cbiele/CyBot/reference/video/frames/20220108-CycloidaldriveAssembly/052.jpg

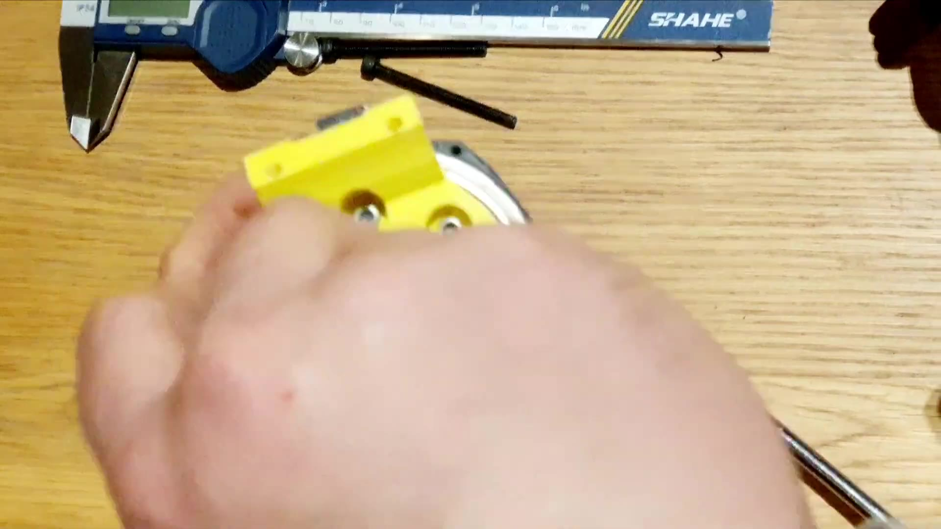
reference/video/frames/20220108-CycloidaldriveAssembly/052.jpg
