cbiele/CyBot/reference/video/frames/20220108-CycloidaldriveAssembly/010.jpg

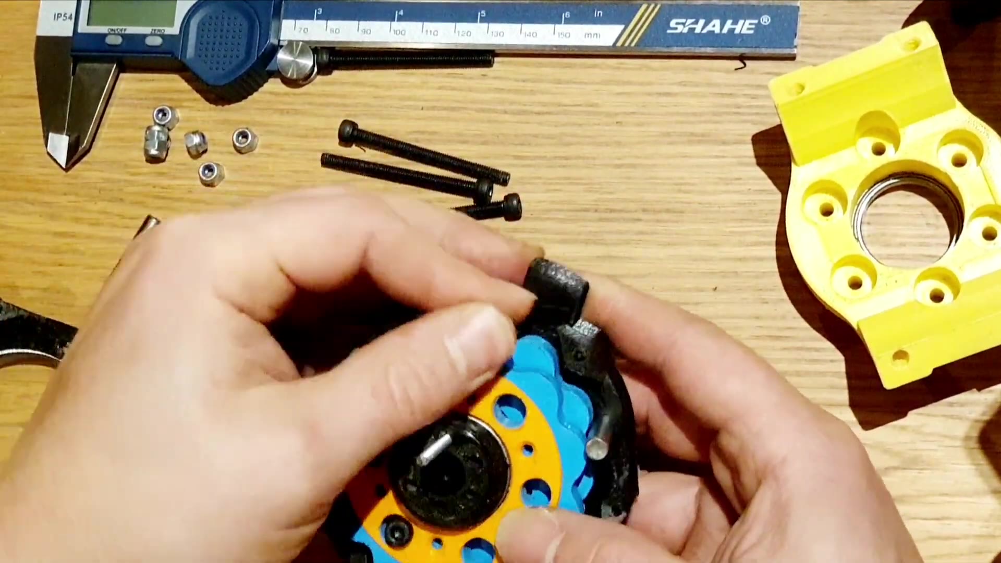
reference/video/frames/20220108-CycloidaldriveAssembly/010.jpg
