cbiele/CyBot/reference/hackaday/README.md

# reference/hackaday — files from hackaday.io/project/182821 (pulled 2026-09-09)

Author's project page (created 2021-11-29, last updated 2023). No build logs
and no component list; one comment from the author (2023-04-01) confirms
**he never homed the arm** and was considering an MPU-6050 instead of
switches. The files are the only section drawings of the arm anywhere:

| File | What it is |
|---|---|
| AssemblySectionAnalysis.JPG | full-arm Fusion section: base turntable with the two 6816 stacked, both body joints with their three-disk stacks and 6813 rings, the elbow 1:11 gearbox and forearm tube, the wrist |
| Axis5-6-SectionAnalysis.JPG | wrist section: the axis-5 1:11 gearbox on the −y arm, the two 6810 on the +y arm, axis-6 roll rotor/pulley/spacer inside the forearm tube with its bearings, the quarter-turn belt idler |
| CycloidalReducer1-12-SectionAnalysis.JPG | 1:11 gearbox render: disks with the bushing bearings, ring pins, NEMA17 on top, the M3 rod nuts |
| CycloidalReducer1-20.JPG | 1:20 gearbox render: 21 ring pins through the housing, disks, OPH/pulley end with the 6 output rods |
| CycloidalDisk1-12-dimension.JPG | Fusion sketch of the 1:11 disk: Ø78 pin circle, Ø66 lobe root, Ø32 bore, Ø16 pin-bearing circle, 12 pins at 15°, pin Ø4/Ø5 |
| 20220109_203344.jpg, 20231105_194952.jpg | photos: the assembled 1:11 unit; the finished arm with gripper and joystick (2023) |
