cbiele/CyBot/reference/hackaday/20231105_194952.jpg

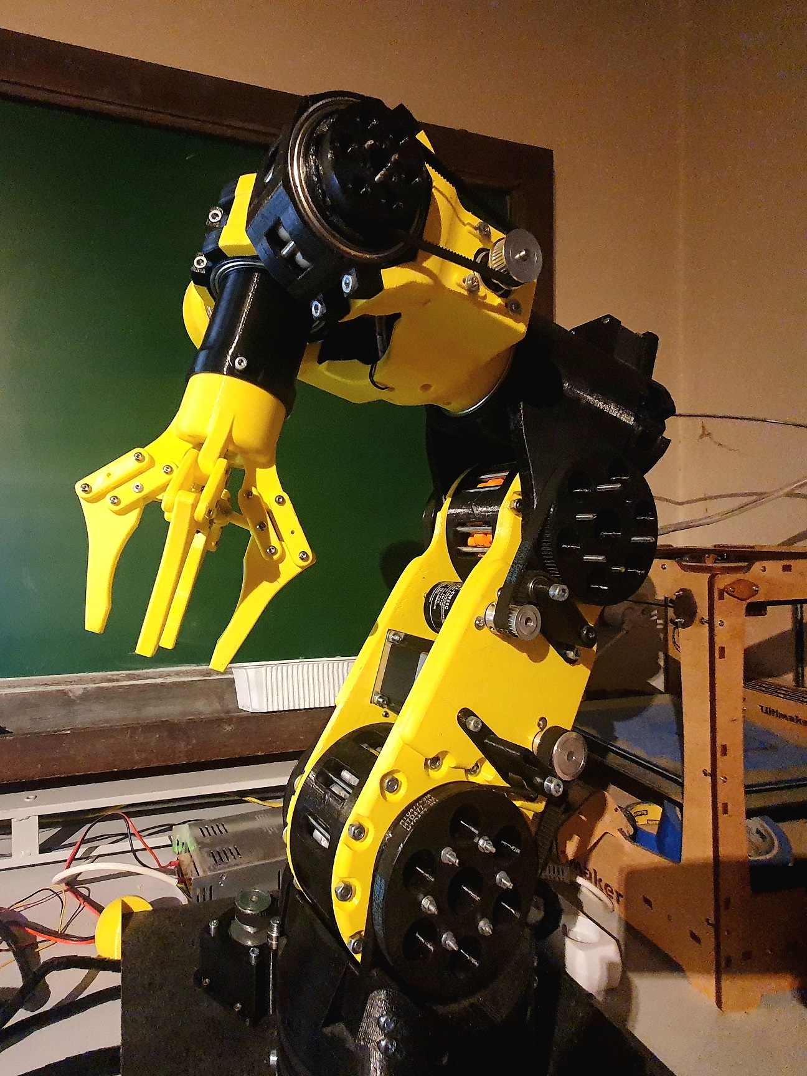
reference/hackaday/20231105_194952.jpg
