cbiele/CyBot/reference/hackaday/CycloidalReducer1-12-SectionAnalysis.JPG

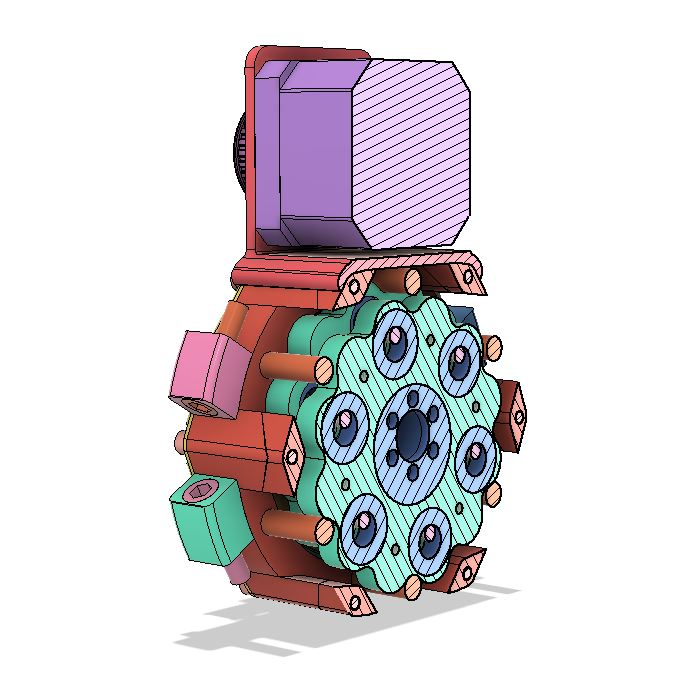
reference/hackaday/CycloidalReducer1-12-SectionAnalysis.JPG
