cbiele/CyBot/reference/pdf-figures/p5-shaft-train.png

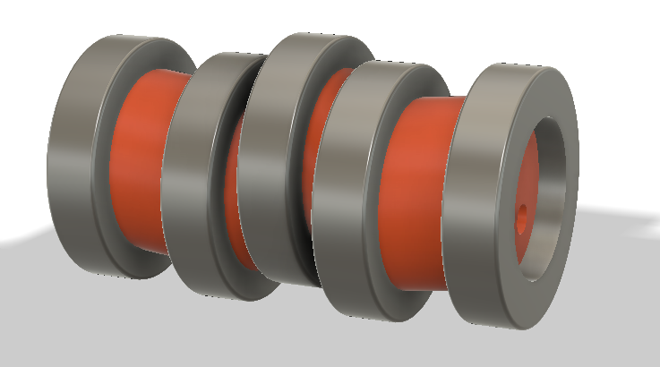
reference/pdf-figures/p5-shaft-train.png
