cbiele/CyBot/reference/pdf-figures/p12-pulley-bearing-hub.png

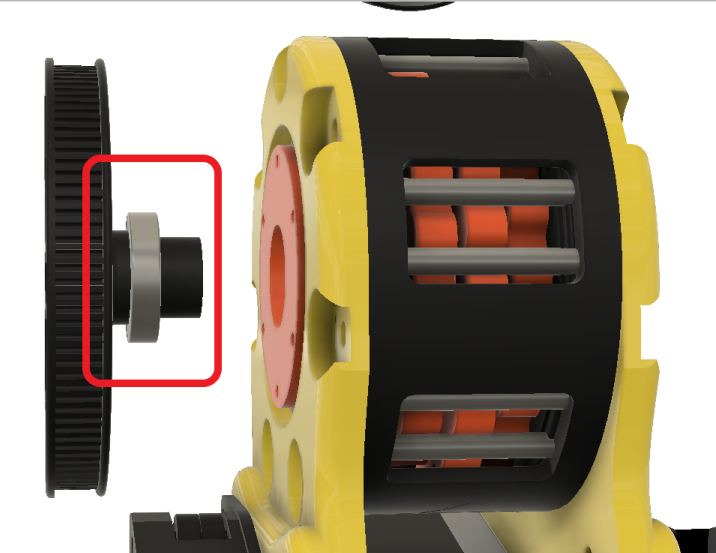
reference/pdf-figures/p12-pulley-bearing-hub.png
