cbiele/CyBot/reference/video/frames/20211029-Workingona3diskscycloida/002.jpg

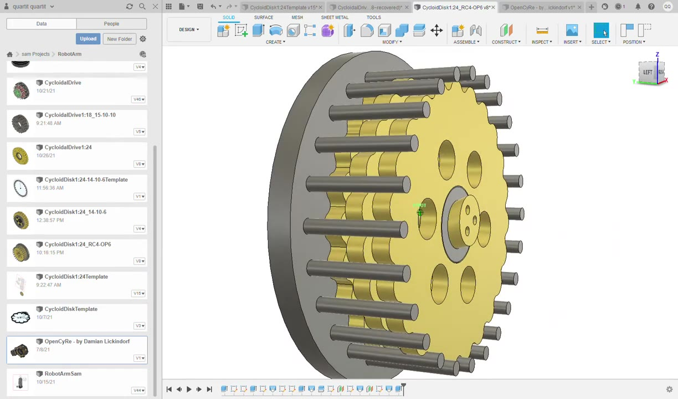
reference/video/frames/20211029-Workingona3diskscycloida/002.jpg
