cbiele/CyBot/reference/video/frames/20211029-Workingona3diskscycloida/007.jpg

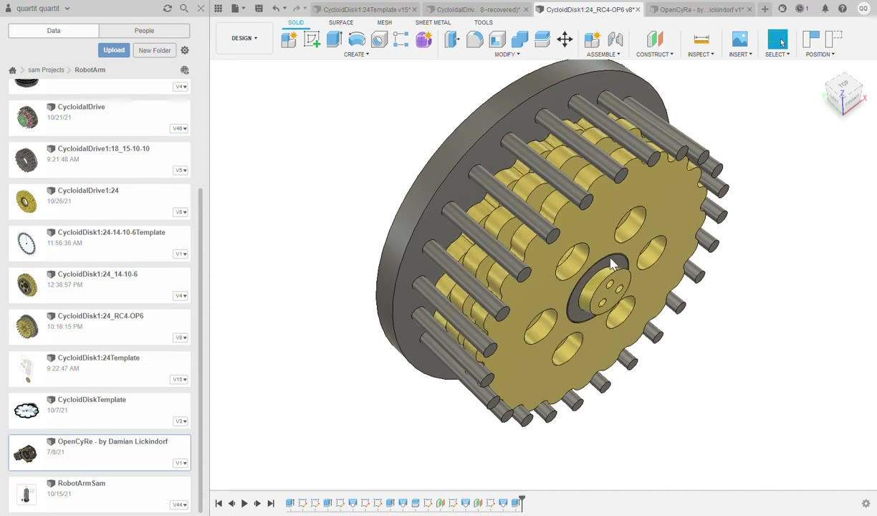
reference/video/frames/20211029-Workingona3diskscycloida/007.jpg
