cbiele/CyBot/reference/video/frames/20211108-CyBoT124fusion360Cycloid/012.jpg

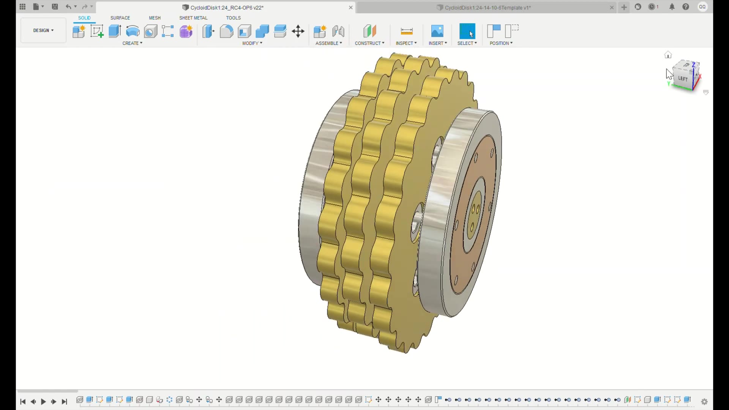
reference/video/frames/20211108-CyBoT124fusion360Cycloid/012.jpg
