cbiele/CyBot/reference/video/frames/20211114-CyBoT3dprinted124Cycloid-sheet.jpg

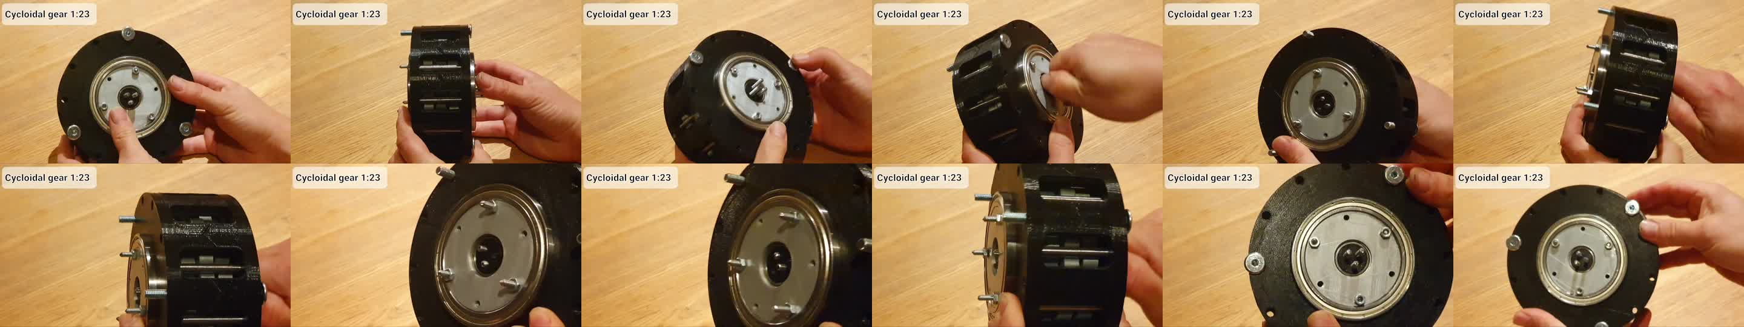
reference/video/frames/20211114-CyBoT3dprinted124Cycloid-sheet.jpg
