cbiele/CyBot/reference/video/frames/20211114-CyBoT3dprinted124Cycloid/003.jpg

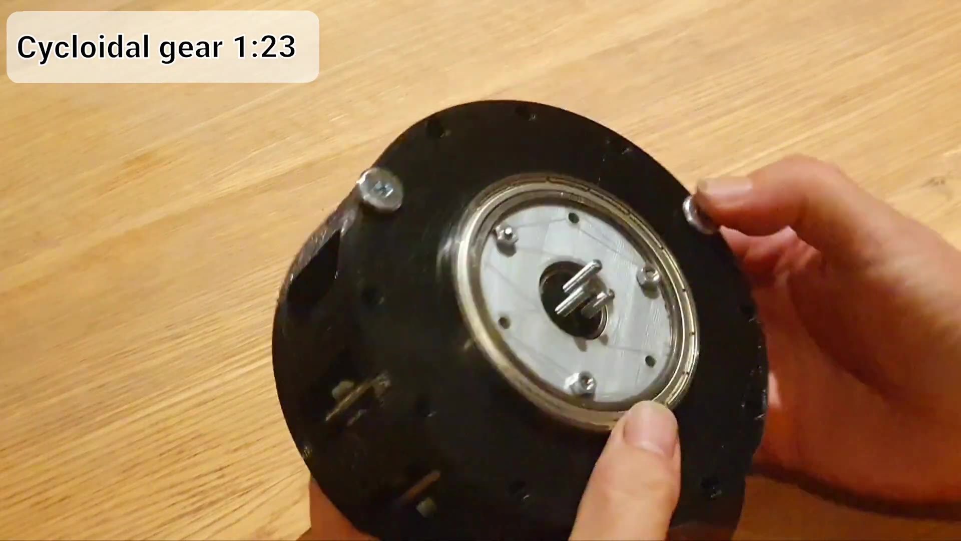
reference/video/frames/20211114-CyBoT3dprinted124Cycloid/003.jpg
