cbiele/CyBot/reference/video/frames/20211114-CyBoT3dprinted124Cycloid/007.jpg

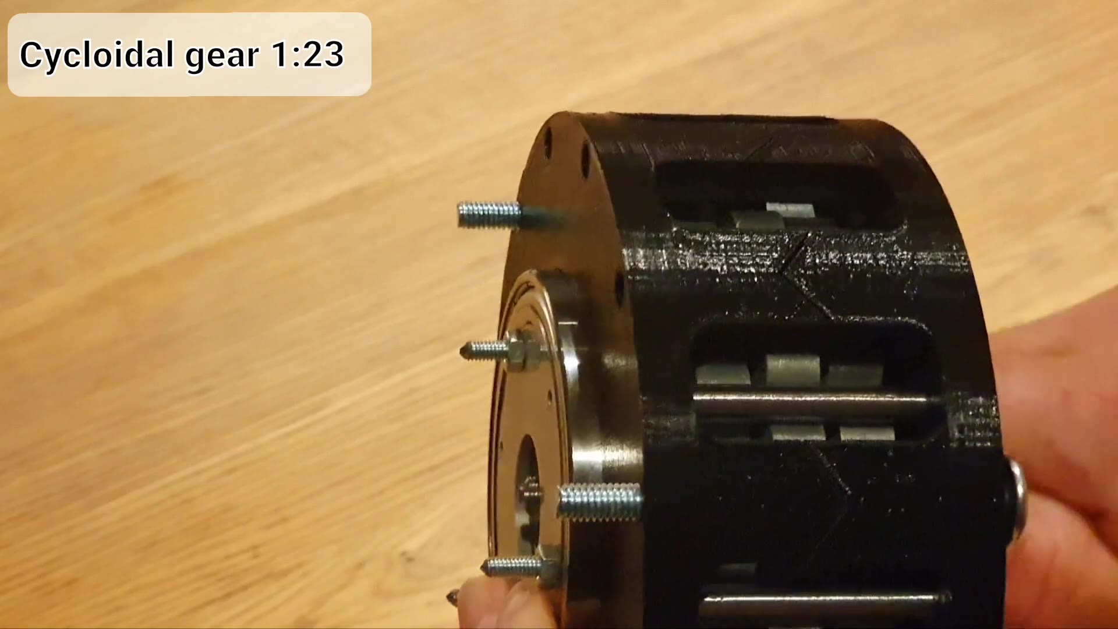
reference/video/frames/20211114-CyBoT3dprinted124Cycloid/007.jpg
