cbiele/CyBot/reference/video/frames/20211114-CyBoT3dprinted124Cycloid/010.jpg

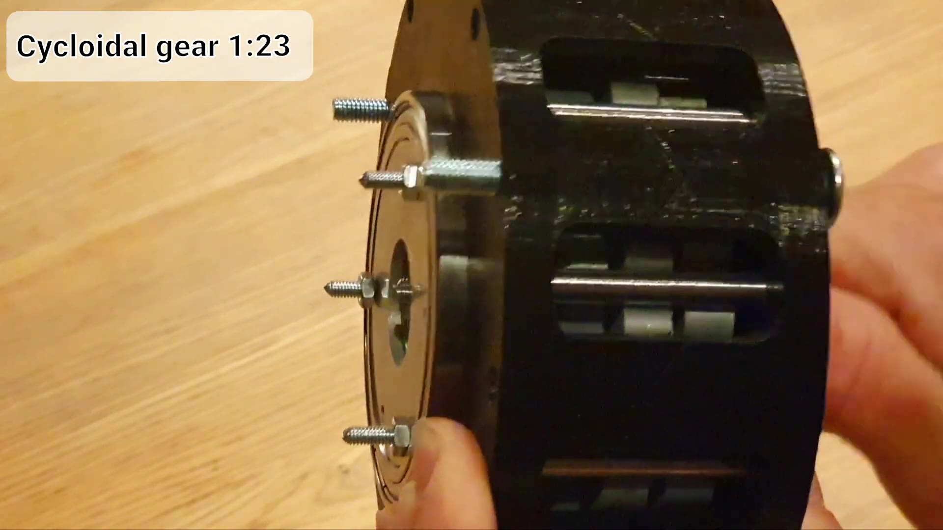
reference/video/frames/20211114-CyBoT3dprinted124Cycloid/010.jpg
