cbiele/CyBot/reference/video/frames/20211121-CyBoT6DOFRobotArmCycloid-sheet.jpg

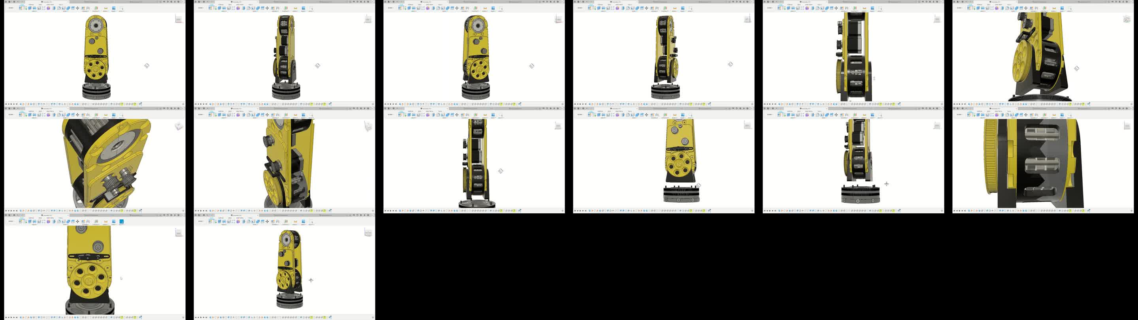
reference/video/frames/20211121-CyBoT6DOFRobotArmCycloid-sheet.jpg
