cbiele/CyBot/reference/video/frames/20211121-CyBoT6DOFRobotArmCycloid/007.jpg

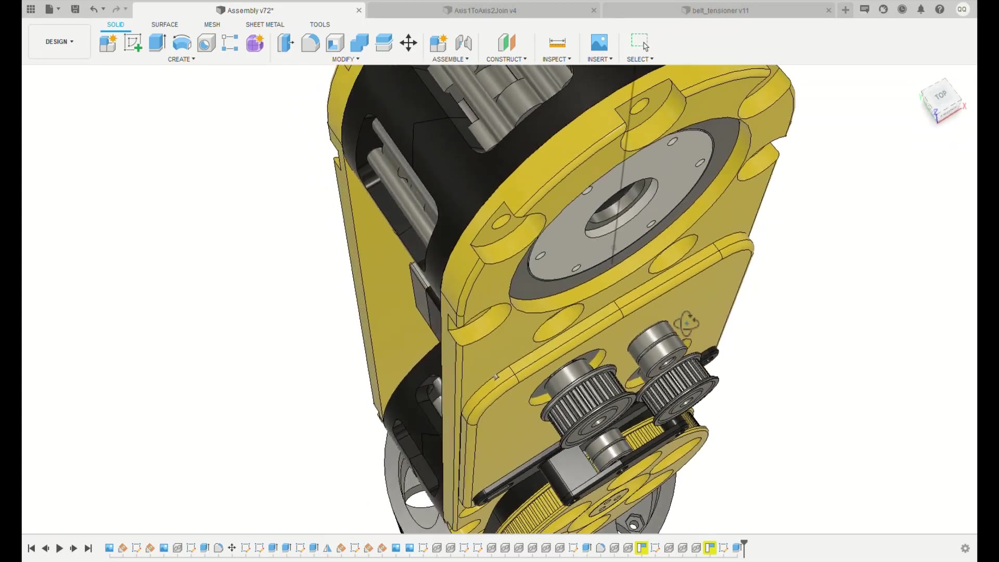
reference/video/frames/20211121-CyBoT6DOFRobotArmCycloid/007.jpg
