cbiele/CyBot/reference/video/frames/20211121-CyBoT6DOFRobotArmCycloid/012.jpg

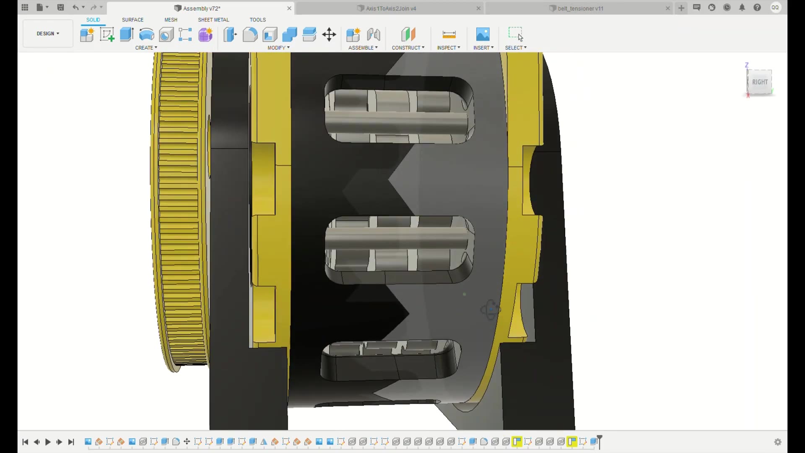
reference/video/frames/20211121-CyBoT6DOFRobotArmCycloid/012.jpg
