cbiele/CyBot/reference/video/frames/20211126-CyBoT6DOFRobotArmCycloid-sheet.jpg

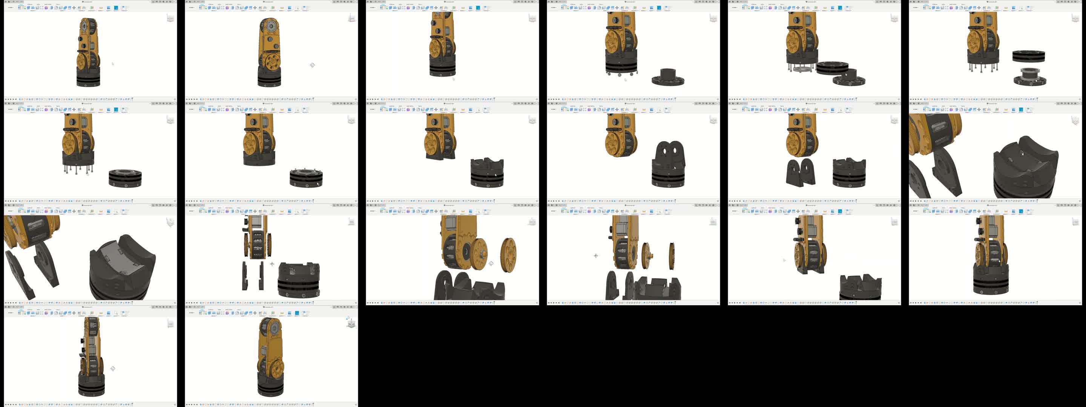
reference/video/frames/20211126-CyBoT6DOFRobotArmCycloid-sheet.jpg
