cbiele/CyBot/reference/video/frames/20211126-CyBoT6DOFRobotArmCycloid/003.jpg

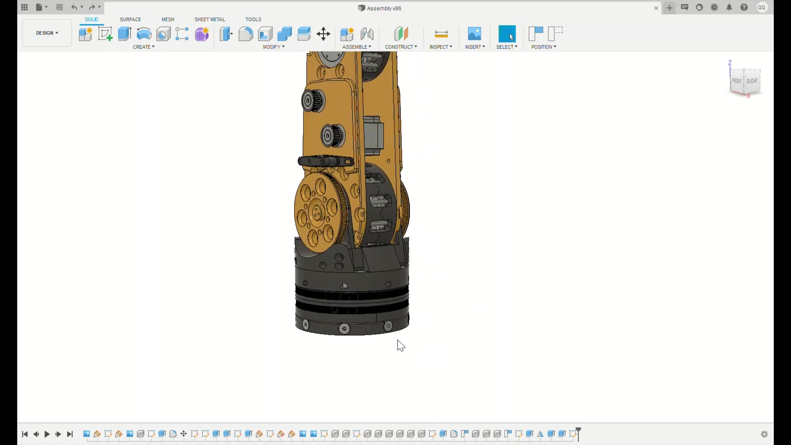
reference/video/frames/20211126-CyBoT6DOFRobotArmCycloid/003.jpg
