cbiele/CyBot/reference/video/frames/20211126-CyBoT6DOFRobotArmCycloid/013.jpg

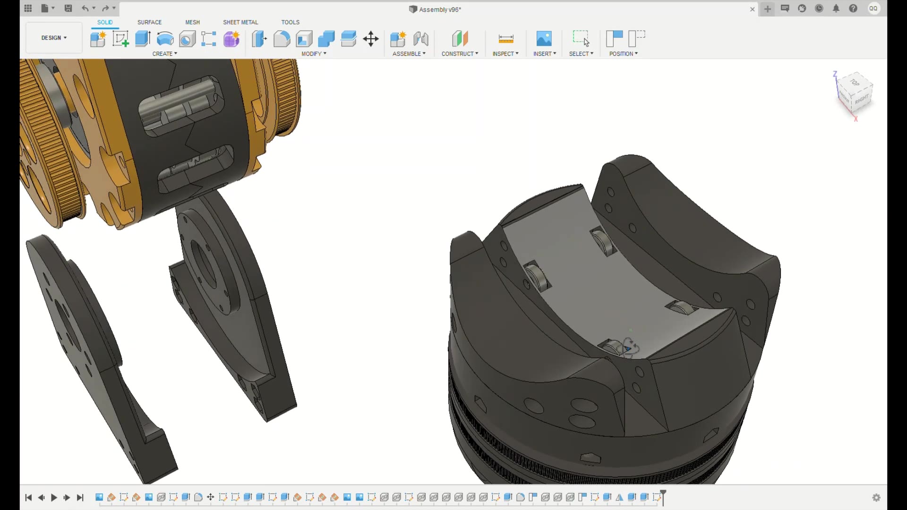
reference/video/frames/20211126-CyBoT6DOFRobotArmCycloid/013.jpg
