cbiele/CyBot/reference/video/frames/20211126-CyBoT6DOFRobotArmCycloid/014.jpg

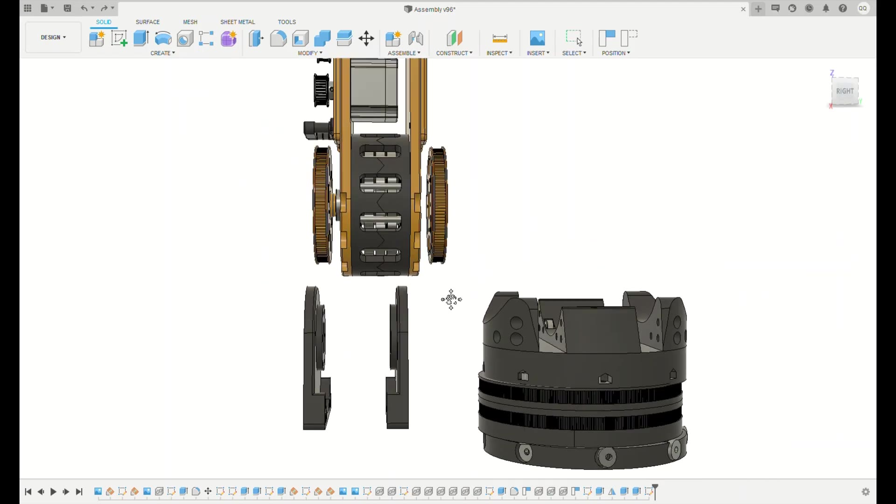
reference/video/frames/20211126-CyBoT6DOFRobotArmCycloid/014.jpg
