cbiele/CyBot/reference/video/frames/20211126-CyBoT6DOFRobotArmCycloid/016.jpg

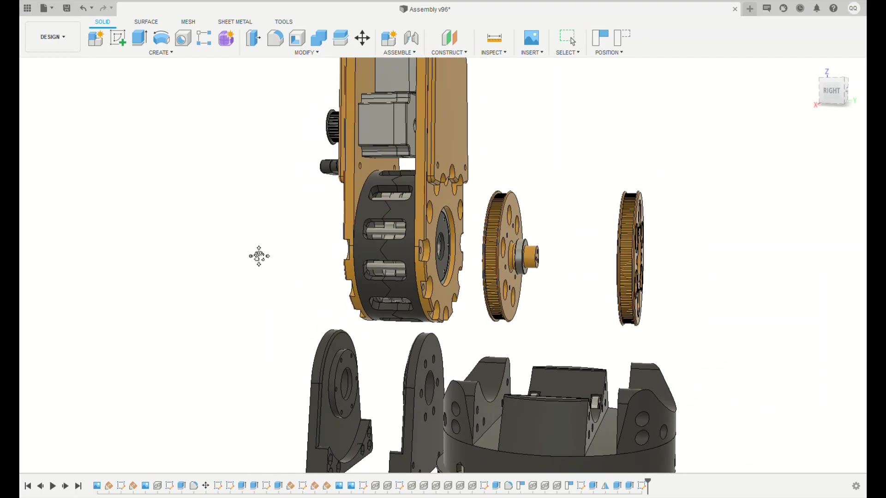
reference/video/frames/20211126-CyBoT6DOFRobotArmCycloid/016.jpg
