cbiele/CyBot/reference/video/frames/20211126-CyBoT6DOFRobotArmCycloid/017.jpg

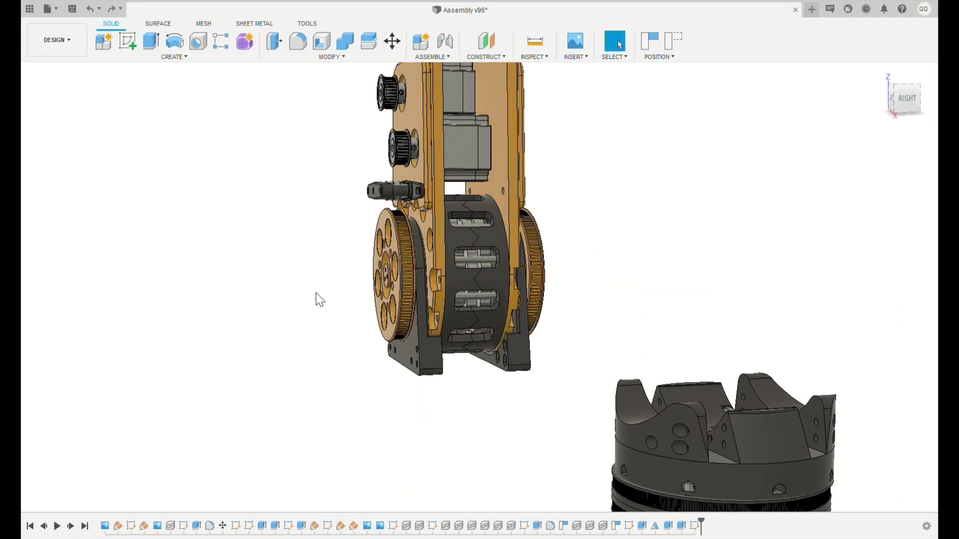
reference/video/frames/20211126-CyBoT6DOFRobotArmCycloid/017.jpg
