cbiele/CyBot/reference/video/frames/20211126-CyBoT6DOFRobotArmCycloid/018.jpg

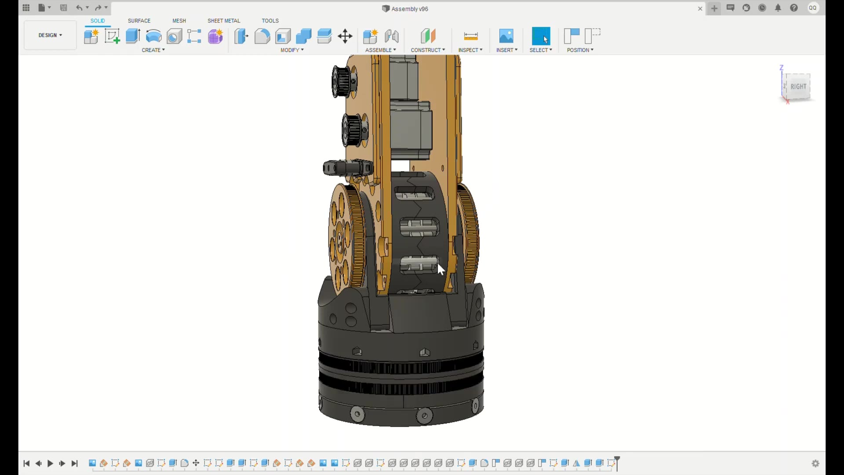
reference/video/frames/20211126-CyBoT6DOFRobotArmCycloid/018.jpg
