cbiele/CyBot/reference/video/frames/20211129-CyBoT6axisrobotarmcycloi-sheet.jpg

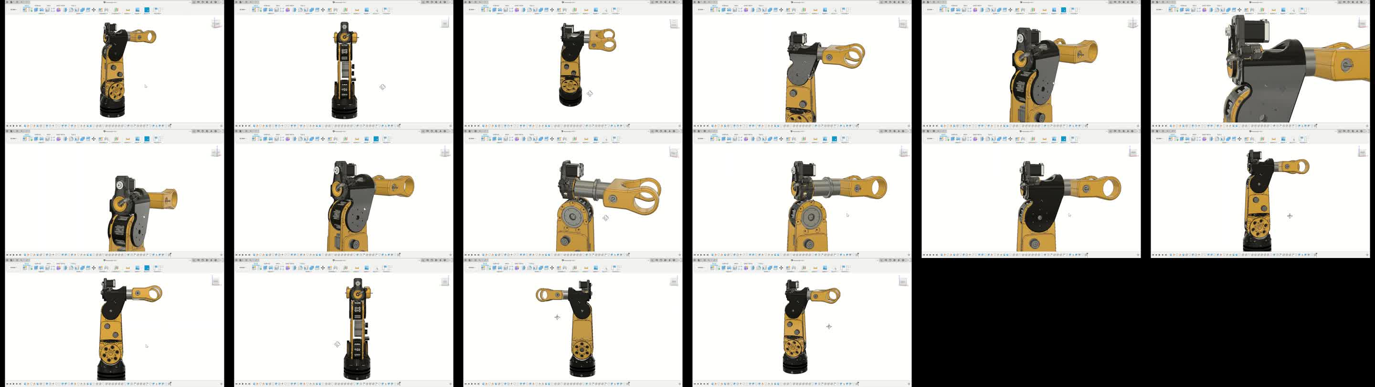
reference/video/frames/20211129-CyBoT6axisrobotarmcycloi-sheet.jpg
