cbiele/CyBot/reference/video/frames/20211129-CyBoT6axisrobotarmcycloi/014.jpg

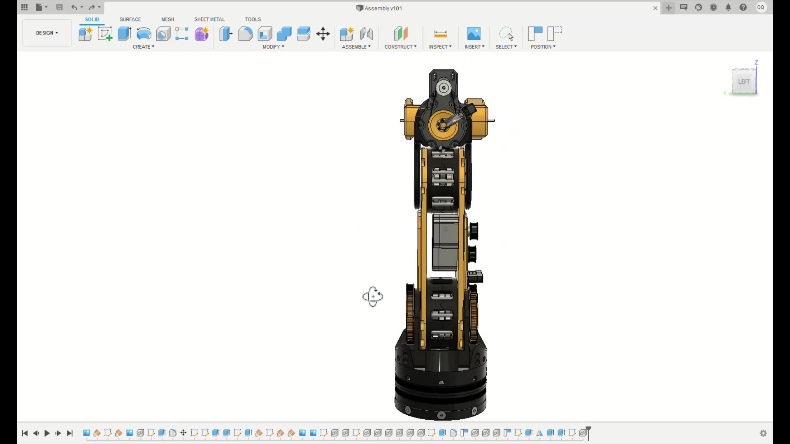
reference/video/frames/20211129-CyBoT6axisrobotarmcycloi/014.jpg
