cbiele/CyBot/reference/video/frames/20211129-CyBoT6axisrobotarmcycloi/016.jpg

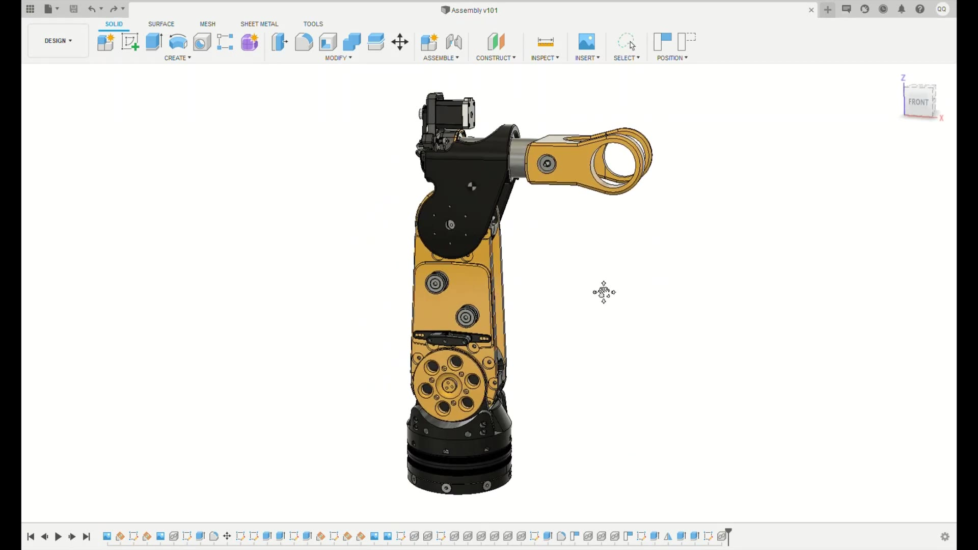
reference/video/frames/20211129-CyBoT6axisrobotarmcycloi/016.jpg
