cbiele/CyBot/reference/video/frames/20211129-Cycloidaldisk111reduceri-sheet.jpg

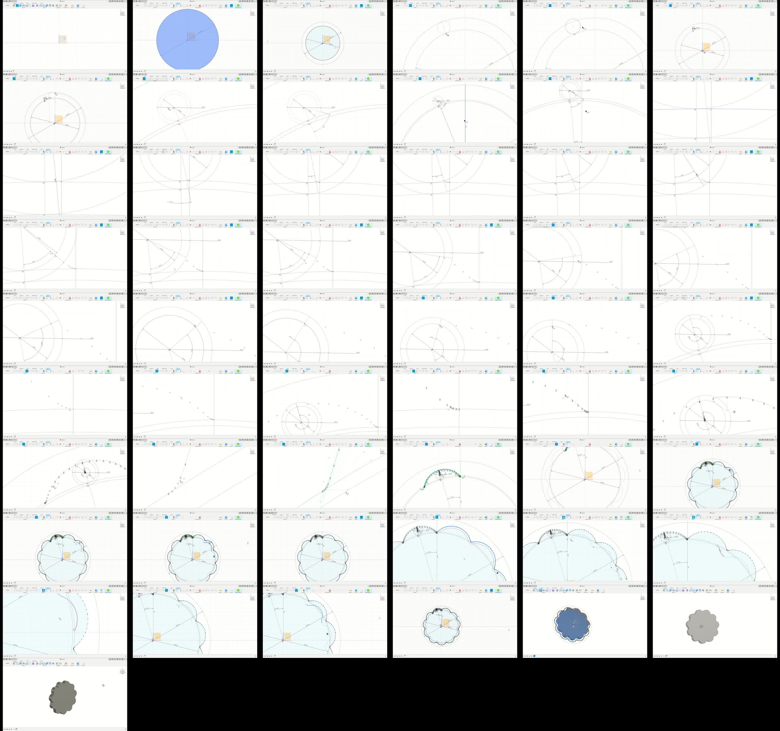
reference/video/frames/20211129-Cycloidaldisk111reduceri-sheet.jpg
