cbiele/CyBot/reference/video/frames/20211129-Cycloidaldisk111reduceri/003.jpg

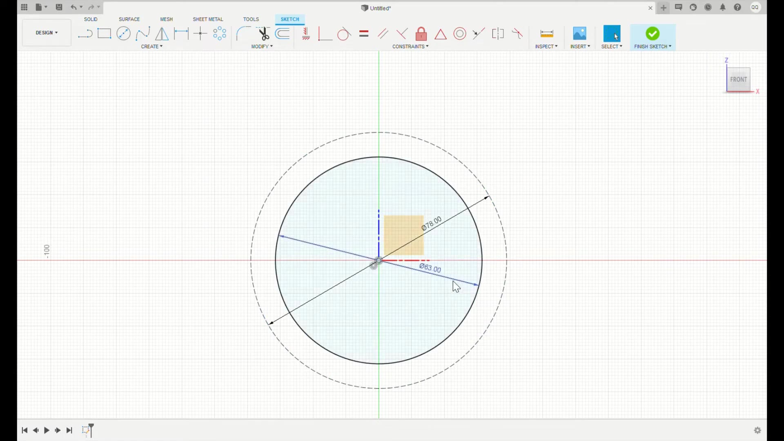
reference/video/frames/20211129-Cycloidaldisk111reduceri/003.jpg
