cbiele/CyBot/reference/video/frames/20211129-Cycloidaldisk111reduceri/013.jpg

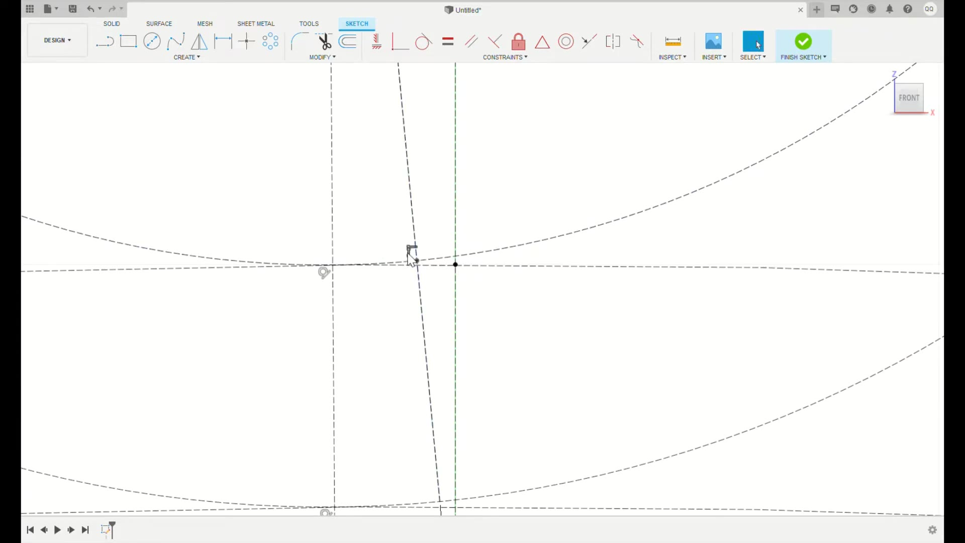
reference/video/frames/20211129-Cycloidaldisk111reduceri/013.jpg
