cbiele/CyBot/reference/video/frames/20211129-Cycloidaldisk111reduceri/017.jpg

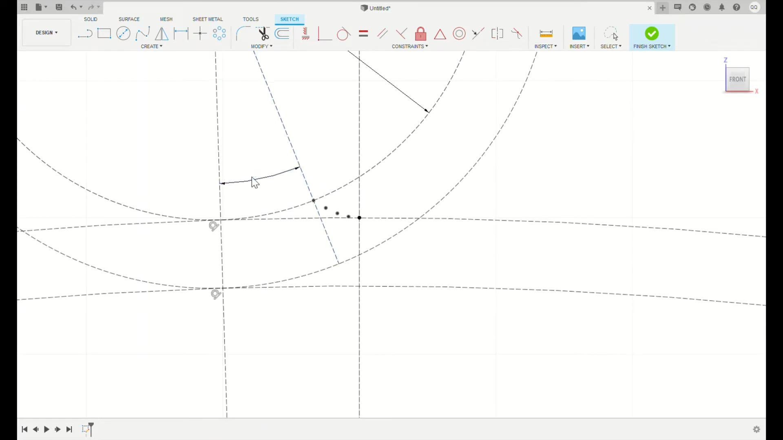
reference/video/frames/20211129-Cycloidaldisk111reduceri/017.jpg
