cbiele/CyBot/reference/video/frames/20211129-Cycloidaldisk111reduceri/037.jpg

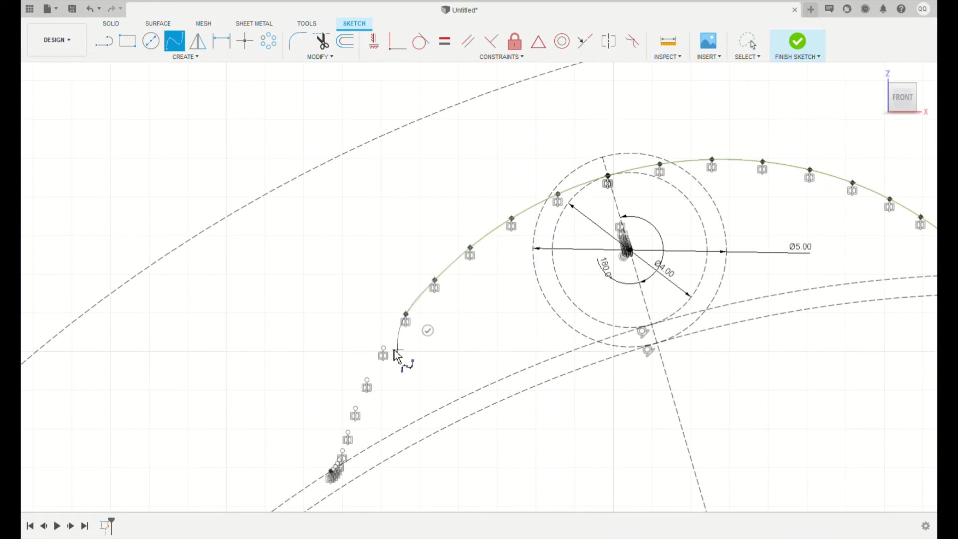
reference/video/frames/20211129-Cycloidaldisk111reduceri/037.jpg
