cbiele/CyBot/reference/video/frames/20211129-Cycloidaldisk111reduceri/044.jpg

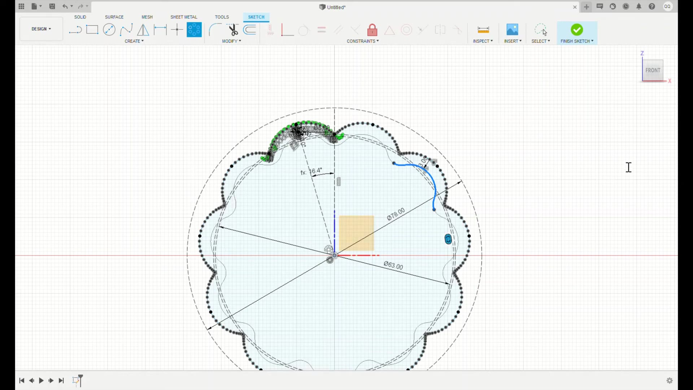
reference/video/frames/20211129-Cycloidaldisk111reduceri/044.jpg
