cbiele/CyBot/reference/video/frames/20211129-Cycloidaldisk111reduceri/050.jpg

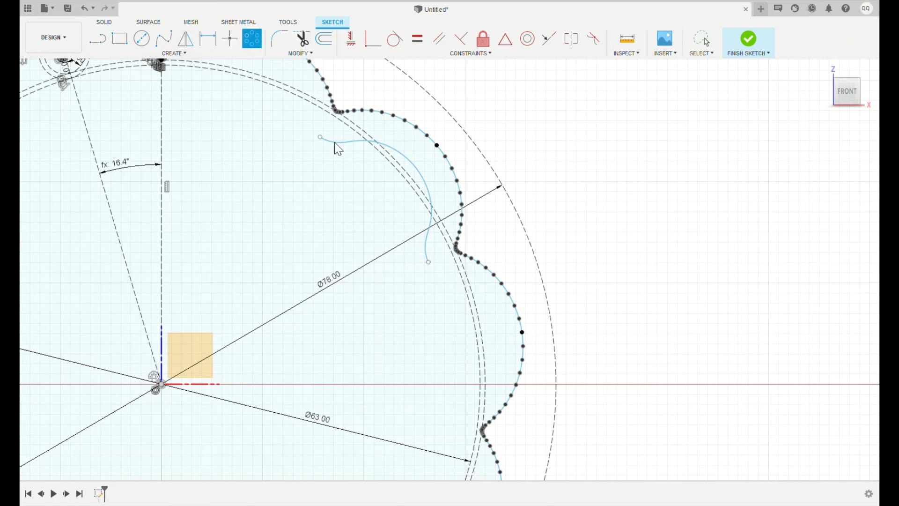
reference/video/frames/20211129-Cycloidaldisk111reduceri/050.jpg
