cbiele/CyBot/reference/video/frames/20211214-CyBoTProgressonAxis5and6-sheet.jpg

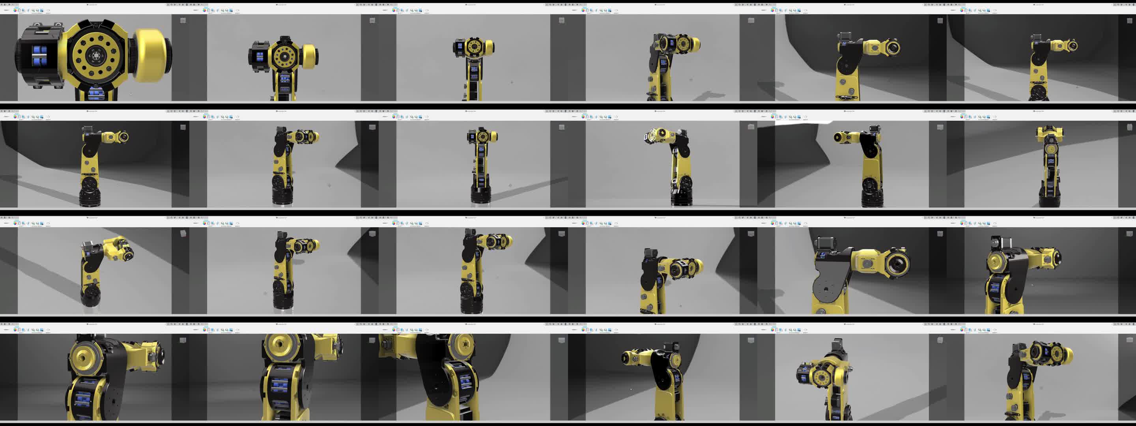
reference/video/frames/20211214-CyBoTProgressonAxis5and6-sheet.jpg
