cbiele/CyBot/reference/video/frames/20211214-CyBoTProgressonAxis5and6/003.jpg

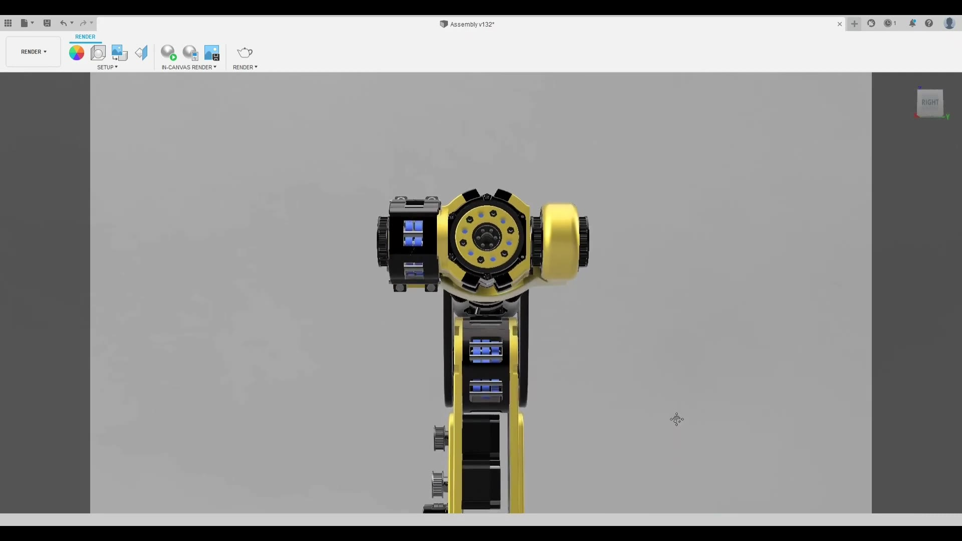
reference/video/frames/20211214-CyBoTProgressonAxis5and6/003.jpg
