cbiele/CyBot/reference/video/frames/20211214-CyBoTProgressonAxis5and6/010.jpg

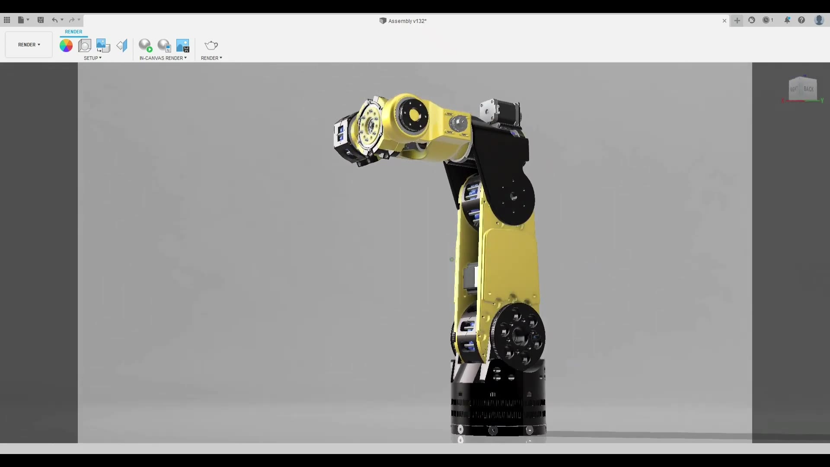
reference/video/frames/20211214-CyBoTProgressonAxis5and6/010.jpg
