cbiele/CyBot/reference/video/frames/20211214-CyBoTProgressonAxis5and6/014.jpg

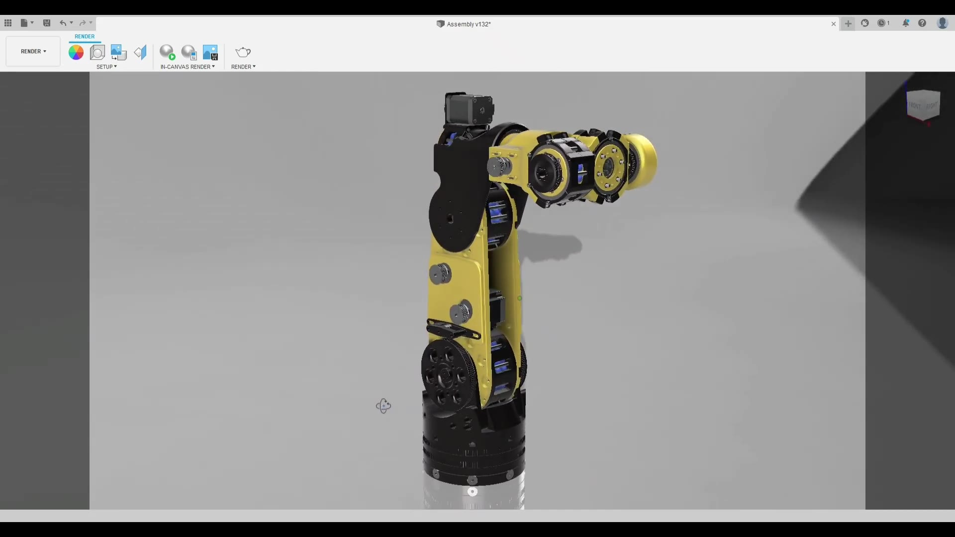
reference/video/frames/20211214-CyBoTProgressonAxis5and6/014.jpg
