cbiele/CyBot/reference/video/frames/20211224-3DprintHighPrecisionandH/002.jpg

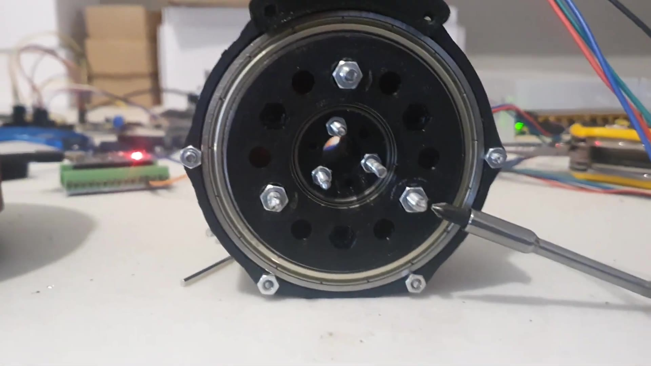
reference/video/frames/20211224-3DprintHighPrecisionandH/002.jpg
