cbiele/CyBot/reference/video/frames/20211224-3DprintHighPrecisionandH/012.jpg

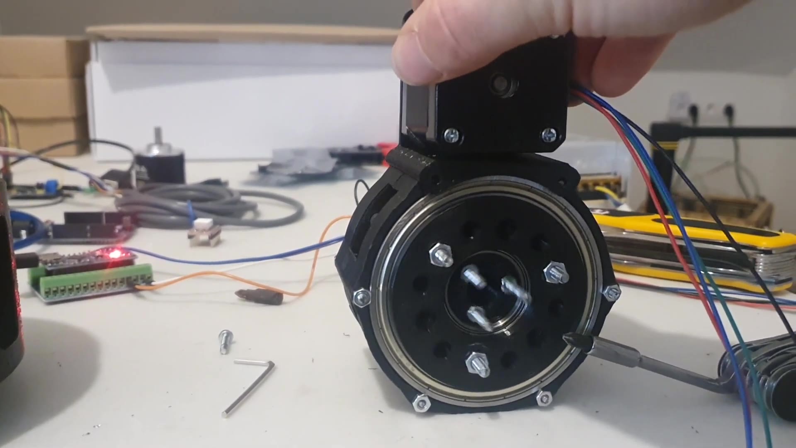
reference/video/frames/20211224-3DprintHighPrecisionandH/012.jpg
