cbiele/CyBot/reference/video/frames/20220103-CyBoTQuarterturnbeltfora-sheet.jpg

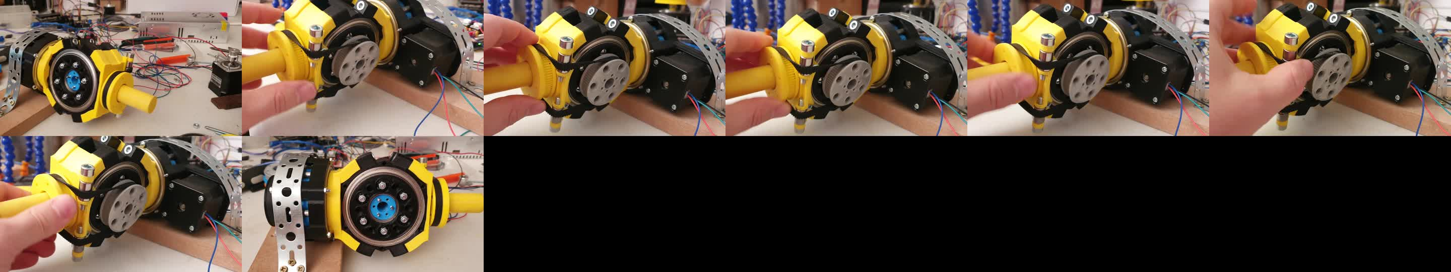
reference/video/frames/20220103-CyBoTQuarterturnbeltfora-sheet.jpg
