cbiele/CyBot/reference/video/frames/20220103-CyBoTQuarterturnbeltfora/001.jpg

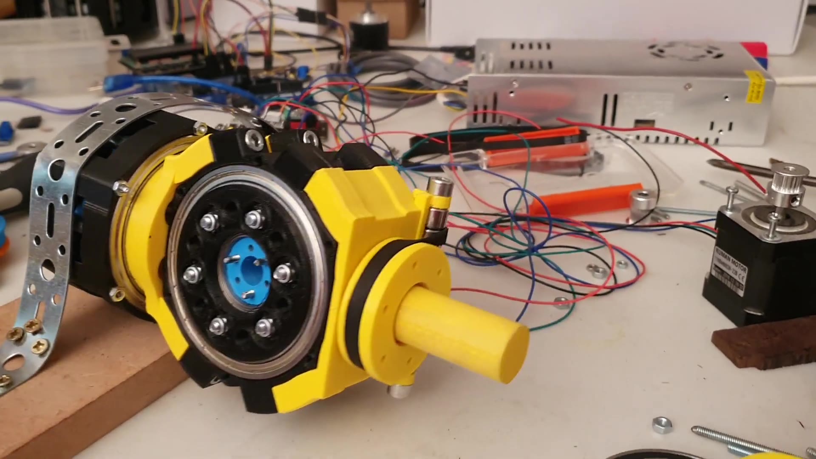
reference/video/frames/20220103-CyBoTQuarterturnbeltfora/001.jpg
