cbiele/CyBot/reference/video/frames/20220103-CyBoTQuarterturnbeltfora/002.jpg

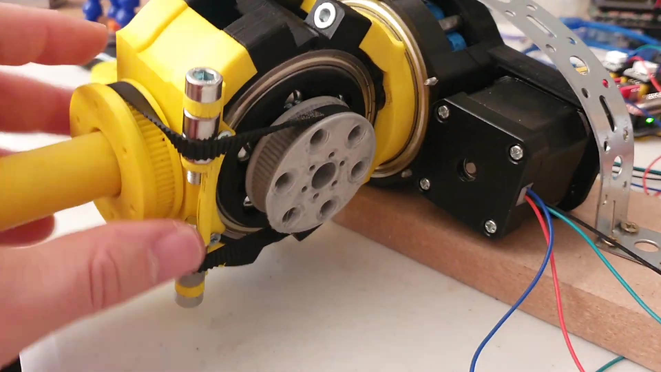
reference/video/frames/20220103-CyBoTQuarterturnbeltfora/002.jpg
