cbiele/CyBot/reference/video/frames/20220103-CyBoTQuarterturnbeltfora/003.jpg

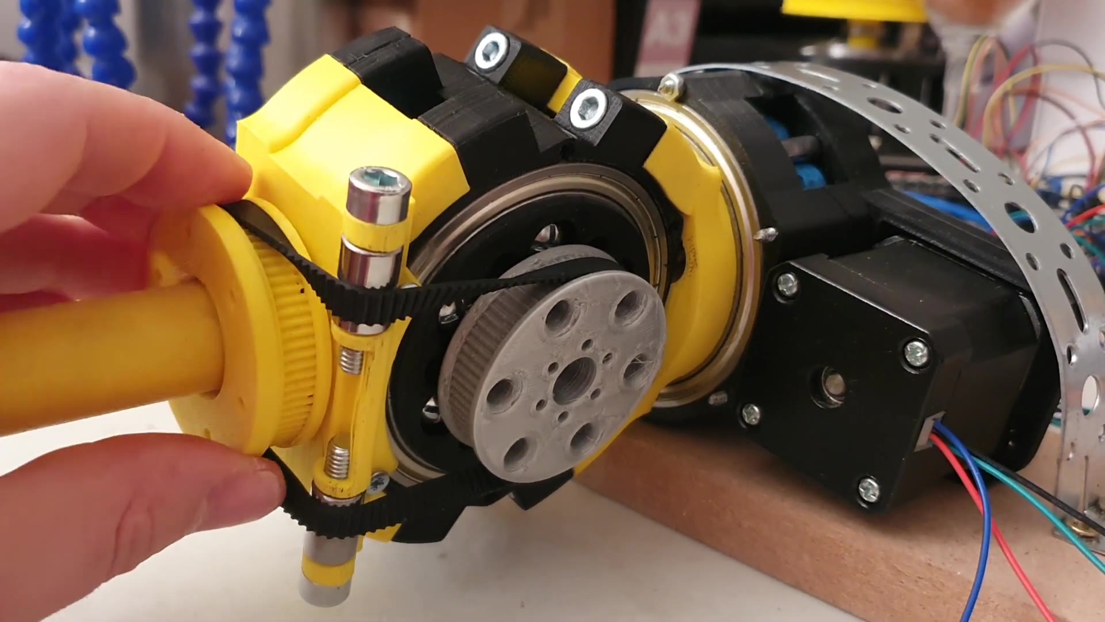
reference/video/frames/20220103-CyBoTQuarterturnbeltfora/003.jpg
