cbiele/CyBot/reference/video/frames/20220103-CyBoTQuarterturnbeltfora/004.jpg

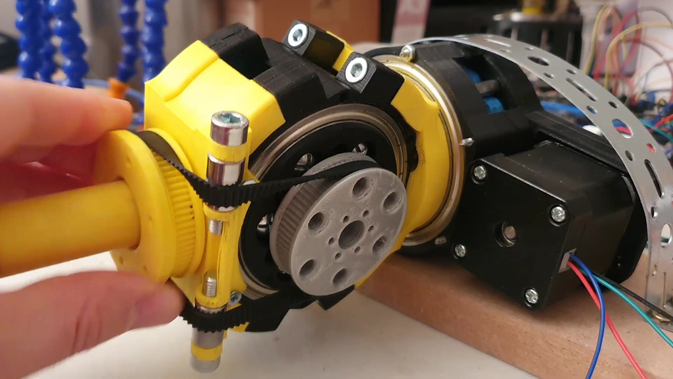
reference/video/frames/20220103-CyBoTQuarterturnbeltfora/004.jpg
