cbiele/CyBot/reference/video/frames/20220103-CyBoTQuarterturnbeltfora/005.jpg

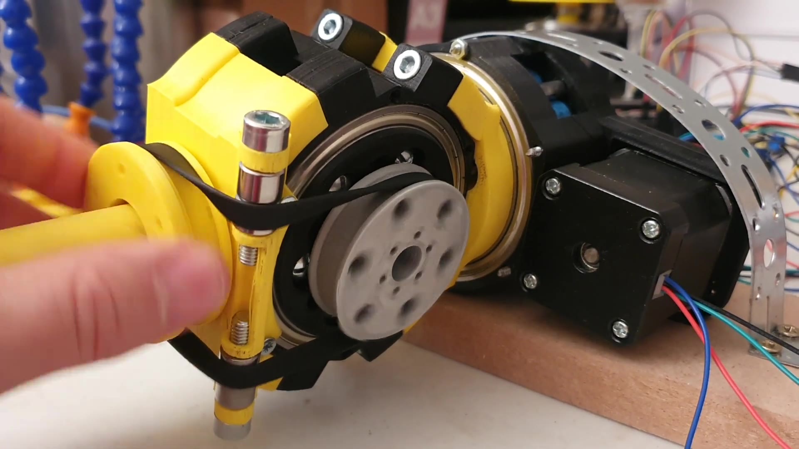
reference/video/frames/20220103-CyBoTQuarterturnbeltfora/005.jpg
