cbiele/CyBot/reference/video/frames/20220103-CyBoTQuarterturnbeltfora/006.jpg

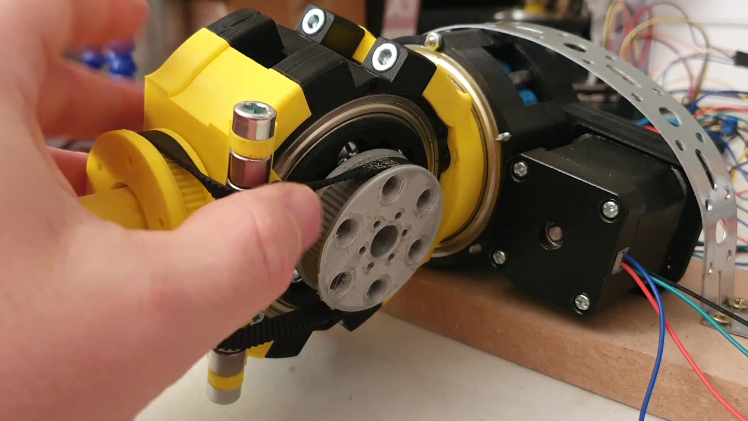
reference/video/frames/20220103-CyBoTQuarterturnbeltfora/006.jpg
