cbiele/CyBot/reference/video/frames/20220104-CyBoTTomorrowIllputthetw/001.jpg

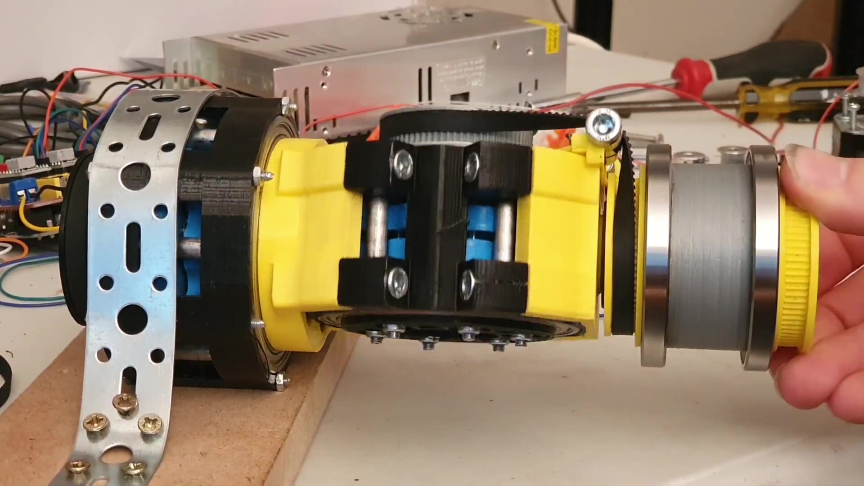
reference/video/frames/20220104-CyBoTTomorrowIllputthetw/001.jpg
