cbiele/CyBot/reference/video/frames/20220104-CyBoTTomorrowIllputthetw/003.jpg

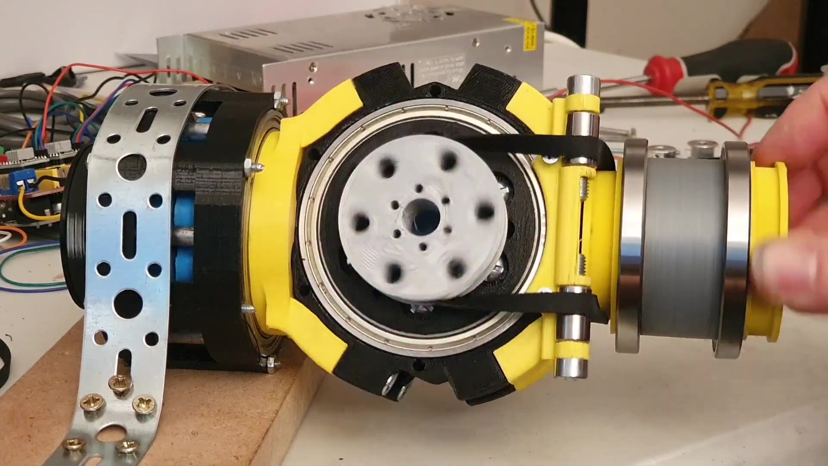
reference/video/frames/20220104-CyBoTTomorrowIllputthetw/003.jpg
