cbiele/CyBot/reference/video/frames/20220104-CyBoTTomorrowIllputthetw/004.jpg

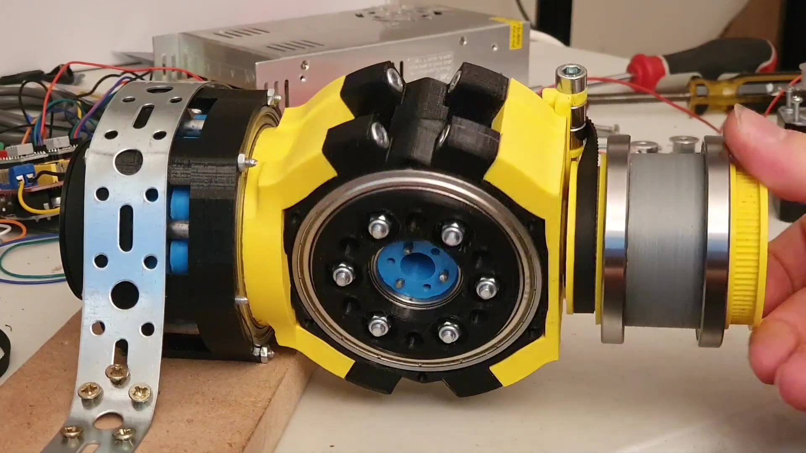
reference/video/frames/20220104-CyBoTTomorrowIllputthetw/004.jpg
