cbiele/CyBot/reference/video/frames/20220104-CyBoTTomorrowIllputthetw/006.jpg

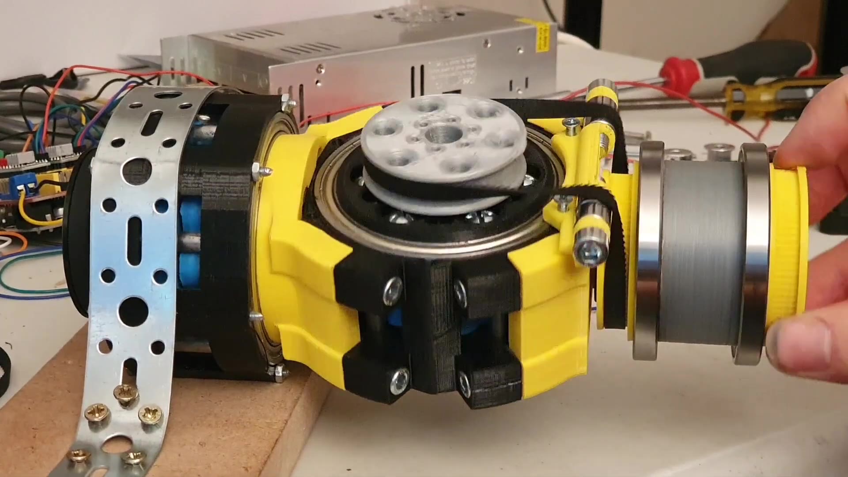
reference/video/frames/20220104-CyBoTTomorrowIllputthetw/006.jpg
