cbiele/CyBot/reference/video/frames/20220104-CyBoTTomorrowIllputthetw/007.jpg

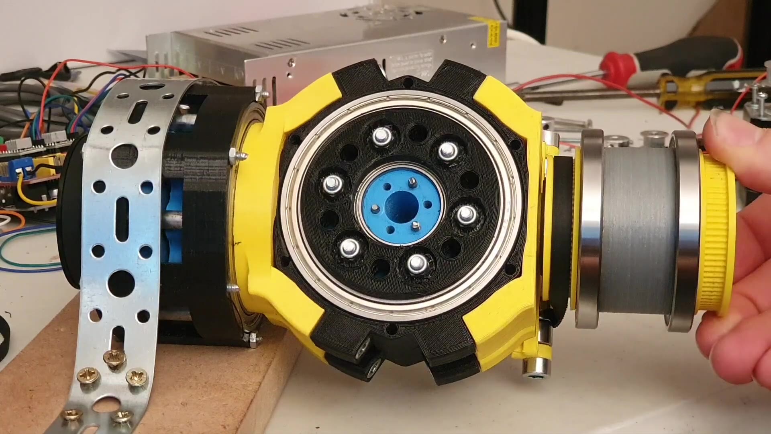
reference/video/frames/20220104-CyBoTTomorrowIllputthetw/007.jpg
