cbiele/CyBot/reference/video/frames/20220107-CyBoTACloseLookToAxis56h-sheet.jpg

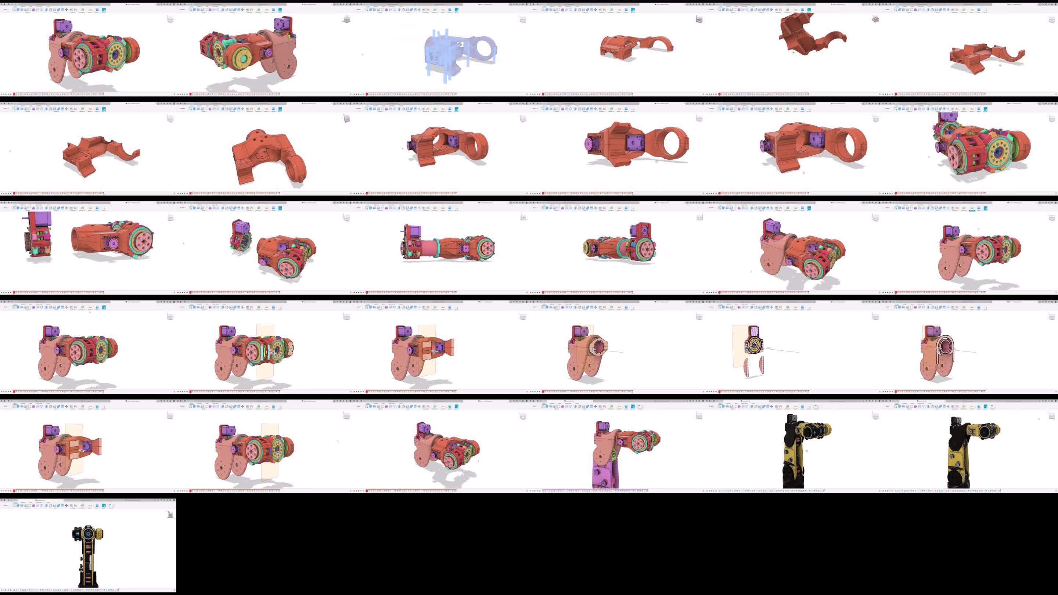
reference/video/frames/20220107-CyBoTACloseLookToAxis56h-sheet.jpg
