cbiele/CyBot/reference/video/frames/20220107-CyBoTACloseLookToAxis56h/012.jpg

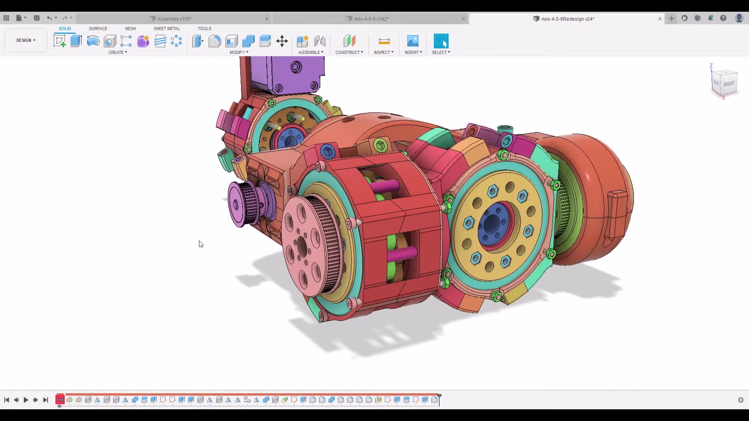
reference/video/frames/20220107-CyBoTACloseLookToAxis56h/012.jpg
