cbiele/CyBot/reference/video/frames/20220107-CyBoTACloseLookToAxis56h/016.jpg

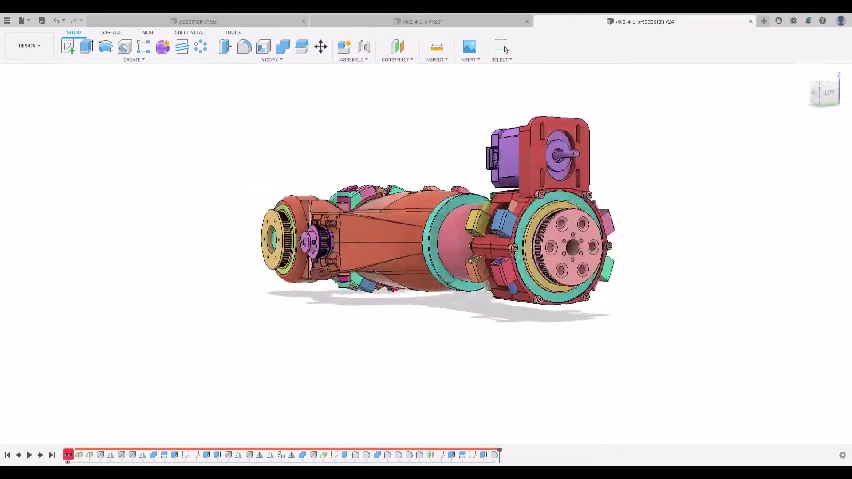
reference/video/frames/20220107-CyBoTACloseLookToAxis56h/016.jpg
