cbiele/CyBot/reference/video/frames/20220107-CyBoTACloseLookToAxis56h/018.jpg

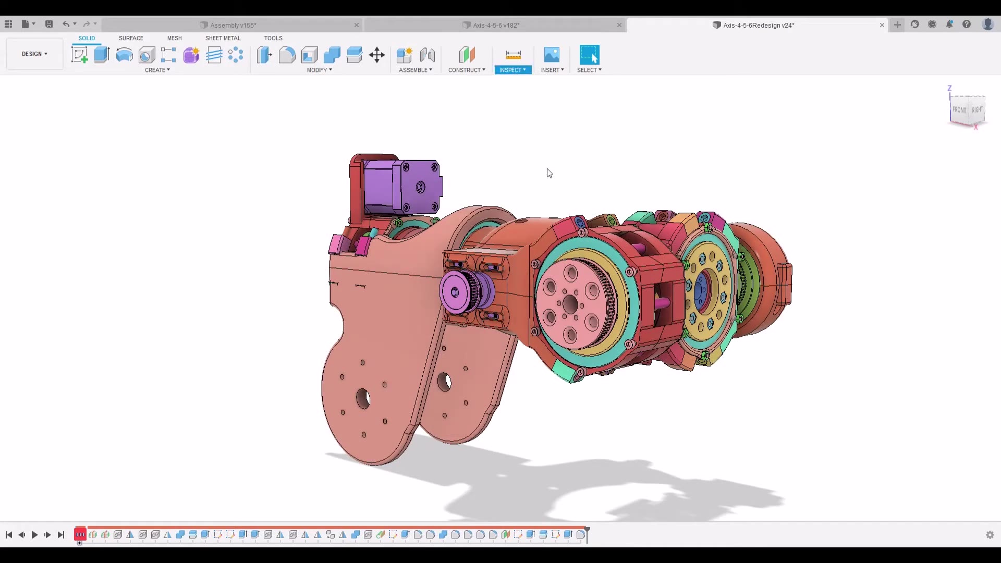
reference/video/frames/20220107-CyBoTACloseLookToAxis56h/018.jpg
