cbiele/CyBot/reference/video/frames/20220109-CyBoTAxis5and6Holder-sheet.jpg

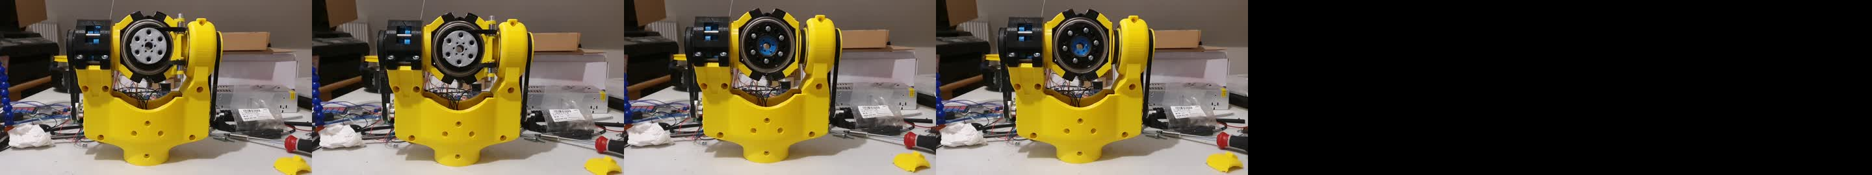
reference/video/frames/20220109-CyBoTAxis5and6Holder-sheet.jpg
