cbiele/CyBot/reference/video/frames/20220109-CyBoTAxis5and6Holder/002.jpg

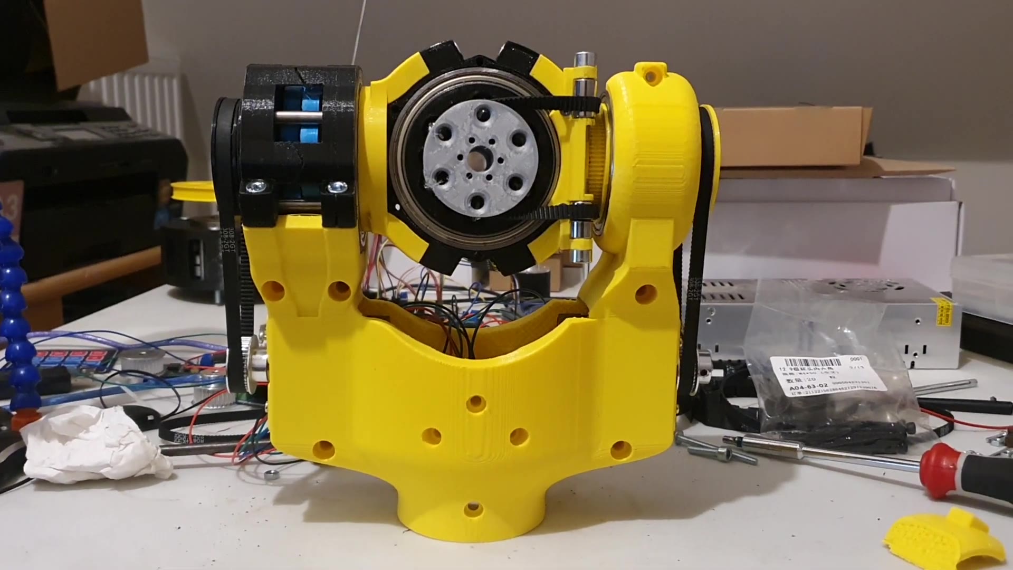
reference/video/frames/20220109-CyBoTAxis5and6Holder/002.jpg
