cbiele/CyBot/reference/video/frames/20220203-CyBoTBigTreeTechGTRV1wit/002.jpg

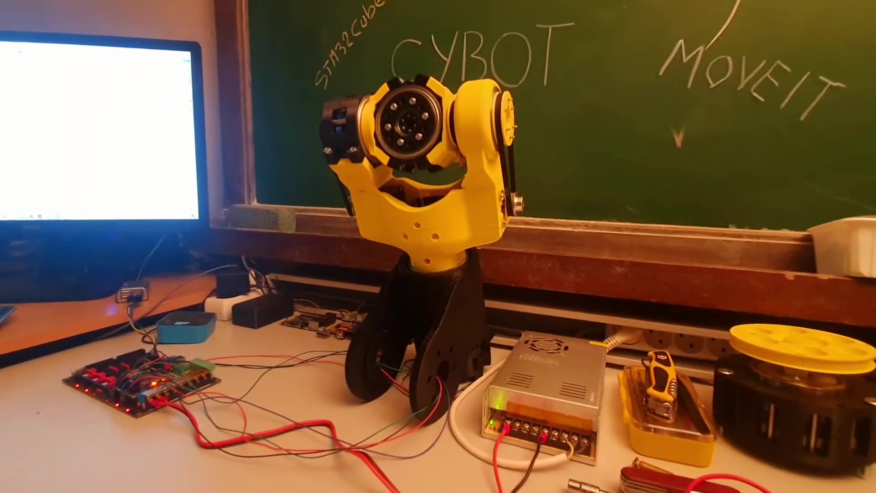
reference/video/frames/20220203-CyBoTBigTreeTechGTRV1wit/002.jpg
