cbiele/CyBot/reference/video/frames/20220203-CyBoTBigTreeTechGTRV1wit/003.jpg

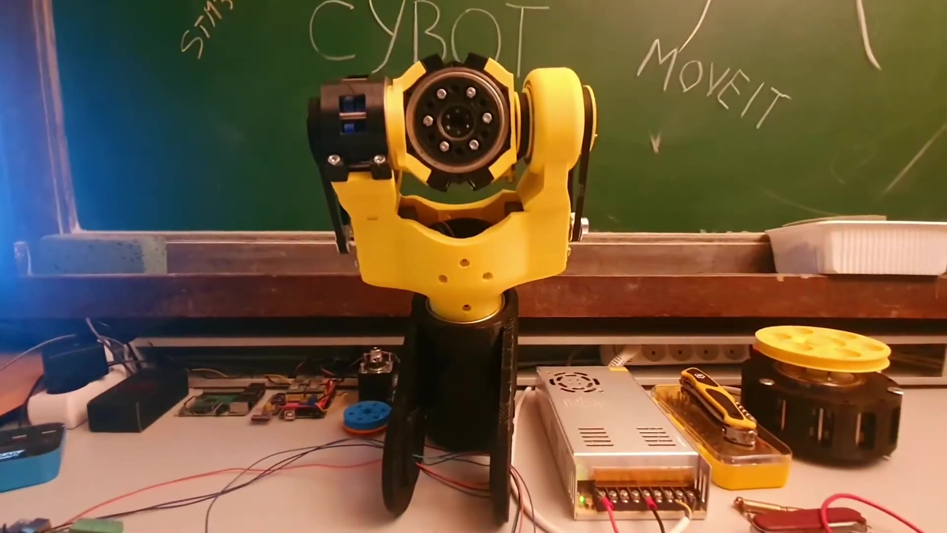
reference/video/frames/20220203-CyBoTBigTreeTechGTRV1wit/003.jpg
