cbiele/CyBot/reference/video/frames/20220203-CyBoTBigTreeTechGTRV1wit/010.jpg

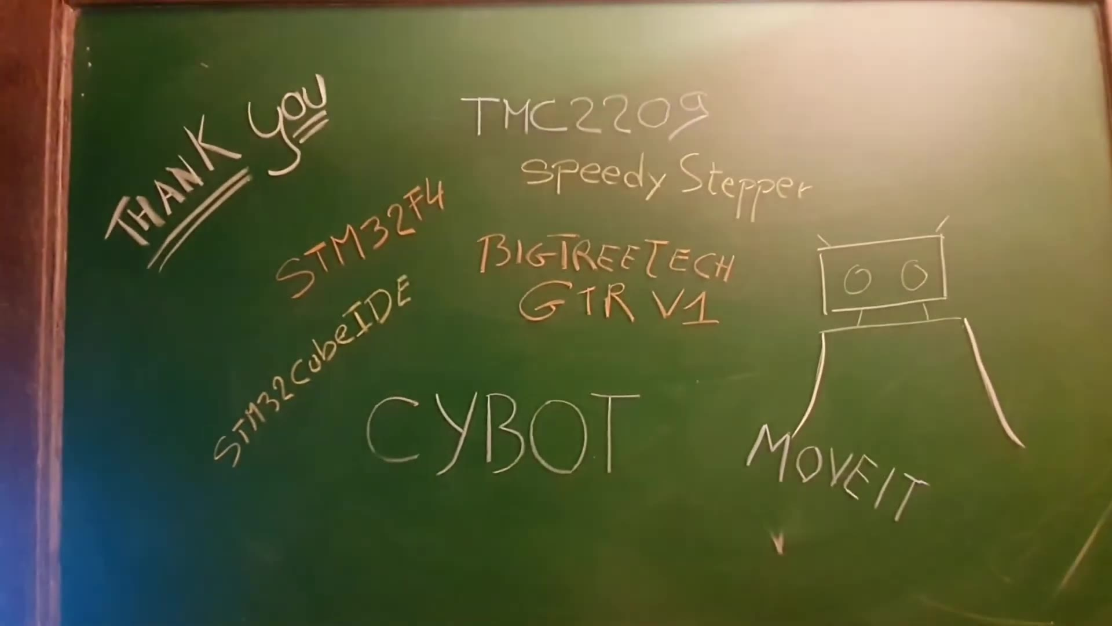
reference/video/frames/20220203-CyBoTBigTreeTechGTRV1wit/010.jpg
