cbiele/CyBot/reference/video/frames/20220209-CyBoTFourthAxisMoving-sheet.jpg

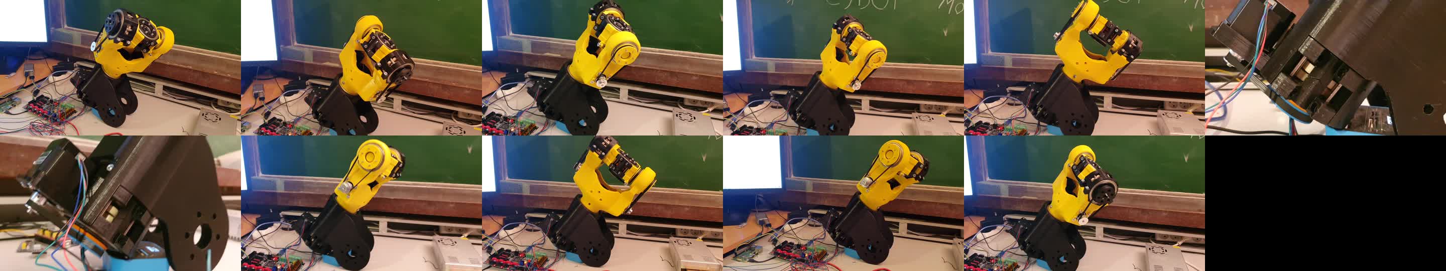
reference/video/frames/20220209-CyBoTFourthAxisMoving-sheet.jpg
