cbiele/CyBot/reference/video/frames/20220209-CyBoTFourthAxisMoving/002.jpg

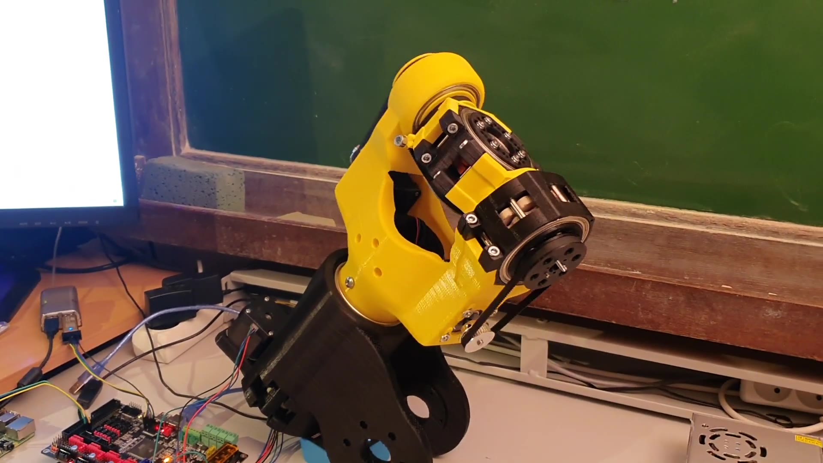
reference/video/frames/20220209-CyBoTFourthAxisMoving/002.jpg
