cbiele/CyBot/reference/video/frames/20220209-CyBoTFourthAxisMoving/003.jpg

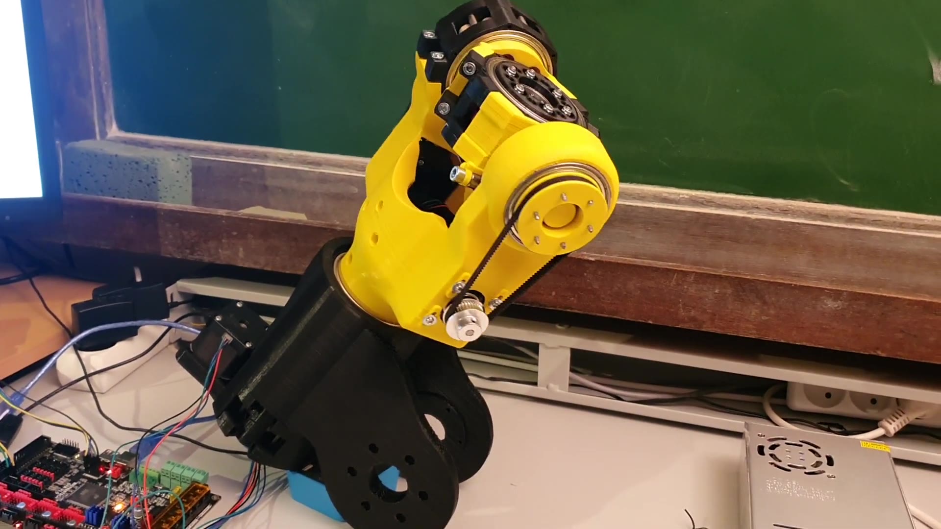
reference/video/frames/20220209-CyBoTFourthAxisMoving/003.jpg
