cbiele/CyBot/reference/video/frames/20220209-CyBoTFourthAxisMoving/004.jpg

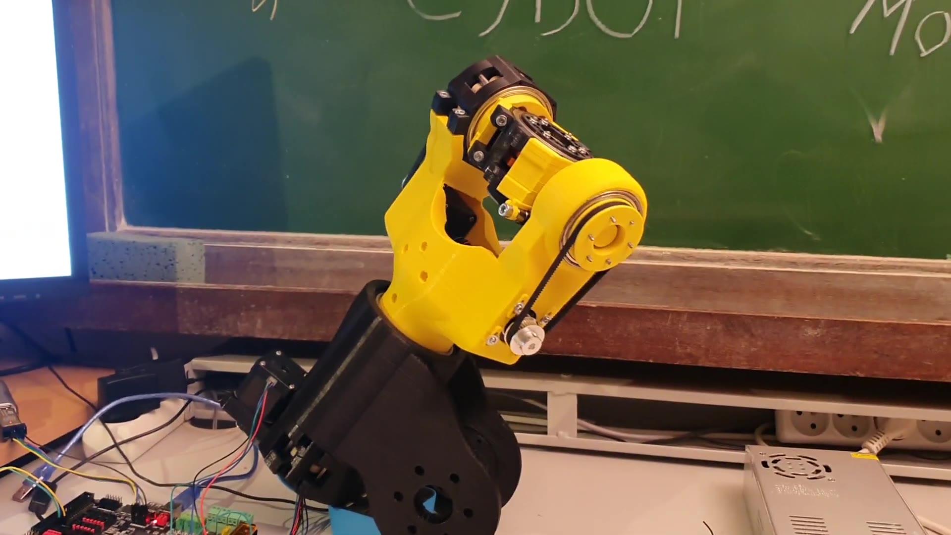
reference/video/frames/20220209-CyBoTFourthAxisMoving/004.jpg
