cbiele/CyBot/reference/video/frames/20220209-CyBoTFourthAxisMoving/005.jpg

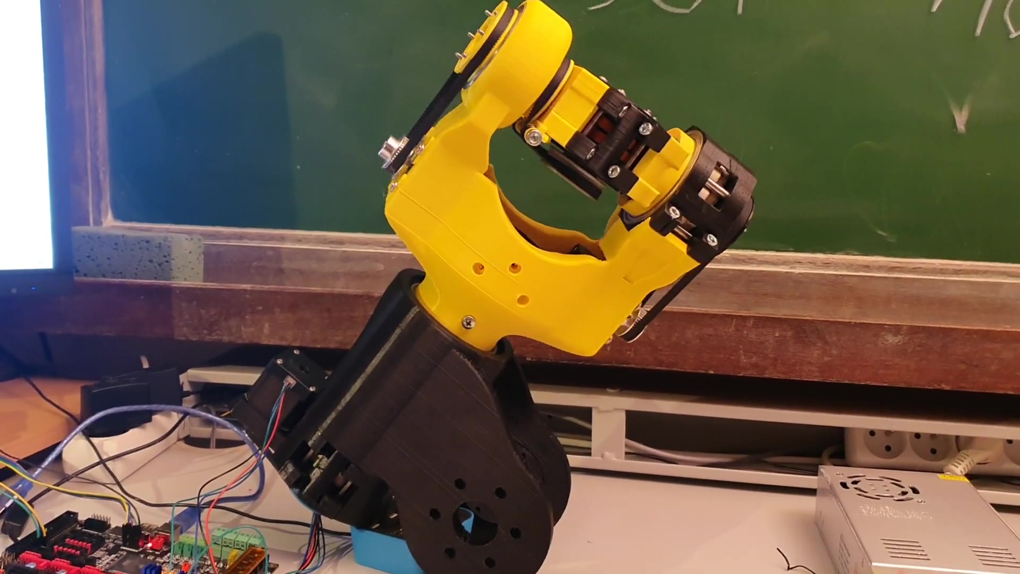
reference/video/frames/20220209-CyBoTFourthAxisMoving/005.jpg
