cbiele/CyBot/reference/video/frames/20220209-CyBoTFourthAxisMoving/006.jpg

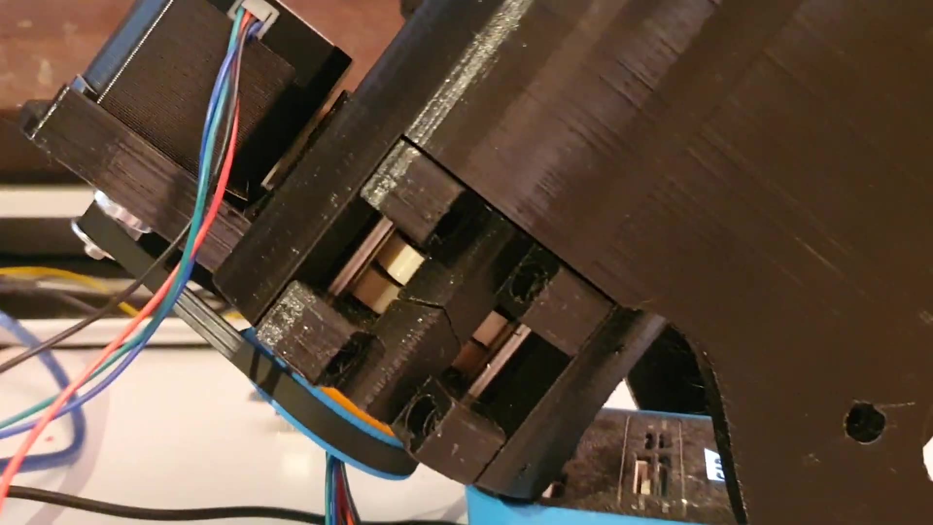
reference/video/frames/20220209-CyBoTFourthAxisMoving/006.jpg
