cbiele/CyBot/reference/video/frames/20220209-CyBoTFourthAxisMoving/010.jpg

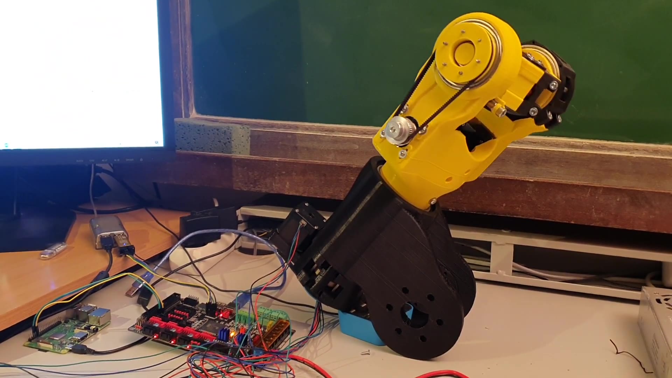
reference/video/frames/20220209-CyBoTFourthAxisMoving/010.jpg
