cbiele/CyBot/reference/video/frames/20220402-CyBoTROSMoveitRVizFirstP/002.jpg

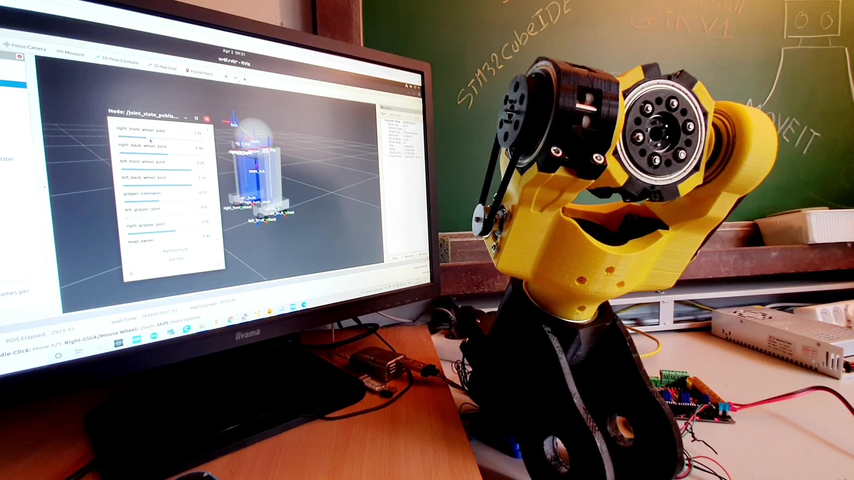
reference/video/frames/20220402-CyBoTROSMoveitRVizFirstP/002.jpg
