cbiele/CyBot/reference/video/frames/20220402-CyBoTROSMoveitRVizFirstP/007.jpg

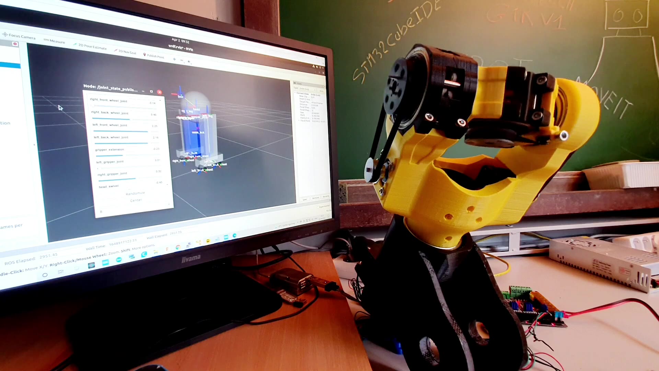
reference/video/frames/20220402-CyBoTROSMoveitRVizFirstP/007.jpg
