cbiele/CyBot/reference/video/frames/20220525-CyBotFinalDesignFusion36-sheet.jpg

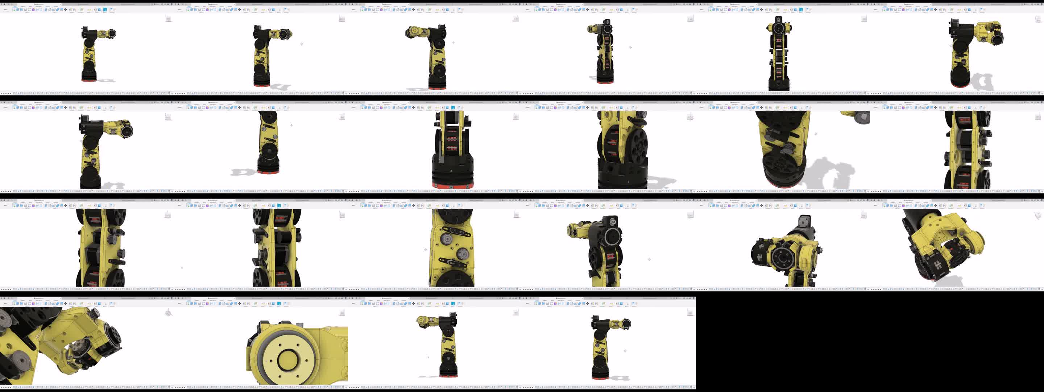
reference/video/frames/20220525-CyBotFinalDesignFusion36-sheet.jpg
