cbiele/CyBot/reference/video/frames/20220525-CyBotFinalDesignFusion36/003.jpg

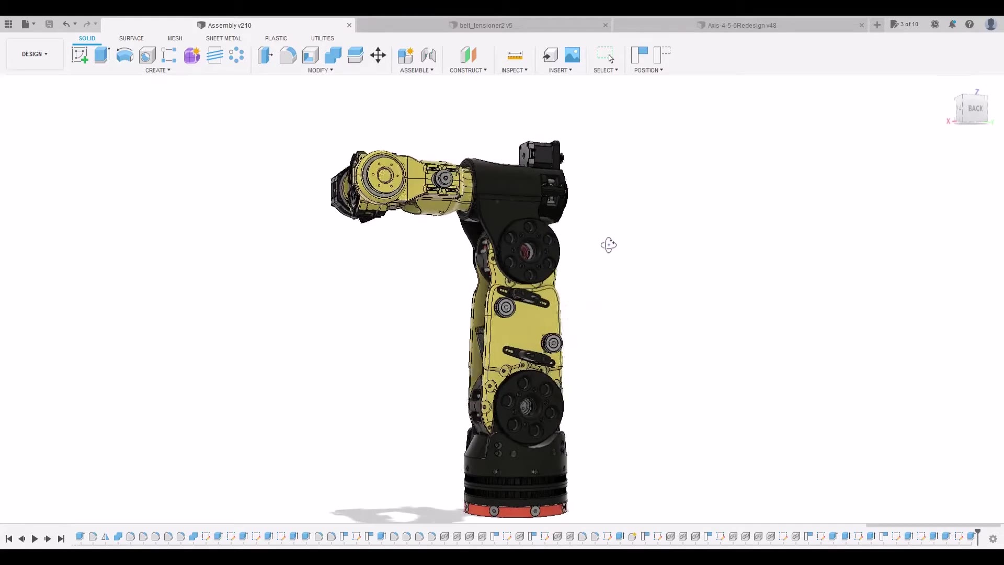
reference/video/frames/20220525-CyBotFinalDesignFusion36/003.jpg
