cbiele/CyBot/reference/video/frames/20220525-CyBotFinalDesignFusion36/005.jpg

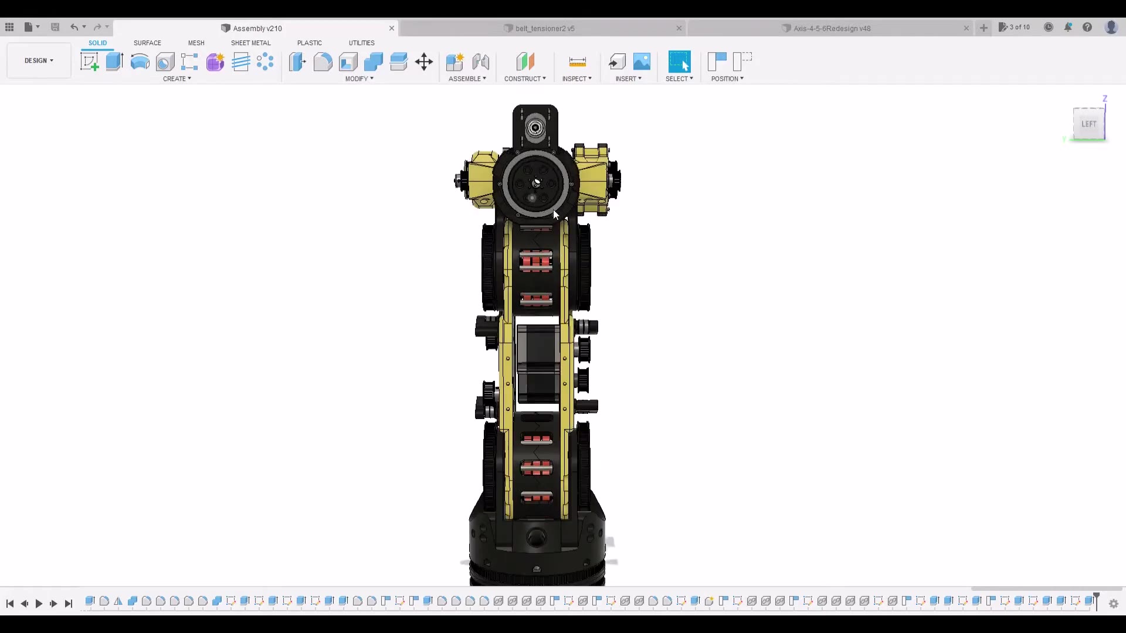
reference/video/frames/20220525-CyBotFinalDesignFusion36/005.jpg
