cbiele/CyBot/reference/video/frames/20220525-CyBotFinalDesignFusion36/006.jpg

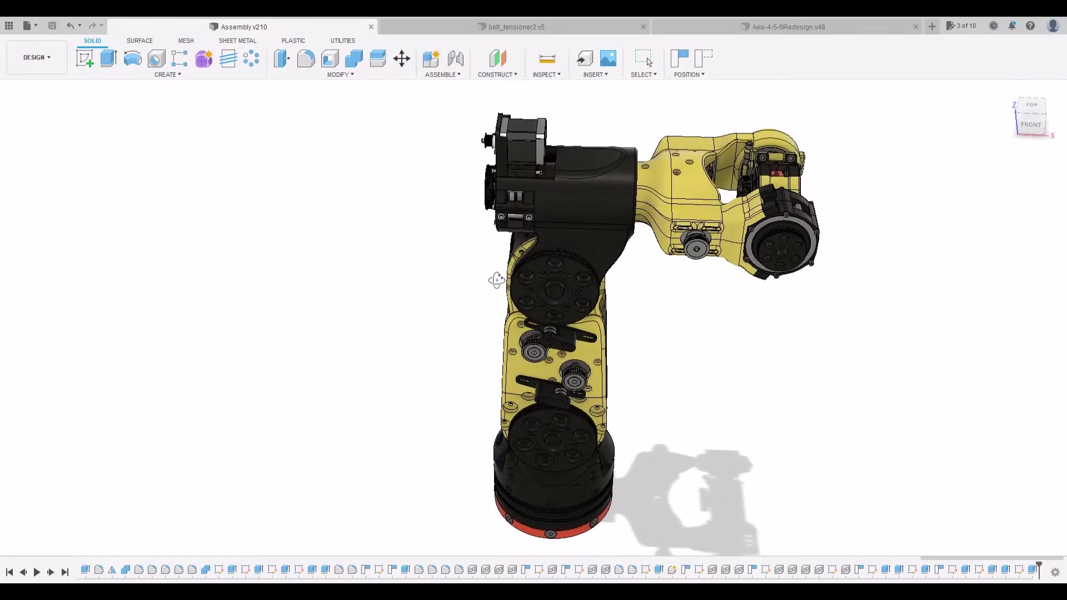
reference/video/frames/20220525-CyBotFinalDesignFusion36/006.jpg
