cbiele/CyBot/reference/video/frames/20220525-CyBotFinalDesignFusion36/008.jpg

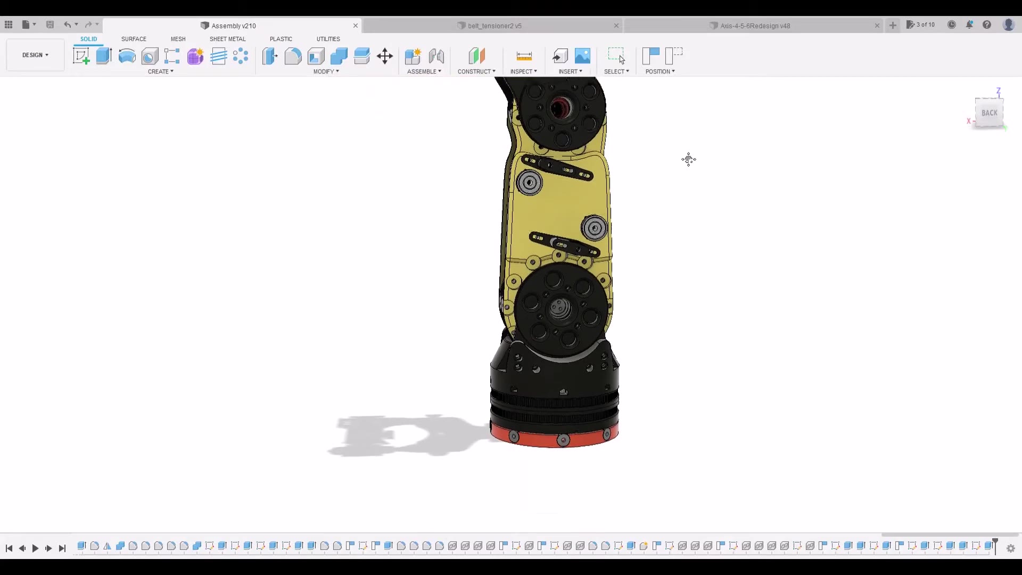
reference/video/frames/20220525-CyBotFinalDesignFusion36/008.jpg
