cbiele/CyBot/reference/video/frames/20220525-CyBotFinalDesignFusion36/009.jpg

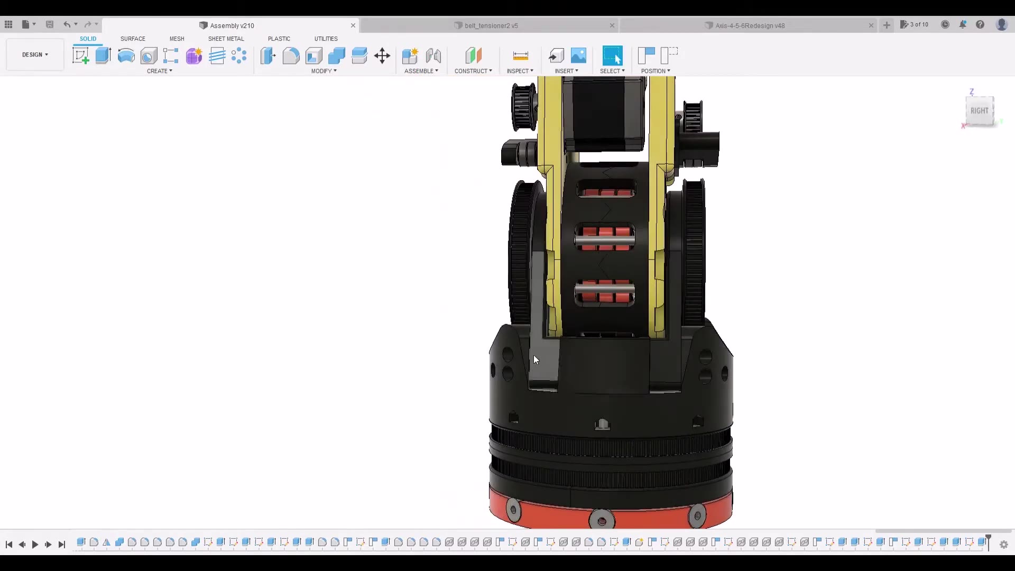
reference/video/frames/20220525-CyBotFinalDesignFusion36/009.jpg
