cbiele/CyBot/reference/video/frames/20220525-CyBotFinalDesignFusion36/011.jpg

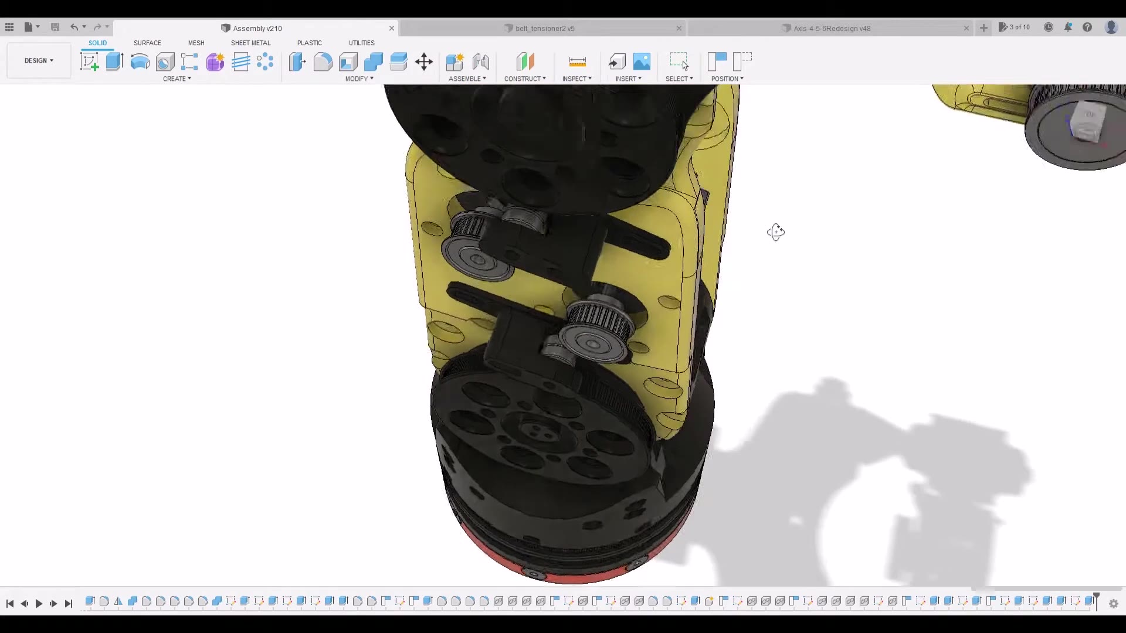
reference/video/frames/20220525-CyBotFinalDesignFusion36/011.jpg
