cbiele/CyBot/reference/video/frames/20220525-CyBotFinalDesignFusion36/012.jpg

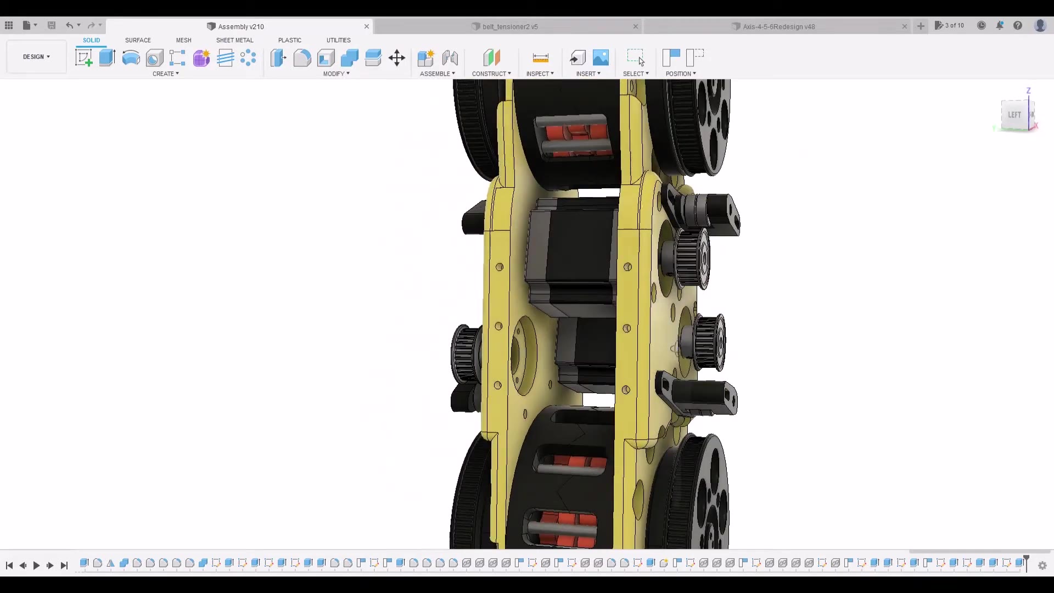
reference/video/frames/20220525-CyBotFinalDesignFusion36/012.jpg
