cbiele/CyBot/reference/video/frames/20220525-CyBotFinalDesignFusion36/017.jpg

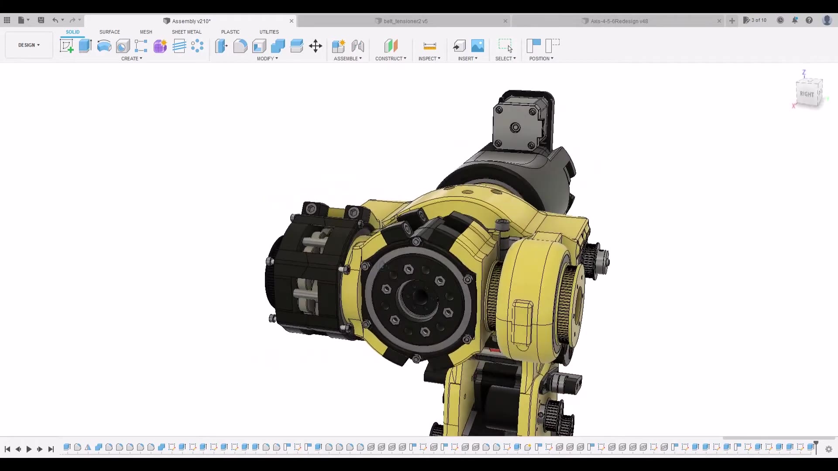
reference/video/frames/20220525-CyBotFinalDesignFusion36/017.jpg
