cbiele/CyBot/reference/video/frames/20220525-CyBotFinalDesignFusion36/019.jpg

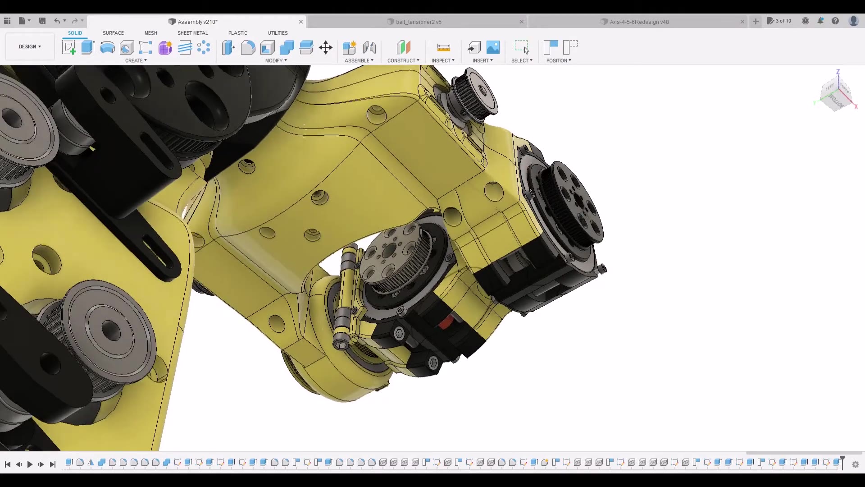
reference/video/frames/20220525-CyBotFinalDesignFusion36/019.jpg
