cbiele/CyBot/reference/video/frames/20220525-CyBotFinalDesignFusion36/021.jpg

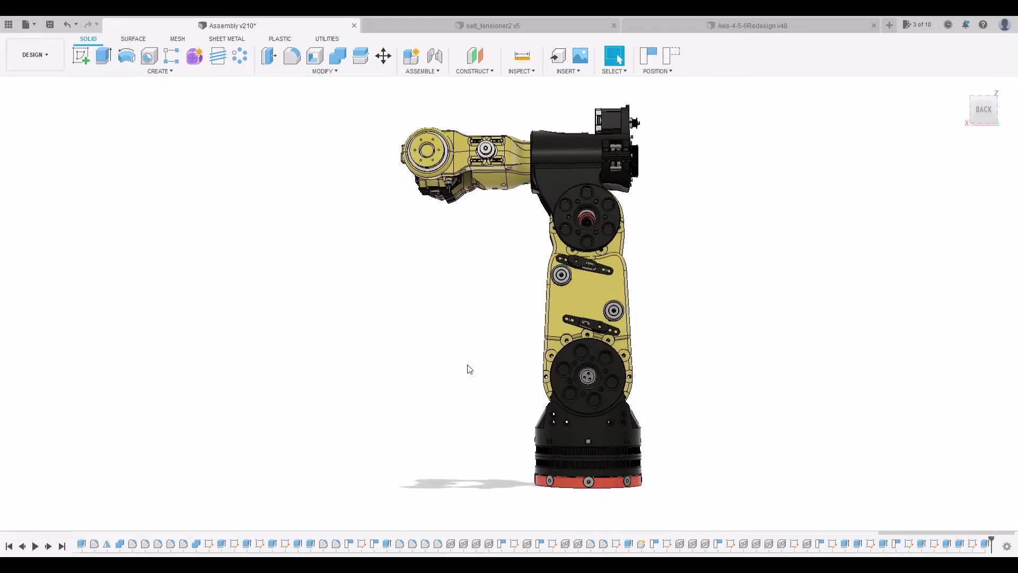
reference/video/frames/20220525-CyBotFinalDesignFusion36/021.jpg
