cbiele/CyBot/reference/video/frames/20220525-CyBotFinalDesignFusion36/022.jpg

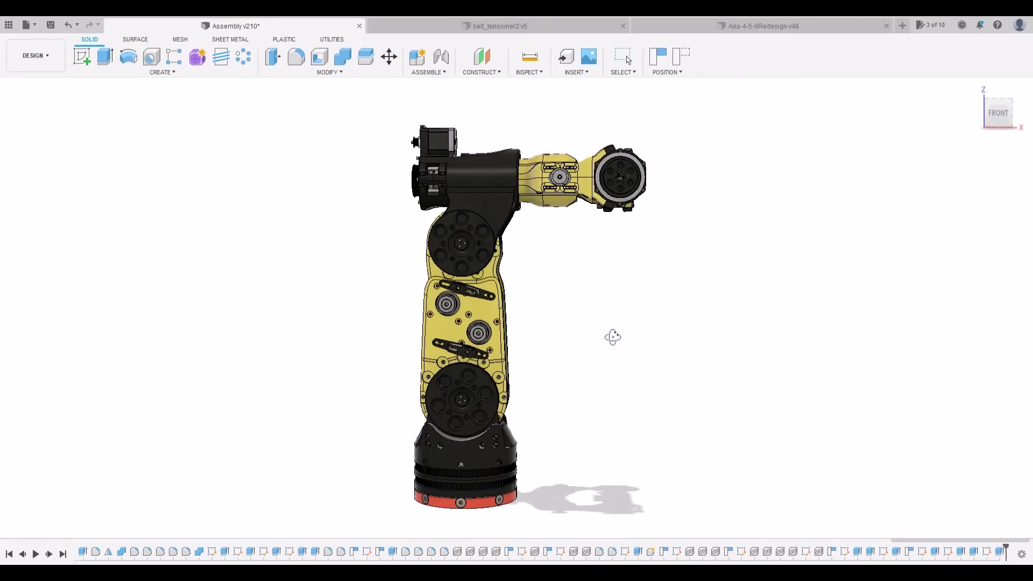
reference/video/frames/20220525-CyBotFinalDesignFusion36/022.jpg
