cbiele/CyBot/reference/video/frames/20221014-CyBoTFinallyworkingwithM-sheet.jpg

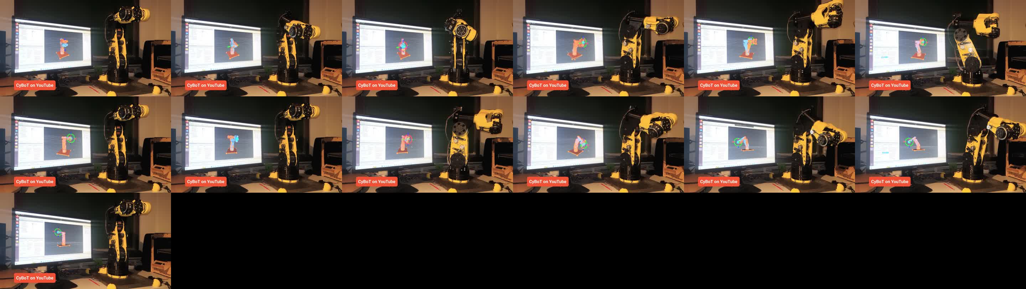
reference/video/frames/20221014-CyBoTFinallyworkingwithM-sheet.jpg
