cbiele/CyBot/reference/video/frames/20221014-CyBoTFinallyworkingwithM/001.jpg

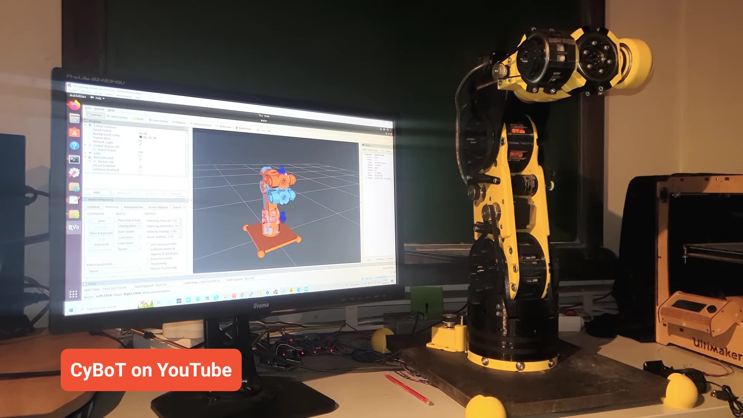
reference/video/frames/20221014-CyBoTFinallyworkingwithM/001.jpg
