cbiele/CyBot/reference/video/frames/20221014-CyBoTFinallyworkingwithM/004.jpg

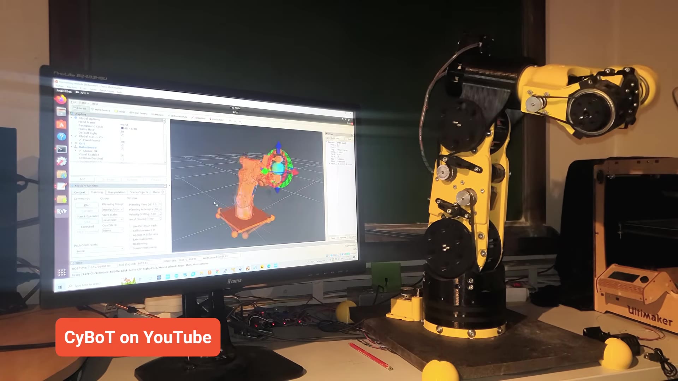
reference/video/frames/20221014-CyBoTFinallyworkingwithM/004.jpg
