cbiele/CyBot/reference/video/frames/20221014-CyBoTFinallyworkingwithM/006.jpg

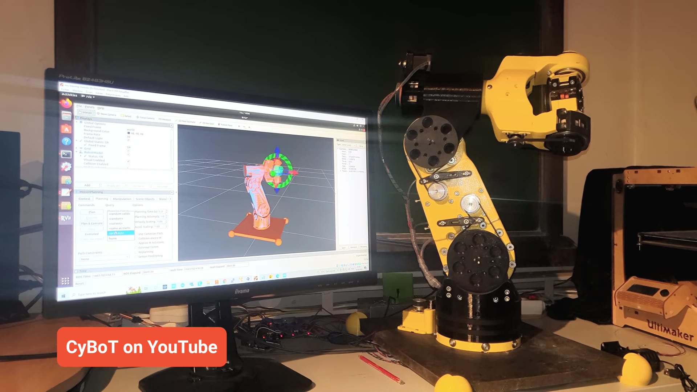
reference/video/frames/20221014-CyBoTFinallyworkingwithM/006.jpg
