cbiele/CyBot/reference/video/frames/20221014-CyBoTFinallyworkingwithM/011.jpg

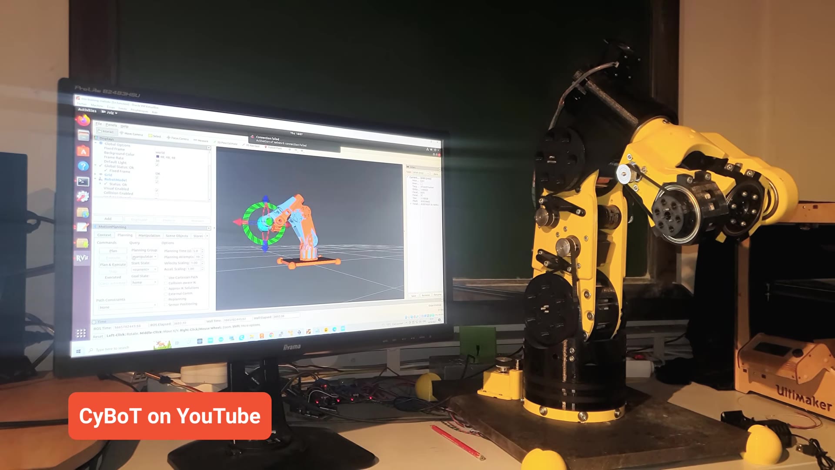
reference/video/frames/20221014-CyBoTFinallyworkingwithM/011.jpg
