cbiele/CyBot/reference/video/frames/20221014-CyBoTFinallyworkingwithM/012.jpg

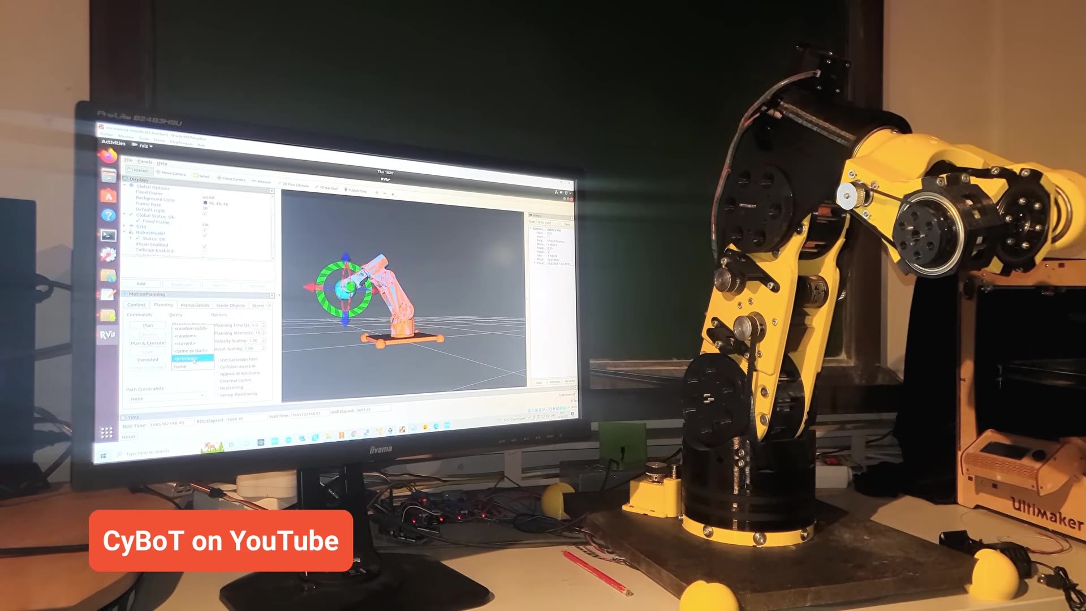
reference/video/frames/20221014-CyBoTFinallyworkingwithM/012.jpg
