cbiele/CyBot/reference/video/frames/20231105-CyBotAddingjoystickandgr/001.jpg

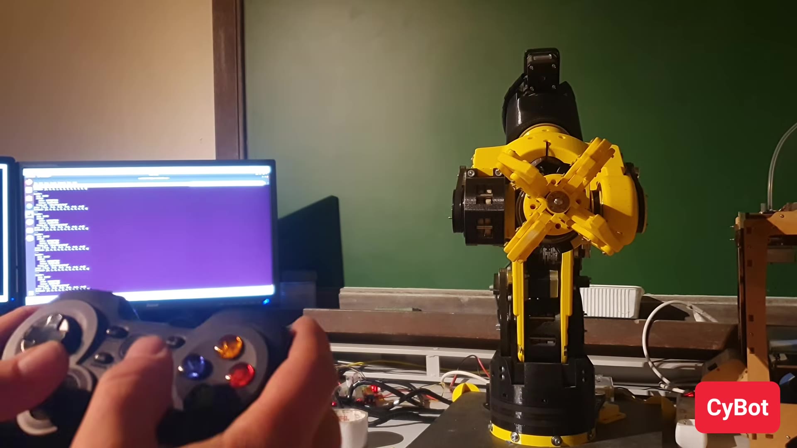
reference/video/frames/20231105-CyBotAddingjoystickandgr/001.jpg
