cbiele/CyBot/reference/video/frames/20231105-CyBotAddingjoystickandgr/007.jpg

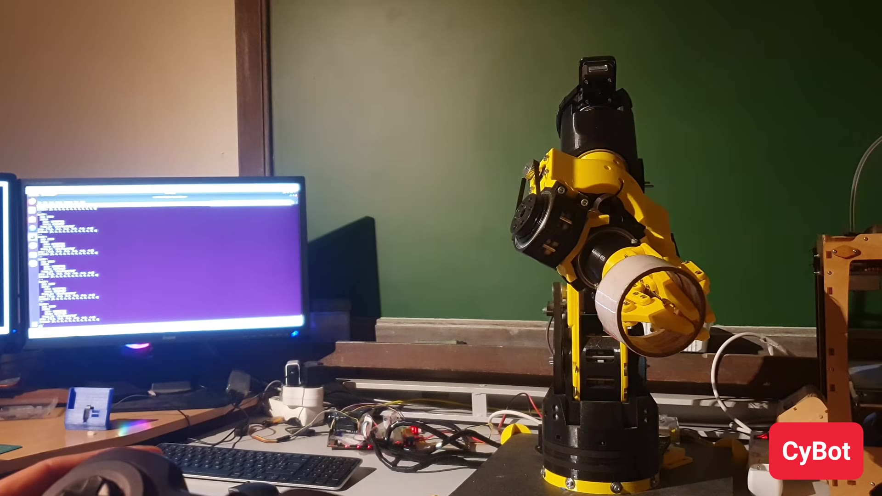
reference/video/frames/20231105-CyBotAddingjoystickandgr/007.jpg
