cbiele/CyBot/reference/video/frames/20231105-CyBotAddingjoystickandgr/008.jpg

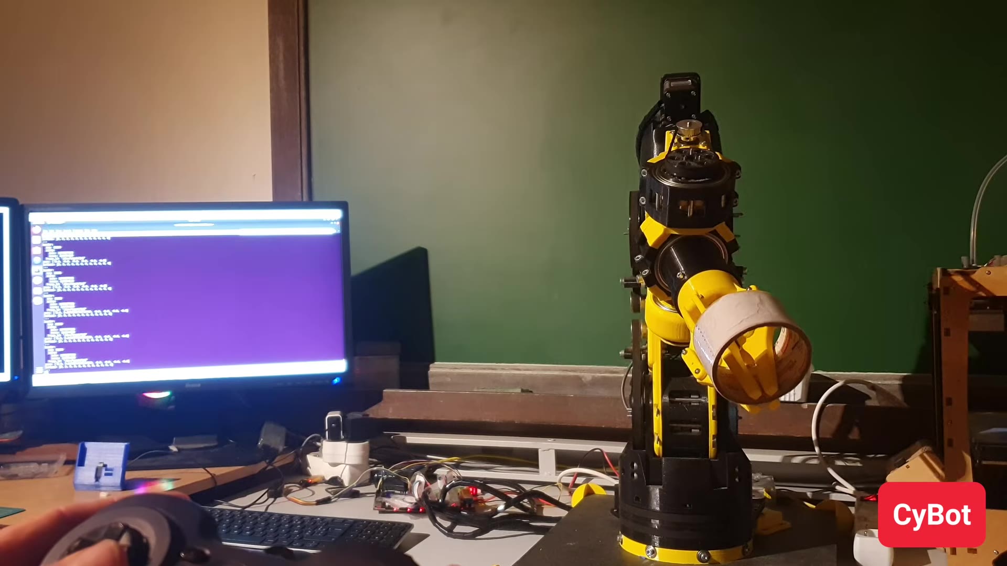
reference/video/frames/20231105-CyBotAddingjoystickandgr/008.jpg
