cbiele/CyBot/reference/video/frames/20231105-CyBotAddingjoystickandgr/010.jpg

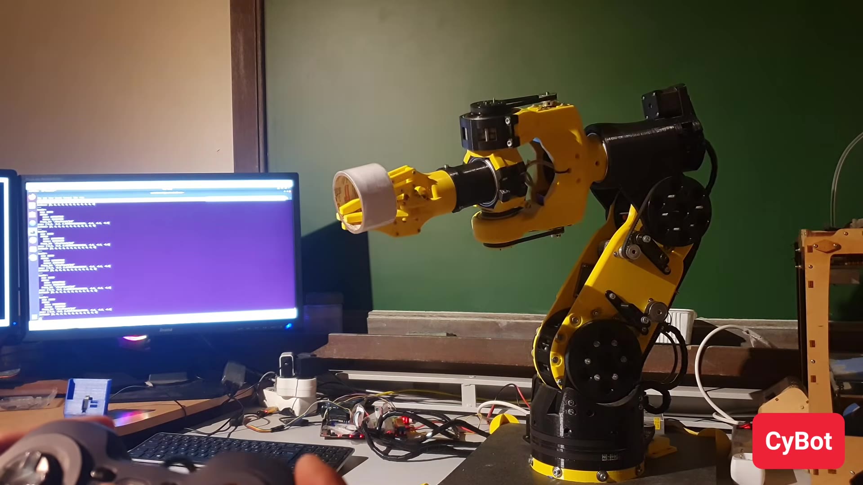
reference/video/frames/20231105-CyBotAddingjoystickandgr/010.jpg
