cbiele/CyBot/reference/video/frames/20231105-CyBotAddingjoystickandgr/014.jpg

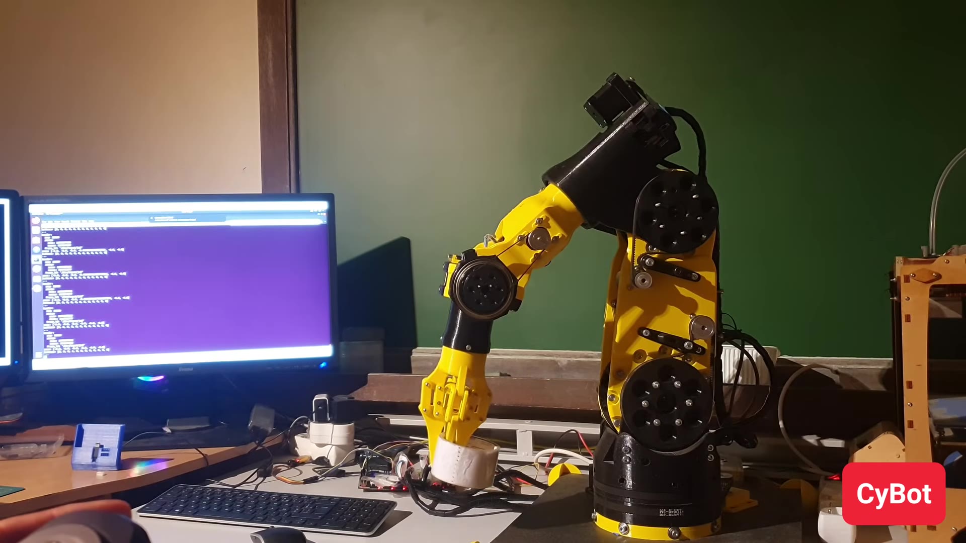
reference/video/frames/20231105-CyBotAddingjoystickandgr/014.jpg
