cbiele/CyBot/reference/video/frames/20231105-CyBotAddingjoystickandgr/015.jpg

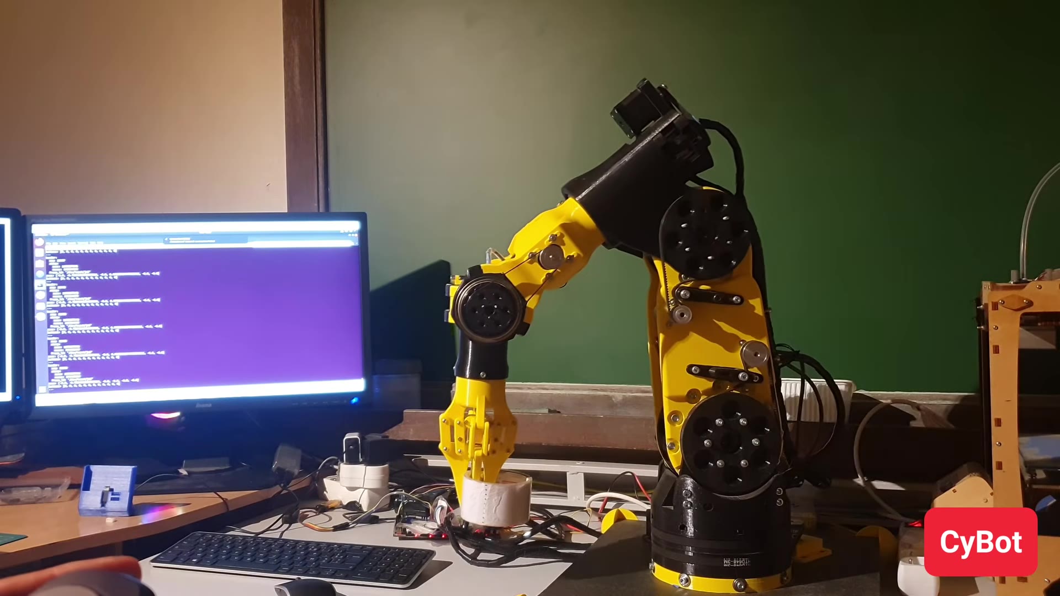
reference/video/frames/20231105-CyBotAddingjoystickandgr/015.jpg
