cbiele/CyBot/reference/video/frames/20231105-CyBotAddingjoystickandgr/016.jpg

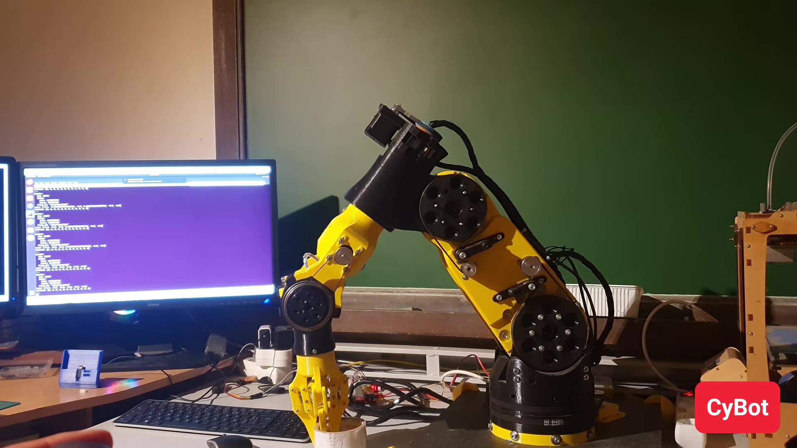
reference/video/frames/20231105-CyBotAddingjoystickandgr/016.jpg
