cbiele/CyBot/reference/video/frames/20231105-CyBotAddingjoystickandgr/017.jpg

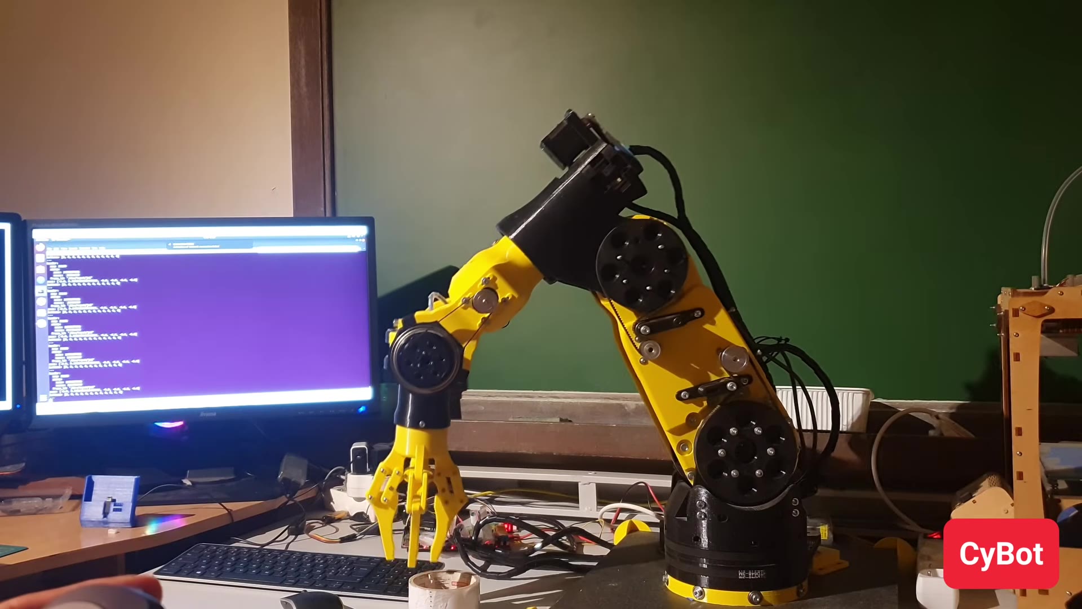
reference/video/frames/20231105-CyBotAddingjoystickandgr/017.jpg
