cbiele/CyBot/model/split/mainBody2_lower_fixed.stl

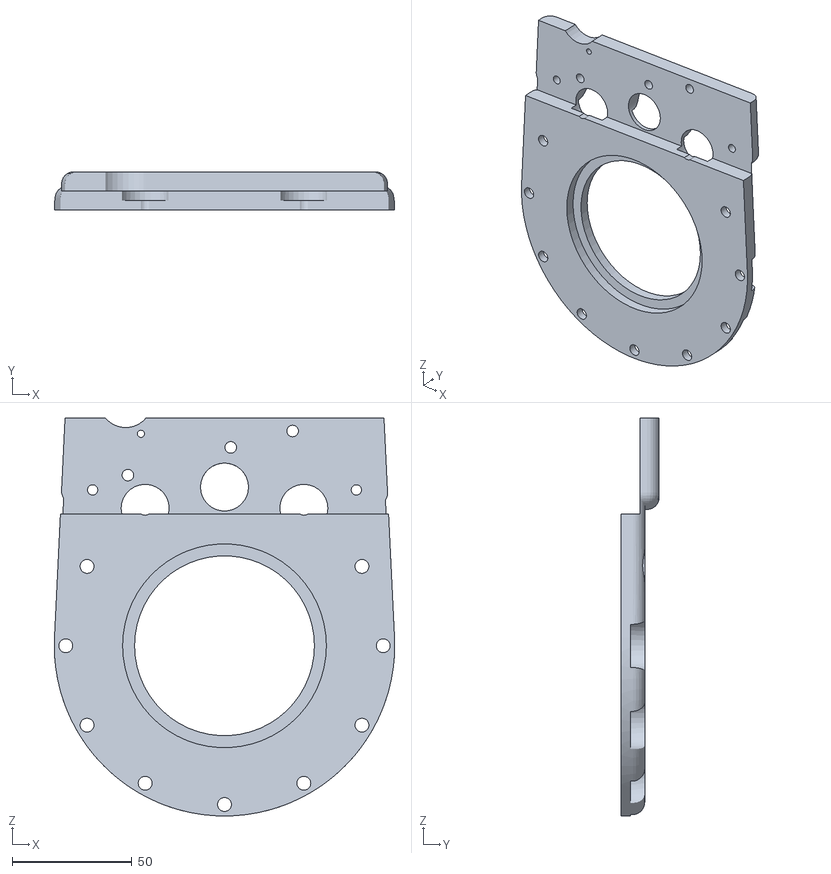
[picture p165: CAD file, 2026-09-14]
model/split/mainBody2_lower_fixed.stl
142.0 x 16.0 x 166.0
