cbiele/CyBot/reference/openhand/model o/RX28-MX28/hand_o.SLDASM

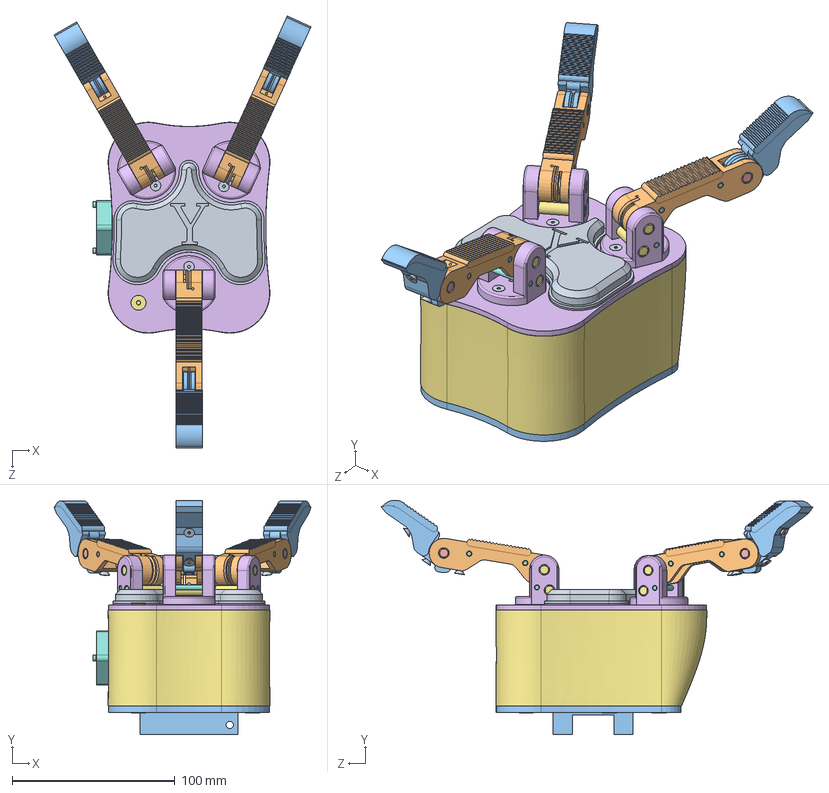
[picture p166: CAD file, 2026-09-14]
reference/openhand/model o/RX28-MX28/hand_o.SLDASM
157.7 x 143.9 x 265.1 mm
d3_o_minimal
93365A120 4-40 insert x 17
91253A110 4-40 L1-2 countersunk x 2
c2_left_o
c2_right_o
b3_o x 2
dynamixel MX-28-exposed x 4
d2_o x 4
91772A266 2-56 L5-4 pan x 16
b2_o
91292A003 M2 L3 socket x 2
92196A084 2-56 L3-4 socket x 6
90480A003 2-56 nut x 6
c1_o x 3
98381A544 D1-4 L5-4 x 6
98381A477 D1-8 L5-4 x 3
91253A106 4-40 L1-4 countersunk x 15
t_pp_A x 3
t_pp_B x 3
98381A472 D1-8 L5-8 x 6
98381A539 D1-4 L5-8 x 3
a1_o
92210A197 8-32 L3-4 countersunk x 8
a2_o
93330A483 8-32 L2 standoff x 4
a3_o
a4_o
b1_o x 3
91290A012 M2 L5 socket x 6
91292A012 M2.5 L8 socket x 3
d1_o
fan - 25x25x10
