cbiele/CyBot/model/split/mainBody1_upper_fixed.stl

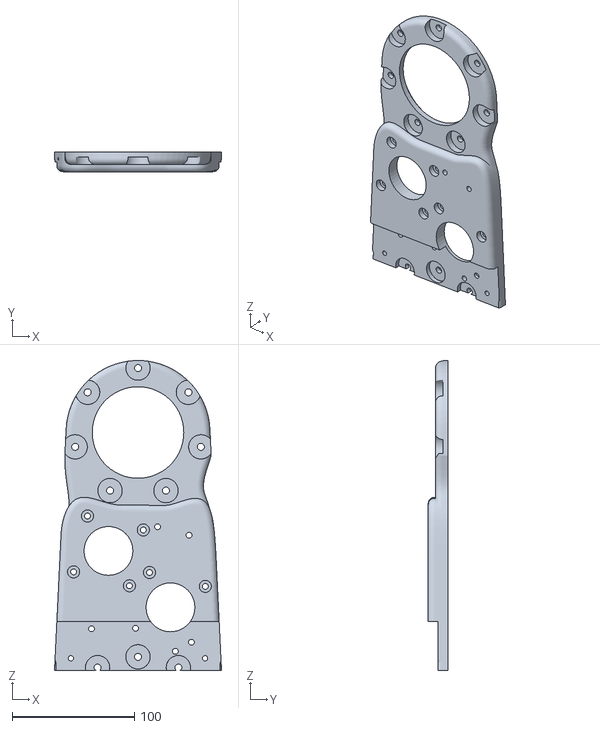
[picture p167: CAD file, 2026-09-14]
model/split/mainBody1_upper_fixed.stl
136.9 x 16.0 x 254.0
