cbiele/CyBot/Cults3d_v5/1-mainbody/mainBody1.stl

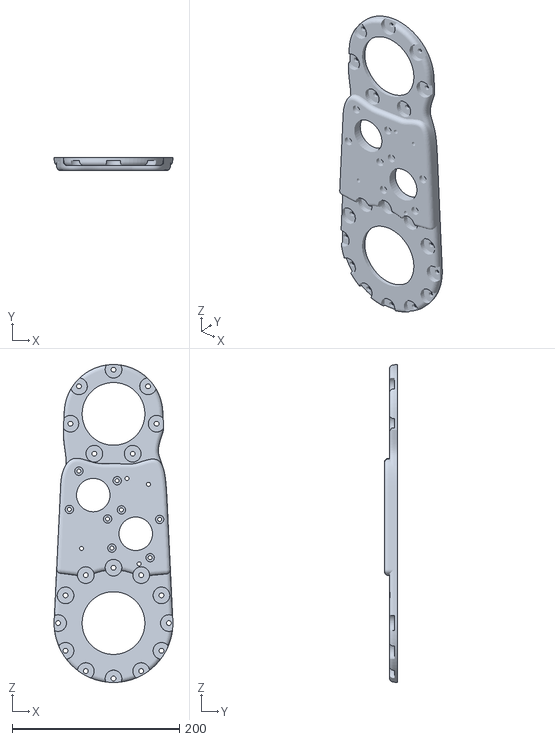
[picture p168: CAD file, 2026-09-06]
Cults3d_v5/1-mainbody/mainBody1.stl
142.0 x 16.0 x 380.0
