cbiele/CyBot/model/split/mainBody2_upper.stl

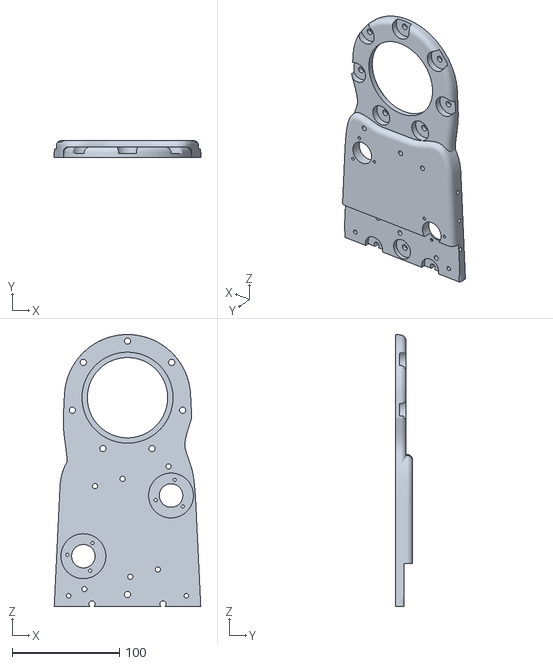
[picture p169: CAD file, 2026-09-06]
model/split/mainBody2_upper.stl
136.9 x 16.0 x 254.0
