cbiele/CyBot/4FingersGripper/mainHolder.stl

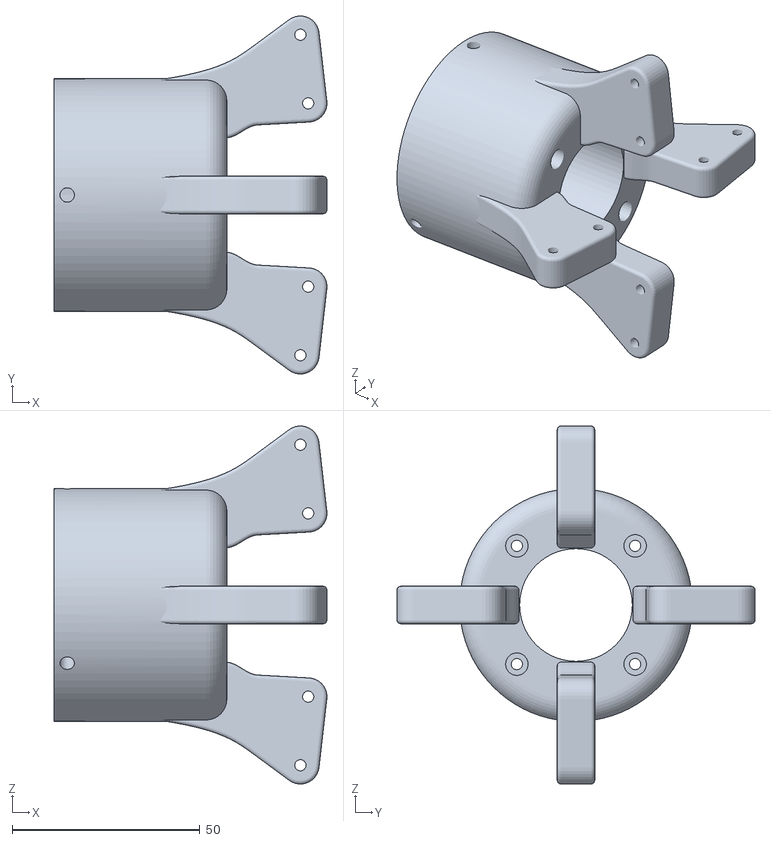
[picture p170: CAD file, 2026-09-06]
4FingersGripper/mainHolder.stl
72.7 x 95.3 x 95.3
