cbiele/CyBot/Cults3d_v5/1-mainbody/mainBody2.stl

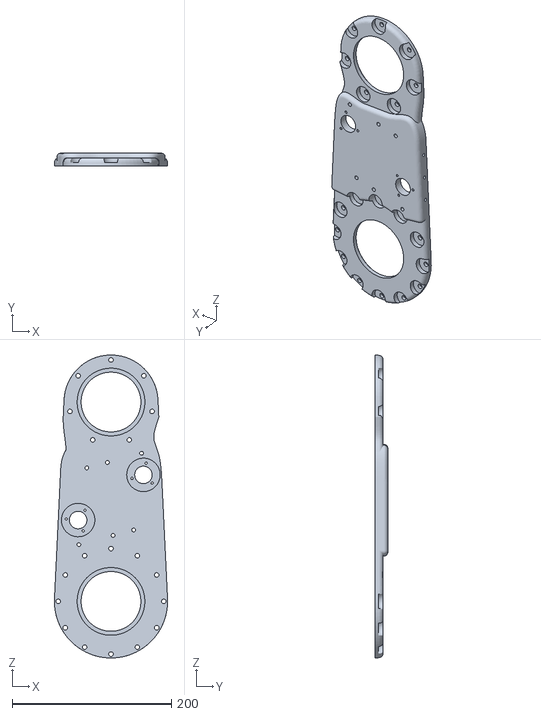
[picture p171: CAD file, 2026-09-06]
Cults3d_v5/1-mainbody/mainBody2.stl
142.0 x 16.0 x 380.0
