cbiele/CyBot/4FingersGripper/Axe.stl

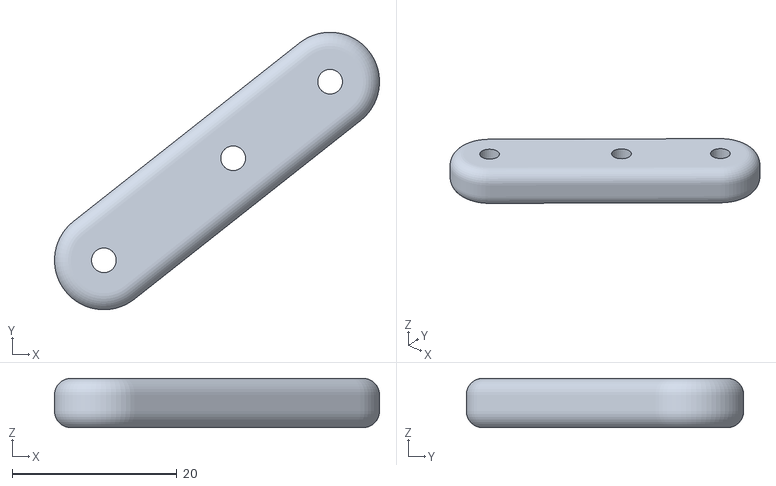
[picture p172: CAD file, 2026-09-06]
4FingersGripper/Axe.stl
39.5 x 33.7 x 6.00
