cbiele/CyBot/Cults3d_v5/1-mainbody/beltTentioner1.stl

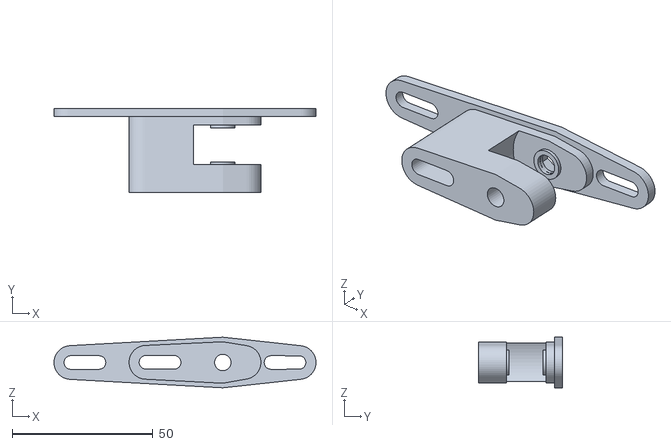
[picture p173: CAD file, 2026-09-06]
Cults3d_v5/1-mainbody/beltTentioner1.stl
93.1 x 30.0 x 18.0
