cbiele/CyBot/Cults3d_v5/2-axis1/axis-1-rotatingBase1.stl

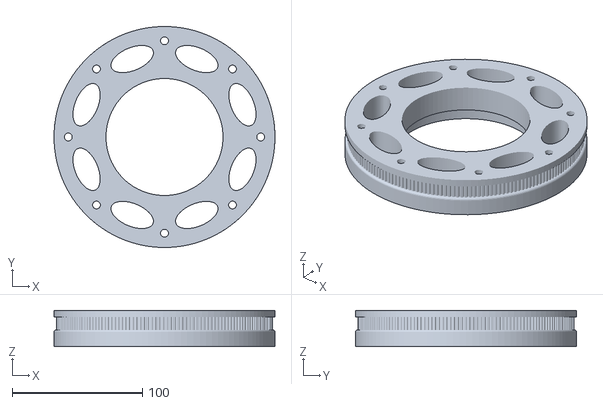
[picture p174: CAD file, 2026-09-06]
Cults3d_v5/2-axis1/axis-1-rotatingBase1.stl
170.0 x 170.0 x 28.0
