cbiele/CyBot/Cults3d_v5/3-axis2/axis2-housing2.stl

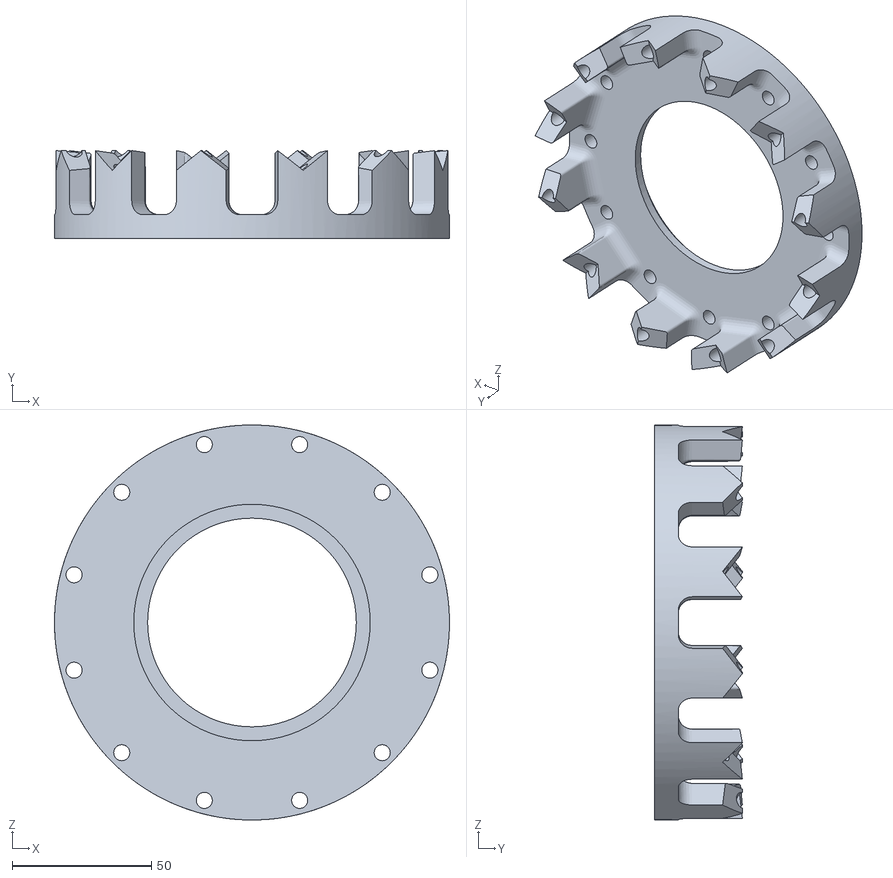
[picture p175: CAD file, 2026-09-06]
Cults3d_v5/3-axis2/axis2-housing2.stl
142.0 x 31.6 x 142.0
