cbiele/CyBot/Cults3d_v5/4-axis3/axis3-disk1.stl

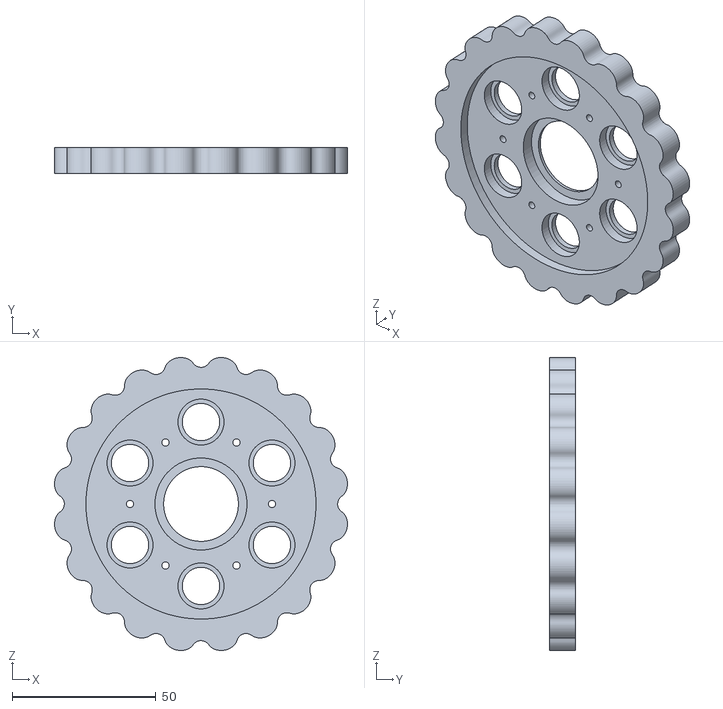
[picture p176: CAD file, 2026-09-06]
Cults3d_v5/4-axis3/axis3-disk1.stl
101.9 x 9.00 x 101.9
