cbiele/CyBot/Cults3d_v5/5-axis4/axis4_housing.stl

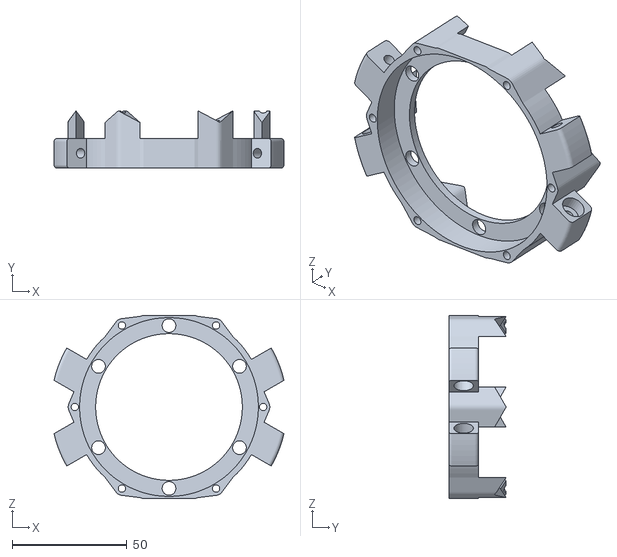
[picture p177: CAD file, 2026-09-06]
Cults3d_v5/5-axis4/axis4_housing.stl
100.3 x 25.0 x 80.0
