cbiele/CyBot/Cults3d_v5/6-axis5-6/axis5-holder_fixed.stl

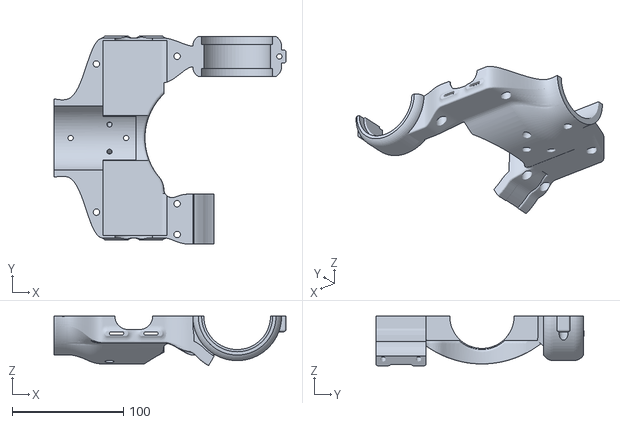
[picture p178: CAD file, 2026-09-14]
Cults3d_v5/6-axis5-6/axis5-holder_fixed.stl
209.0 x 187.5 x 44.6
