cbiele/CyBot/model/axis2/axis2-holder2-clocked.stl

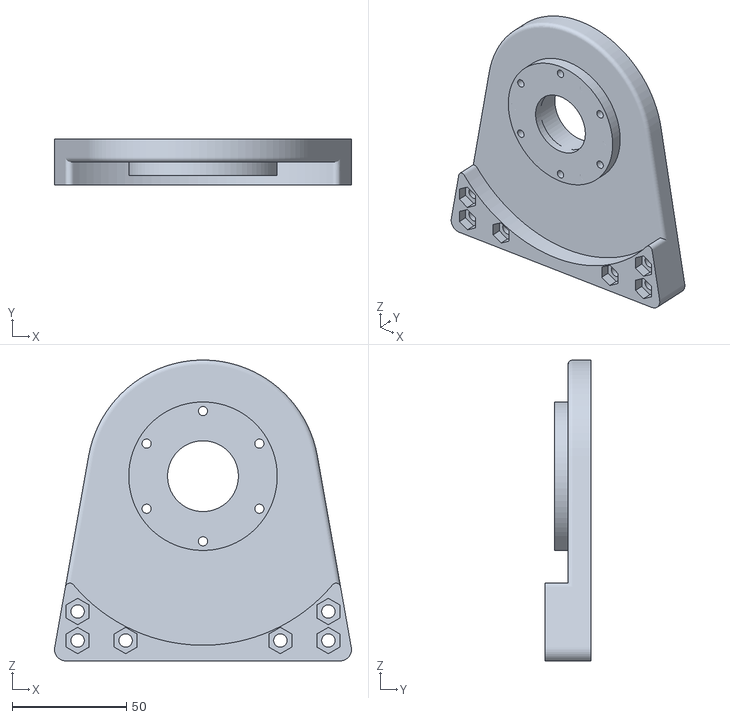
[picture p179: CAD file, 2026-10-26]
model/axis2/axis2-holder2-clocked.stl
130.0 x 20.0 x 131.7
