cbiele/CyBot/model/axis4/axis4_OPH2-spigot.stl

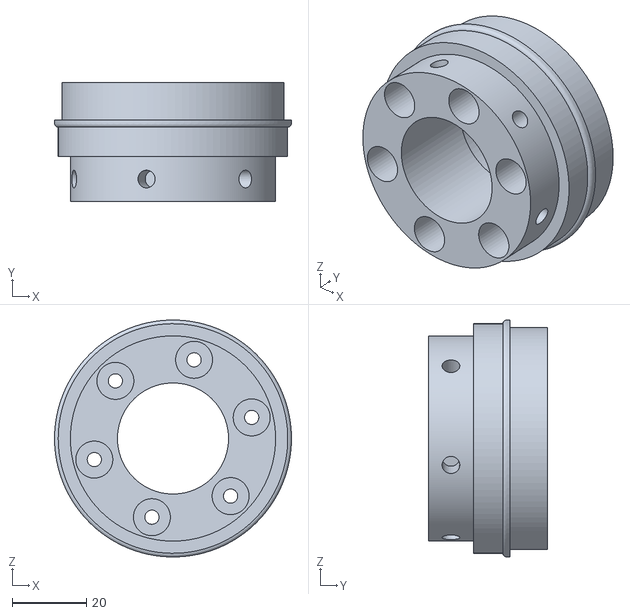
[picture p180: CAD file, 2026-10-23]
model/axis4/axis4_OPH2-spigot.stl
64.0 x 32.0 x 64.0
