cbiele/CyBot/model/base/axis1-pulley-27T.stl

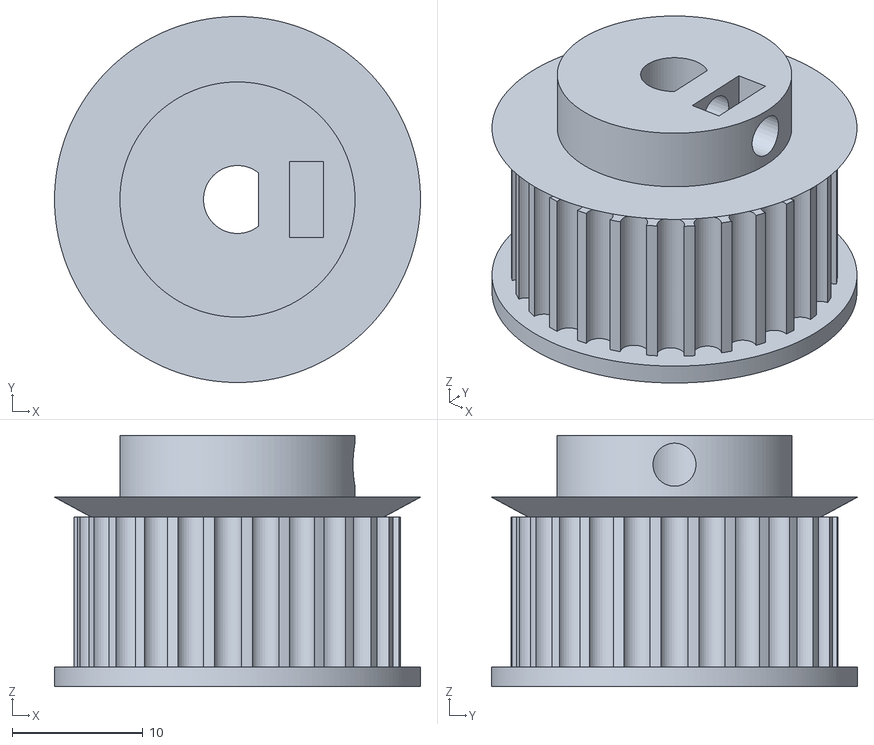
[picture p181: CAD file, 2026-10-26]
model/base/axis1-pulley-27T.stl
28.0 x 28.0 x 19.2
