cbiele/CyBot/model/cycloid-poc/20-1-compact/carrier-rear.stl

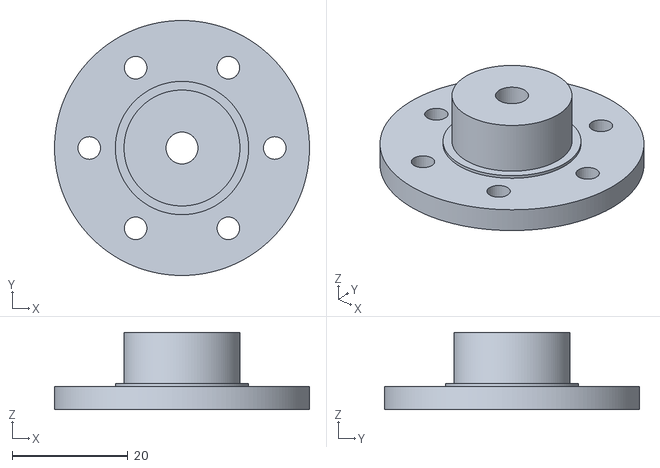
[picture p182: CAD file, 2026-11-05]
model/cycloid-poc/20-1-compact/carrier-rear.stl
44.0 x 44.0 x 13.3
