cbiele/CyBot/model/cycloid-poc/20-1-hollow/disk-b.stl

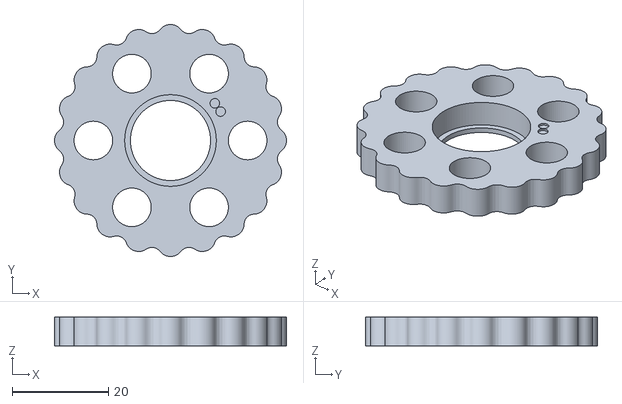
[picture p183: CAD file, 2026-11-05]
model/cycloid-poc/20-1-hollow/disk-b.stl
48.1 x 48.1 x 6.00
