cbiele/CyBot/model/cycloid-poc/cycloid-hollow-motor7-bracket.stl

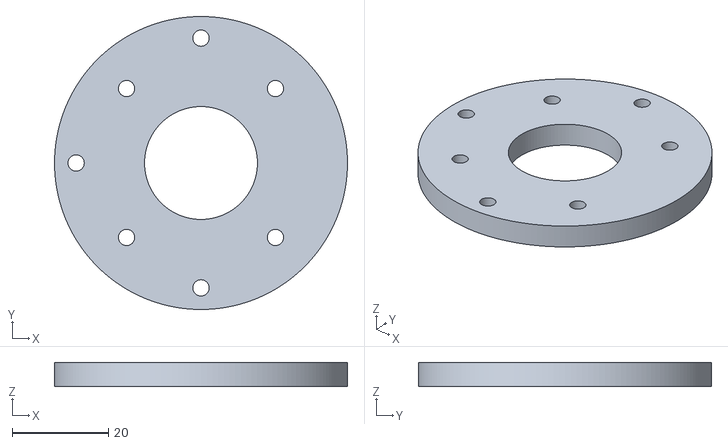
[picture p184: CAD file, 2026-10-28]
model/cycloid-poc/cycloid-hollow-motor7-bracket.stl
61.0 x 61.0 x 5.00
