cbiele/CyBot/model/cycloid-poc/test-parts/fit-coupon-pegs.stl

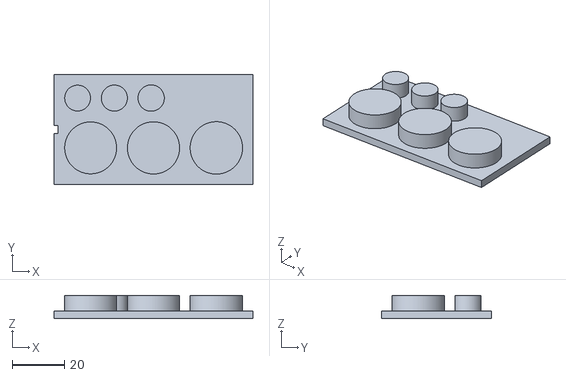
[picture p185: CAD file, 2026-10-28]
model/cycloid-poc/test-parts/fit-coupon-pegs.stl
76.3 x 42.2 x 9.00
