cbiele/CyBot/model/electronics/octopus-pro-plate.stl

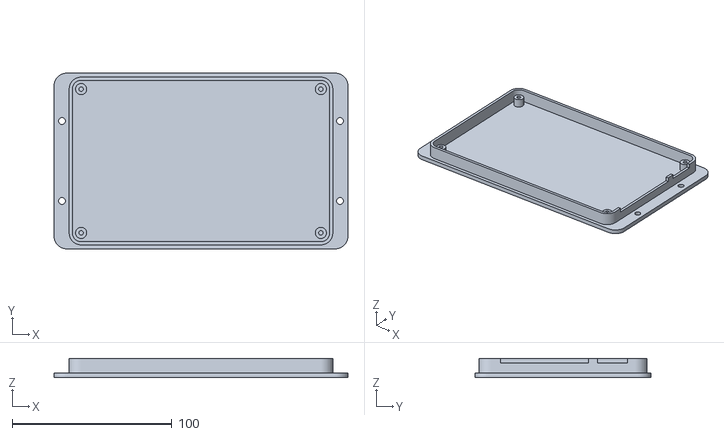
[picture p186: CAD file, 2026-09-21]
model/electronics/octopus-pro-plate.stl
184.0 x 110.0 x 12.0
