cbiele/CyBot/model/hand/palm-bench-foot.stl

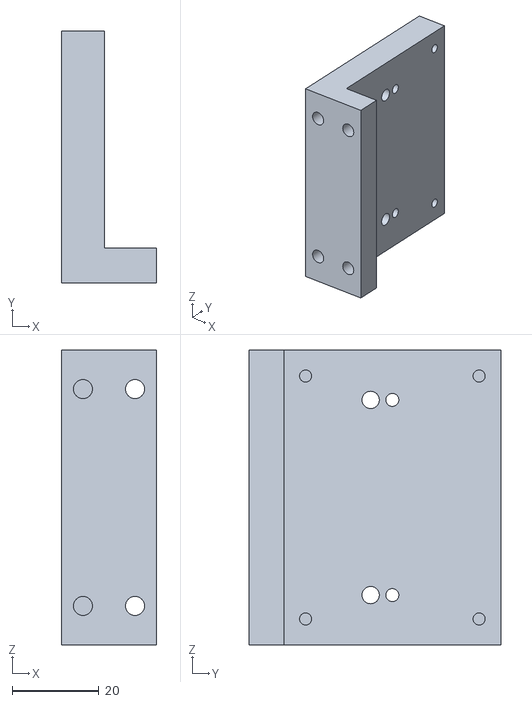
[picture p187: CAD file, 2026-09-24]
model/hand/palm-bench-foot.stl
22.0 x 58.0 x 68.0
