cbiele/CyBot/reference/openhand/fingers/m2_pf.SLDPRT

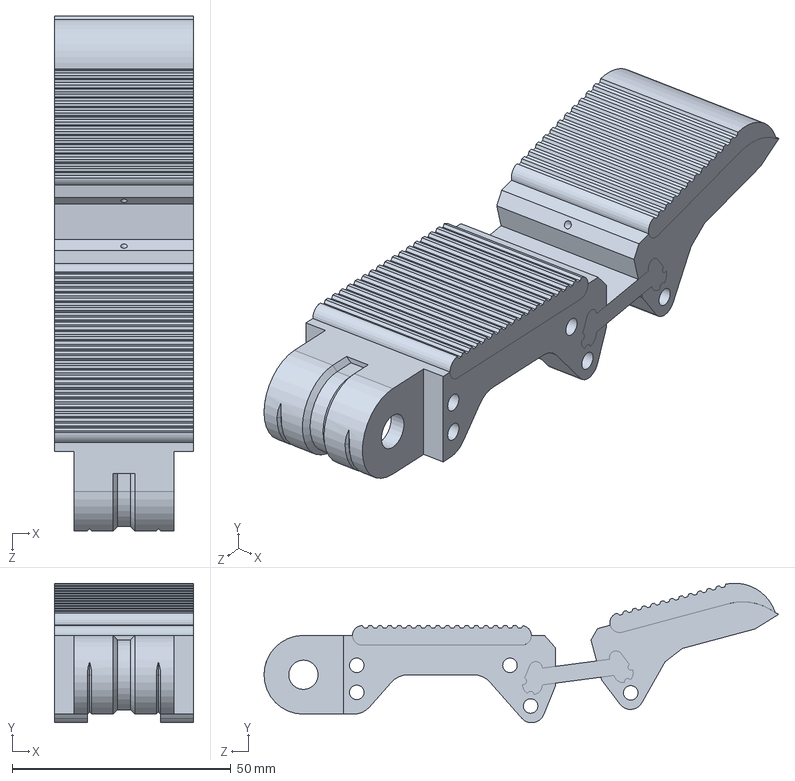
[picture p188: CAD file, 2026-09-14]
reference/openhand/fingers/m2_pf.SLDPRT
31.8 x 31.9 x 117.6 mm
