cbiele/CyBot/reference/openhand/fingers/molds/finger_ff_t42.SLDPRT

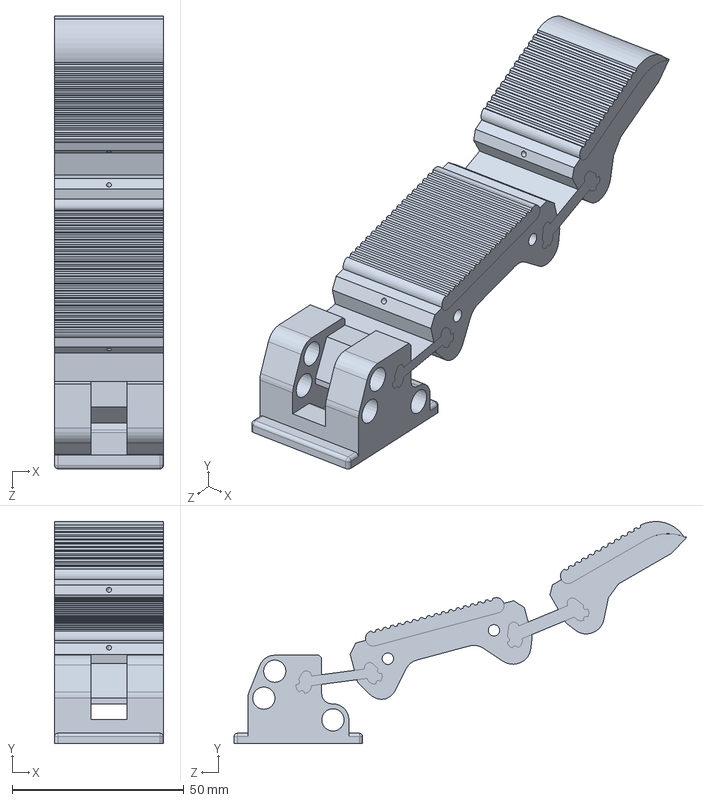
[picture p189: CAD file, 2026-09-14]
reference/openhand/fingers/molds/finger_ff_t42.SLDPRT
31.8 x 64.7 x 132.0 mm
