cbiele/CyBot/URDF/link_4.stl

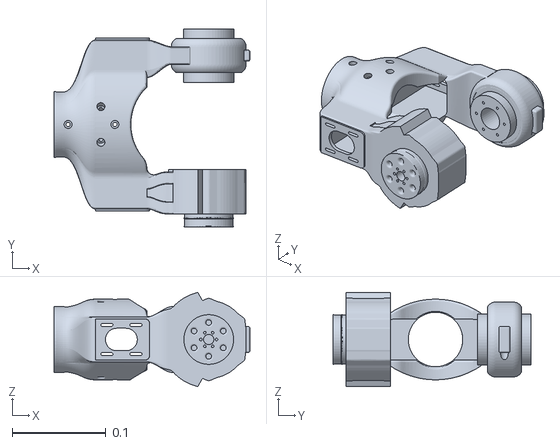
[picture p190: CAD file, 2026-09-06]
URDF/link_4.stl
0.209 x 0.211 x 0.1
