cbiele/CyBot/4FingersGripper/T8_Srcew_Holder.stl

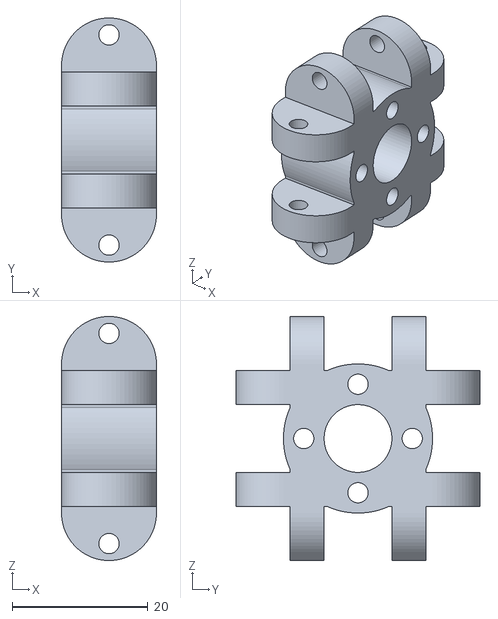
[picture p191: CAD file, 2026-09-06]
4FingersGripper/T8_Srcew_Holder.stl
14.0 x 36.0 x 36.0
