cbiele/CyBot/Cults3d_v5/1-mainbody/beltTentioner2.stl

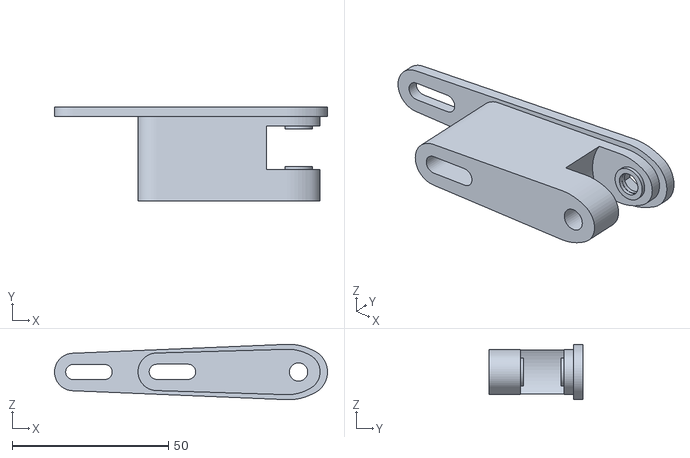
[picture p192: CAD file, 2026-09-06]
Cults3d_v5/1-mainbody/beltTentioner2.stl
87.2 x 30.0 x 17.7
