cbiele/CyBot/Cults3d_v5/2-axis1/axis1-baseHolder.stl

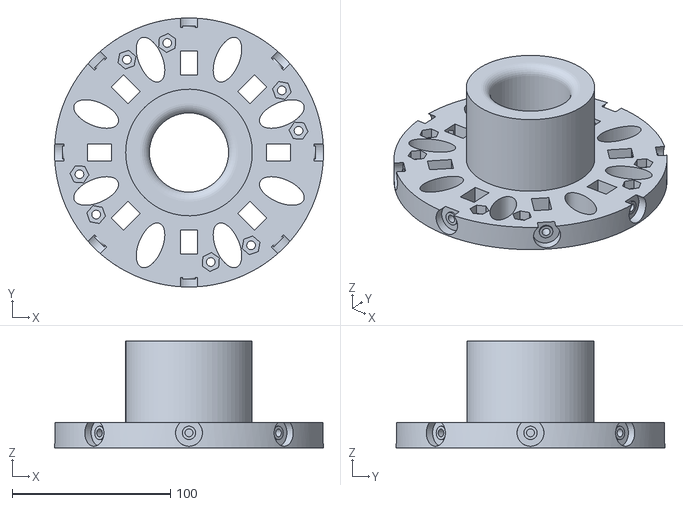
[picture p193: CAD file, 2026-09-06]
Cults3d_v5/2-axis1/axis1-baseHolder.stl
170.0 x 170.0 x 67.5
