cbiele/CyBot/Cults3d_v5/3-axis2/axis2-GT2-encoder.stl

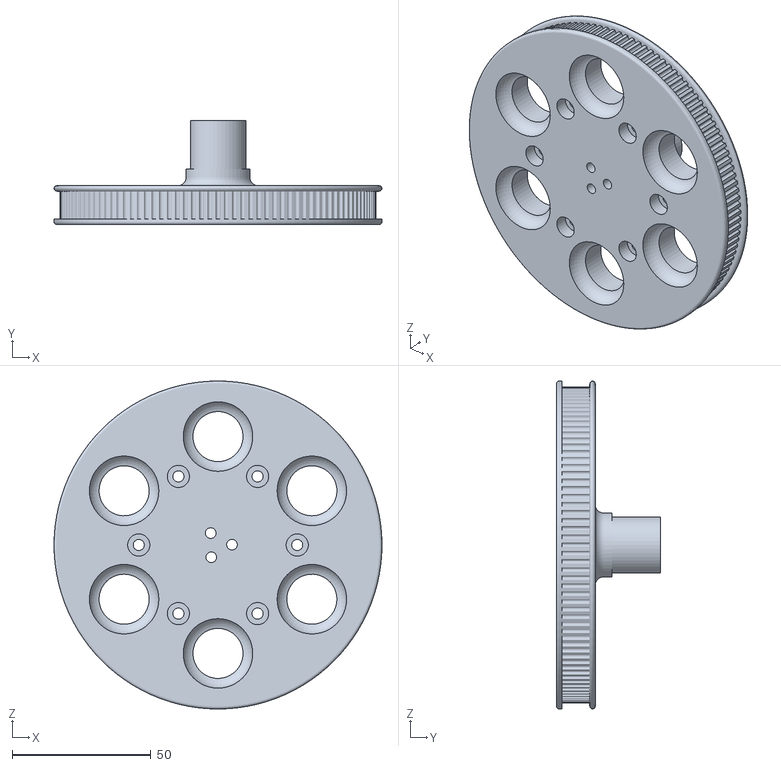
[picture p194: CAD file, 2026-09-06]
Cults3d_v5/3-axis2/axis2-GT2-encoder.stl
118.0 x 37.5 x 118.0
