cbiele/CyBot/Cults3d_v5/4-axis3/axis3-holder1.stl

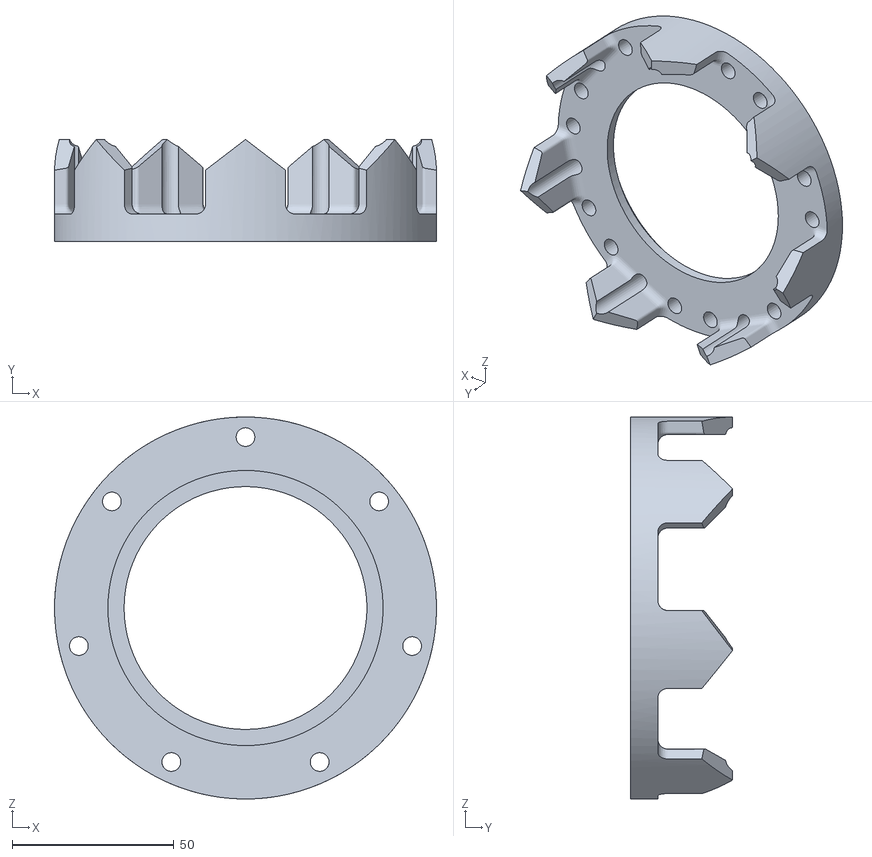
[picture p195: CAD file, 2026-09-06]
Cults3d_v5/4-axis3/axis3-holder1.stl
118.0 x 31.5 x 118.0
