cbiele/CyBot/Cults3d_v5/5-axis4/axis4_shaft3.stl

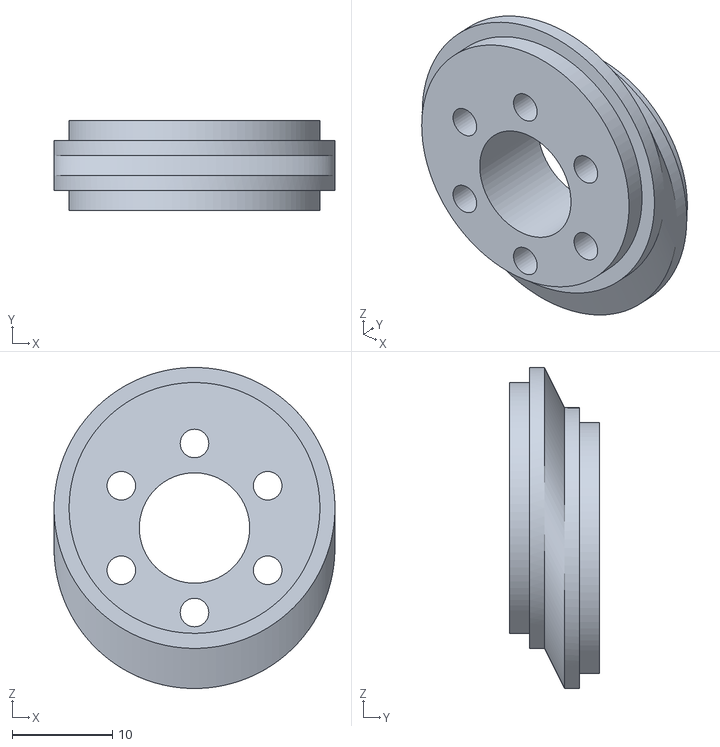
[picture p196: CAD file, 2026-09-06]
Cults3d_v5/5-axis4/axis4_shaft3.stl
28.0 x 9.00 x 32.0
