cbiele/CyBot/model/axis2/axis2-pulley-30T.stl

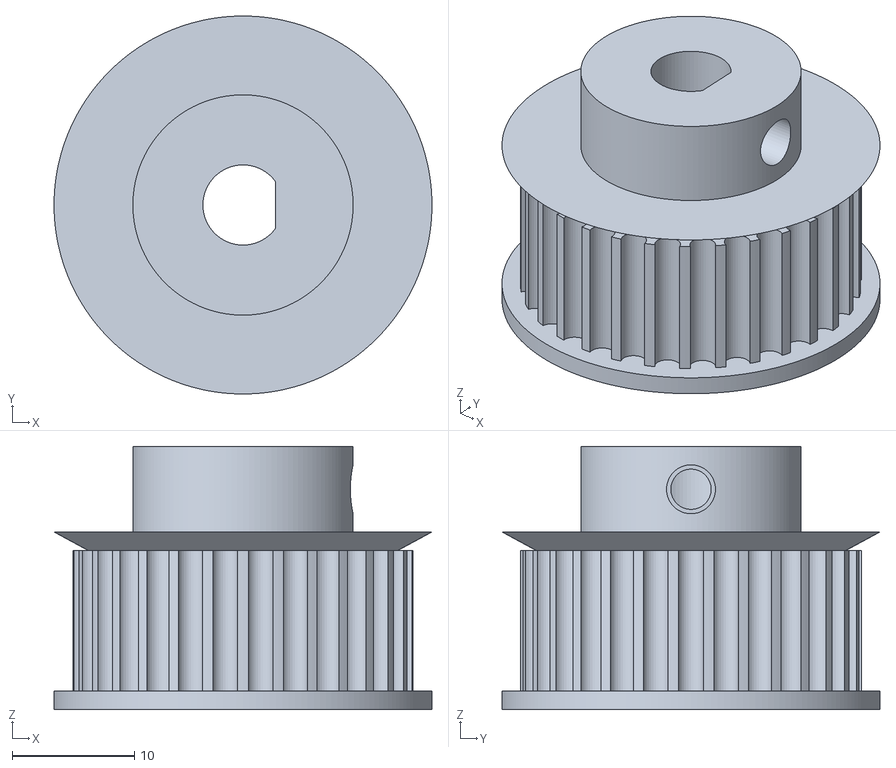
[picture p198: CAD file, 2026-10-26]
model/axis2/axis2-pulley-30T.stl
30.9 x 30.9 x 21.5
