cbiele/CyBot/model/base/spider-arm.stl

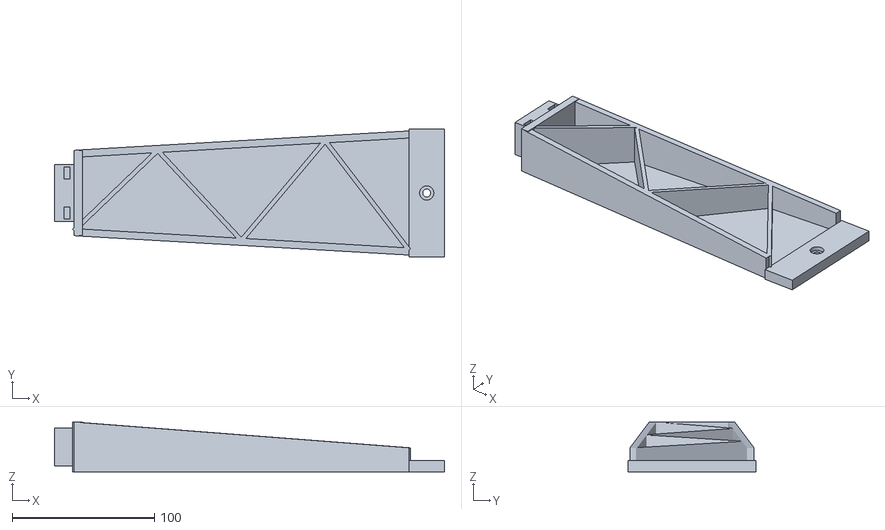
[picture p199: CAD file, 2026-09-24]
model/base/spider-arm.stl
273.7 x 90.0 x 35.0
