cbiele/CyBot/model/cycloid-poc/20-1-compact/housing-front.stl

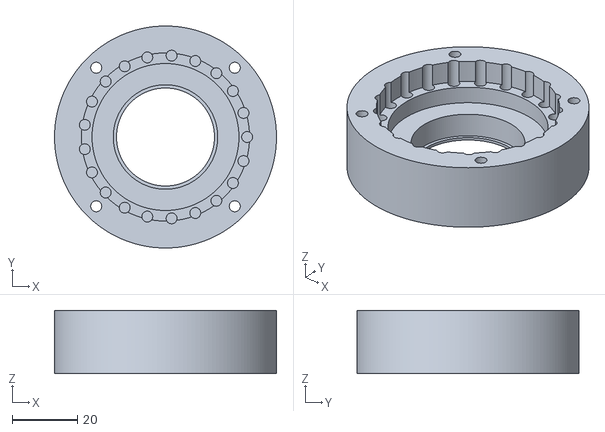
[picture p200: CAD file, 2026-11-05]
model/cycloid-poc/20-1-compact/housing-front.stl
68.0 x 68.0 x 19.3
