cbiele/CyBot/model/cycloid-poc/cycloid-hollow-eccentric.stl

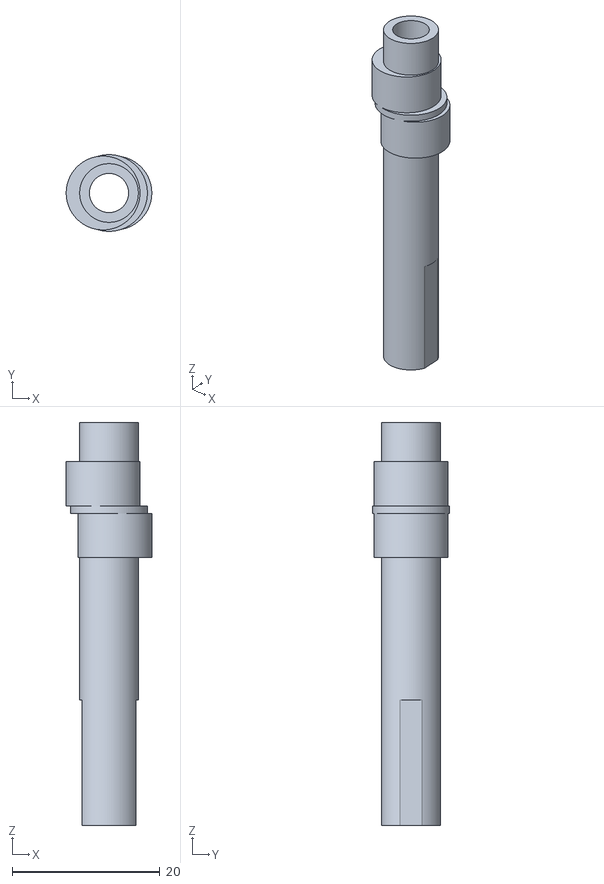
[picture p201: CAD file, 2026-10-28]
model/cycloid-poc/cycloid-hollow-eccentric.stl
11.6 x 10.4 x 54.6
