cbiele/CyBot/model/cycloid-poc/test-parts/fit-coupon-holes.stl

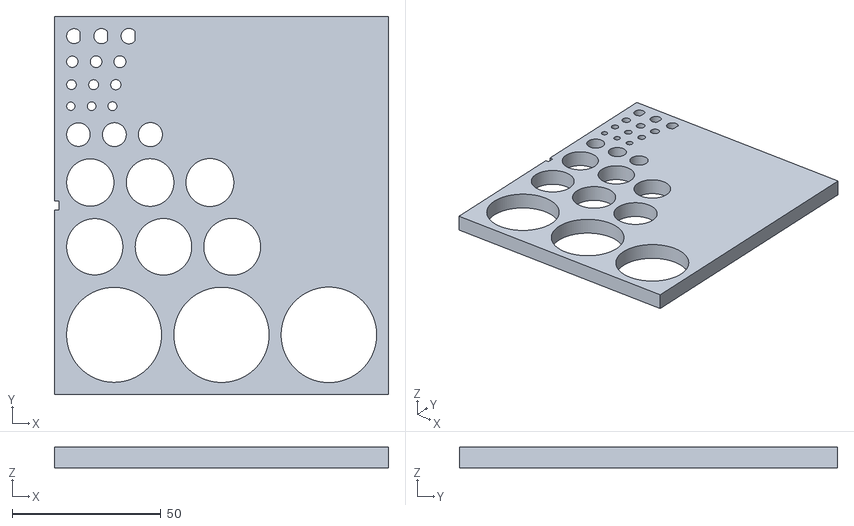
[picture p202: CAD file, 2026-10-28]
model/cycloid-poc/test-parts/fit-coupon-holes.stl
112.3 x 127.1 x 7.00
