cbiele/CyBot/model/hand/palm-whiffletree-bar.stl

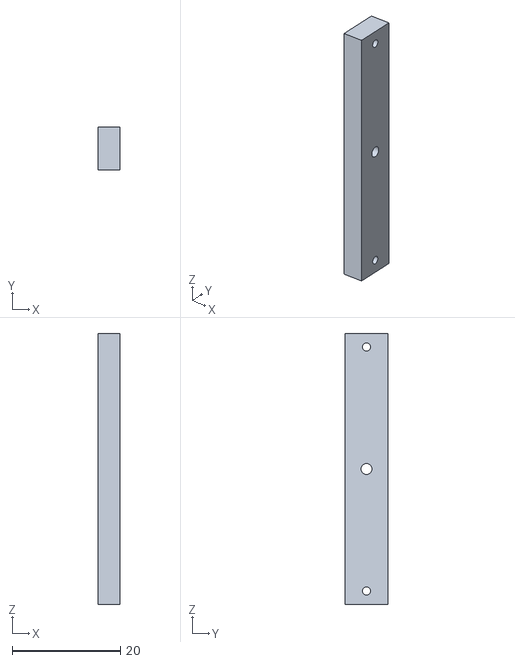
[picture p203: CAD file, 2026-09-24]
model/hand/palm-whiffletree-bar.stl
4.00 x 8.00 x 50.0
