cbiele/CyBot/quartit/cybot-6-axis-robot-arm-cycloidal-gearbox-drive-actuator-in-progress/exentricShaft4.3mf

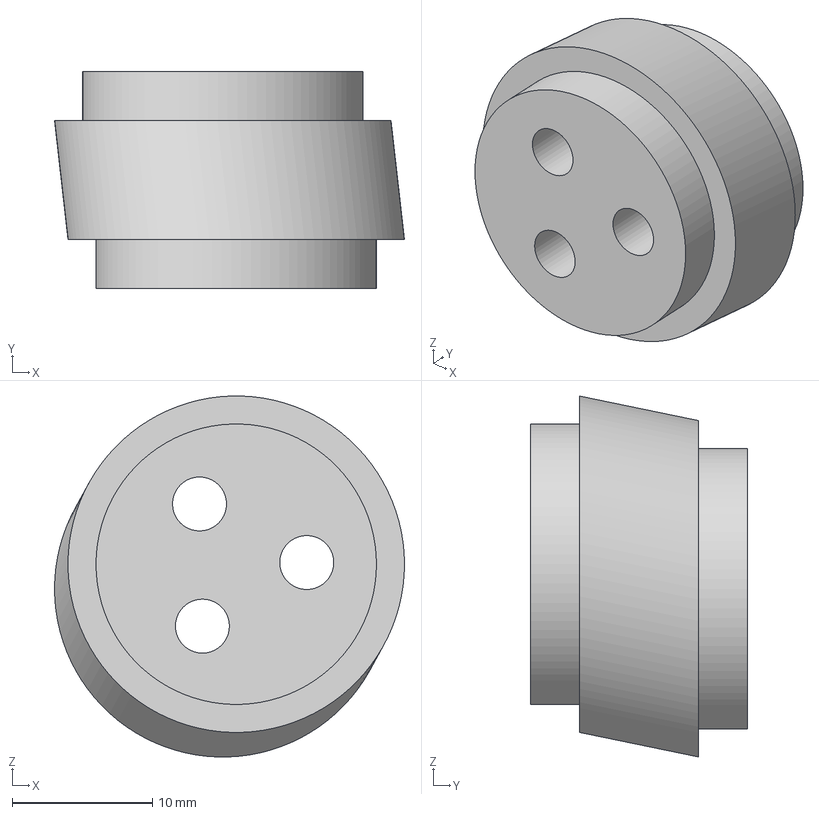
[picture p204: CAD file, 2026-09-06]
quartit/cybot-6-axis-robot-arm-cycloidal-gearbox-drive-actuator-in-progress/exentricShaft4.3mf
25.0 x 15.5 x 25.7 mm
