cbiele/CyBot/URDF/link_1.stl

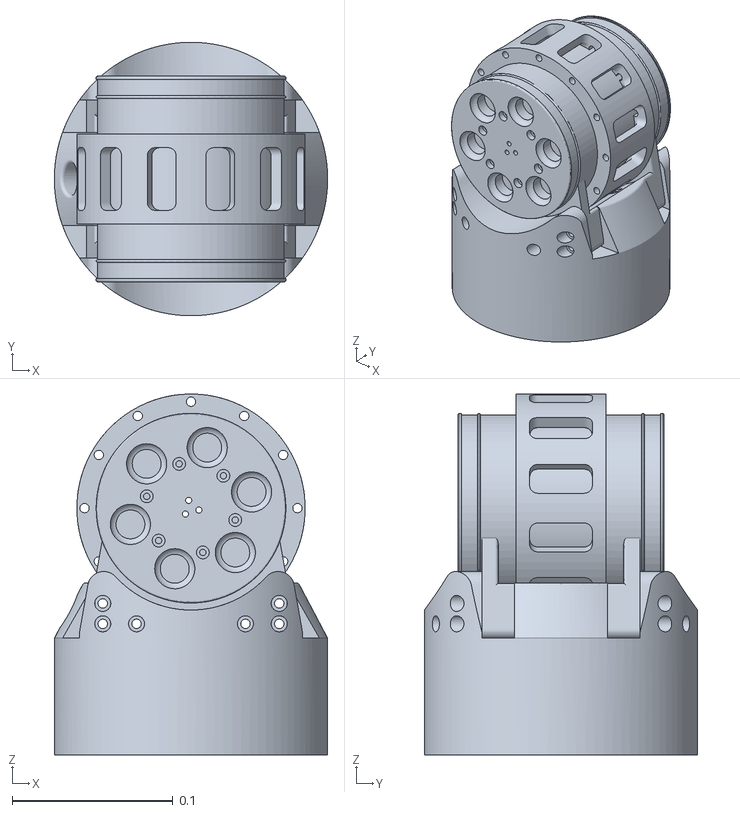
[picture p205: CAD file, 2026-09-06]
URDF/link_1.stl
0.17 x 0.17 x 0.224
