cbiele/CyBot/4FingersGripper/grip.stl

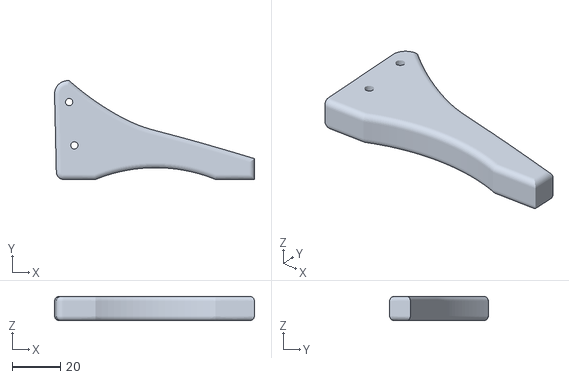
[picture p206: CAD file, 2026-09-06]
4FingersGripper/grip.stl
82.6 x 40.8 x 10.0
