cbiele/CyBot/Cults3d_v5/2-axis1/axis1-stepperHolder.stl

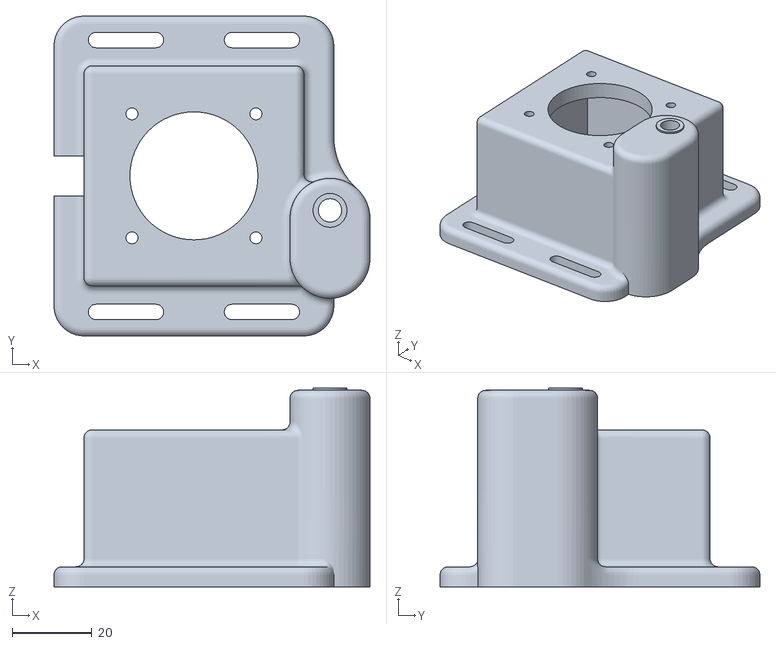
[picture p207: CAD file, 2026-09-06]
Cults3d_v5/2-axis1/axis1-stepperHolder.stl
79.0 x 80.0 x 49.7
