cbiele/CyBot/Cults3d_v5/3-axis2/axis2-disk1.stl

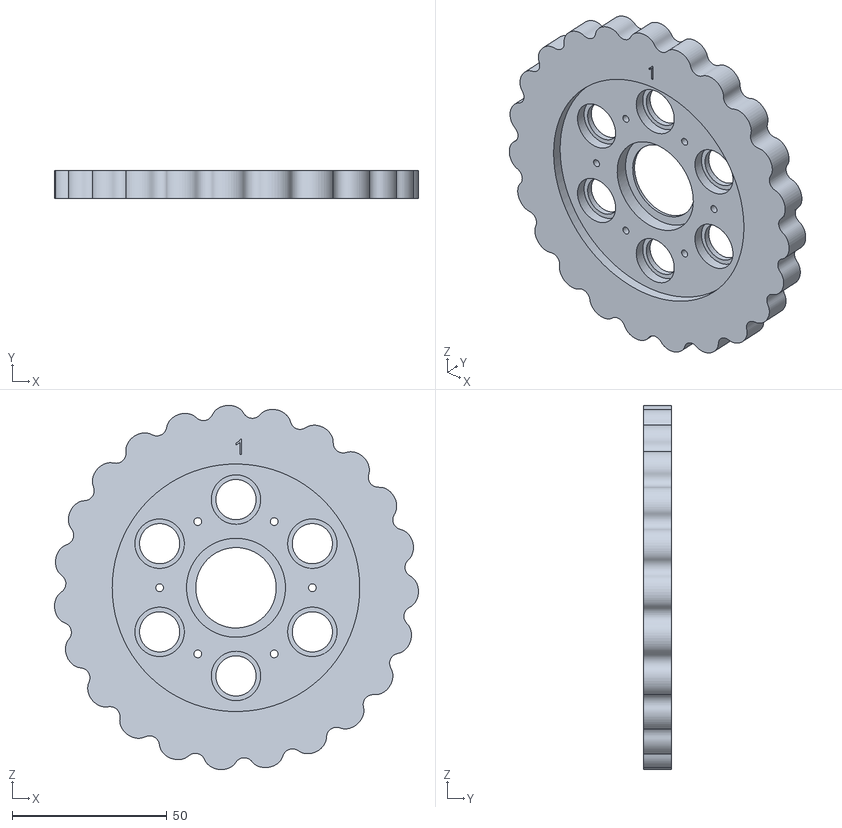
[picture p208: CAD file, 2026-09-06]
Cults3d_v5/3-axis2/axis2-disk1.stl
117.6 x 9.00 x 117.7
