cbiele/CyBot/Cults3d_v5/4-axis3/axis3-OPH1.stl

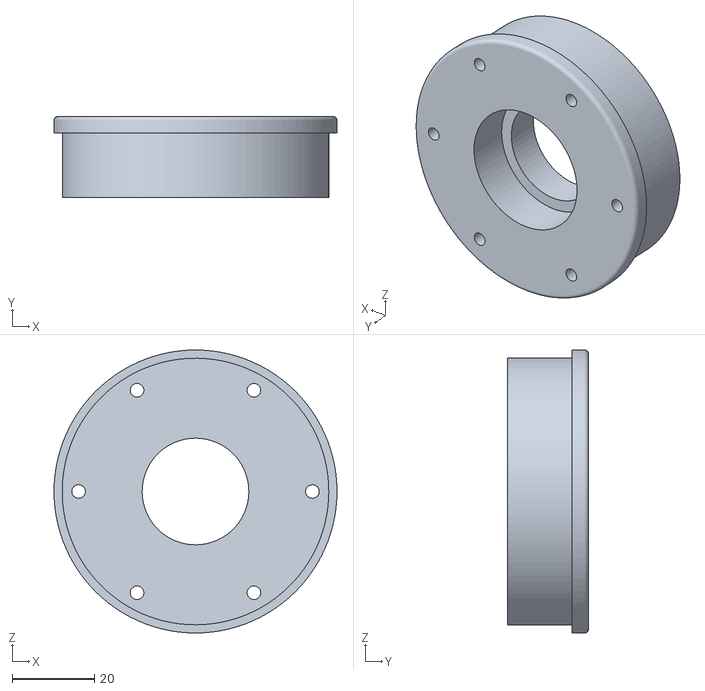
[picture p209: CAD file, 2026-09-06]
Cults3d_v5/4-axis3/axis3-OPH1.stl
69.0 x 19.8 x 69.0
