cbiele/CyBot/Cults3d_v5/5-axis4/axis4_disk2.stl

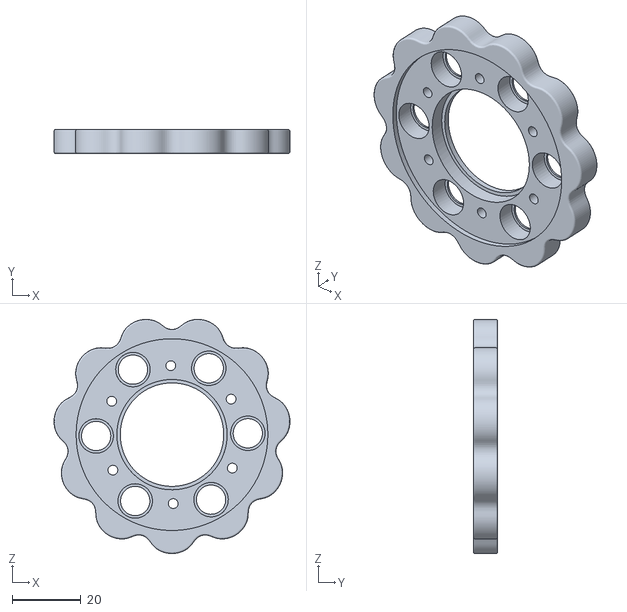
[picture p210: CAD file, 2026-09-06]
Cults3d_v5/5-axis4/axis4_disk2.stl
68.5 x 7.00 x 67.9
