cbiele/CyBot/Cults3d_v5/6-axis5-6/axis5-pulleySpacer.stl

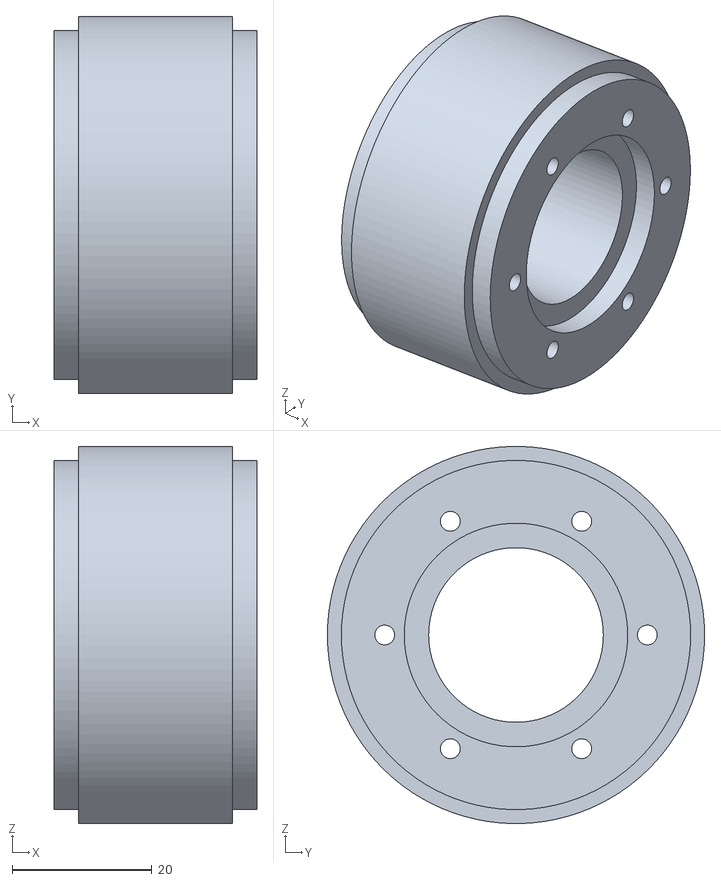
[picture p211: CAD file, 2026-09-06]
Cults3d_v5/6-axis5-6/axis5-pulleySpacer.stl
29.0 x 54.0 x 54.0
