cbiele/CyBot/model/base/spider-arm-motor.stl

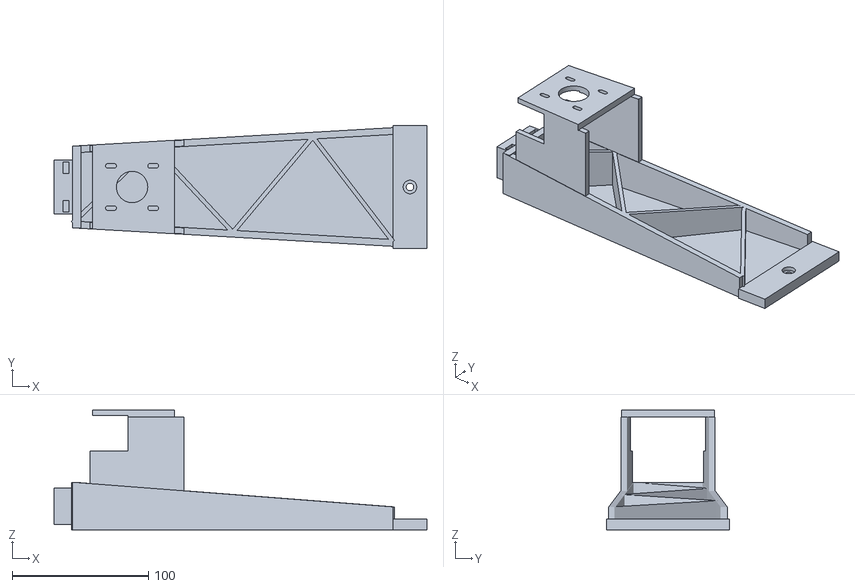
[picture p212: CAD file, 2026-09-24]
model/base/spider-arm-motor.stl
273.7 x 90.0 x 88.0
