cbiele/CyBot/model/cycloid-poc/cycloid-hollow-carrier-front.stl

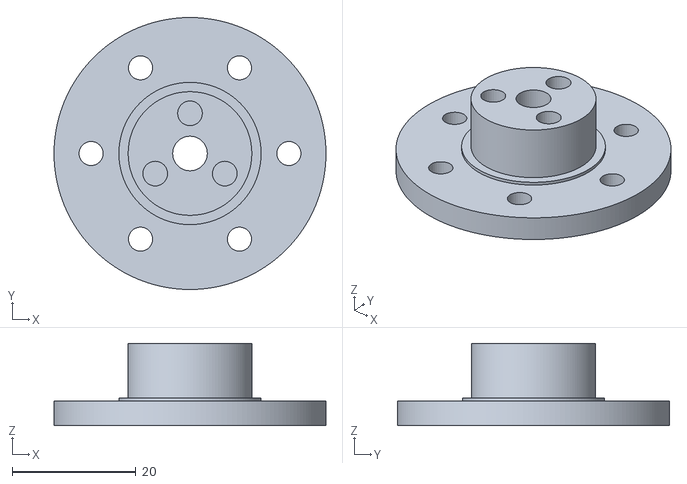
[picture p213: CAD file, 2026-10-28]
model/cycloid-poc/cycloid-hollow-carrier-front.stl
44.0 x 44.0 x 13.3
