cbiele/CyBot/model/cycloid-poc/test-parts/test-arm.stl

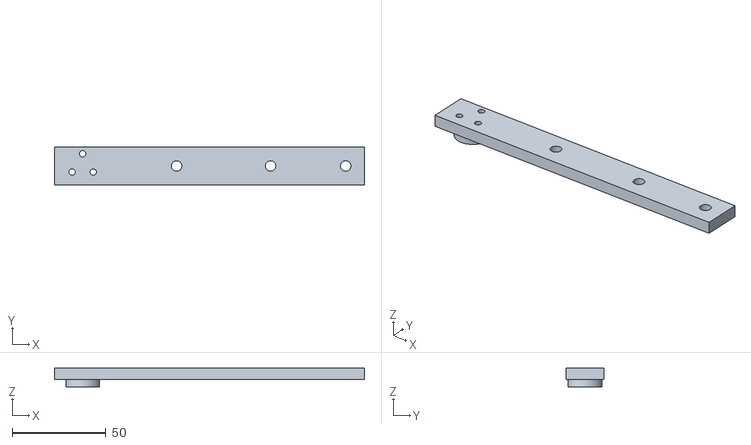
[picture p214: CAD file, 2026-10-28]
model/cycloid-poc/test-parts/test-arm.stl
165.0 x 20.0 x 10.0
