cbiele/CyBot/model/hand/palm-front.stl

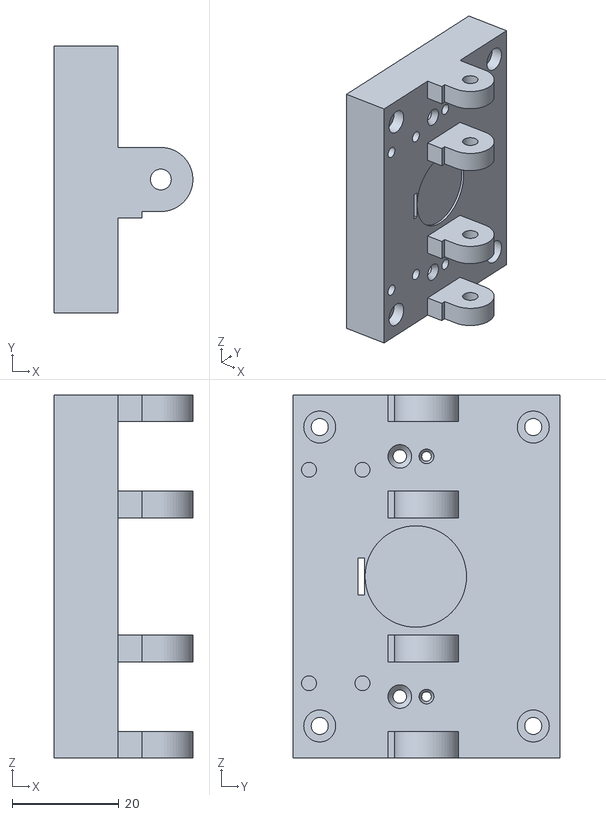
[picture p215: CAD file, 2026-09-24]
model/hand/palm-front.stl
26.0 x 50.0 x 68.0
