cbiele/CyBot/quartit/cybot-6-axis-robot-arm-cycloidal-gearbox-drive-actuator-in-progress/exentricShaft2.3mf

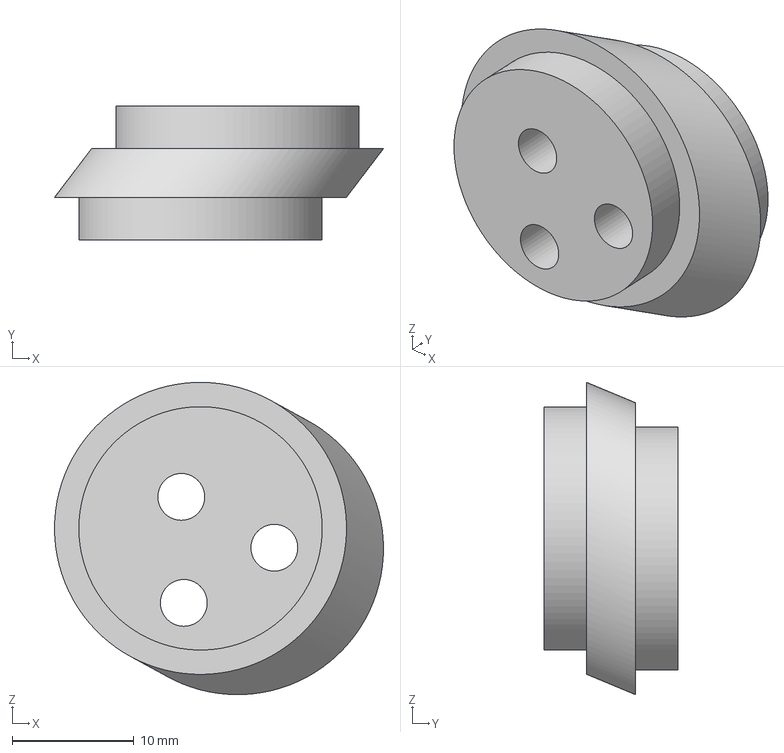
[picture p216: CAD file, 2026-09-06]
quartit/cybot-6-axis-robot-arm-cycloidal-gearbox-drive-actuator-in-progress/exentricShaft2.3mf
27.0 x 11.0 x 25.7 mm
