cbiele/CyBot/URDF/link_3.stl

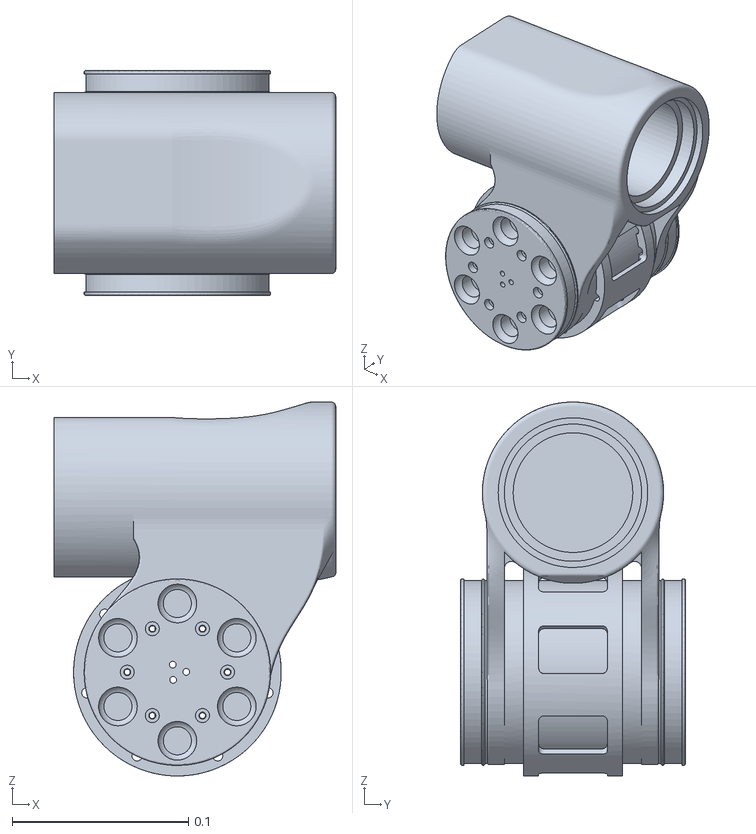
[picture p217: CAD file, 2026-09-06]
URDF/link_3.stl
0.16 x 0.128 x 0.212
