cbiele/CyBot/4FingersGripper/OPH_To_Gripper.stl

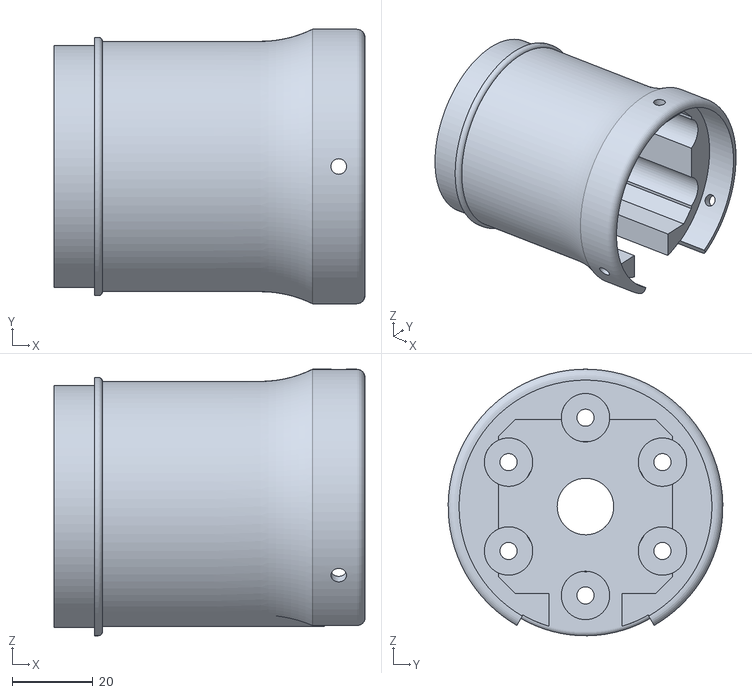
[picture p218: CAD file, 2026-09-06]
4FingersGripper/OPH_To_Gripper.stl
77.0 x 68.0 x 66.0
