cbiele/CyBot/Cults3d_v5/1-mainbody/beltTentioner3.stl

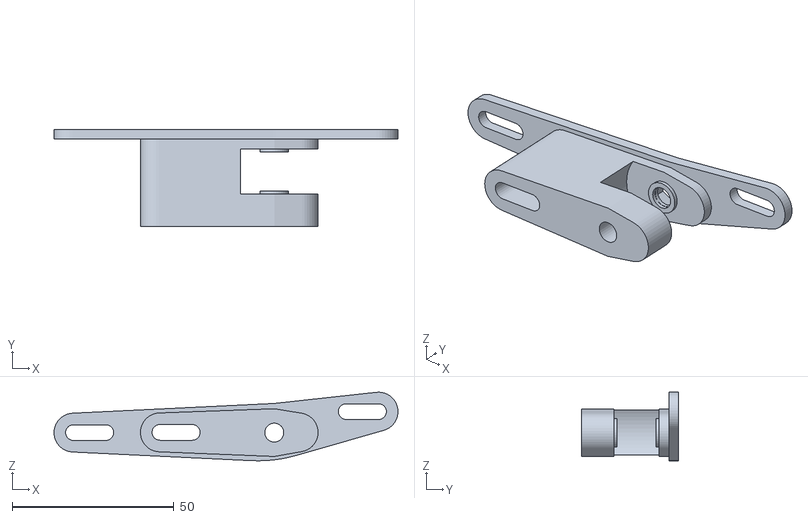
[picture p219: CAD file, 2026-09-06]
Cults3d_v5/1-mainbody/beltTentioner3.stl
106.2 x 30.0 x 21.2
