cbiele/CyBot/Cults3d_v5/2-axis1/axis-1-rotatingBase2.stl

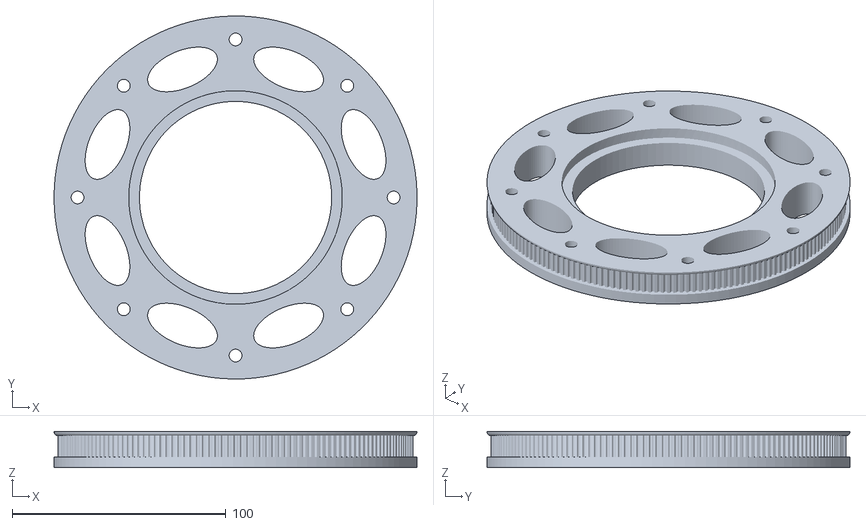
[picture p220: CAD file, 2026-09-06]
Cults3d_v5/2-axis1/axis-1-rotatingBase2.stl
170.0 x 170.0 x 17.0
