cbiele/CyBot/Cults3d_v5/3-axis2/axis2-diskCap.stl

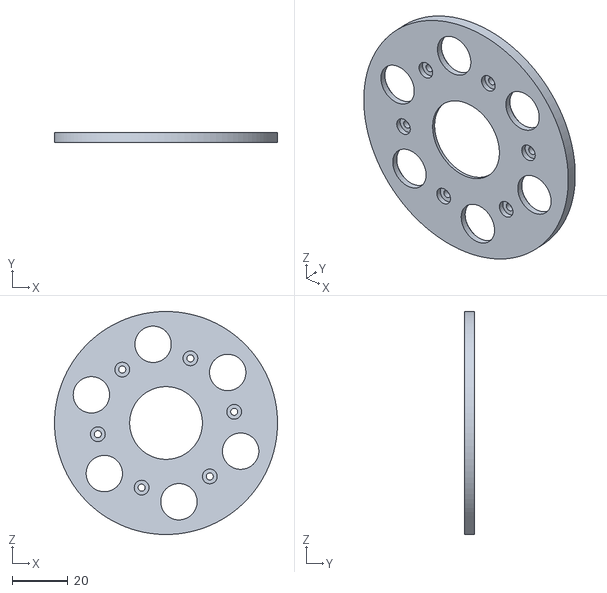
[picture p221: CAD file, 2026-09-06]
Cults3d_v5/3-axis2/axis2-diskCap.stl
79.7 x 3.50 x 79.7
