cbiele/CyBot/Cults3d_v5/5-axis4/axis4_shaft2.stl

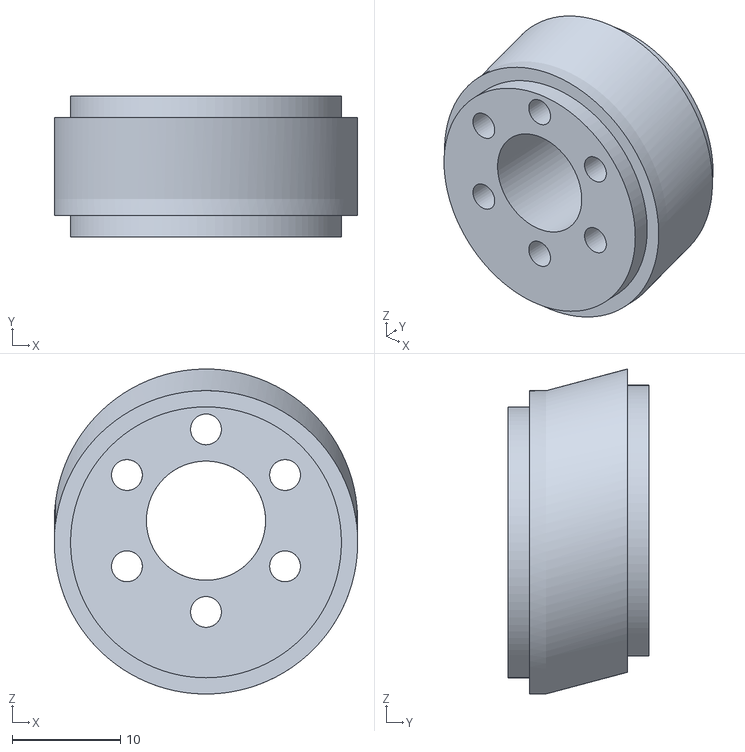
[picture p222: CAD file, 2026-09-06]
Cults3d_v5/5-axis4/axis4_shaft2.stl
28.0 x 13.0 x 30.0
