cbiele/CyBot/Cults3d_v5/6-axis5-6/axis5-pulley.stl

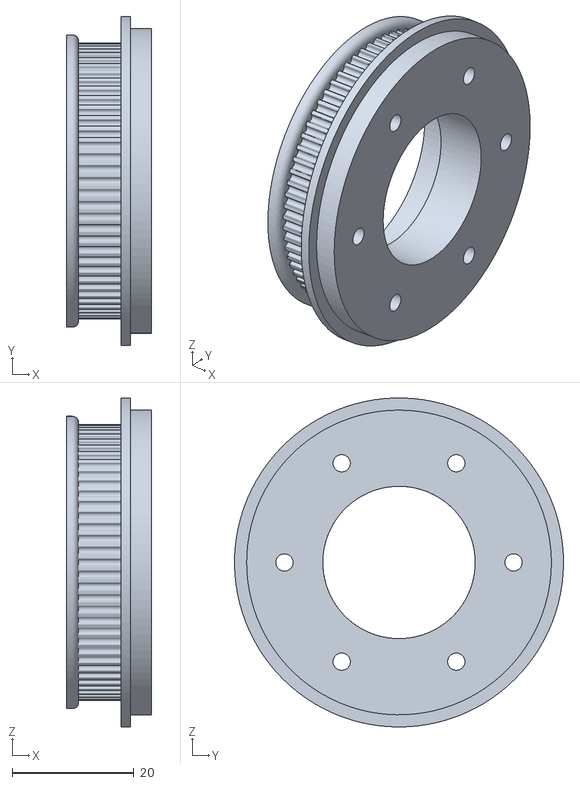
[picture p223: CAD file, 2026-09-06]
Cults3d_v5/6-axis5-6/axis5-pulley.stl
14.0 x 54.0 x 54.0
