cbiele/CyBot/model/base/spider-ring.stl

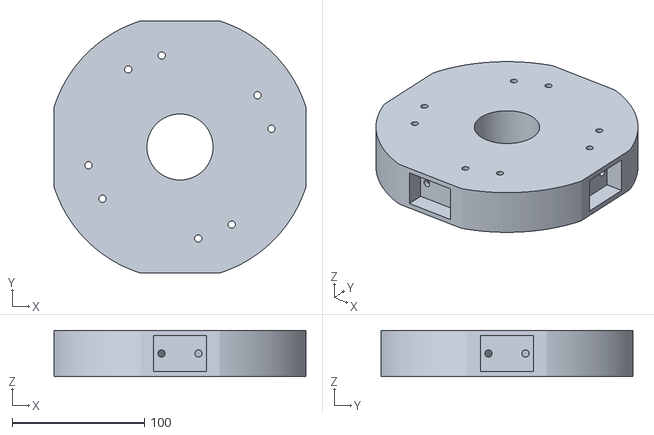
[picture p224: CAD file, 2026-09-24]
model/base/spider-ring.stl
190.8 x 190.8 x 35.0
