cbiele/CyBot/model/hand/finger-fixture.stl

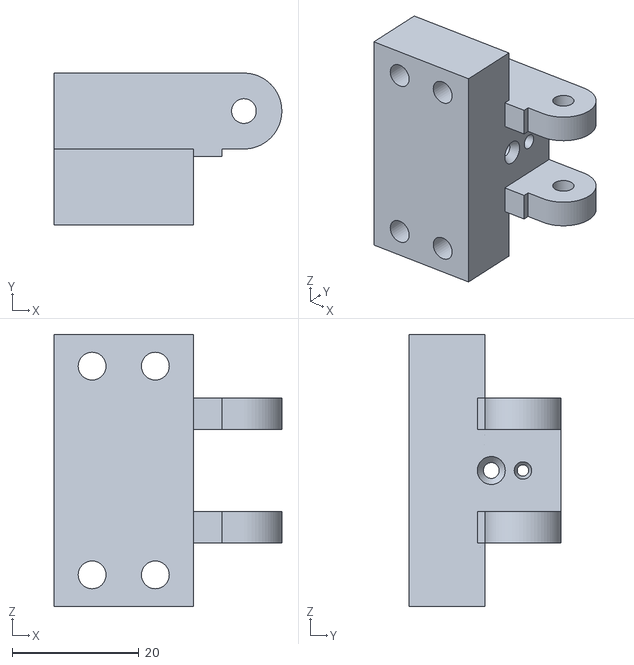
[picture p225: CAD file, 2026-09-24]
model/hand/finger-fixture.stl
36.0 x 24.0 x 43.0
