cbiele/CyBot/URDF/link_5.stl

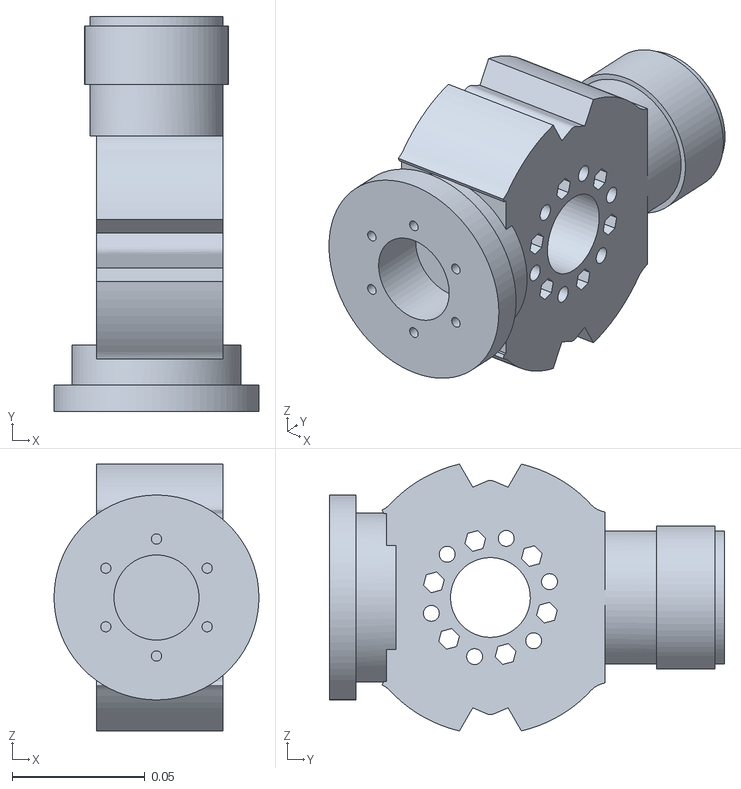
[picture p226: CAD file, 2026-09-06]
URDF/link_5.stl
0.077 x 0.148 x 0.1
