cbiele/CyBot/Cults3d_v5/1-mainbody/plateBall.stl

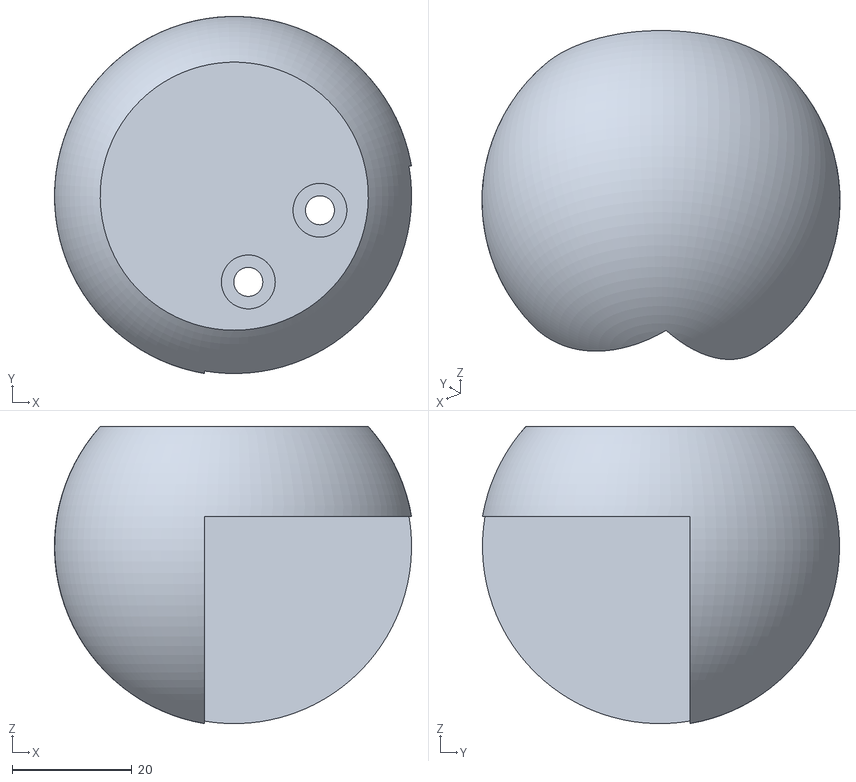
[picture p227: CAD file, 2026-09-06]
Cults3d_v5/1-mainbody/plateBall.stl
59.6 x 59.6 x 49.6
