cbiele/CyBot/Cults3d_v5/2-axis1/axis-1-rotatingBase3.stl

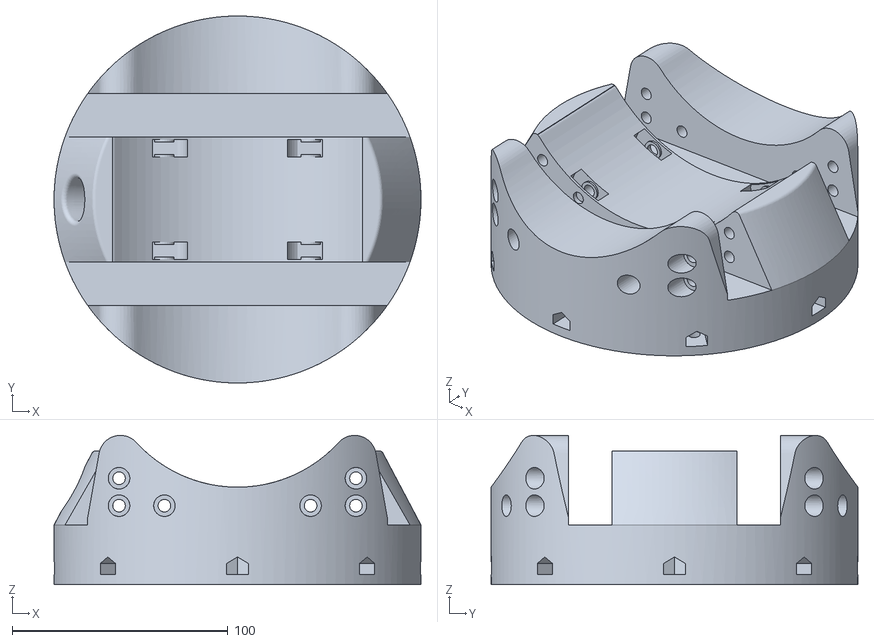
[picture p228: CAD file, 2026-09-06]
Cults3d_v5/2-axis1/axis-1-rotatingBase3.stl
170.0 x 170.0 x 69.1
