cbiele/CyBot/Cults3d_v5/3-axis2/axis2-OPH2.stl

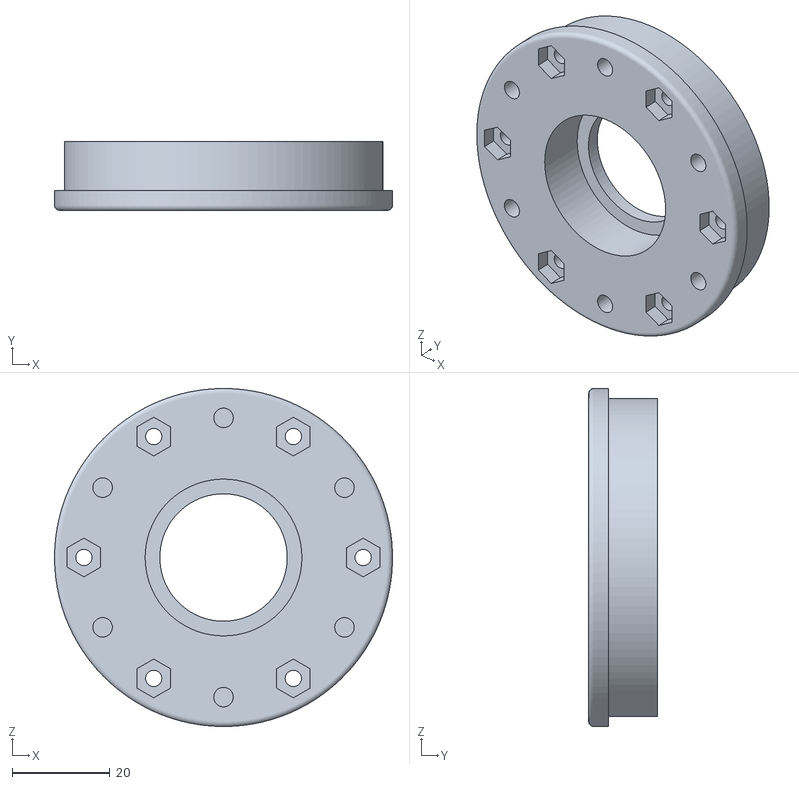
[picture p229: CAD file, 2026-09-06]
Cults3d_v5/3-axis2/axis2-OPH2.stl
69.0 x 14.0 x 69.0
