cbiele/CyBot/Cults3d_v5/4-axis3/axis3-GT2-stepper.stl

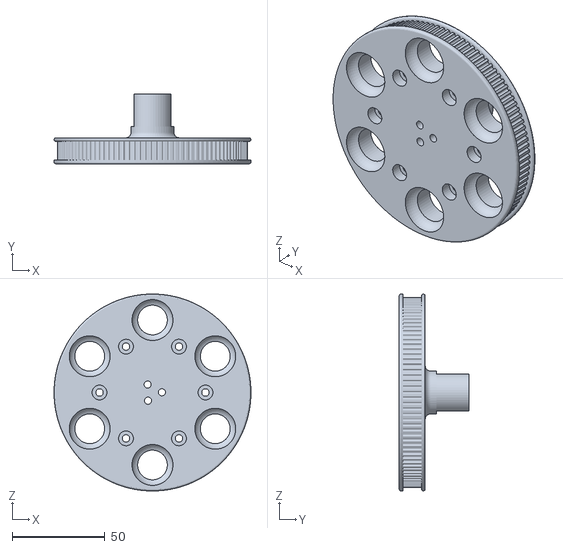
[picture p230: CAD file, 2026-09-06]
Cults3d_v5/4-axis3/axis3-GT2-stepper.stl
106.0 x 37.5 x 106.0
