cbiele/CyBot/Cults3d_v5/6-axis5-6/axis5-quarterTurnBeltDrive.stl

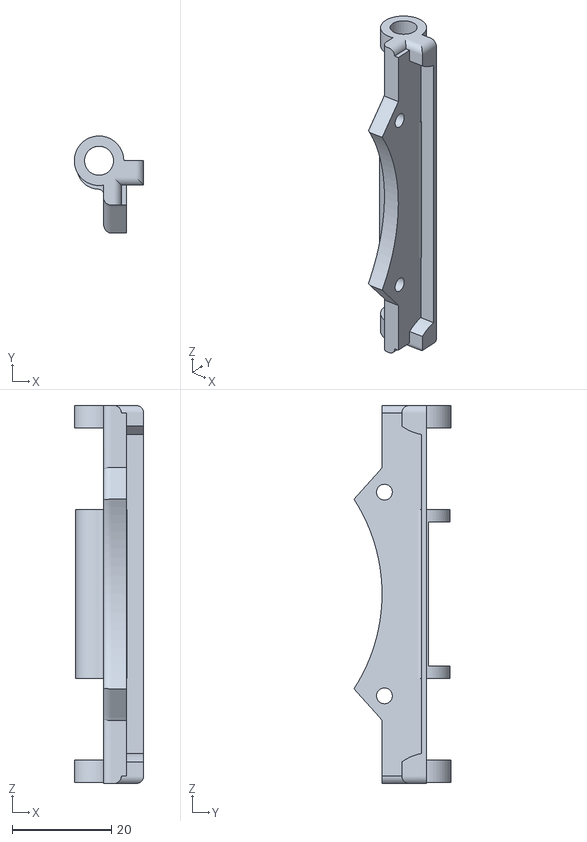
[picture p231: CAD file, 2026-09-06]
Cults3d_v5/6-axis5-6/axis5-quarterTurnBeltDrive.stl
14.0 x 19.6 x 76.2
