cbiele/CyBot/model/base/spider-pad.stl

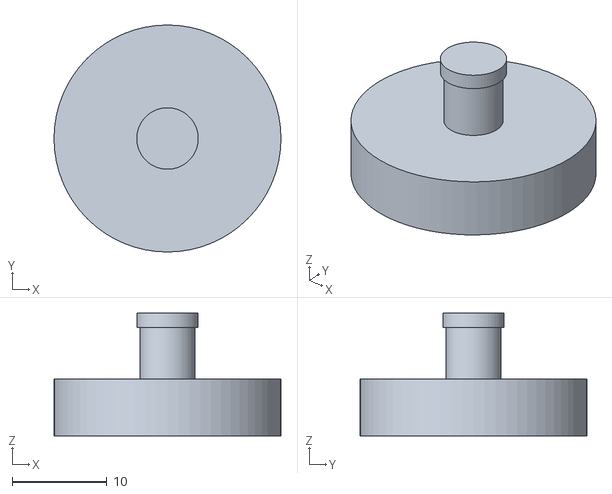
[picture p232: CAD file, 2026-09-24]
model/base/spider-pad.stl
24.0 x 24.0 x 13.0
