cbiele/CyBot/model/cycloid-poc/20-1-compact/eccentric.stl

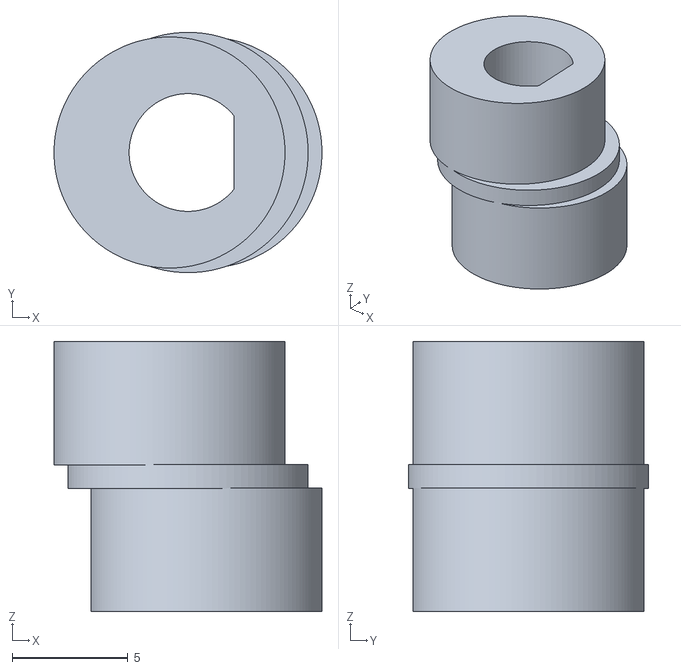
[picture p233: CAD file, 2026-10-29]
model/cycloid-poc/20-1-compact/eccentric.stl
11.6 x 10.4 x 11.7
