cbiele/CyBot/model/cycloid-poc/20-1-hollow/motor-mount.stl

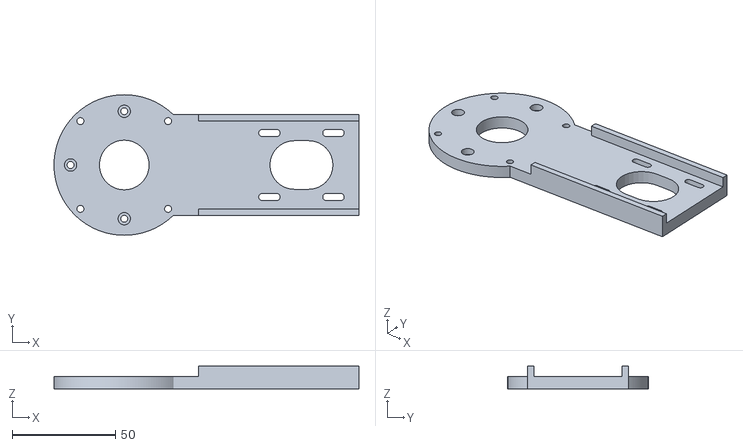
[picture p234: CAD file, 2026-10-28]
model/cycloid-poc/20-1-hollow/motor-mount.stl
147.6 x 68.0 x 11.0
