cbiele/CyBot/model/hand/finger-pad-proximal.stl

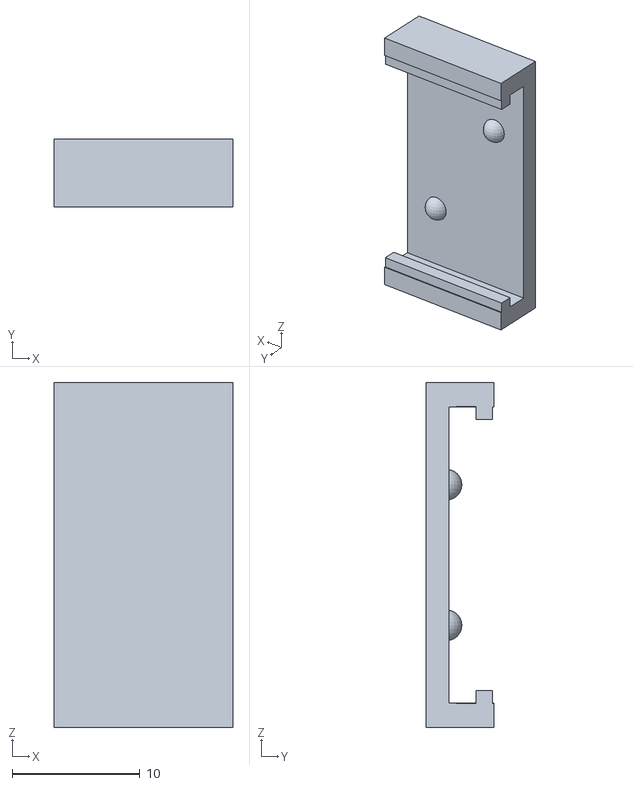
[picture p235: CAD file, 2026-09-24]
model/hand/finger-pad-proximal.stl
14.0 x 5.30 x 27.0
