cbiele/CyBot/quartit/cybot-6-axis-robot-arm-cycloidal-gearbox-drive-actuator-in-progress/exentricShaft3.3mf

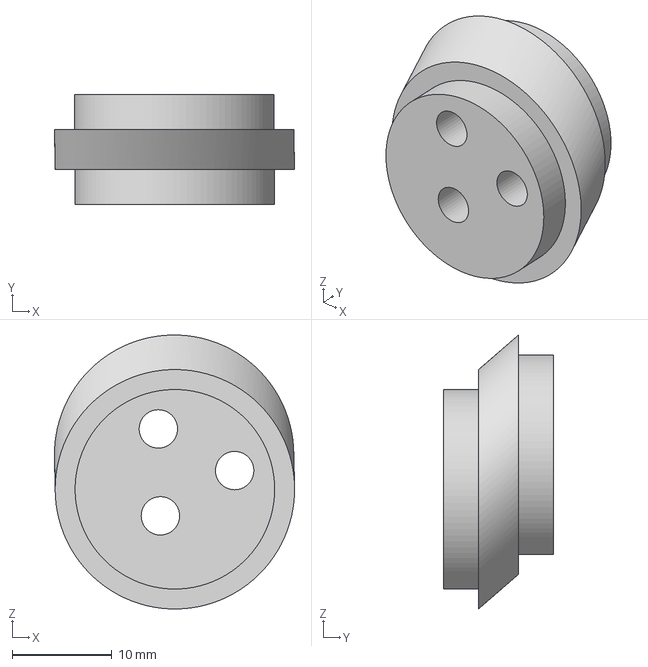
[picture p236: CAD file, 2026-09-06]
quartit/cybot-6-axis-robot-arm-cycloidal-gearbox-drive-actuator-in-progress/exentricShaft3.3mf
24.1 x 11.0 x 27.5 mm
