cbiele/CyBot/URDF/link_2.stl

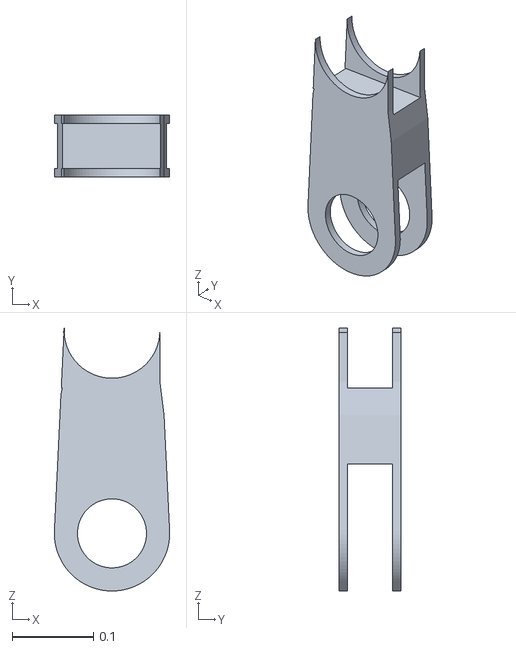
[picture p237: CAD file, 2026-09-06]
URDF/link_2.stl
0.142 x 0.076 x 0.324
