cbiele/CyBot/4FingersGripper/T8_to_Axes.stl

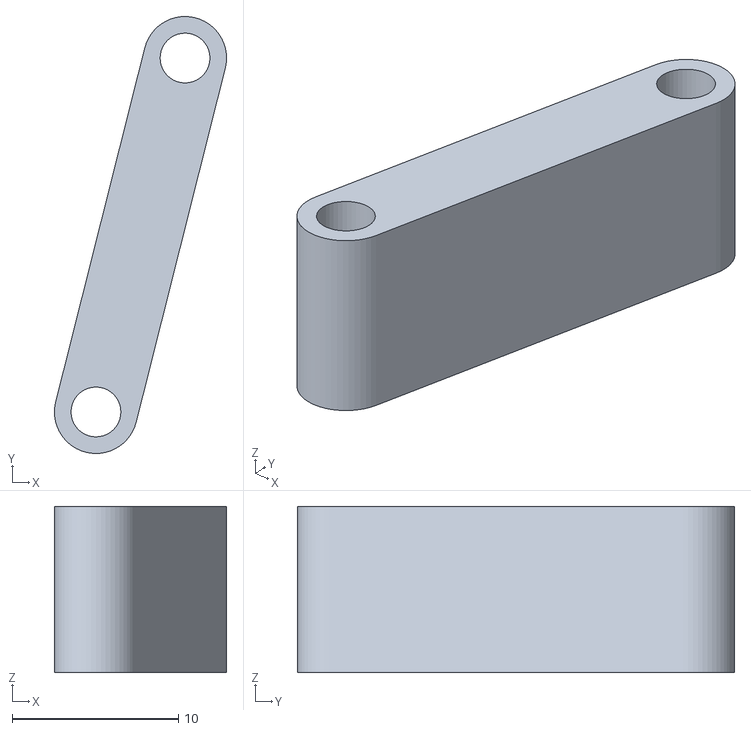
[picture p238: CAD file, 2026-09-06]
4FingersGripper/T8_to_Axes.stl
10.4 x 26.3 x 10.0
