cbiele/CyBot/Cults3d_v5/2-axis1/axis1-encoderHolder.stl

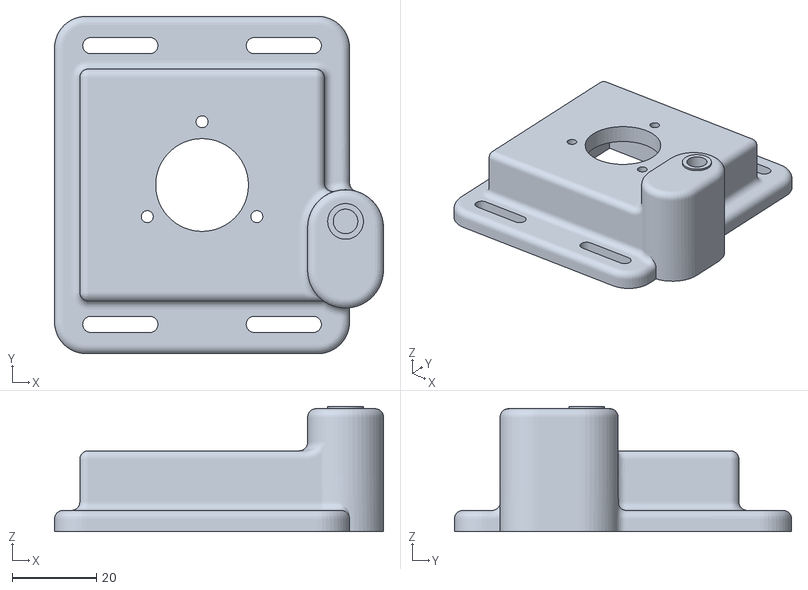
[picture p239: CAD file, 2026-09-06]
Cults3d_v5/2-axis1/axis1-encoderHolder.stl
78.0 x 80.0 x 29.7
