cbiele/CyBot/Cults3d_v5/4-axis3/axis3-holder2.stl

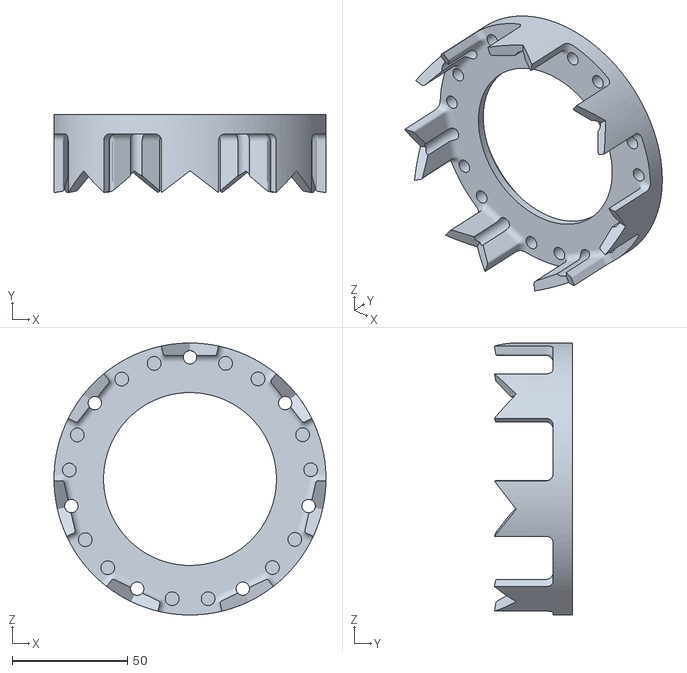
[picture p240: CAD file, 2026-09-06]
Cults3d_v5/4-axis3/axis3-holder2.stl
118.0 x 33.9 x 118.0
