cbiele/CyBot/Cults3d_v5/5-axis4/axis4_diskCap.stl

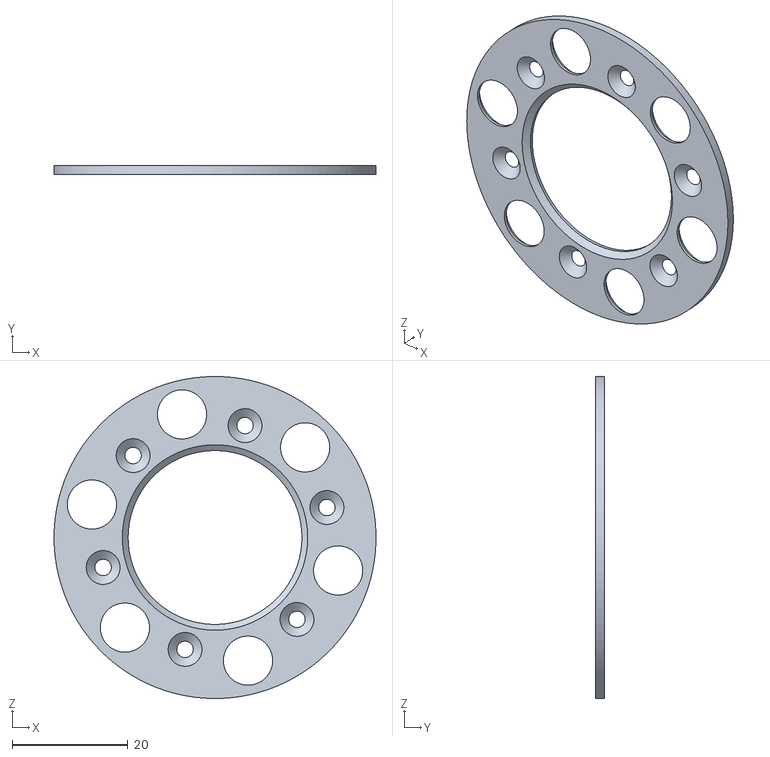
[picture p241: CAD file, 2026-09-06]
Cults3d_v5/5-axis4/axis4_diskCap.stl
55.6 x 1.50 x 55.6
