cbiele/CyBot/Cults3d_v5/6-axis5-6/axis5_Housing2Attach2.stl

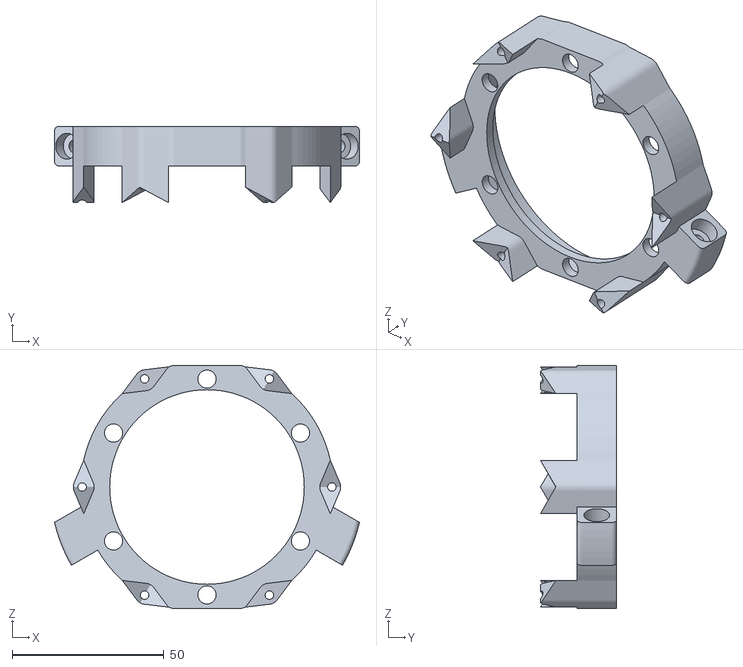
[picture p242: CAD file, 2026-09-06]
Cults3d_v5/6-axis5-6/axis5_Housing2Attach2.stl
100.3 x 25.0 x 80.0
