cbiele/CyBot/model/cycloid-poc/20-1-hollow/motor7-bracket.stl

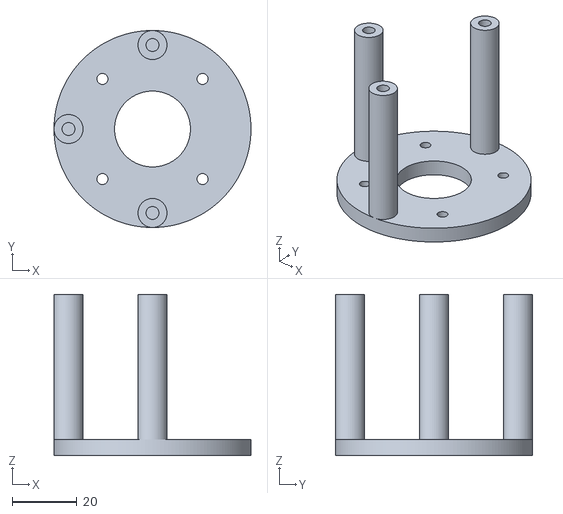
[picture p243: CAD file, 2026-10-28]
model/cycloid-poc/20-1-hollow/motor7-bracket.stl
61.0 x 61.0 x 50.0
