cbiele/CyBot/model/cycloid-poc/disk-b.stl

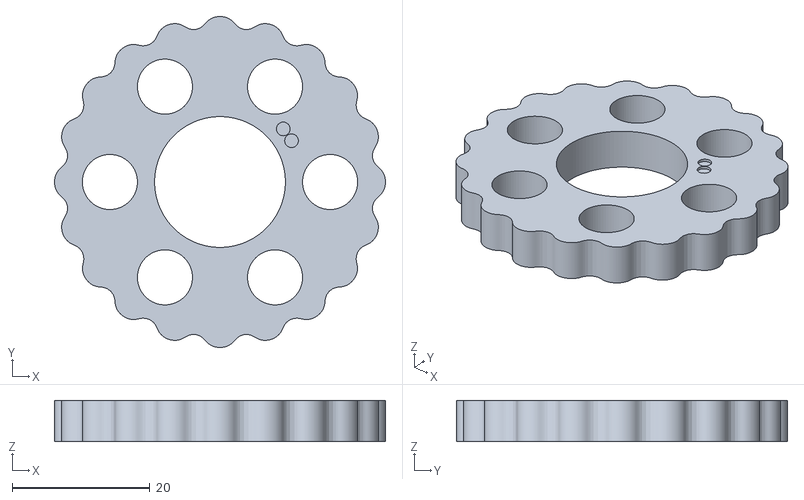
[picture p244: CAD file, 2026-10-25]
model/cycloid-poc/disk-b.stl
48.1 x 48.1 x 6.00
