cbiele/CyBot/model/hand/finger-distal.stl

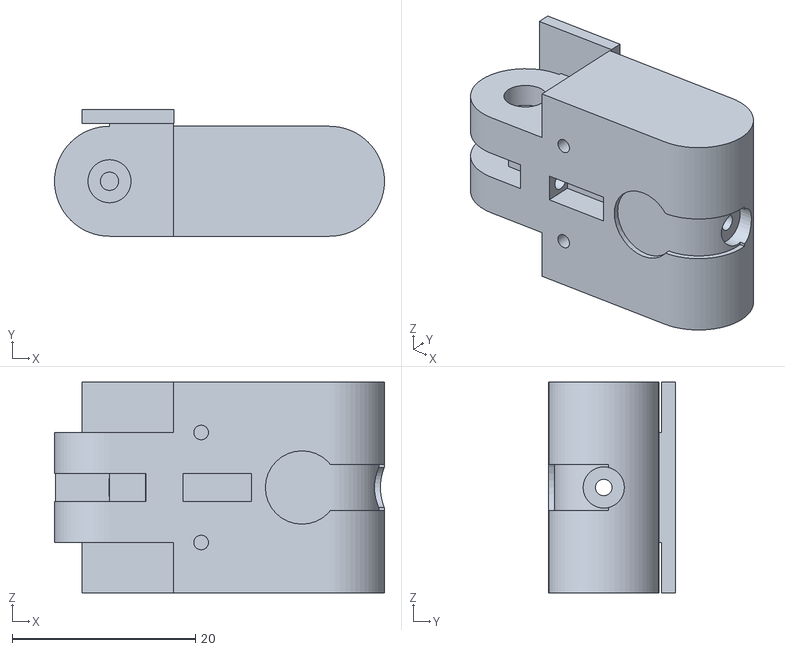
[picture p245: CAD file, 2026-09-24]
model/hand/finger-distal.stl
36.0 x 13.8 x 23.0
