cbiele/CyBot/URDF/base_link.stl

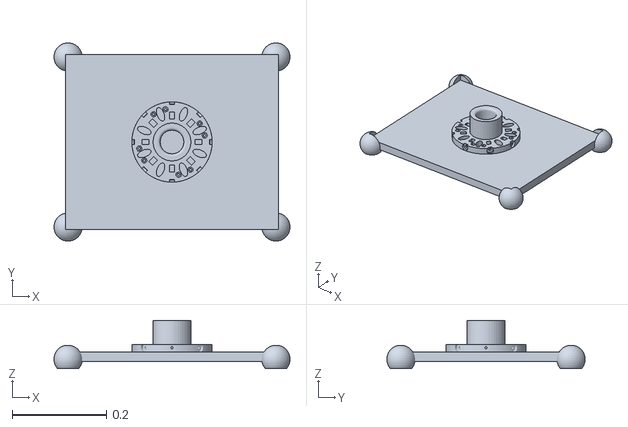
[picture p246: CAD file, 2026-09-06]
URDF/base_link.stl
0.5 x 0.42 x 0.103
