cbiele/CyBot/Cults3d_v5/4-axis3/axis3-GT2-encoder.stl

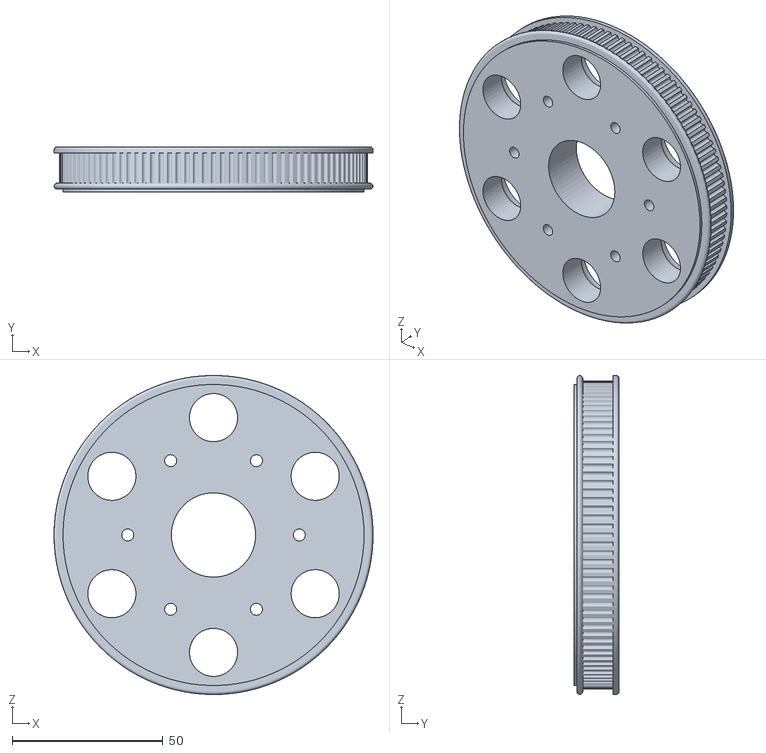
[picture p247: CAD file, 2026-09-06]
Cults3d_v5/4-axis3/axis3-GT2-encoder.stl
106.0 x 15.0 x 106.0
