cbiele/CyBot/Cults3d_v5/5-axis4/axis4_housingNema.stl

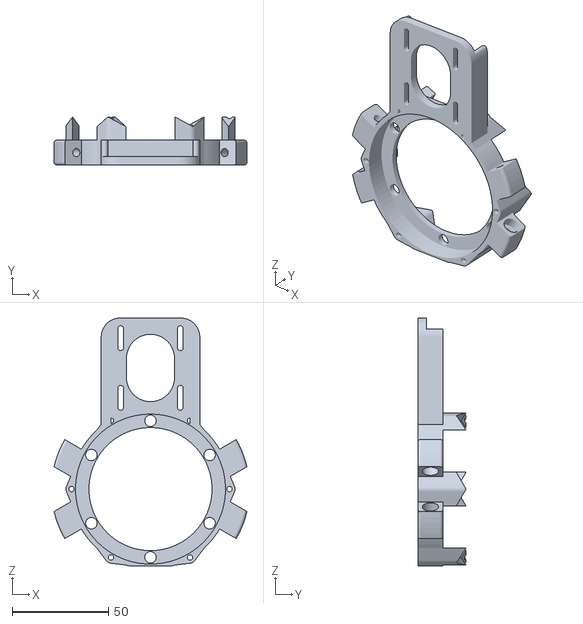
[picture p248: CAD file, 2026-09-06]
Cults3d_v5/5-axis4/axis4_housingNema.stl
100.3 x 25.0 x 129.0
