cbiele/CyBot/model/cycloid-poc/20-1-hollow/pulley-40T.stl

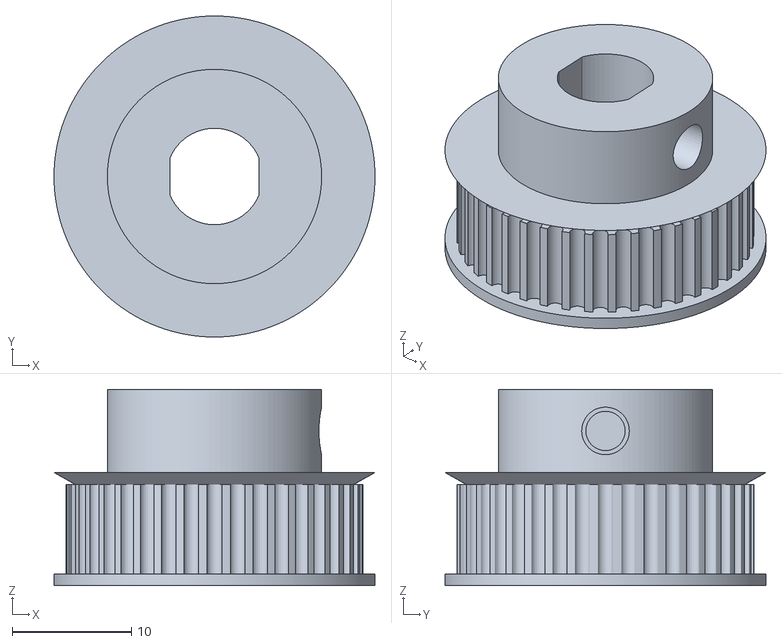
[picture p249: CAD file, 2026-10-28]
model/cycloid-poc/20-1-hollow/pulley-40T.stl
27.0 x 27.0 x 16.5
