cbiele/CyBot/model/cycloid-poc/bench-upright.stl

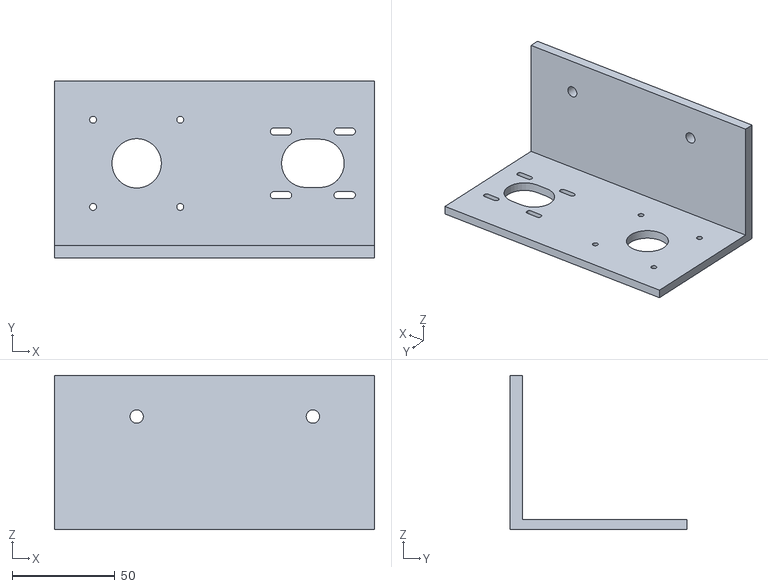
[picture p250: CAD file, 2026-10-25]
model/cycloid-poc/bench-upright.stl
155.8 x 86.0 x 75.0
