cbiele/CyBot/model/hand/finger-proximal.stl

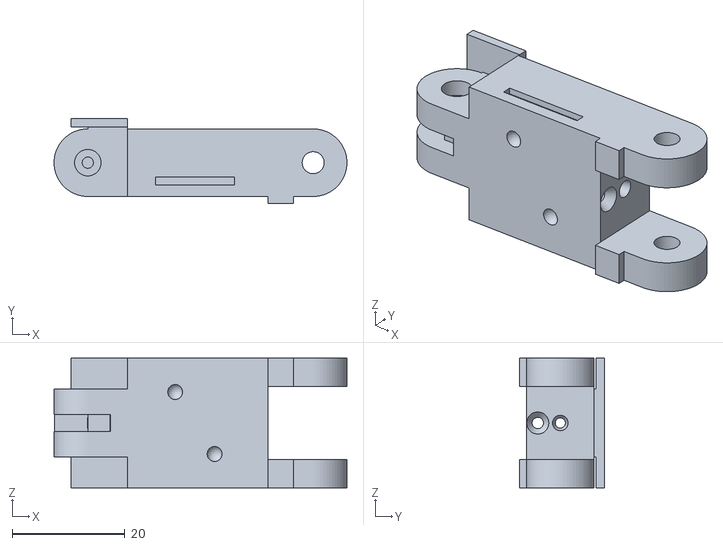
[picture p251: CAD file, 2026-09-24]
model/hand/finger-proximal.stl
52.0 x 15.0 x 23.0
