cbiele/CyBot/Cults3d_v5/5-axis4/axis4_OPH.stl

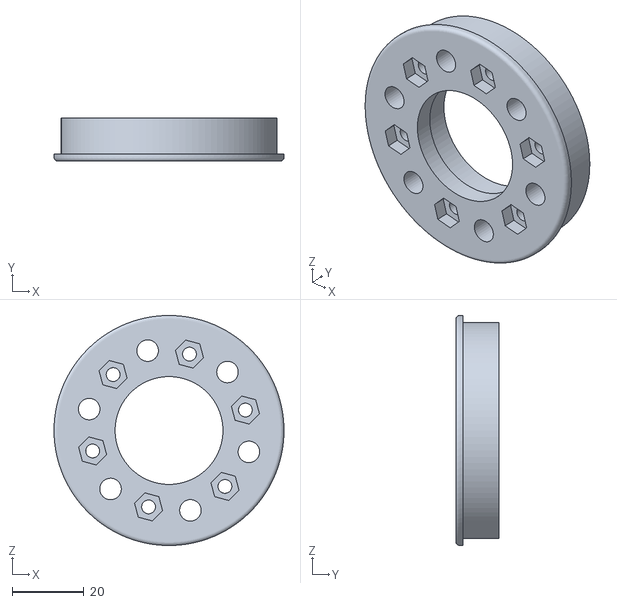
[picture p252: CAD file, 2026-09-06]
Cults3d_v5/5-axis4/axis4_OPH.stl
64.0 x 12.0 x 64.0
