cbiele/CyBot/Cults3d_v5/6-axis5-6/axis5-80T-7mm.stl

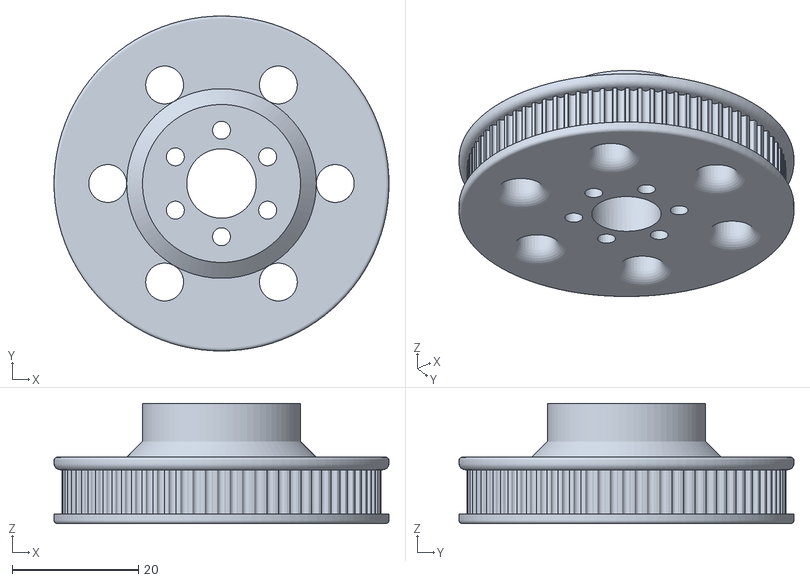
[picture p253: CAD file, 2026-09-06]
Cults3d_v5/6-axis5-6/axis5-80T-7mm.stl
53.0 x 53.0 x 19.0
