cbiele/CyBot/model/cycloid-poc/test-arm.stl

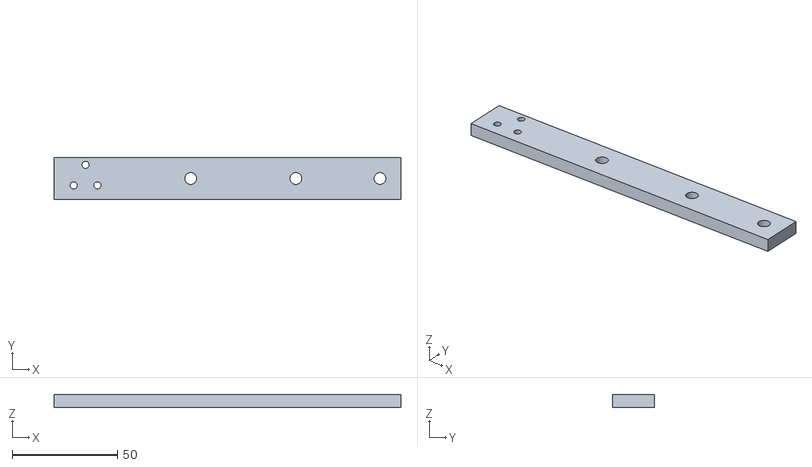
[picture p255: CAD file, 2026-10-25]
model/cycloid-poc/test-arm.stl
165.0 x 20.0 x 6.00
