cbiele/CyBot/model/hand/finger-skin.stl

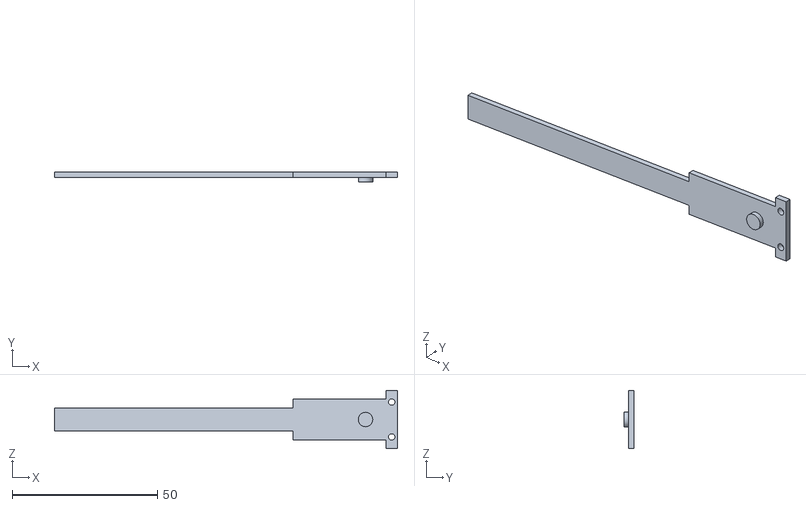
[picture p256: CAD file, 2026-09-23]
model/hand/finger-skin.stl
118.0 x 3.31 x 20.0
