cbiele/CyBot/quartit/cybot-6-axis-robot-arm-cycloidal-gearbox-drive-actuator-in-progress/exentricShaft1.3mf

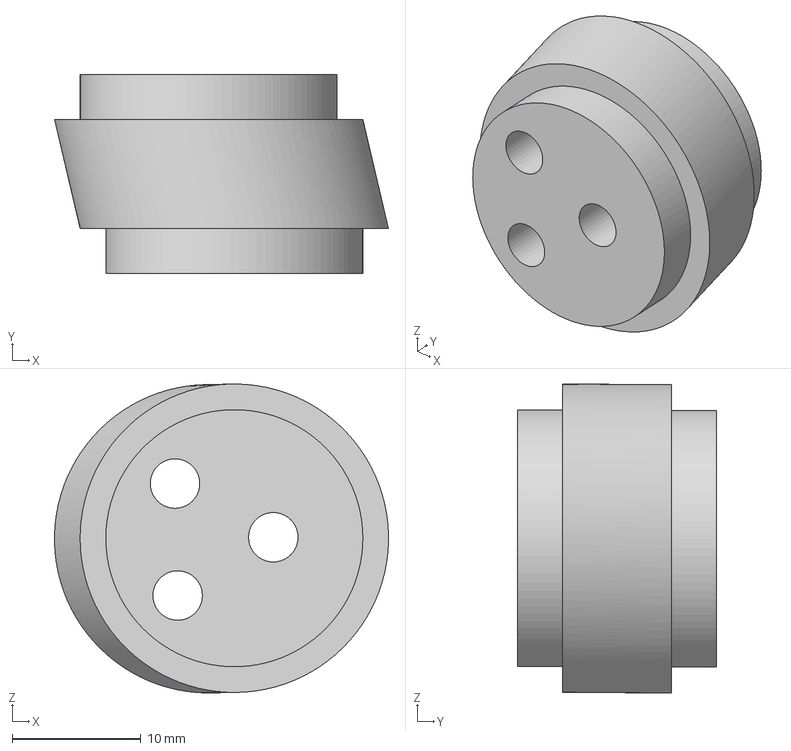
[picture p257: CAD file, 2026-09-06]
quartit/cybot-6-axis-robot-arm-cycloidal-gearbox-drive-actuator-in-progress/exentricShaft1.3mf
26.0 x 15.5 x 24.0 mm
