cbiele/CyBot/Cults3d_v5/5-axis4/axis4_axis5_holder.stl

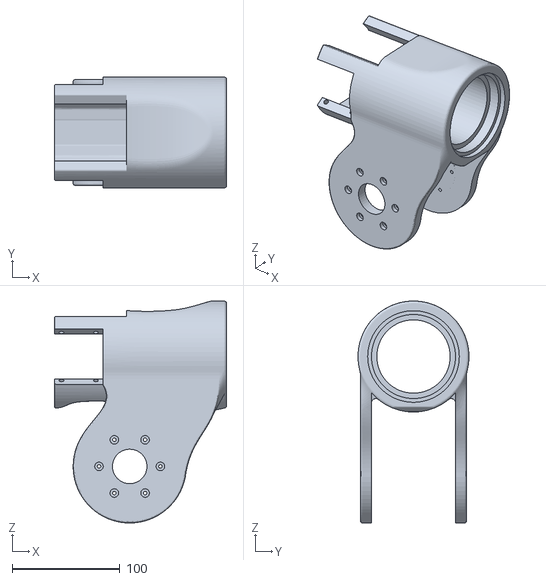
[picture p258: CAD file, 2026-09-06]
Cults3d_v5/5-axis4/axis4_axis5_holder.stl
160.0 x 103.0 x 206.0
