cbiele/CyBot/Cults3d_v5/6-axis5-6/axis5-axis6holder2.stl

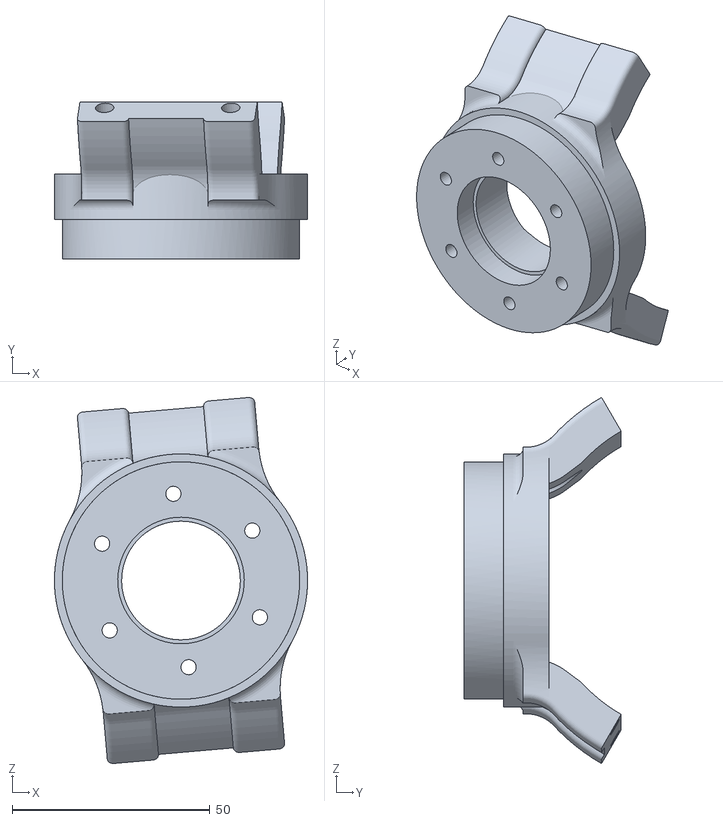
[picture p259: CAD file, 2026-09-06]
Cults3d_v5/6-axis5-6/axis5-axis6holder2.stl
64.0 x 39.8 x 92.5
