cbiele/CyBot/model/hand/coupon-forks.stl

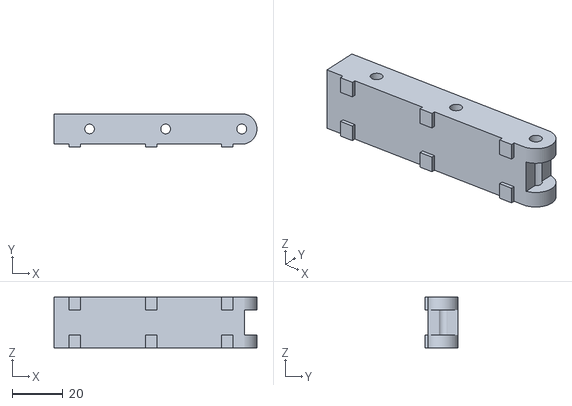
[picture p260: CAD file, 2026-09-23]
model/hand/coupon-forks.stl
80.0 x 13.2 x 20.0
