cbiele/CyBot/Cults3d_v5/6-axis5-6/axis5-holder.stl

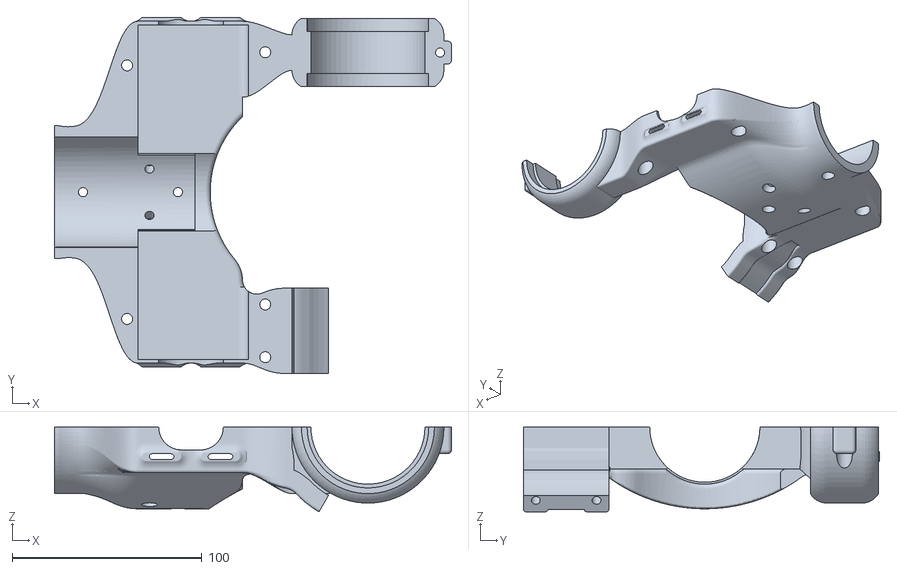
[picture p261: CAD file, 2026-09-06]
Cults3d_v5/6-axis5-6/axis5-holder.stl
209.0 x 187.5 x 44.6
