cbiele/CyBot/model/hand/coupon-tongues.stl

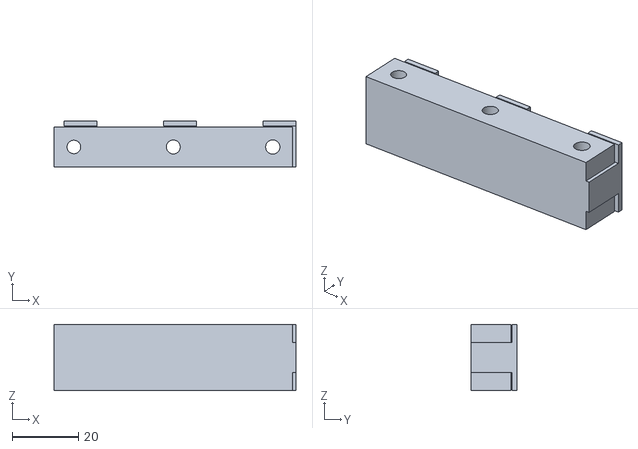
[picture p262: CAD file, 2026-09-23]
model/hand/coupon-tongues.stl
73.0 x 13.8 x 20.0
