cbiele/CyBot/Cults3d_v5/6-axis5-6/axis5-holderNoSplit.stl

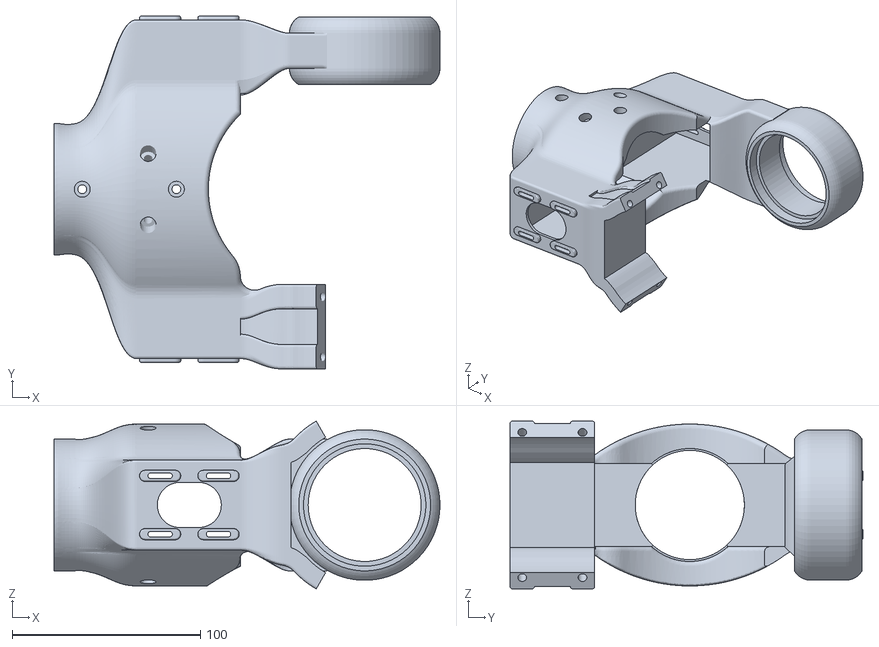
[picture p263: CAD file, 2026-09-06]
Cults3d_v5/6-axis5-6/axis5-holderNoSplit.stl
205.0 x 187.5 x 89.2
