cbiele/CyBot/model/cycloid-poc/eccentric.stl

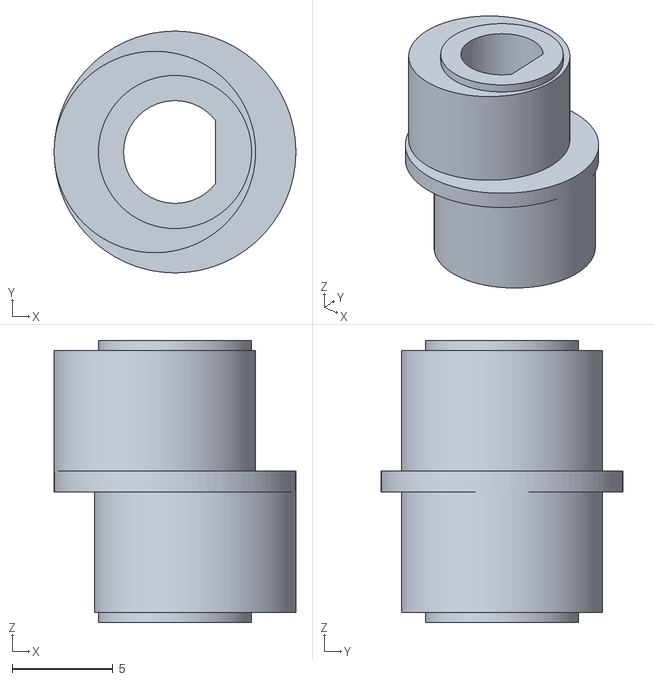
[picture p264: CAD file, 2026-10-25]
model/cycloid-poc/eccentric.stl
12.0 x 12.0 x 14.0
