cbiele/CyBot/model/cycloid-poc/fit-coupon-holes.stl

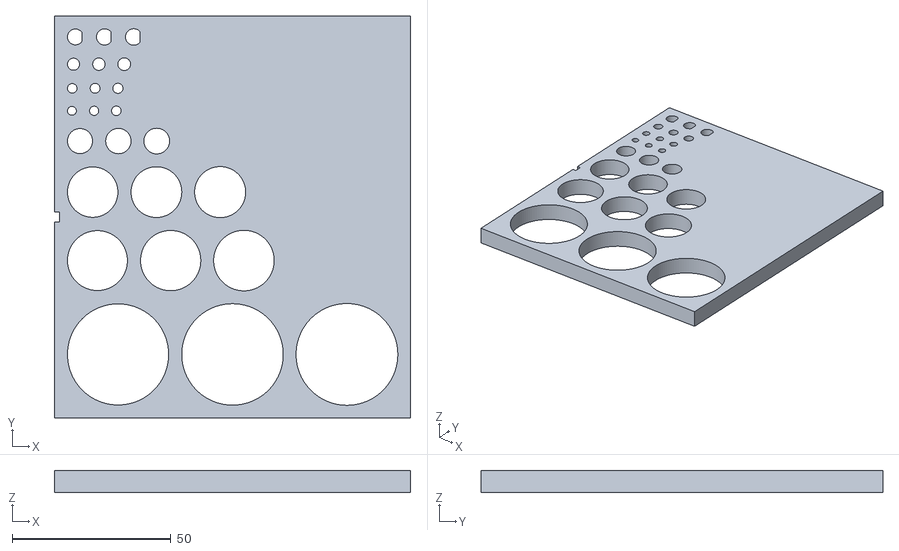
[picture p265: CAD file, 2026-10-25]
model/cycloid-poc/fit-coupon-holes.stl
112.3 x 126.8 x 7.00
