cbiele/CyBot/Cults3d_v5/5-axis4/axis4_Tube.stl

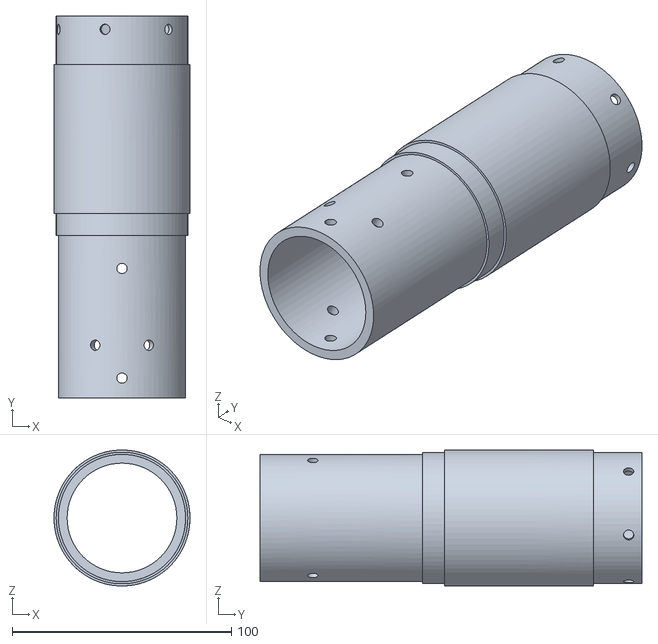
[picture p266: CAD file, 2026-09-06]
Cults3d_v5/5-axis4/axis4_Tube.stl
62.0 x 174.0 x 62.0
