cbiele/CyBot/Cults3d_v5/6-axis5-6/axis5-80T-rotor.stl

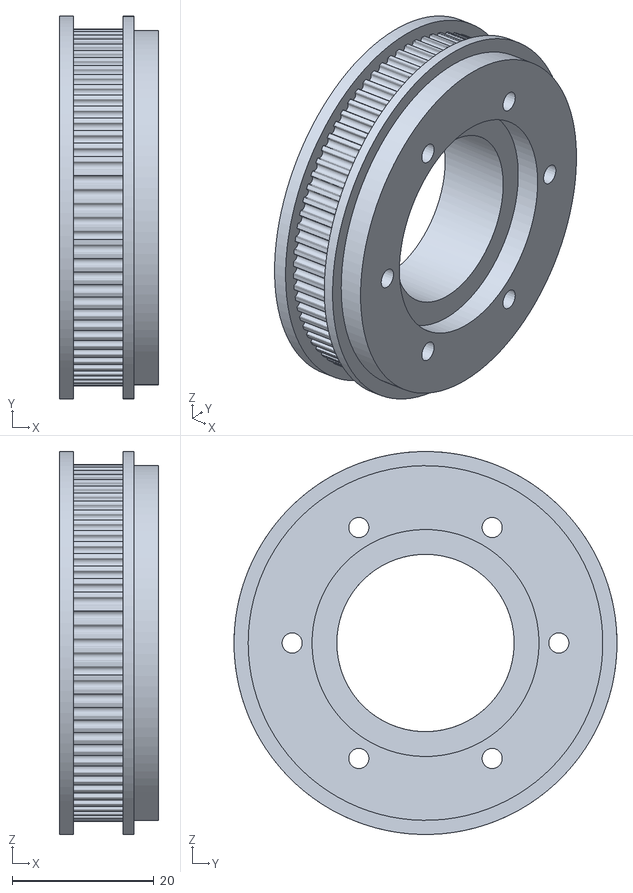
[picture p267: CAD file, 2026-09-06]
Cults3d_v5/6-axis5-6/axis5-80T-rotor.stl
14.0 x 54.0 x 54.0
