cbiele/CyBot/Cults3d_v5/6-axis5-6/axis5-axis6holder1.stl

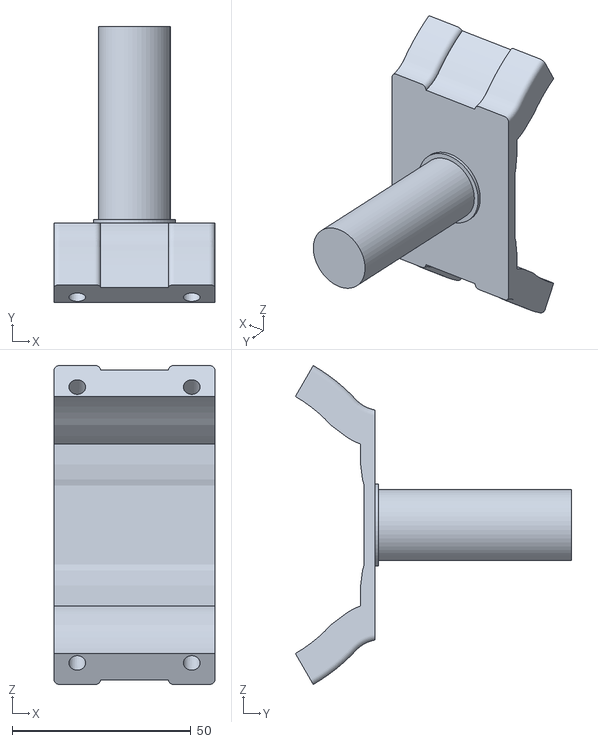
[picture p268: CAD file, 2026-09-06]
Cults3d_v5/6-axis5-6/axis5-axis6holder1.stl
45.0 x 77.2 x 89.2
