cbiele/CyBot/Cults3d_v5/3-axis2/axis2-GT2-stepper.stl

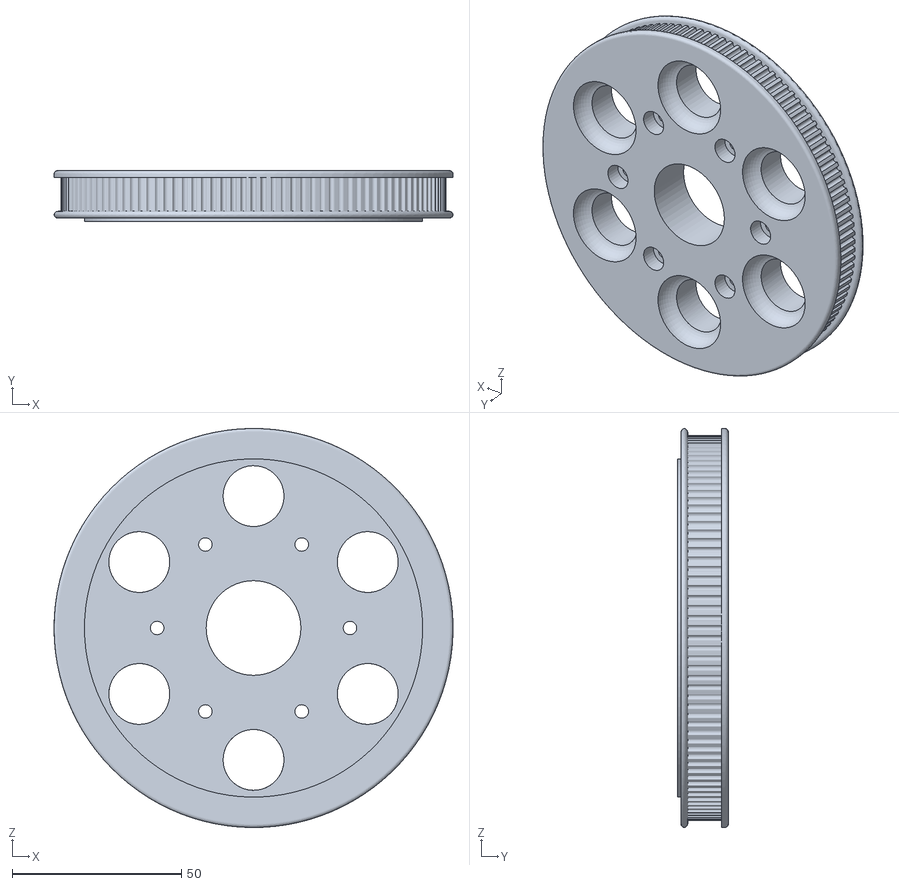
[picture p269: CAD file, 2026-09-06]
Cults3d_v5/3-axis2/axis2-GT2-stepper.stl
118.0 x 15.0 x 118.0
