cbiele/CyBot/(list of files, cad)

Other CAD files:
model/split/mainBody1_upper.stl
model/split/mainBody2_lower.stl
model/split/mainBody1_lower.stl
quartit/cybot-6-axis-robot-arm-cycloidal-gearbox-drive-actuator-in-progress/housing.3mf
model/cycloid-poc/20-1-hollow/carrier-rear.stl
model/cycloid-poc/20-1-compact/disk-b.stl
model/cycloid-poc/20-1-hollow/disk-a.stl
Cults3d_v5/4-axis3/axis3-OPH2.stl
model/cycloid-poc/20-1-compact/disk-a.stl
model/cycloid-poc/20-1-hollow/eccentric.stl
model/cycloid-poc/carrier-rear.stl
quartit/cybot-6-axis-robot-arm-cycloidal-gearbox-drive-actuator-in-progress/disk2.3mf
Cults3d_v5/5-axis4/axis4_OPH2.stl
model/cycloid-poc/housing-front.stl
Cults3d_v5/3-axis2/axis2-shaft2.stl
model/cycloid-poc/20-1-compact/eccentric-round.stl
quartit/cybot-6-axis-robot-arm-cycloidal-gearbox-drive-actuator-in-progress/diskCap.3mf
Cults3d_v5/3-axis2/axis2-holder1.stl
Cults3d_v5/6-axis5-6/axis5-holder2.stl
model/cycloid-poc/20-1-compact/motor-mount.stl
quartit/cybot-6-axis-robot-arm-cycloidal-gearbox-drive-actuator-in-progress/disk1.3mf
Cults3d_v5/3-axis2/axis2-OPH1.stl
Cults3d_v5/3-axis2/axis2-holder2.stl
model/cycloid-poc/20-1-compact/carrier-front.stl
model/cycloid-poc/carrier-front.stl
quartit/cybot-6-axis-robot-arm-cycloidal-gearbox-drive-actuator-in-progress/disk3.3mf
Cults3d_v5/3-axis2/axis2-disk3.stl
Cults3d_v5/5-axis4/axis4_80TGT2-7mm.stl
model/cycloid-poc/20-1-compact/housing-rear.stl
model/cycloid-poc/disk-a.stl
quartit/cybot-6-axis-robot-arm-cycloidal-gearbox-drive-actuator-in-progress/outputPinHolder.3mf
Cults3d_v5/3-axis2/axis2-disk2.stl
Cults3d_v5/5-axis4/axis4_shaft.stl
Cults3d_v5/3-axis2/axis2-shaft1.stl
Cults3d_v5/5-axis4/axis4_disk1.stl
Cults3d_v5/6-axis5-6/axis5_Housing2Attach1.stl
Cults3d_v5/3-axis2/axis2-shaft3.stl
Cults3d_v5/3-axis2/axis2-shaft4.stl
Cults3d_v5/3-axis2/axis2-housing1.stl
model/cycloid-poc/20-1-compact/exploded.blend
quartit/cybot-6-axis-robot-arm-cycloidal-gearbox-drive-actuator-in-progress/disk1.stl
quartit/cybot-6-axis-robot-arm-cycloidal-gearbox-drive-actuator-in-progress/disk2.stl
quartit/cybot-6-axis-robot-arm-cycloidal-gearbox-drive-actuator-in-progress/disk3.stl
quartit/cybot-6-axis-robot-arm-cycloidal-gearbox-drive-actuator-in-progress/diskCap.stl
quartit/cybot-6-axis-robot-arm-cycloidal-gearbox-drive-actuator-in-progress/exentricShaft1.stl
quartit/cybot-6-axis-robot-arm-cycloidal-gearbox-drive-actuator-in-progress/exentricShaft2.stl
quartit/cybot-6-axis-robot-arm-cycloidal-gearbox-drive-actuator-in-progress/exentricShaft3.stl
quartit/cybot-6-axis-robot-arm-cycloidal-gearbox-drive-actuator-in-progress/exentricShaft4.stl
quartit/cybot-6-axis-robot-arm-cycloidal-gearbox-drive-actuator-in-progress/housing.stl
quartit/cybot-6-axis-robot-arm-cycloidal-gearbox-drive-actuator-in-progress/outputPinHolder.stl
