cbiele/CyBot/model/subassemblies/axis56-assembly.md

# axis56: stack order along the joint axis (0, 1, 0) (assembled coordinates, mm)

Parts in the order they sit along the axis; bearings listed under the part they seat in.

- axis5-80T-7mm  (centre -98.9, 21 mm long)
- axis5_OPH  (centre -91.5, 12 mm long)
    - 6705zz  axis5_OPH / axis5_shaft2: inside the OPH on the shaft2 journal
- axis5_shaft2  (centre -91.5, 13 mm long)
- axis5_Housing2Attach1  (centre -85.0, 26 mm long)
    - 6812zz  axis5_Housing2Attach1 / axis5_OPH: O78 x 10 pocket y -97.5..-87.5; also the yoke's O78 bore at y -95.5
- axis5_diskCap  (centre -81.3, 2 mm long)
- axis5_shaft3  (centre -80.5, 9 mm long)
- axis5_disk1  (centre -78.5, 7 mm long)
    - 6705zz  axis5_disk1 / axis5_shaft3: disk centre bore on the shaft3 eccentric
- axis5_disk2  (centre -71.5, 7 mm long)
    - 6705zz  axis5_disk2 / axis5_shaft: disk centre bore on the shaft eccentric
- axis5_shaft  (centre -69.5, 13 mm long)
- axis5_diskCap.2  (centre -69.4, 2 mm long)
- axis5_Housing2Attach2  (centre -65.0, 26 mm long)
    - 6812zz  axis5_Housing2Attach2 / axis5-axis6holder2: O78 x 10 pocket y -62.5..-52.5; inner ring on axis6holder2's O60 boss y -60.6..-50.6
- axis5-axis6holder2  (centre -40.8, 40 mm long)
    - 6705zz  axis5-axis6holder2 / axis5_shaft: O32 bore 7 mm deep y -60.6..-53.6; the output plate of the axis-5 1:11, so a 6705 on the shaft journal as in the axis-4 unit (PDF wrist list says 6804 x2: bench check)
- axis5-holder  (centre -1.8, 188 mm long)
    - 6810zz x2  axis5-holder / axis5-axis6holder1: O65 x 7 seat in the +y yoke arm (y 55-62)
- axis5-holder2  (centre -1.6, 188 mm long)
- axis5-80T-rotor  (centre -0.0, 54 mm long)
- axis5-pulleySpacer  (centre -0.0, 54 mm long)
- axis5-pulley  (centre +0.0, 54 mm long)
- axis5-quarterTurnBeltDrive  (centre +39.1, 20 mm long)
    - HK0608 x2  axis5-quarterTurnBeltDrive / M6 axle: O10 bore, idler roller
- axis5-axis6holder1  (centre +59.2, 78 mm long)

## Hardware (PDF list + STL count)
- 6812zz x2 (located in the Housing2Attach halves)
- 6810zz x2 (located: O65 x 7 seats on the +y yoke arm)
- 6804zz x2 (one located in axis6holder2; second not found)
- HK0608 x4 (needle rollers; 3 O10 bores found on quarterTurnBeltDrive)
- M6x25 x2, belts 232-2GT x1 and 308-2GT x3, GT2 40T x2, GT2 20T x1
- axis-5 1:11 internals are a second print of 5-axis4: disk1, disk2, diskCap x2, shaft, shaft2, shaft3, OPH (short) only; Housing2Attach1/2 are its housing halves and axis6holder2 its output plate
- per that gearbox: 6705zz x4, brass bushings 8x10x6 x12, pins O6x25 x6, M4/M3 rod (positions provisional until the gearbox is built, 2026-09-15)
