cbiele/CyBot/model/subassemblies/axis1-assembly.md

# axis1: stack order along the joint axis (0, 0, 1) (assembled coordinates, mm)

Parts in the order they sit along the axis; bearings listed under the part they seat in.

- axis1-stepperHolder  (centre +56.8, 50 mm long)
    - 6804zz  axis1-stepperHolder / motor pulley hub: O32 pocket 5 mm deep on the stepper holder's motor axis; the motor pilot is O22 so this is a bearing seat
- axis-1-rotatingBase1  (centre +64.0, 28 mm long)
    - 6816zz  axis-1-rotatingBase1 / axis1-baseHolder: outer ring in rotatingBase1's O100 pocket z 50-60, inner ring on the base holder's O80 column
- axis1-baseHolder  (centre +66.2, 68 mm long)
- axis1-encoderHolder  (centre +66.8, 30 mm long)
- axis-1-rotatingBase2  (centre +86.5, 17 mm long)
    - 6816zz  axis-1-rotatingBase2 / axis1-baseHolder: O100 seat shared by rotatingBase2 (z 90-95) and rotatingBase3 (z 95-100); inner ring on the O80 column
- axis-1-rotatingBase3  (centre +129.1, 69 mm long)

## Hardware (PDF list + STL count)
- 6816zz x2 (located)
- 6804zz x2 (one located in the stepper holder; second not found)
- 625zz x8 (no O16 seat found; likely rollers on the M5x20)
- 606zz x4 (tensioner rollers, not located)
- M5x20 x8, M6x50 x8, M6x40 x12, M6 nuts x8
- 3M 30T pulleys x2 (12 mm), HTD648-3M belts x2
