cbiele/CyBot/model/subassemblies/gripper-assembly.md

# gripper: stack order along the joint axis (1, 0, 0) (assembled coordinates, mm)

Parts in the order they sit along the axis; bearings listed under the part they seat in.

- OPH_To_Gripper  (centre +38.5, 77 mm long)
    - 6804zz  OPH_To_Gripper / roll shaft: O32 bore x 288.5-295.5
    - 6812zz  OPH_To_Gripper / axis5-holder2: inner ring on the O60 boss x 288.5-298.5; outer seat unverified
- mainHolder  (centre +103.3, 73 mm long)
- T8_Srcew_Holder  (centre +145.0, 14 mm long)
- T8_to_Axes  (centre +147.7, 10 mm long)
- T8_to_Axes.2  (centre +147.7, 10 mm long)
- T8_to_Axes.3  (centre +147.7, 10 mm long)
- T8_to_Axes.4  (centre +147.7, 10 mm long)
- Axe  (centre +148.4, 39 mm long)
- Axe.2  (centre +148.4, 39 mm long)
- Axe.3  (centre +148.4, 39 mm long)
- Axe.4  (centre +148.4, 39 mm long)
- grip  (centre +226.6, 83 mm long)
- grip.2  (centre +226.6, 83 mm long)
- grip.3  (centre +226.6, 83 mm long)
- grip.4  (centre +226.6, 83 mm long)

## Hardware (PDF list + STL count)
- hardware list is in the separate Cults gripper project, not this PDF
- 6804zz x1 located (O32 bore 7 mm deep in OPH_To_Gripper)
- O60 x 10 boss on OPH_To_Gripper = a 6812 inner-ring seat (probably one of the wrist's two)
- T8 lead screw + nut in T8_Srcew_Holder
