cbiele/CyBot/model/subassemblies/mainbody-assembly.md

# mainbody: stack order along the joint axis (0, 1, 0) (assembled coordinates, mm)

Parts in the order they sit along the axis; bearings listed under the part they seat in.

- plateBall.3  (centre -220.2, 60 mm long)
- plateBall.4  (centre -220.2, 60 mm long)
- beltTentioner1  (centre -59.0, 30 mm long)
    - 606zz x2  beltTentioner1 / M6 axle: roller on the arm's O6 axle hole
- beltTentioner3  (centre -59.0, 30 mm long)
    - 606zz x2  beltTentioner3 / M6 axle
- mainBody1  (centre -36.0, 16 mm long)
- mainBody2  (centre +36.0, 16 mm long)
- beltTentioner2  (centre +59.0, 30 mm long)
    - 606zz x2  beltTentioner2 / M6 axle
- plateBall  (centre +220.2, 60 mm long)
- plateBall.2  (centre +220.2, 60 mm long)

## Hardware (PDF list + STL count)
- 6804zz x2 (not located in the plates)
- 606zz x8 for the tensioners (6 placed at the arms' O6 axle holes, inferred)
- M6 screws for tensioners
- HTD477-3M belts x4, 3M 20T (15 mm) x1, 3M 30T (12 mm) x3
- E6B2-CWZ6C x3, NEMA23 x2, NEMA17 x4 (PDF) - geometry says NEMA17 x5 incl. gripper
- the plates also carry the outer 5 mm of each 6813 (O85 pockets at y +-28..33, z 203 and 453)
