cbiele/CyBot/reference/hackaday/AssemblySectionAnalysis.JPG

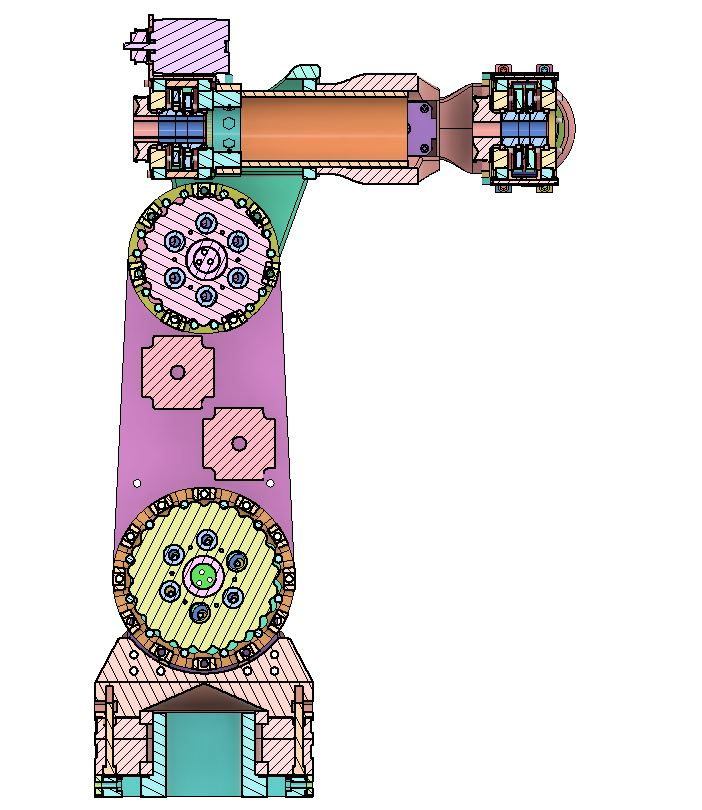
reference/hackaday/AssemblySectionAnalysis.JPG
