cbiele/CyBot/reference/pdf-figures/p5-joint-assembled.png

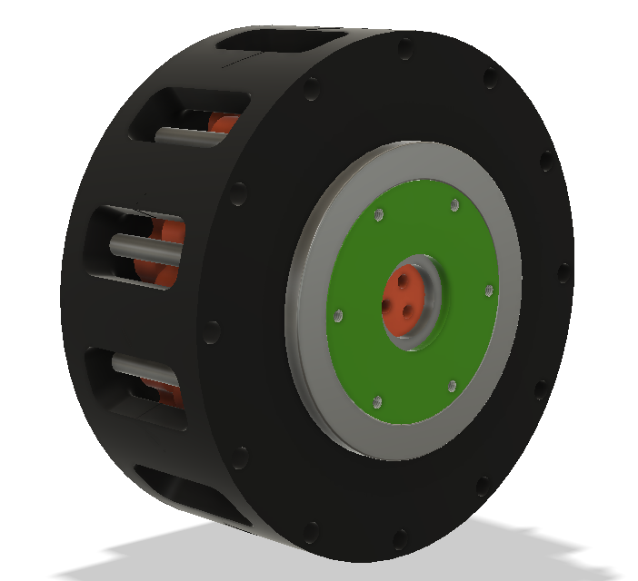
reference/pdf-figures/p5-joint-assembled.png
