cbiele/CyBot/reference/video/frames/20211207-3dPrinted124CycloidalAct-sheet.jpg

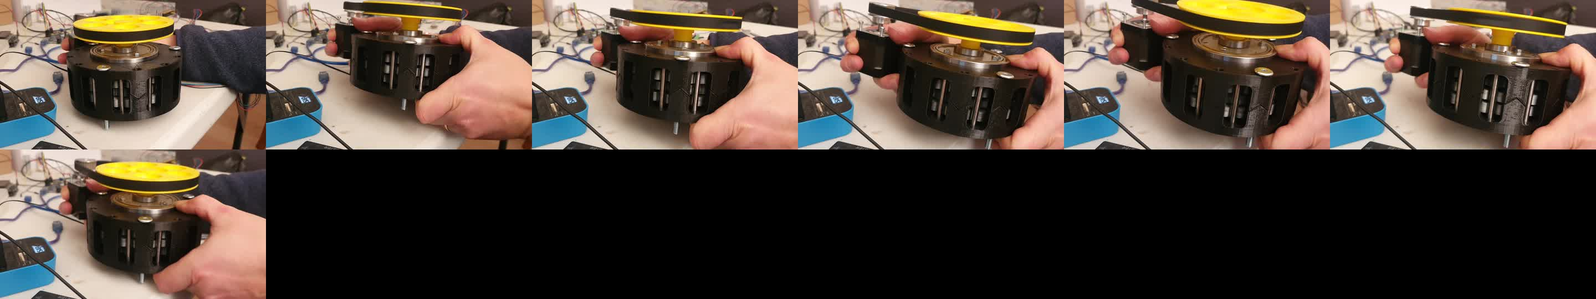
reference/video/frames/20211207-3dPrinted124CycloidalAct-sheet.jpg
