cbiele/CyBot/reference/video/frames/20211207-3dPrinted124CycloidalAct/007.jpg

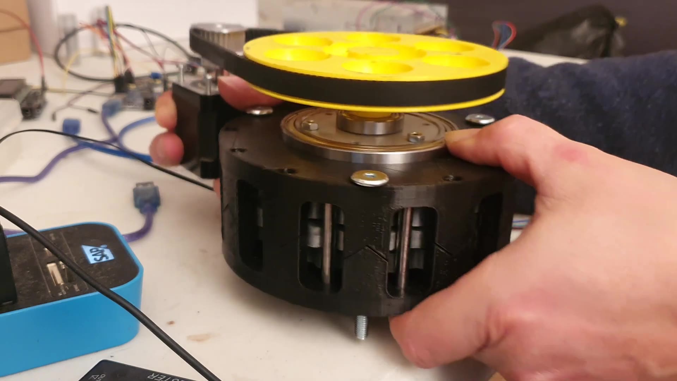
reference/video/frames/20211207-3dPrinted124CycloidalAct/007.jpg
