cbiele/CyBot/reference/video/frames/20211223-3dPrinted111CycloidalAct-sheet.jpg

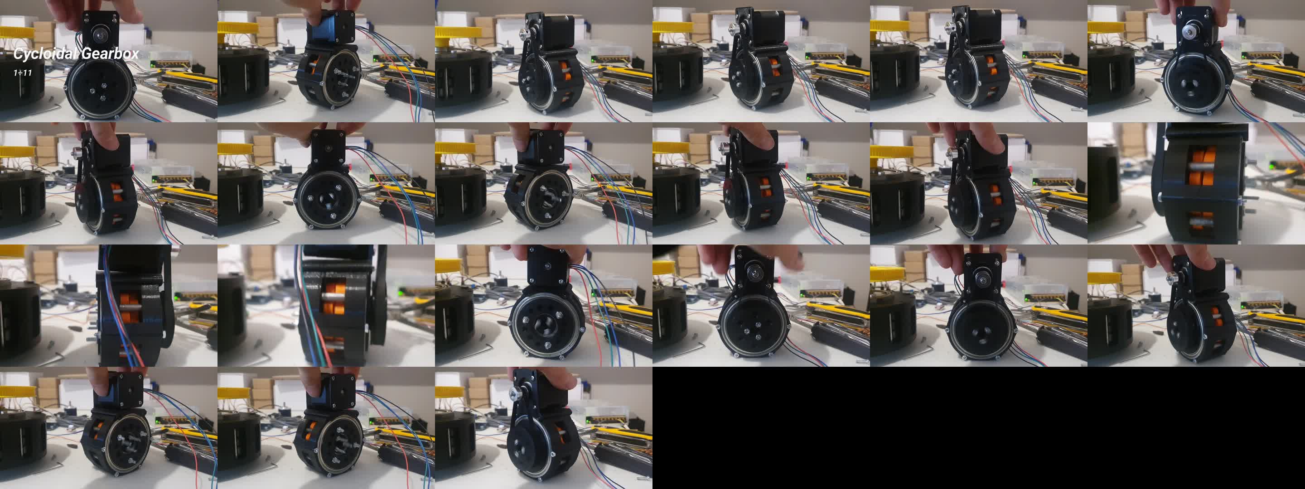
reference/video/frames/20211223-3dPrinted111CycloidalAct-sheet.jpg
