cbiele/CyBot/reference/video/frames/20211223-3dPrinted111CycloidalAct/002.jpg

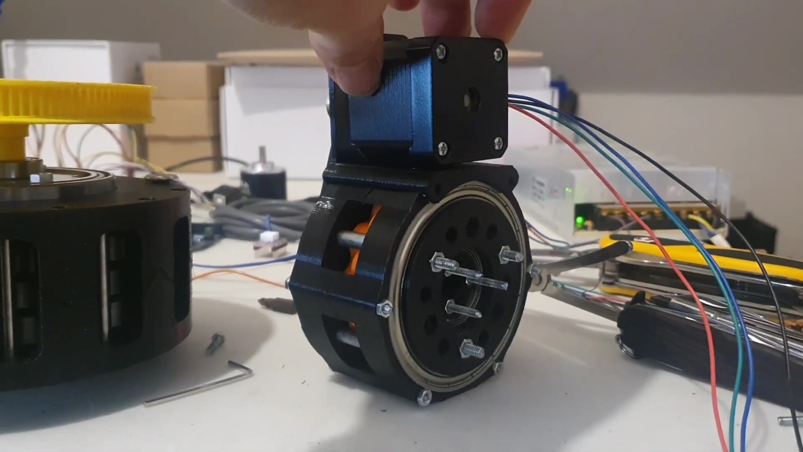
reference/video/frames/20211223-3dPrinted111CycloidalAct/002.jpg
