cbiele/CyBot/reference/video/frames/20211223-3dPrinted111CycloidalAct/015.jpg

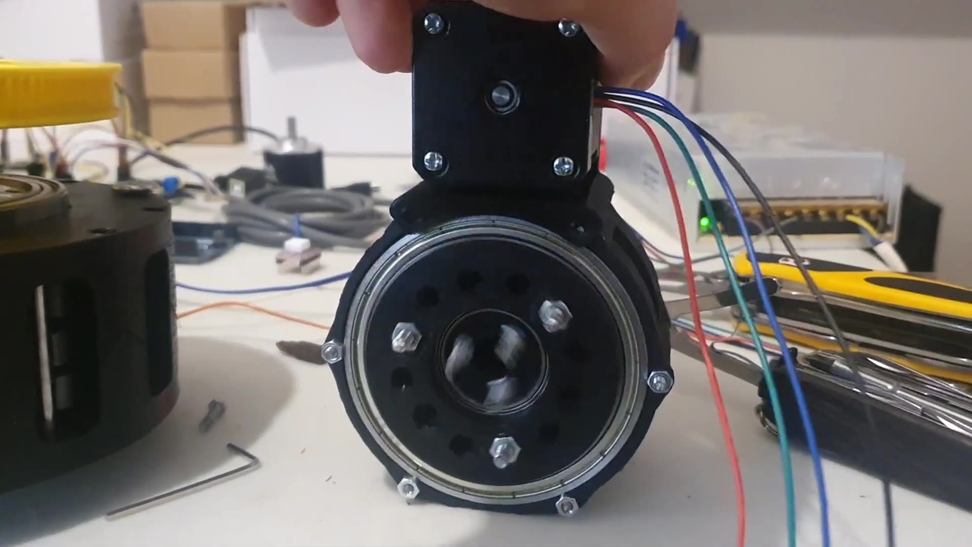
reference/video/frames/20211223-3dPrinted111CycloidalAct/015.jpg
