cbiele/CyBot/reference/video/frames/20211223-3dPrinted111CycloidalAct/018.jpg

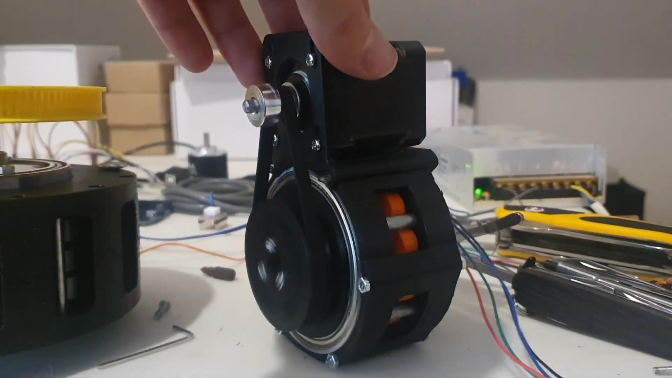
reference/video/frames/20211223-3dPrinted111CycloidalAct/018.jpg
