cbiele/CyBot/reference/video/frames/20220108-CycloidaldriveAssembly-sheet.jpg

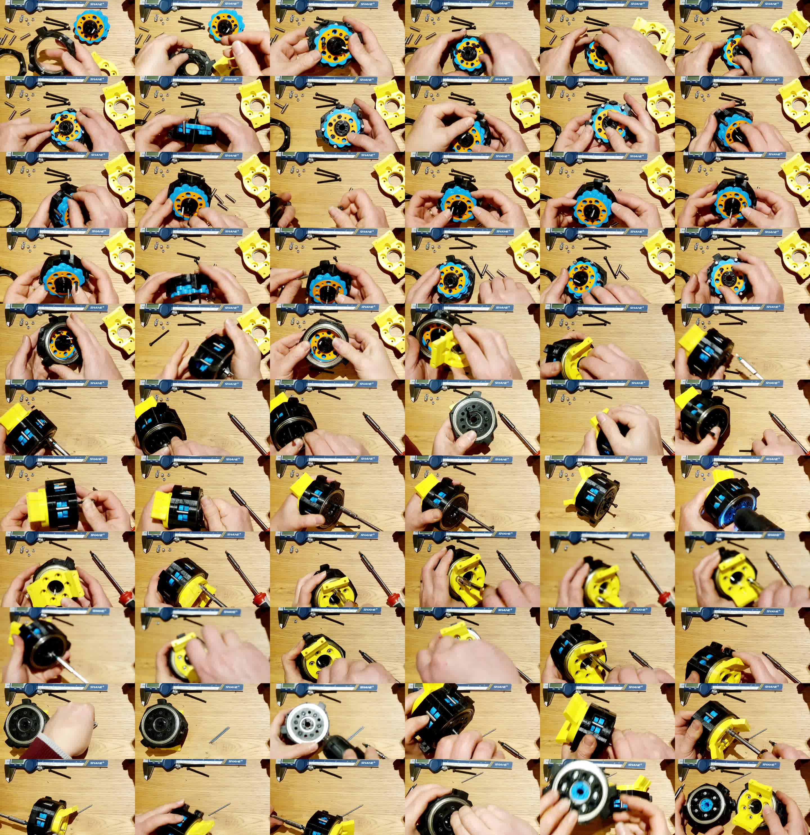
reference/video/frames/20220108-CycloidaldriveAssembly-sheet.jpg
