cbiele/CyBot/reference/video/frames/20220108-CycloidaldriveAssembly/001.jpg

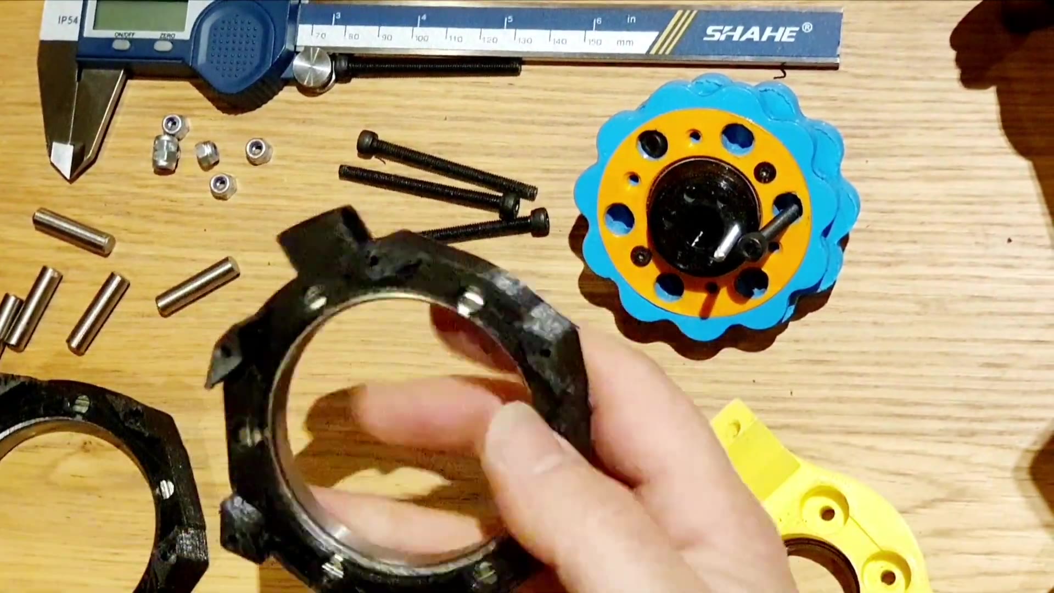
reference/video/frames/20220108-CycloidaldriveAssembly/001.jpg
