cbiele/CyBot/reference/video/frames/20220108-CycloidaldriveAssembly/002.jpg

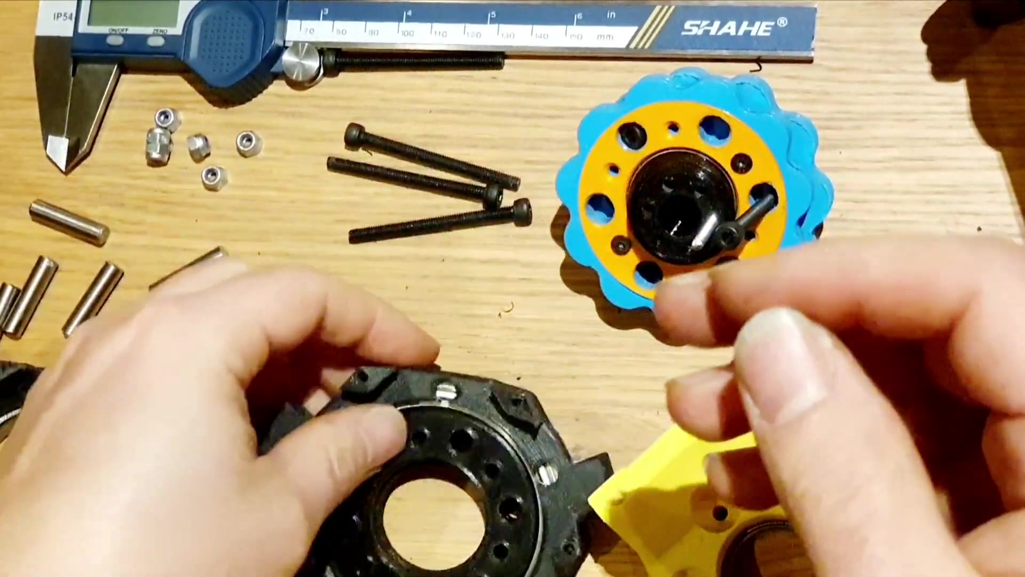
reference/video/frames/20220108-CycloidaldriveAssembly/002.jpg
