cbiele/CyBot/reference/video/frames/20220108-CycloidaldriveAssembly/003.jpg

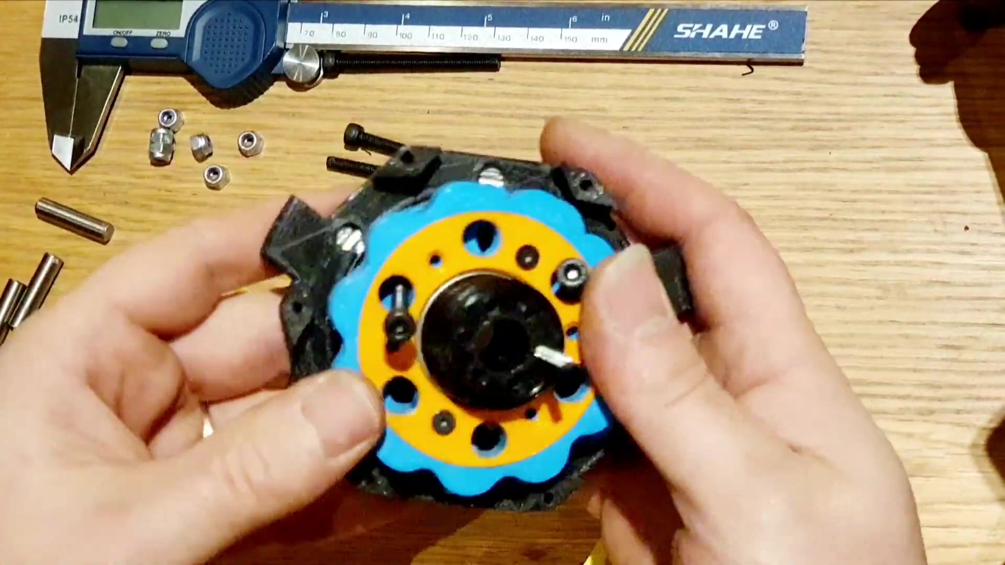
reference/video/frames/20220108-CycloidaldriveAssembly/003.jpg
