cbiele/CyBot/reference/video/frames/20220108-CycloidaldriveAssembly/004.jpg

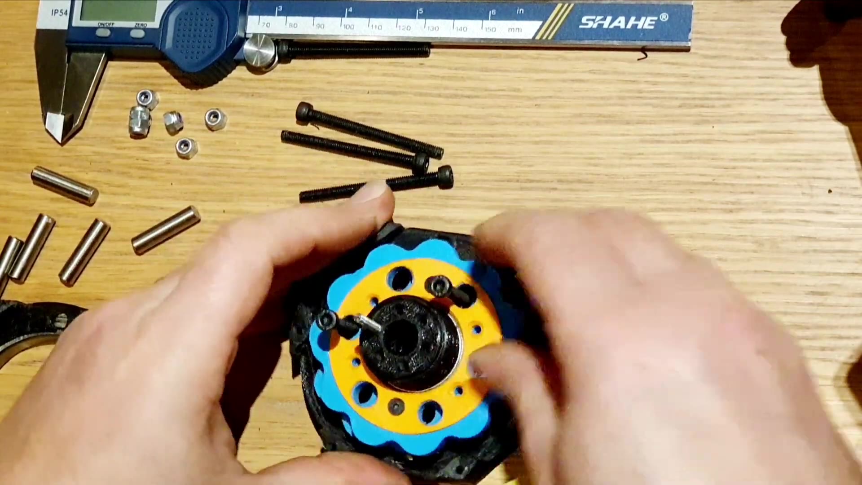
reference/video/frames/20220108-CycloidaldriveAssembly/004.jpg
