cbiele/CyBot/reference/video/frames/20220108-CycloidaldriveAssembly/005.jpg

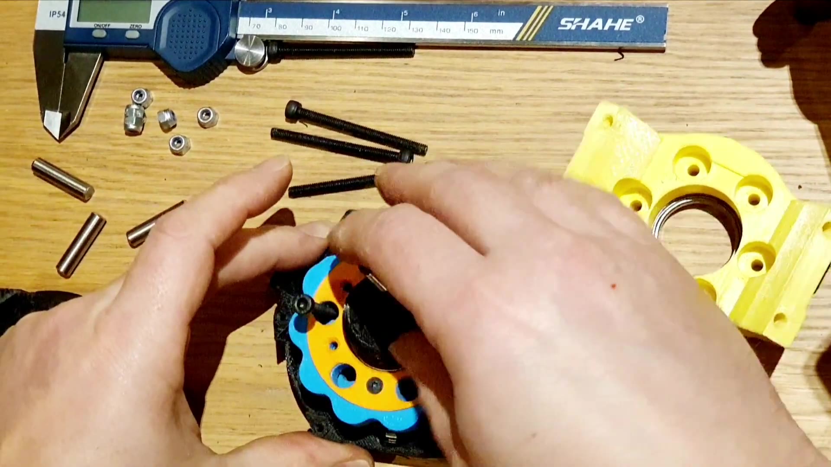
reference/video/frames/20220108-CycloidaldriveAssembly/005.jpg
