cbiele/CyBot/reference/video/frames/20220108-CycloidaldriveAssembly/006.jpg

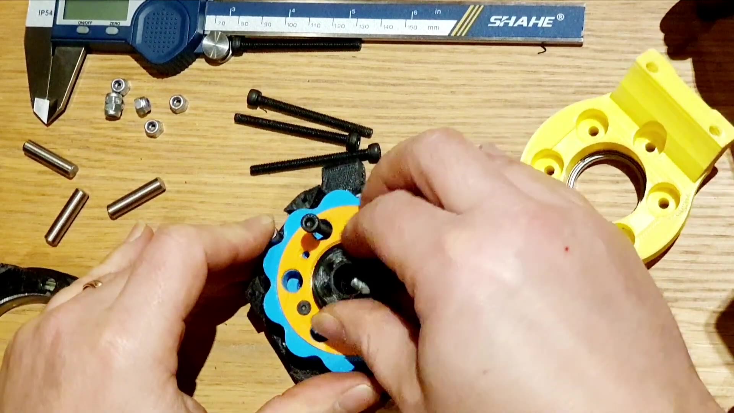
reference/video/frames/20220108-CycloidaldriveAssembly/006.jpg
