cbiele/CyBot/reference/video/frames/20220108-CycloidaldriveAssembly/007.jpg

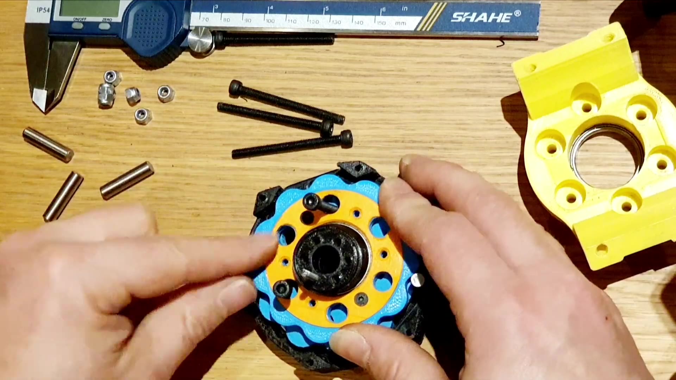
reference/video/frames/20220108-CycloidaldriveAssembly/007.jpg
