cbiele/CyBot/reference/video/frames/20220108-CycloidaldriveAssembly/008.jpg

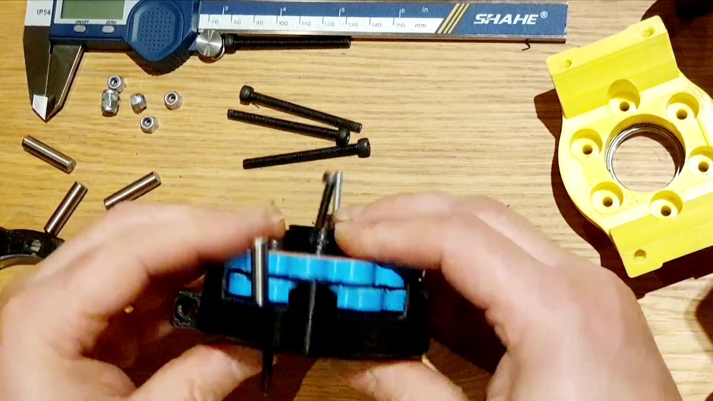
reference/video/frames/20220108-CycloidaldriveAssembly/008.jpg
