cbiele/CyBot/reference/video/frames/20220108-CycloidaldriveAssembly/009.jpg

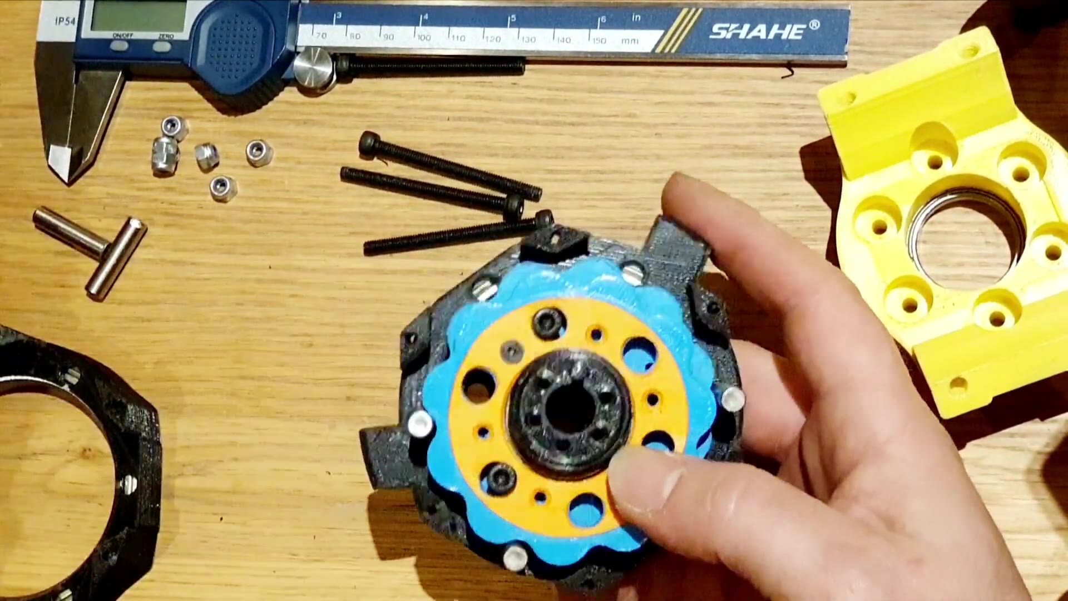
reference/video/frames/20220108-CycloidaldriveAssembly/009.jpg
