cbiele/CyBot/reference/video/frames/20220108-CycloidaldriveAssembly/011.jpg

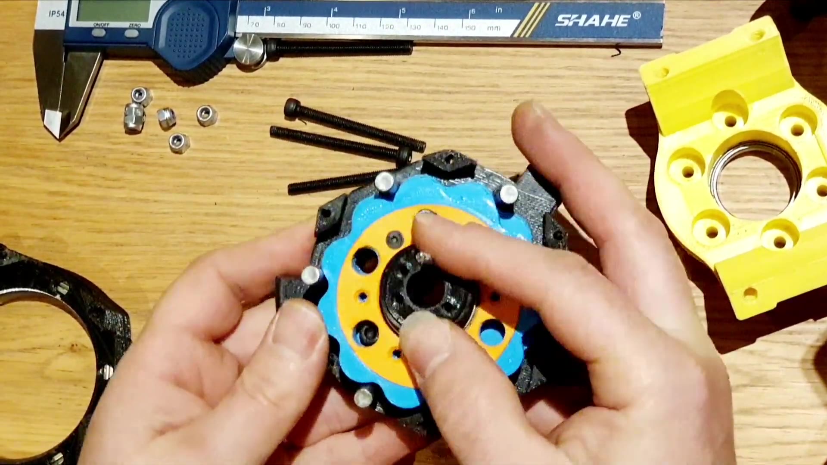
reference/video/frames/20220108-CycloidaldriveAssembly/011.jpg
