cbiele/CyBot/reference/video/frames/20220108-CycloidaldriveAssembly/012.jpg

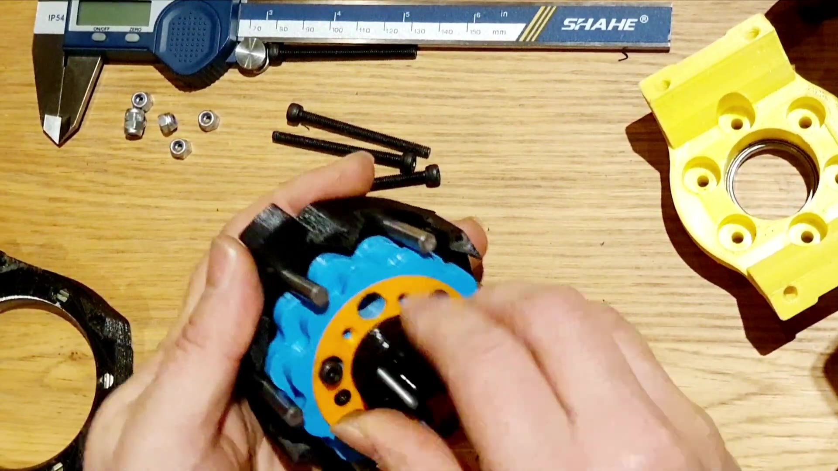
reference/video/frames/20220108-CycloidaldriveAssembly/012.jpg
