cbiele/CyBot/reference/video/frames/20220108-CycloidaldriveAssembly/013.jpg

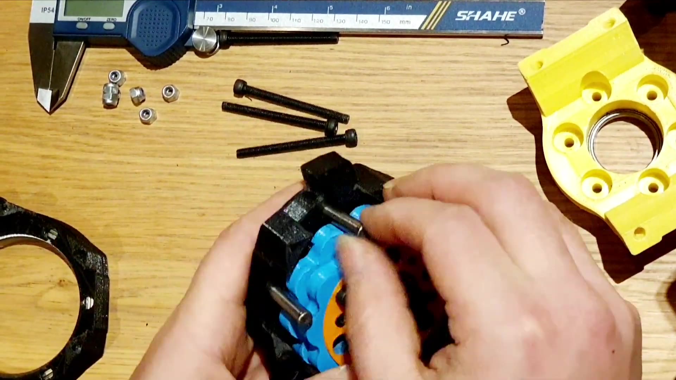
reference/video/frames/20220108-CycloidaldriveAssembly/013.jpg
