cbiele/CyBot/reference/video/frames/20220108-CycloidaldriveAssembly/014.jpg

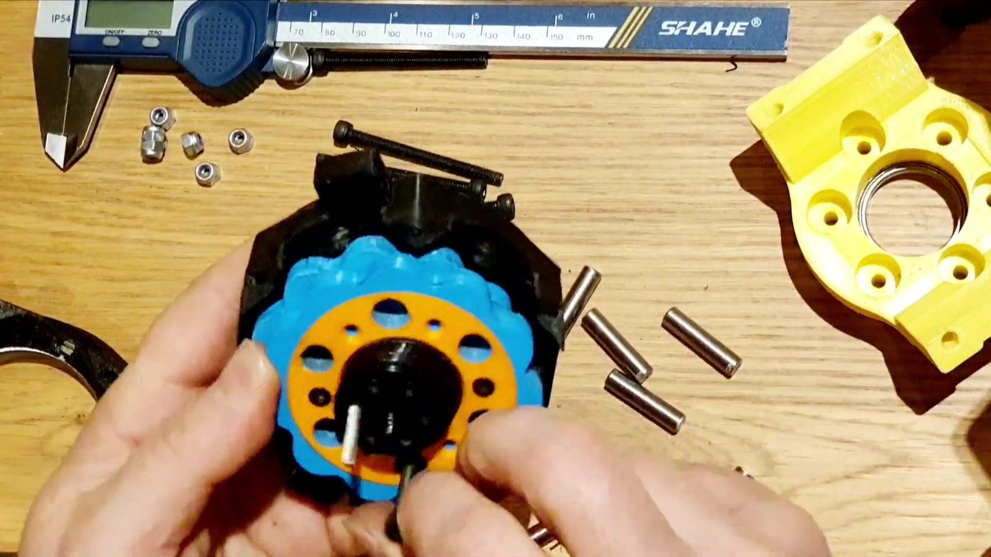
reference/video/frames/20220108-CycloidaldriveAssembly/014.jpg
