cbiele/CyBot/reference/video/frames/20220108-CycloidaldriveAssembly/015.jpg

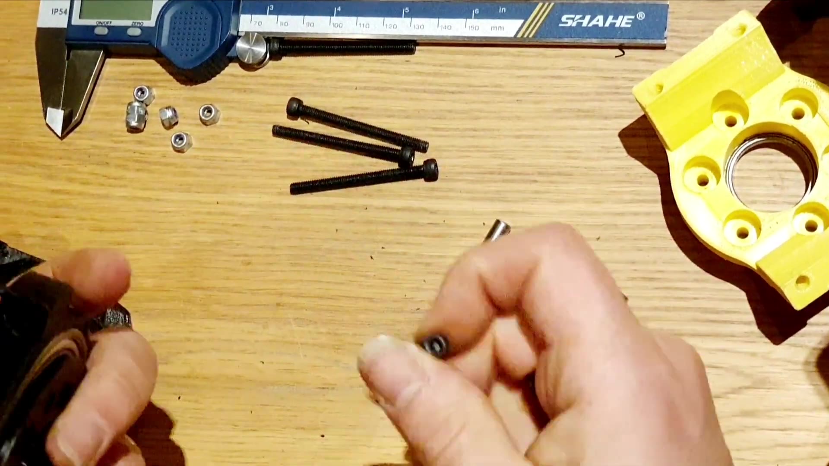
reference/video/frames/20220108-CycloidaldriveAssembly/015.jpg
