cbiele/CyBot/reference/video/frames/20220108-CycloidaldriveAssembly/016.jpg

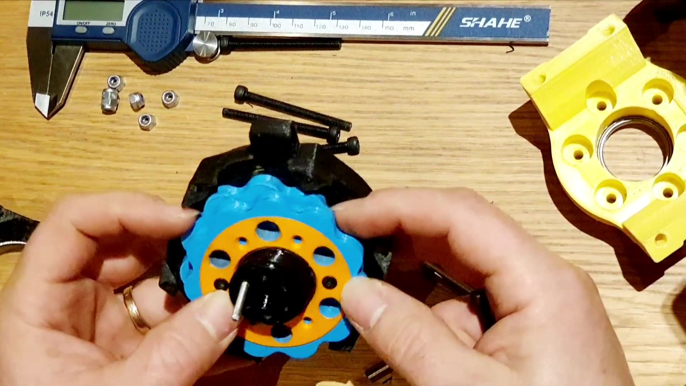
reference/video/frames/20220108-CycloidaldriveAssembly/016.jpg
