cbiele/CyBot/reference/video/frames/20220108-CycloidaldriveAssembly/017.jpg

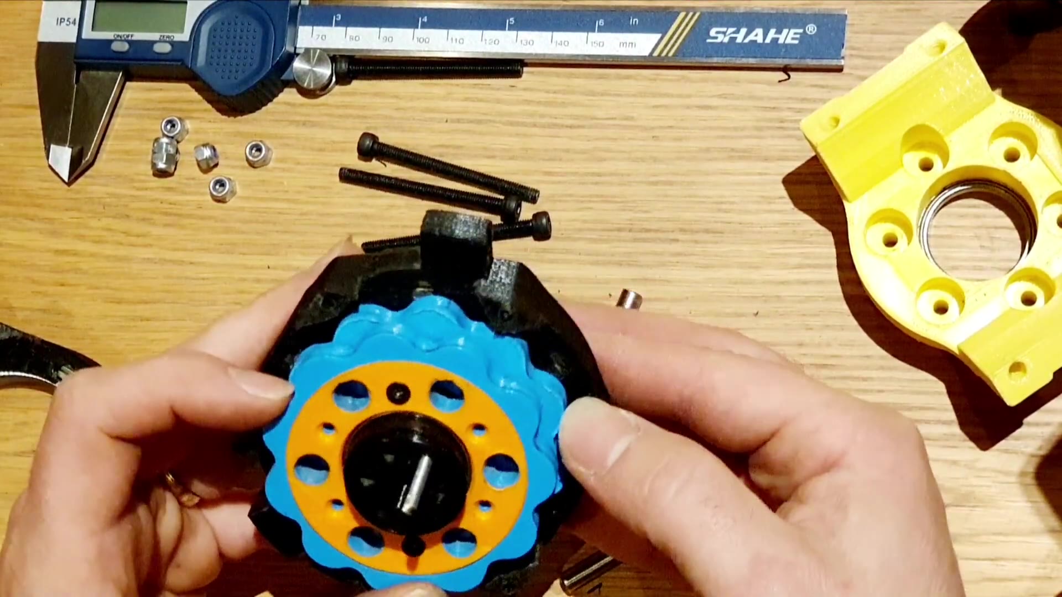
reference/video/frames/20220108-CycloidaldriveAssembly/017.jpg
