cbiele/CyBot/reference/video/frames/20220108-CycloidaldriveAssembly/018.jpg

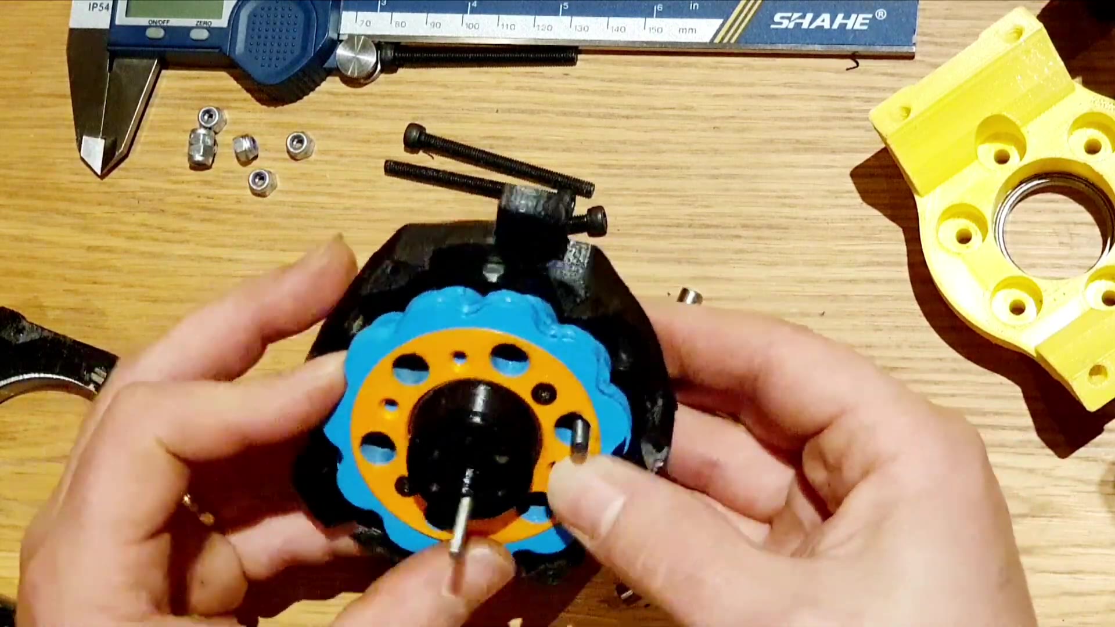
reference/video/frames/20220108-CycloidaldriveAssembly/018.jpg
