cbiele/CyBot/reference/video/frames/20220108-CycloidaldriveAssembly/019.jpg

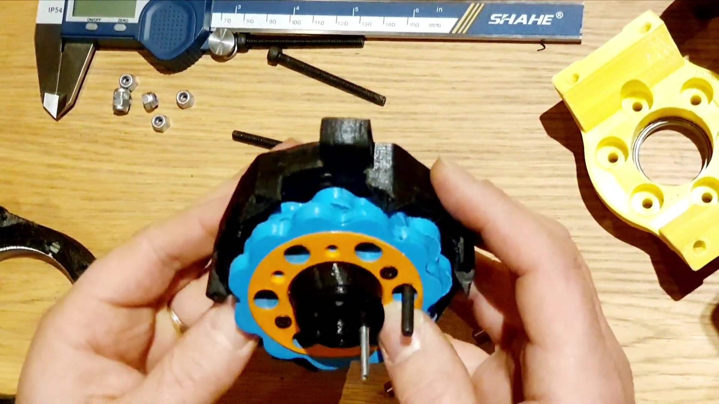
reference/video/frames/20220108-CycloidaldriveAssembly/019.jpg
