cbiele/CyBot/reference/video/frames/20220108-CycloidaldriveAssembly/020.jpg

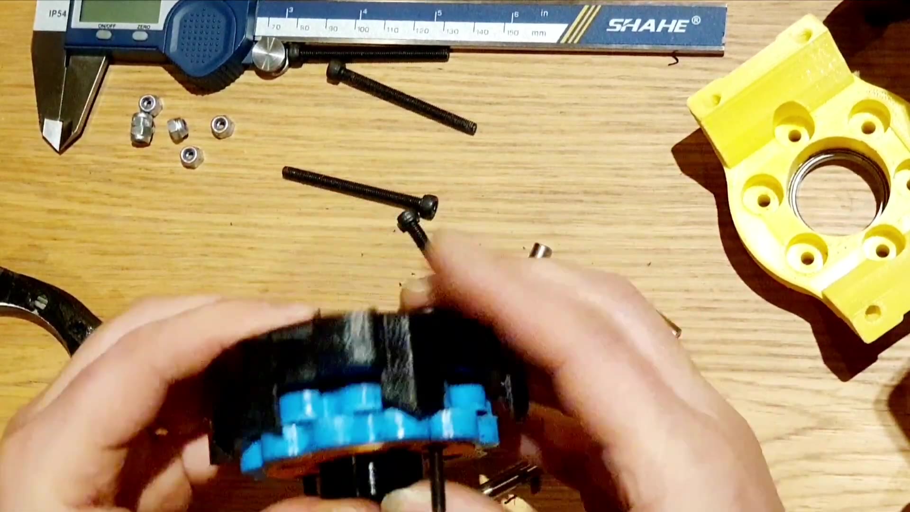
reference/video/frames/20220108-CycloidaldriveAssembly/020.jpg
