cbiele/CyBot/reference/video/frames/20220108-CycloidaldriveAssembly/021.jpg

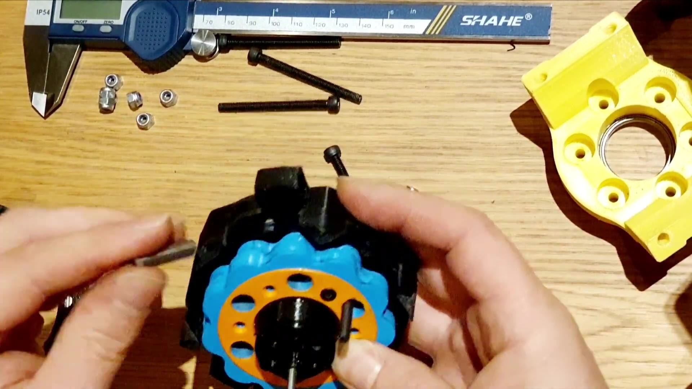
reference/video/frames/20220108-CycloidaldriveAssembly/021.jpg
