cbiele/CyBot/reference/video/frames/20220108-CycloidaldriveAssembly/022.jpg

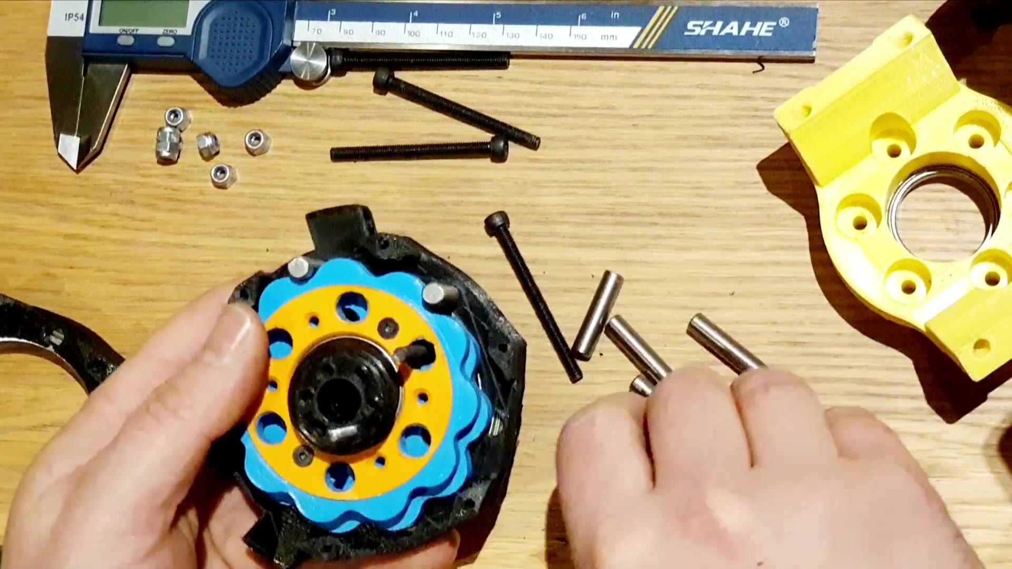
reference/video/frames/20220108-CycloidaldriveAssembly/022.jpg
