cbiele/CyBot/reference/video/frames/20220108-CycloidaldriveAssembly/023.jpg

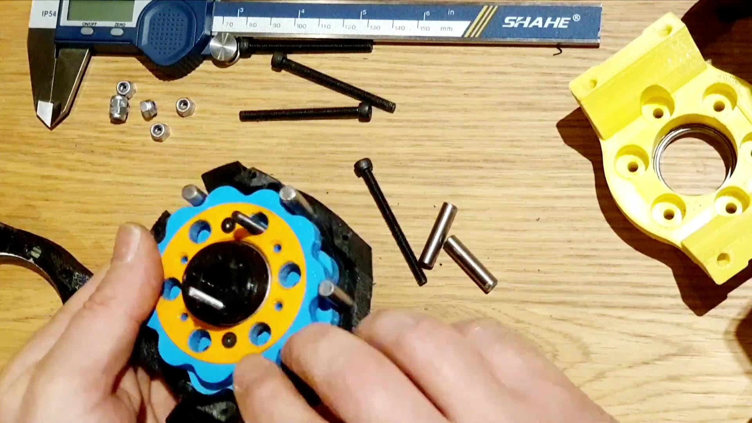
reference/video/frames/20220108-CycloidaldriveAssembly/023.jpg
