cbiele/CyBot/reference/video/frames/20220108-CycloidaldriveAssembly/024.jpg

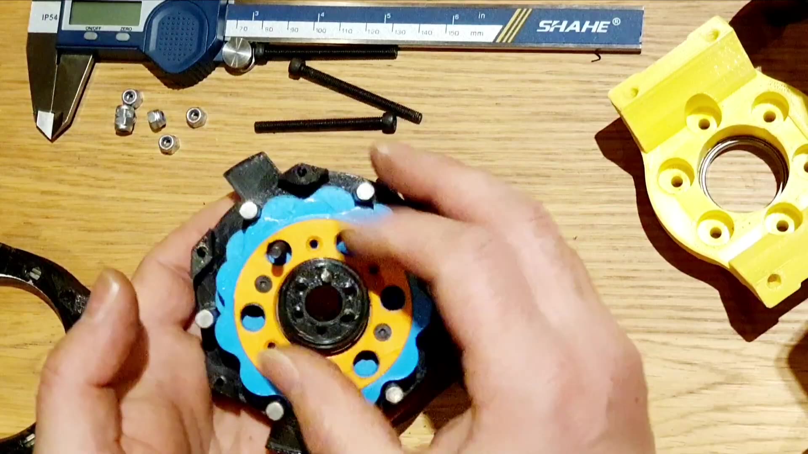
reference/video/frames/20220108-CycloidaldriveAssembly/024.jpg
