cbiele/CyBot/reference/video/frames/20220108-CycloidaldriveAssembly/025.jpg

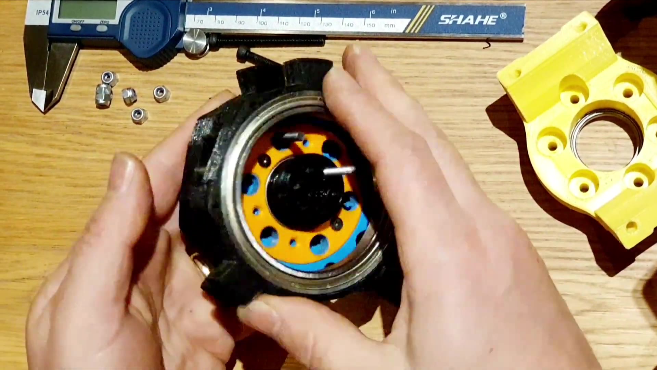
reference/video/frames/20220108-CycloidaldriveAssembly/025.jpg
