cbiele/CyBot/reference/video/frames/20220108-CycloidaldriveAssembly/026.jpg

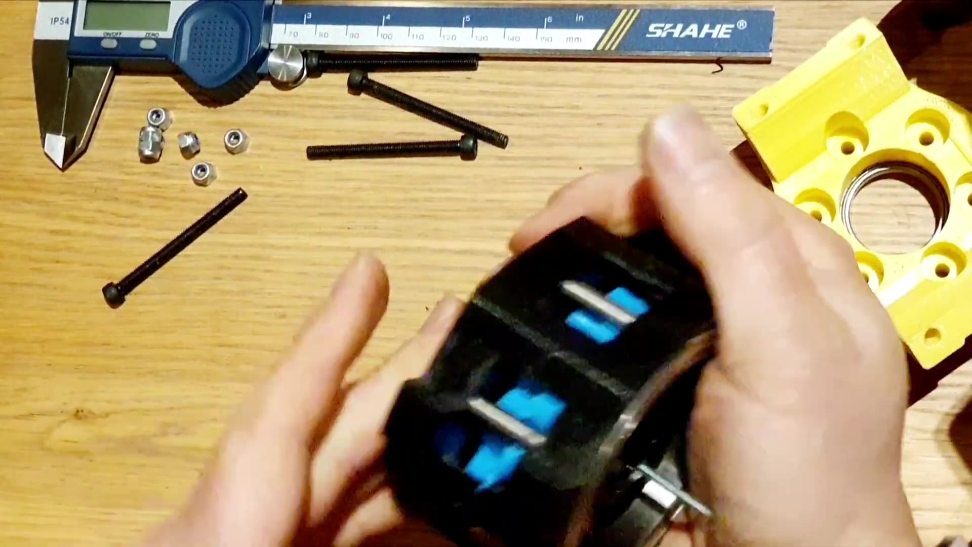
reference/video/frames/20220108-CycloidaldriveAssembly/026.jpg
