cbiele/CyBot/reference/video/frames/20220108-CycloidaldriveAssembly/027.jpg

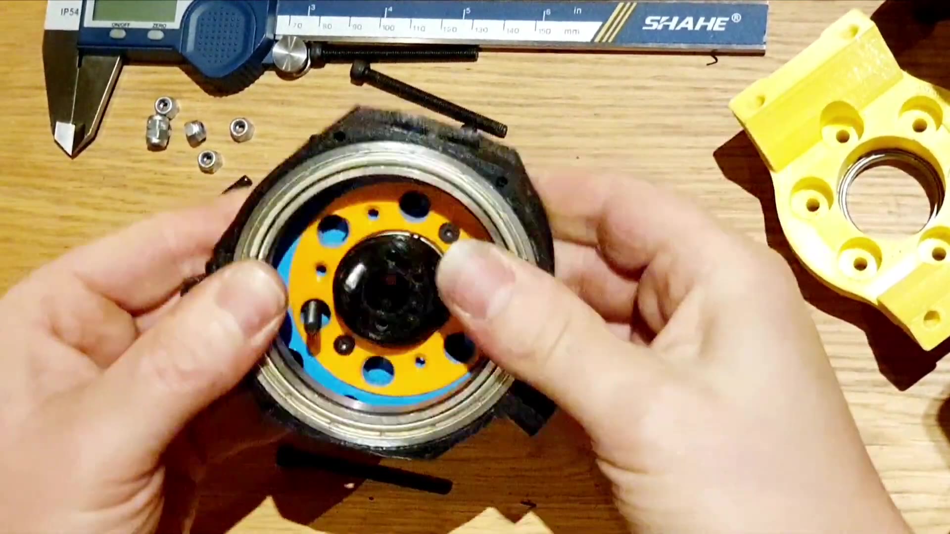
reference/video/frames/20220108-CycloidaldriveAssembly/027.jpg
