cbiele/CyBot/reference/video/frames/20220108-CycloidaldriveAssembly/028.jpg

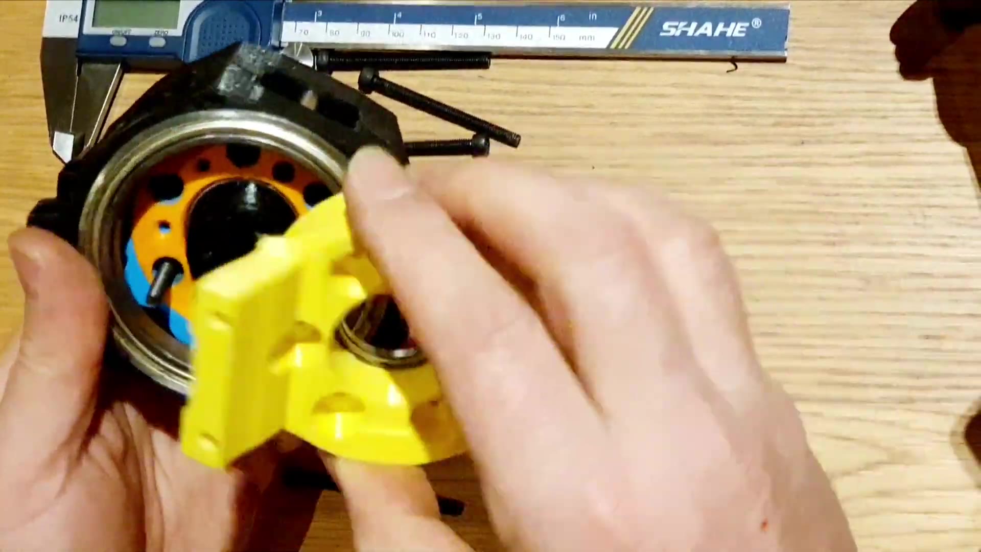
reference/video/frames/20220108-CycloidaldriveAssembly/028.jpg
