cbiele/CyBot/reference/video/frames/20220108-CycloidaldriveAssembly/029.jpg

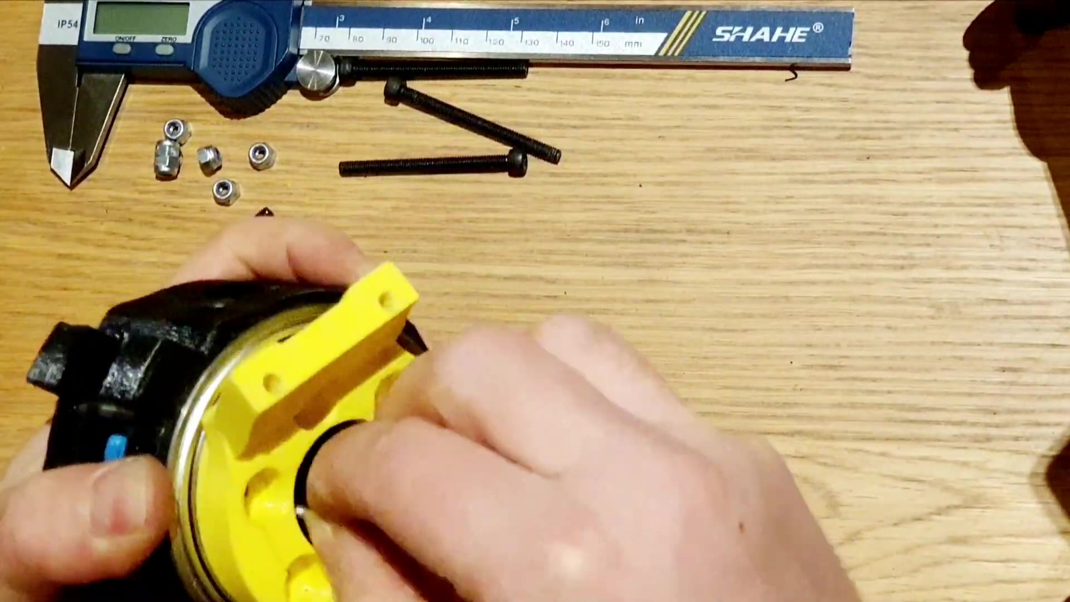
reference/video/frames/20220108-CycloidaldriveAssembly/029.jpg
