cbiele/CyBot/reference/video/frames/20220108-CycloidaldriveAssembly/030.jpg

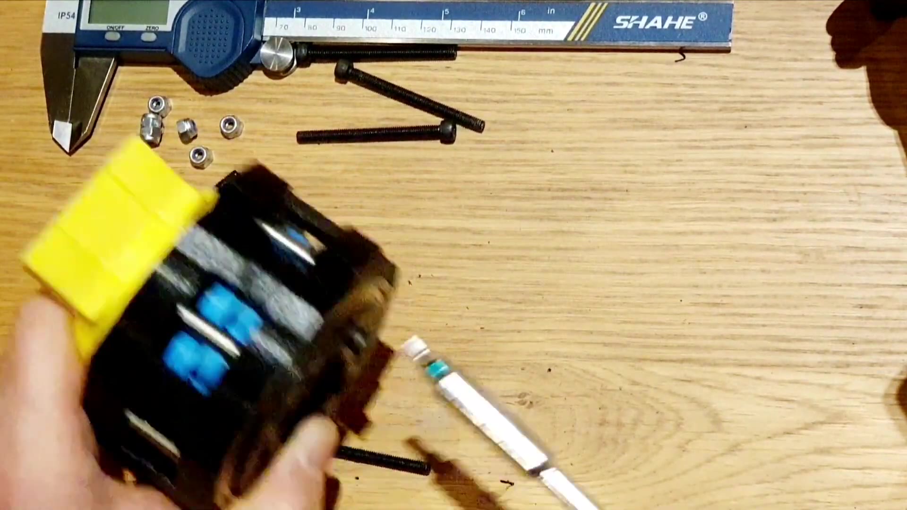
reference/video/frames/20220108-CycloidaldriveAssembly/030.jpg
