cbiele/CyBot/reference/video/frames/20220108-CycloidaldriveAssembly/031.jpg

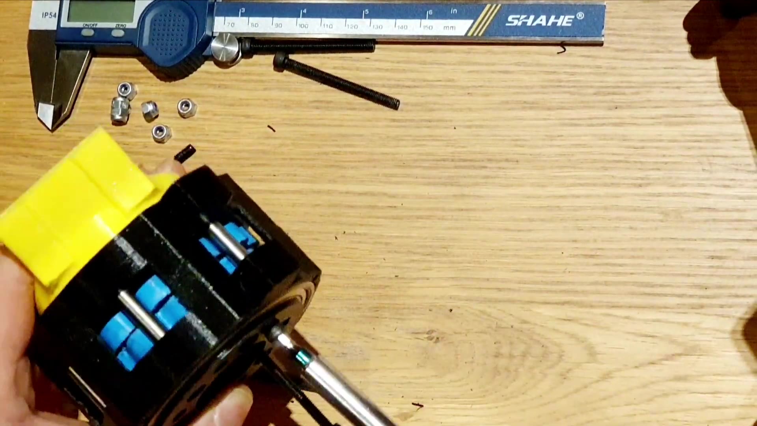
reference/video/frames/20220108-CycloidaldriveAssembly/031.jpg
