cbiele/CyBot/reference/video/frames/20220108-CycloidaldriveAssembly/032.jpg

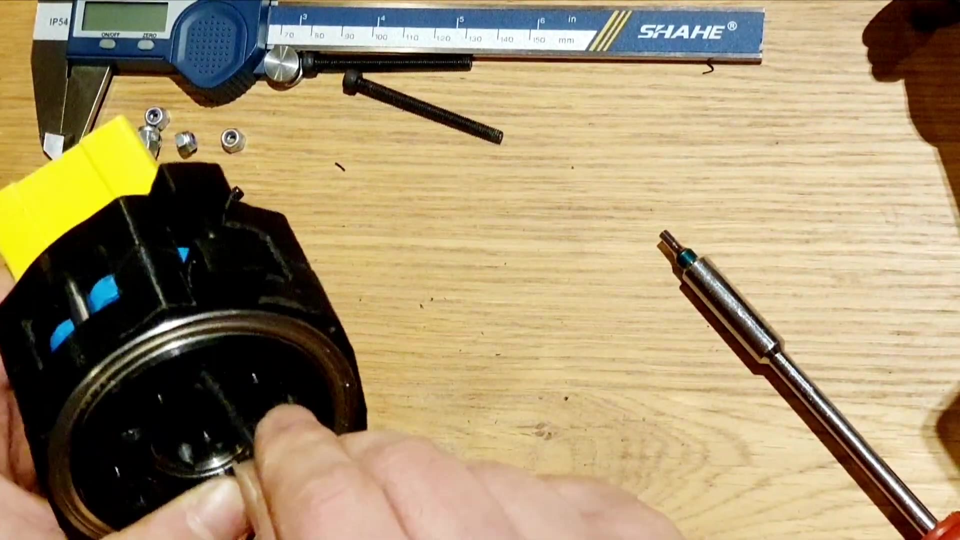
reference/video/frames/20220108-CycloidaldriveAssembly/032.jpg
