cbiele/CyBot/reference/video/frames/20220108-CycloidaldriveAssembly/033.jpg

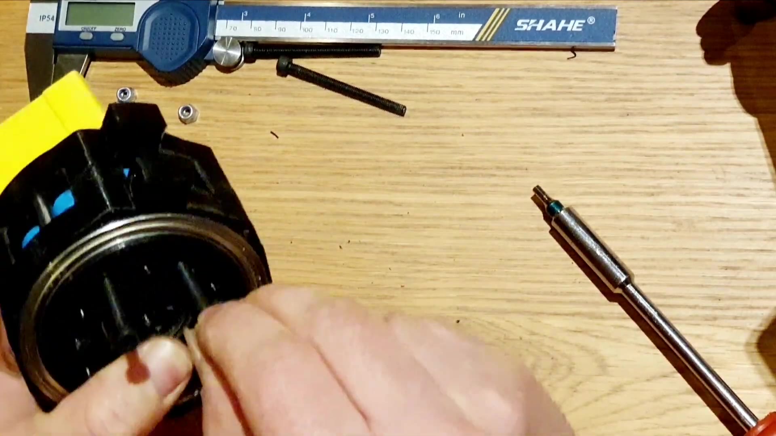
reference/video/frames/20220108-CycloidaldriveAssembly/033.jpg
