cbiele/CyBot/reference/video/frames/20220108-CycloidaldriveAssembly/034.jpg

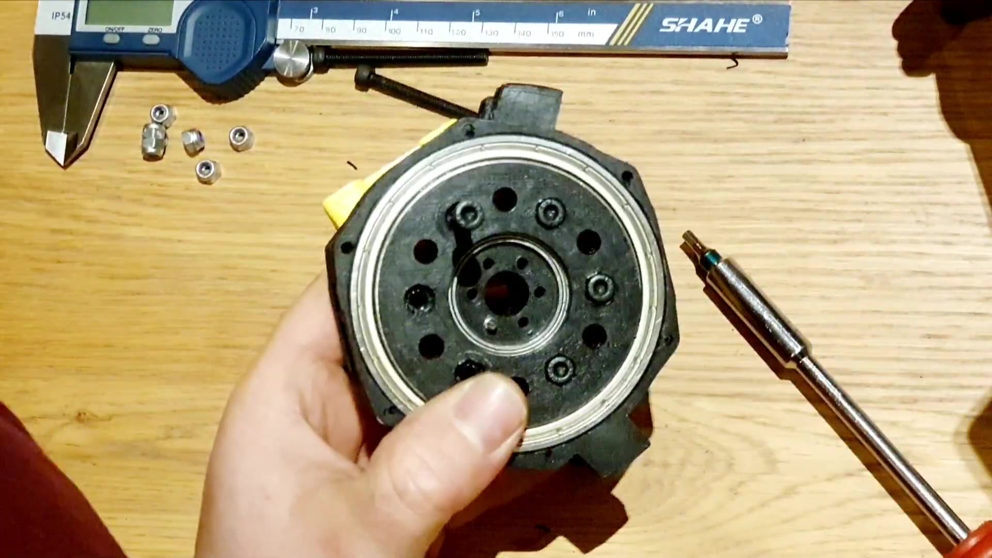
reference/video/frames/20220108-CycloidaldriveAssembly/034.jpg
