cbiele/CyBot/reference/video/frames/20220108-CycloidaldriveAssembly/035.jpg

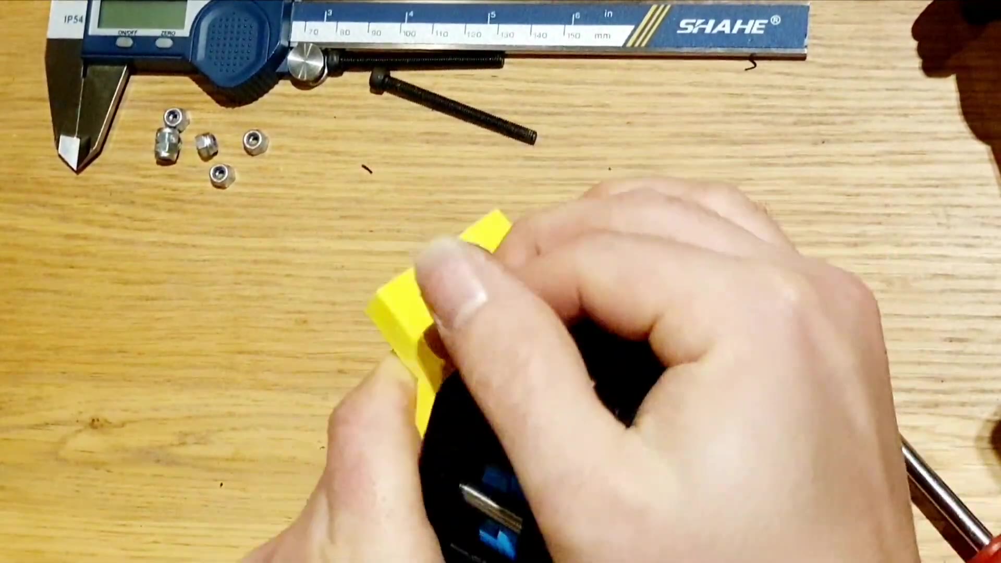
reference/video/frames/20220108-CycloidaldriveAssembly/035.jpg
