cbiele/CyBot/reference/video/frames/20220108-CycloidaldriveAssembly/036.jpg

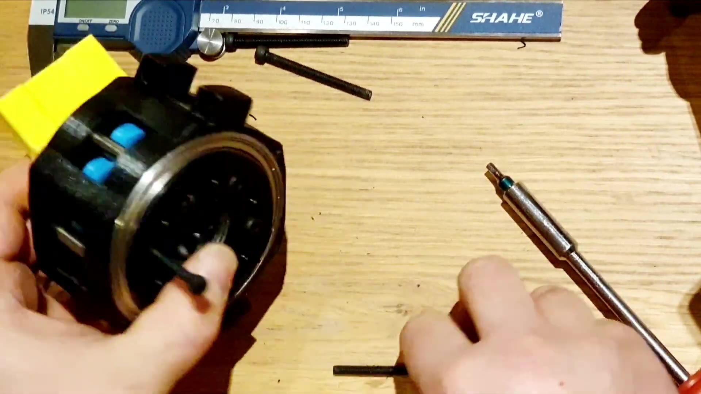
reference/video/frames/20220108-CycloidaldriveAssembly/036.jpg
