cbiele/CyBot/reference/video/frames/20220108-CycloidaldriveAssembly/037.jpg

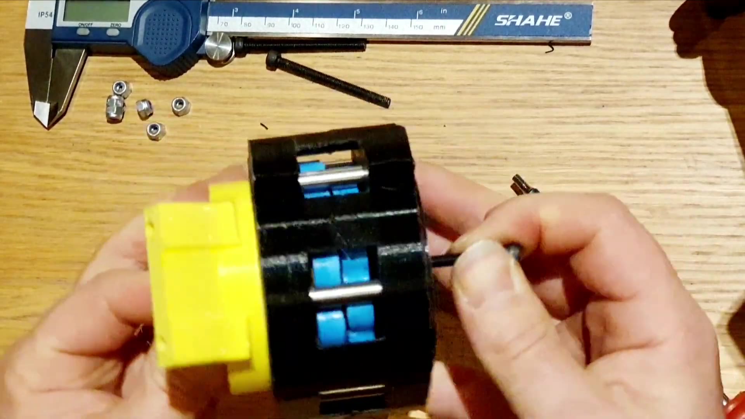
reference/video/frames/20220108-CycloidaldriveAssembly/037.jpg
