cbiele/CyBot/reference/video/frames/20220108-CycloidaldriveAssembly/038.jpg

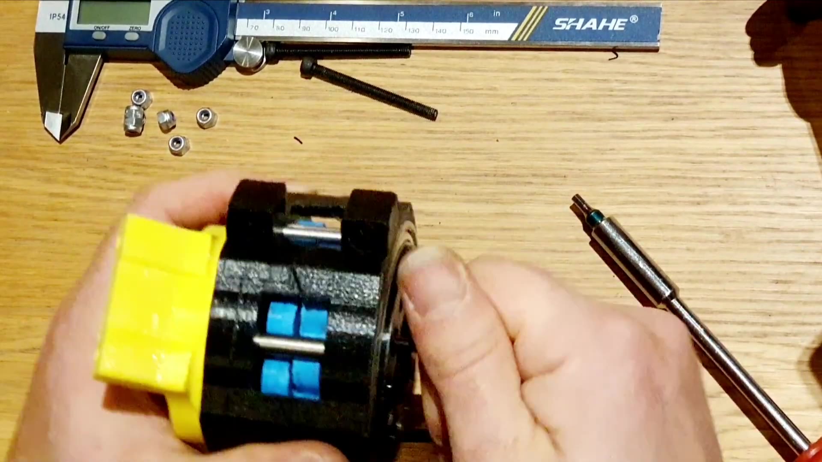
reference/video/frames/20220108-CycloidaldriveAssembly/038.jpg
