cbiele/CyBot/reference/video/frames/20220108-CycloidaldriveAssembly/039.jpg

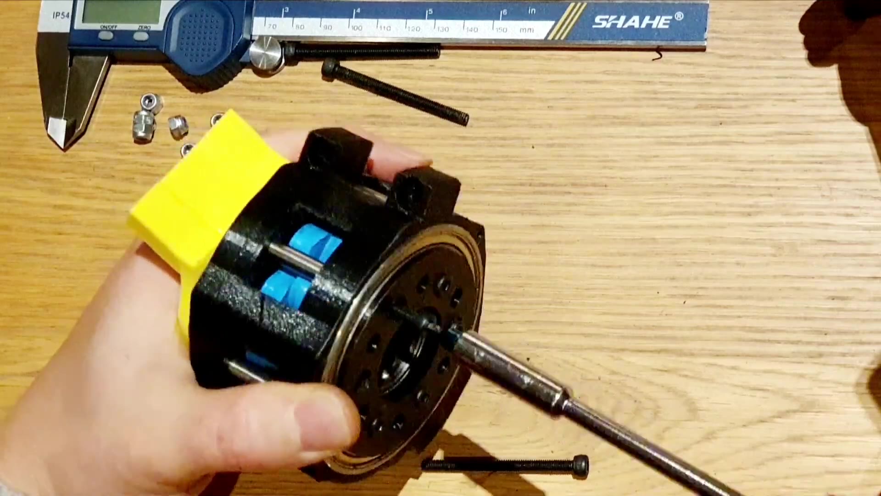
reference/video/frames/20220108-CycloidaldriveAssembly/039.jpg
