cbiele/CyBot/reference/video/frames/20220108-CycloidaldriveAssembly/040.jpg

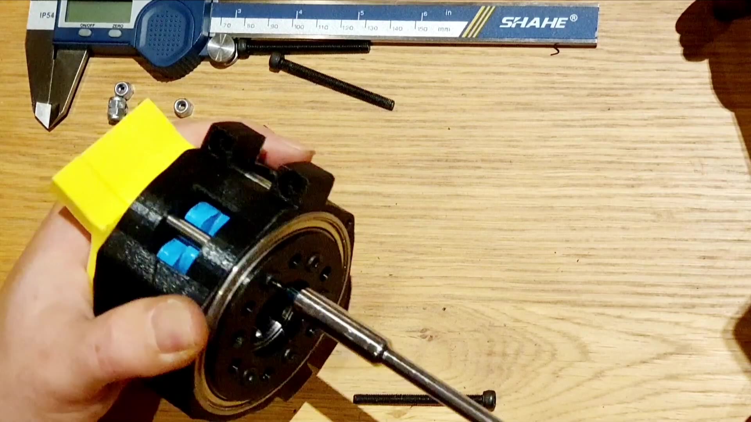
reference/video/frames/20220108-CycloidaldriveAssembly/040.jpg
