cbiele/CyBot/reference/video/frames/20220108-CycloidaldriveAssembly/041.jpg

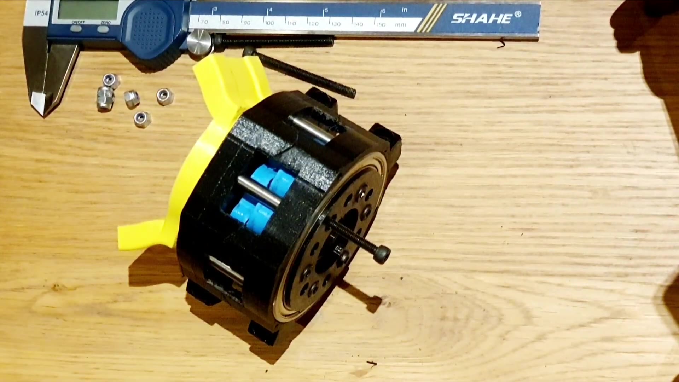
reference/video/frames/20220108-CycloidaldriveAssembly/041.jpg
