cbiele/CyBot/reference/video/frames/20220108-CycloidaldriveAssembly/042.jpg

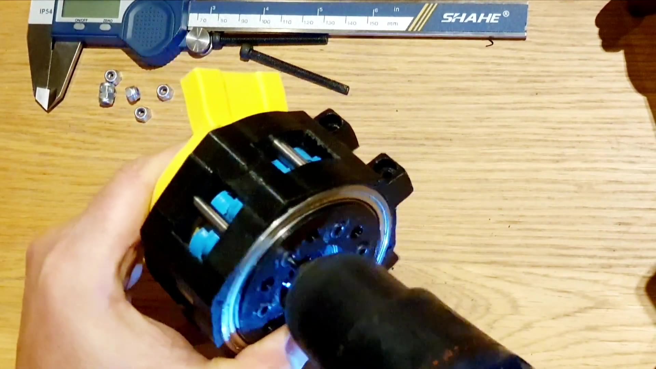
reference/video/frames/20220108-CycloidaldriveAssembly/042.jpg
