cbiele/CyBot/reference/video/frames/20220108-CycloidaldriveAssembly/043.jpg

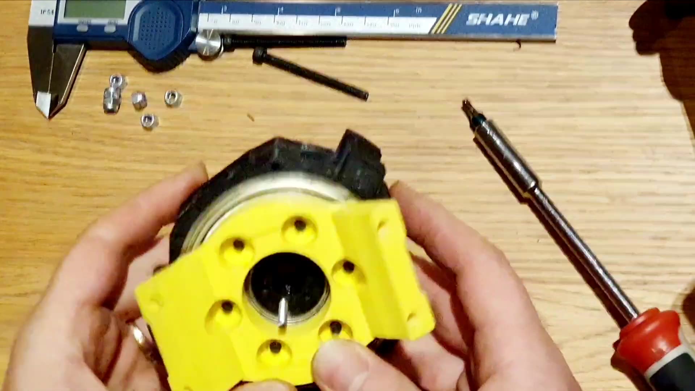
reference/video/frames/20220108-CycloidaldriveAssembly/043.jpg
