cbiele/CyBot/reference/video/frames/20220108-CycloidaldriveAssembly/044.jpg

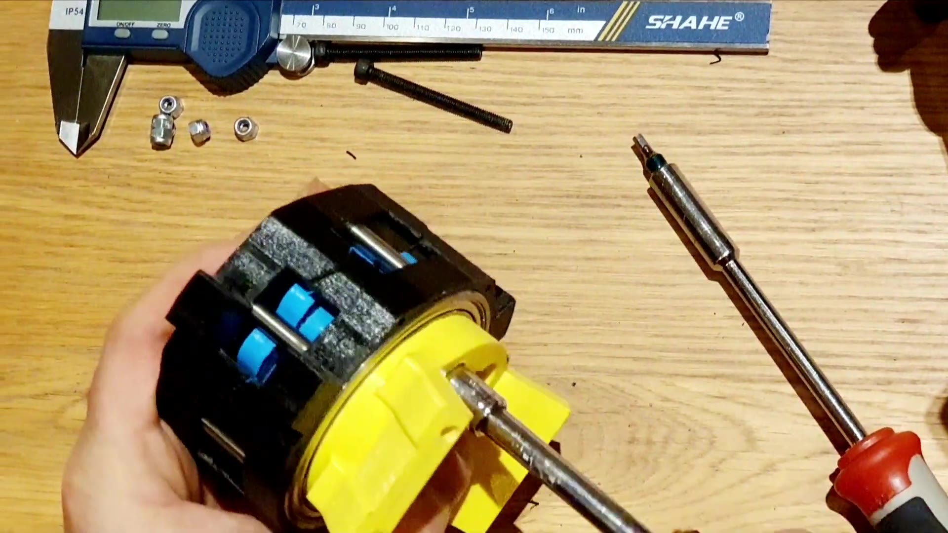
reference/video/frames/20220108-CycloidaldriveAssembly/044.jpg
