cbiele/CyBot/reference/video/frames/20220108-CycloidaldriveAssembly/045.jpg

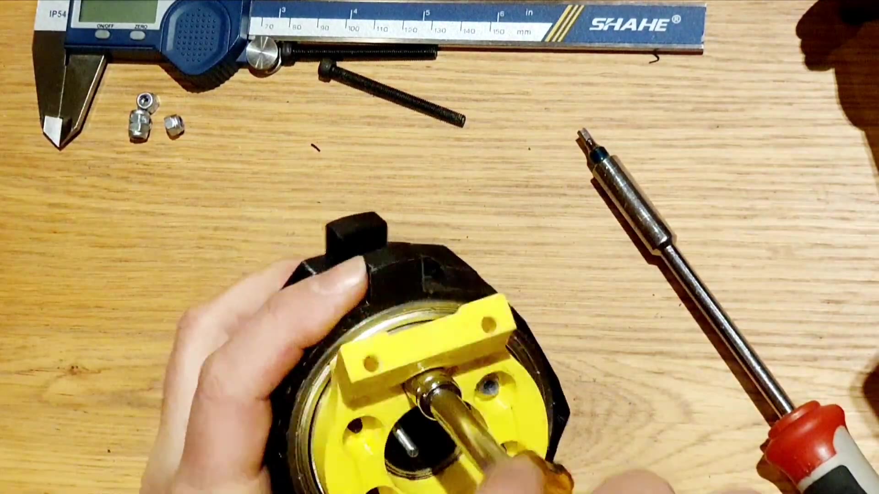
reference/video/frames/20220108-CycloidaldriveAssembly/045.jpg
