cbiele/CyBot/reference/video/frames/20220108-CycloidaldriveAssembly/046.jpg

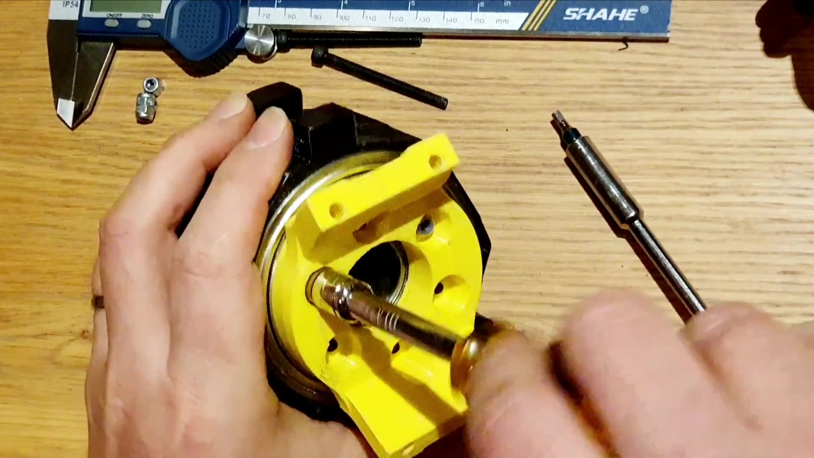
reference/video/frames/20220108-CycloidaldriveAssembly/046.jpg
