cbiele/CyBot/reference/video/frames/20220108-CycloidaldriveAssembly/047.jpg

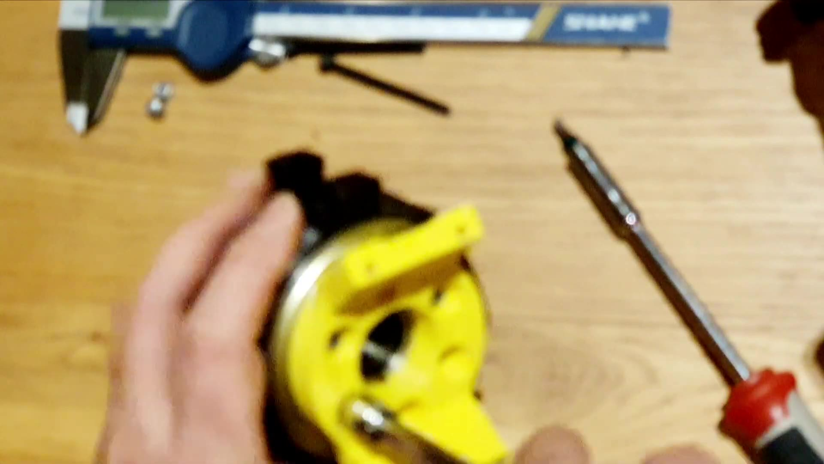
reference/video/frames/20220108-CycloidaldriveAssembly/047.jpg
