cbiele/CyBot/reference/video/frames/20220108-CycloidaldriveAssembly/048.jpg

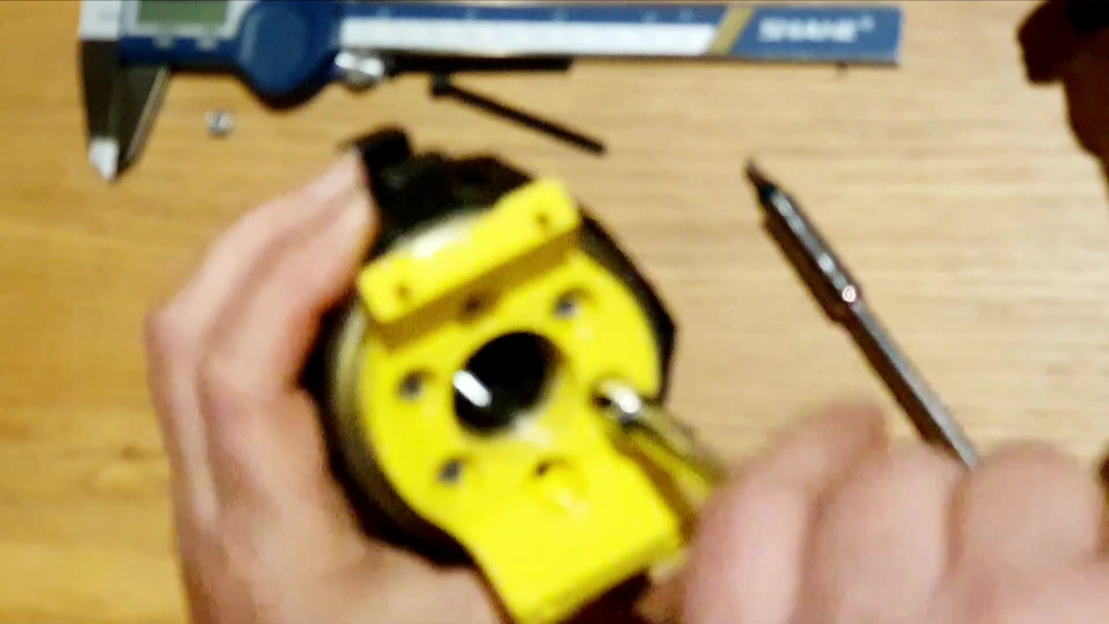
reference/video/frames/20220108-CycloidaldriveAssembly/048.jpg
