cbiele/CyBot/reference/video/frames/20220108-CycloidaldriveAssembly/049.jpg

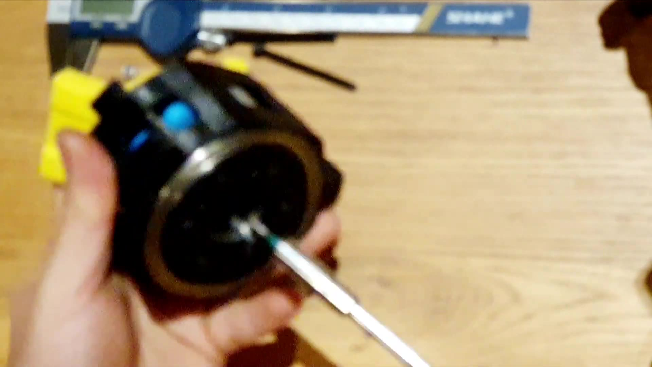
reference/video/frames/20220108-CycloidaldriveAssembly/049.jpg
