cbiele/CyBot/reference/video/frames/20220108-CycloidaldriveAssembly/050.jpg

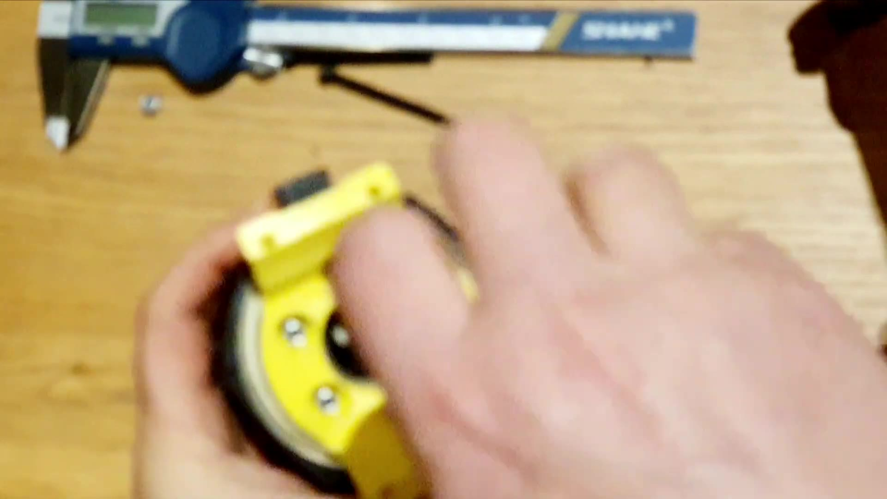
reference/video/frames/20220108-CycloidaldriveAssembly/050.jpg
