cbiele/CyBot/reference/video/frames/20220108-CycloidaldriveAssembly/051.jpg

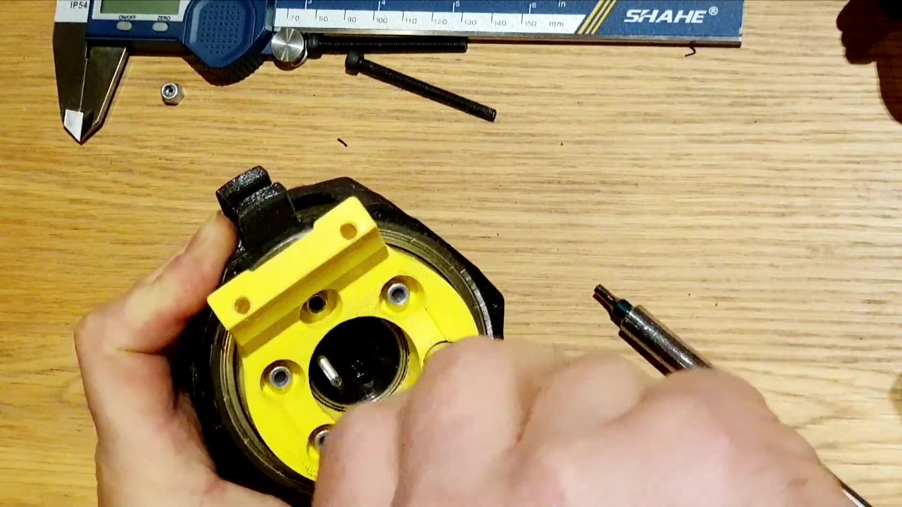
reference/video/frames/20220108-CycloidaldriveAssembly/051.jpg
