cbiele/CyBot/reference/video/frames/20220108-CycloidaldriveAssembly/053.jpg

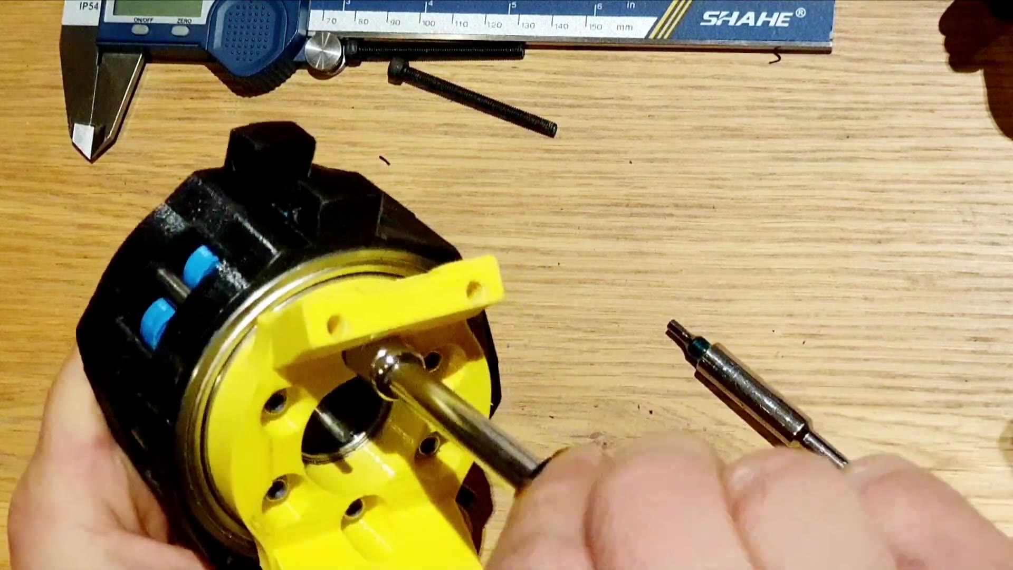
reference/video/frames/20220108-CycloidaldriveAssembly/053.jpg
