cbiele/CyBot/reference/video/frames/20220108-CycloidaldriveAssembly/054.jpg

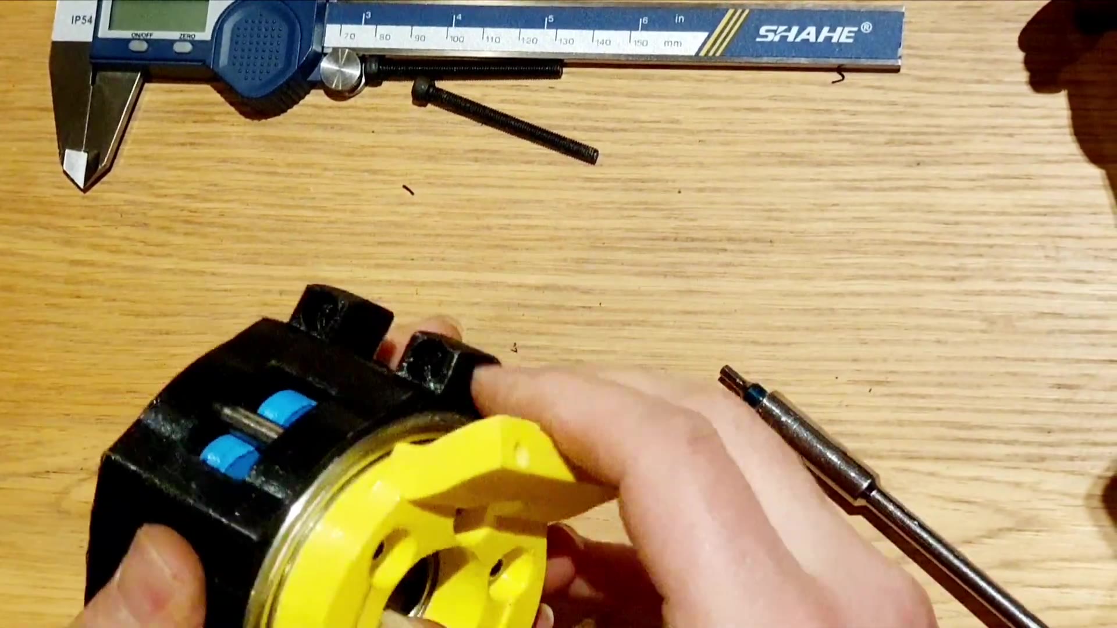
reference/video/frames/20220108-CycloidaldriveAssembly/054.jpg
