cbiele/CyBot/reference/video/frames/20220108-CycloidaldriveAssembly/055.jpg

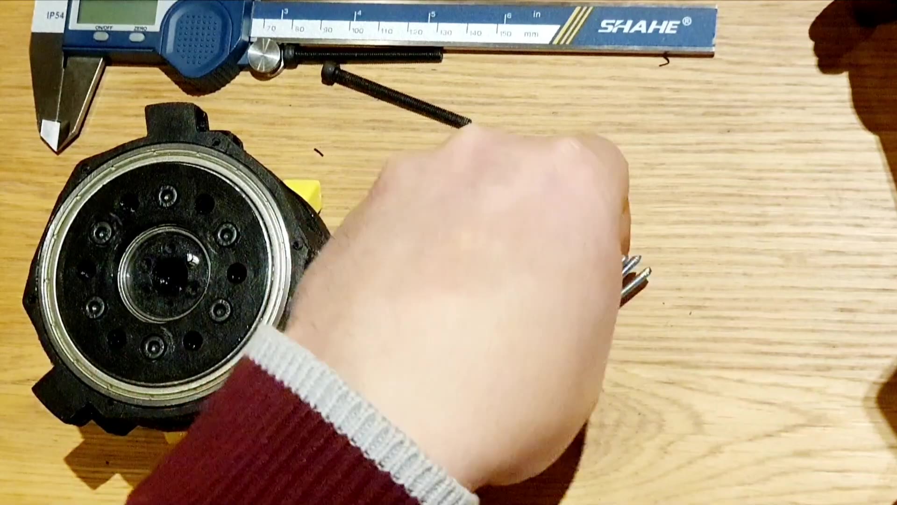
reference/video/frames/20220108-CycloidaldriveAssembly/055.jpg
