cbiele/CyBot/reference/video/frames/20220108-CycloidaldriveAssembly/056.jpg

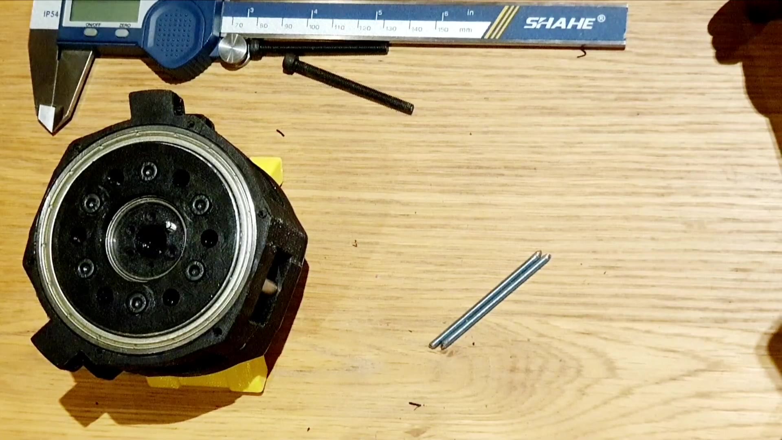
reference/video/frames/20220108-CycloidaldriveAssembly/056.jpg
