cbiele/CyBot/reference/video/frames/20220108-CycloidaldriveAssembly/057.jpg

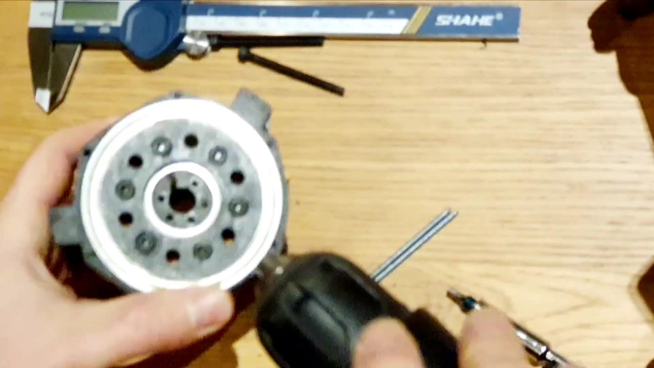
reference/video/frames/20220108-CycloidaldriveAssembly/057.jpg
