cbiele/CyBot/reference/video/frames/20220108-CycloidaldriveAssembly/058.jpg

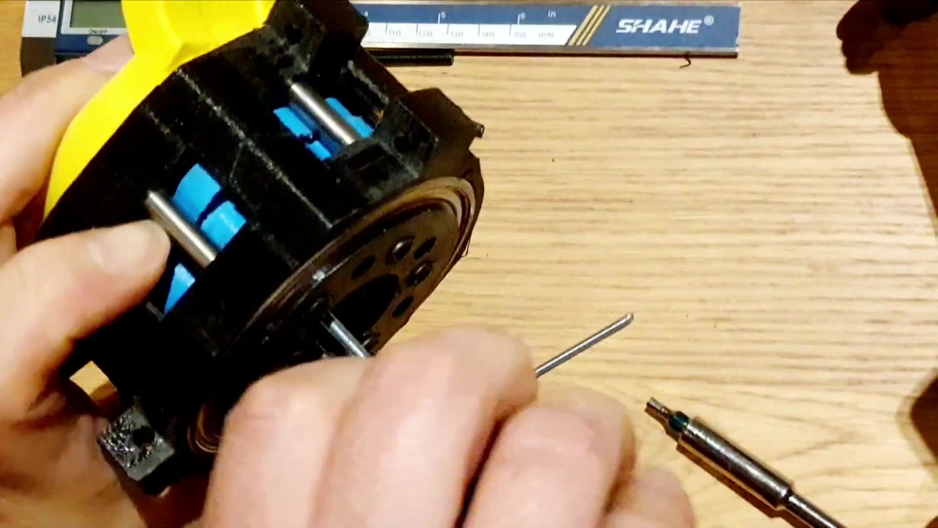
reference/video/frames/20220108-CycloidaldriveAssembly/058.jpg
