cbiele/CyBot/reference/video/frames/20220108-CycloidaldriveAssembly/059.jpg

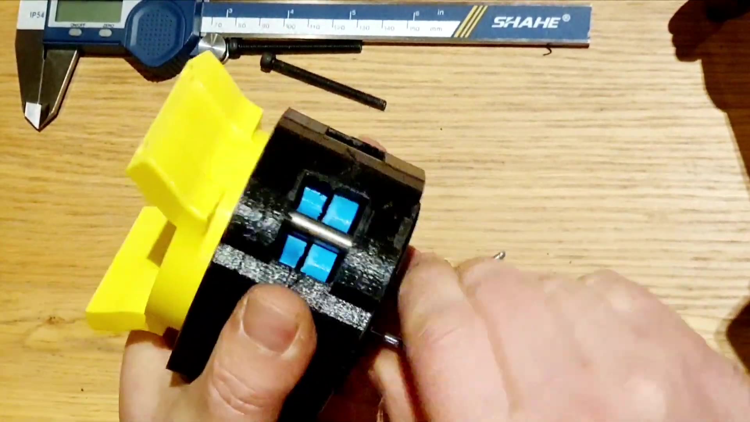
reference/video/frames/20220108-CycloidaldriveAssembly/059.jpg
