cbiele/CyBot/reference/video/frames/20220108-CycloidaldriveAssembly/060.jpg

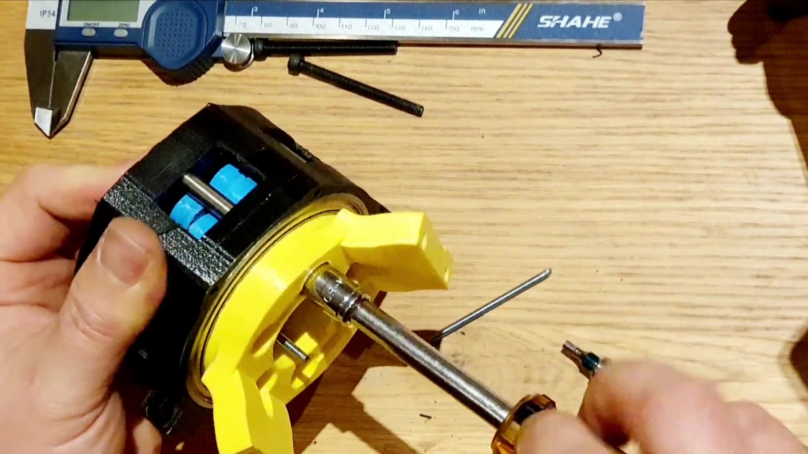
reference/video/frames/20220108-CycloidaldriveAssembly/060.jpg
