cbiele/CyBot/reference/video/frames/20220108-CycloidaldriveAssembly/061.jpg

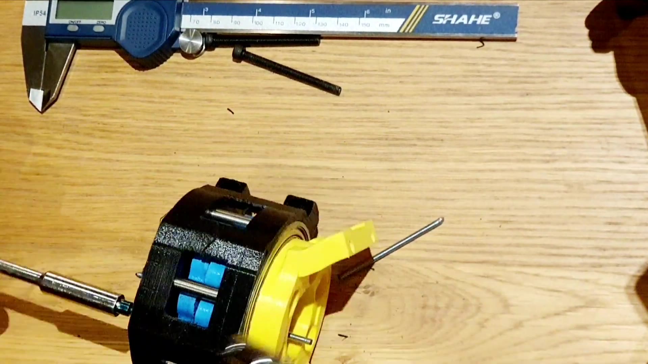
reference/video/frames/20220108-CycloidaldriveAssembly/061.jpg
