cbiele/CyBot/reference/video/frames/20220108-CycloidaldriveAssembly/062.jpg

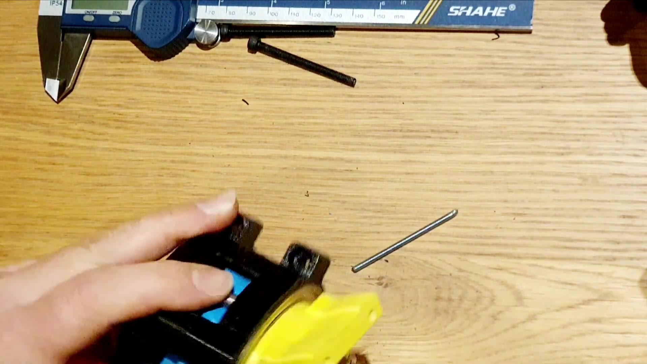
reference/video/frames/20220108-CycloidaldriveAssembly/062.jpg
