cbiele/CyBot/reference/video/frames/20220108-CycloidaldriveAssembly/063.jpg

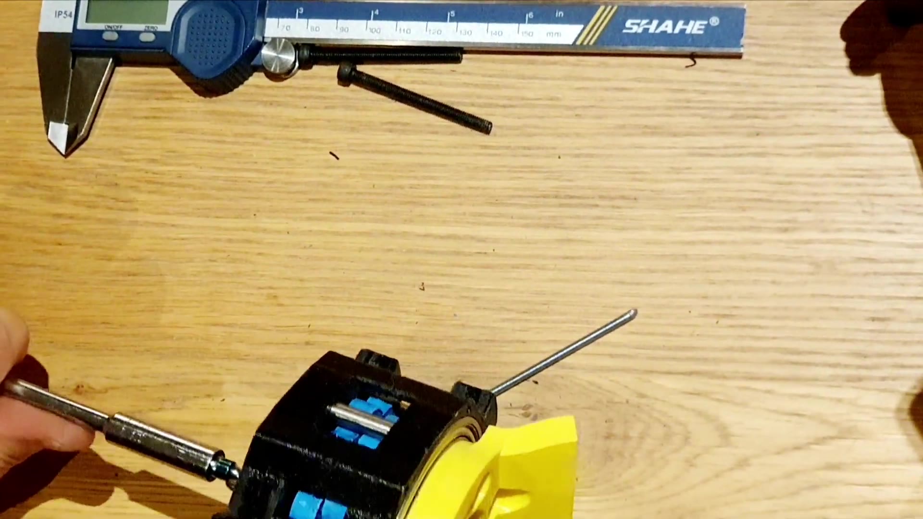
reference/video/frames/20220108-CycloidaldriveAssembly/063.jpg
