cbiele/CyBot/reference/video/frames/20220108-CycloidaldriveAssembly/064.jpg

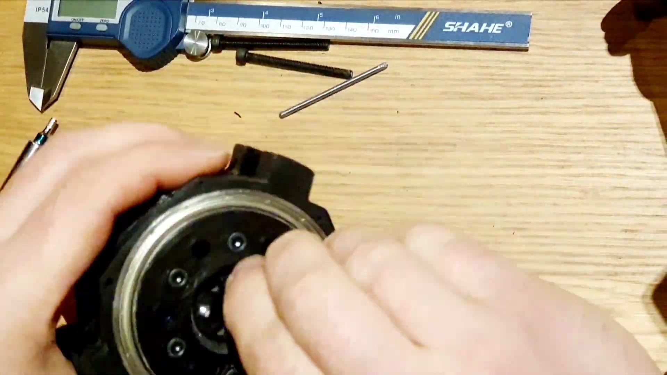
reference/video/frames/20220108-CycloidaldriveAssembly/064.jpg
