cbiele/CyBot/reference/video/frames/20220108-CycloidaldriveAssembly/065.jpg

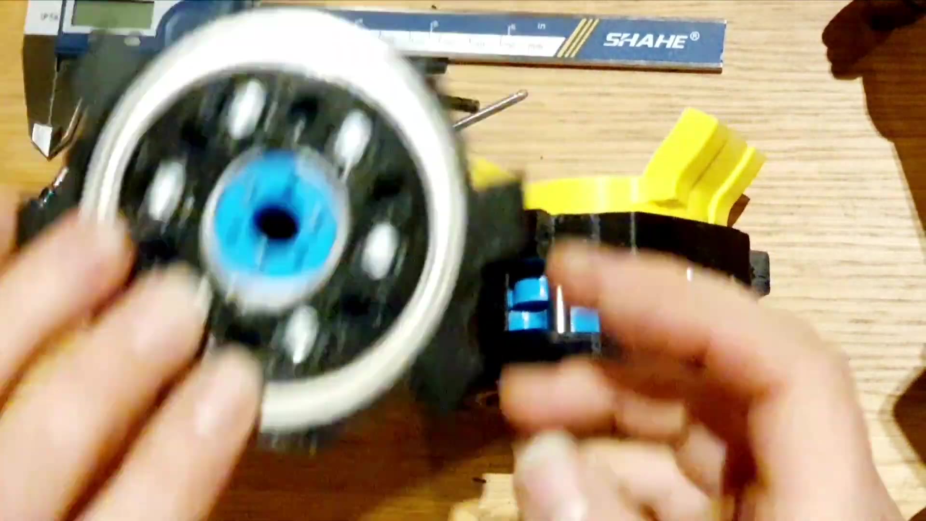
reference/video/frames/20220108-CycloidaldriveAssembly/065.jpg
