cbiele/CyBot/reference/video/frames/20220108-CycloidaldriveAssembly/066.jpg

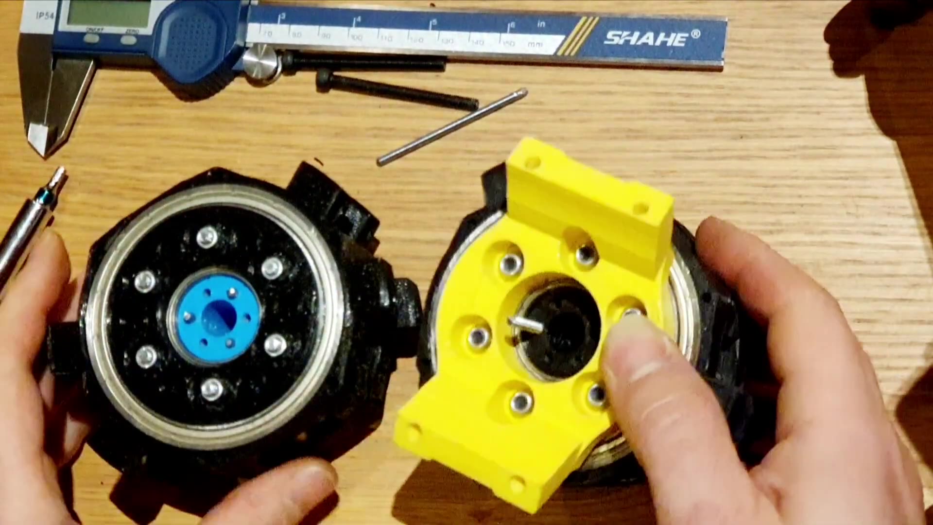
reference/video/frames/20220108-CycloidaldriveAssembly/066.jpg
