cbiele/CyBot/reference/video/frames/20220602-CyBoTBodybuildingexercic-sheet.jpg

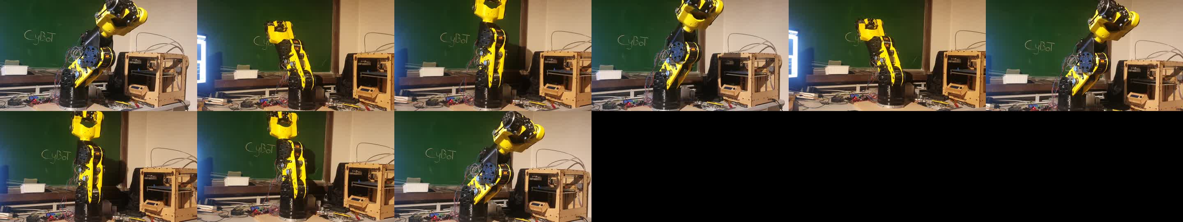
reference/video/frames/20220602-CyBoTBodybuildingexercic-sheet.jpg
