cbiele/CyBot/reference/video/frames/20220602-CyBoTBodybuildingexercic/001.jpg

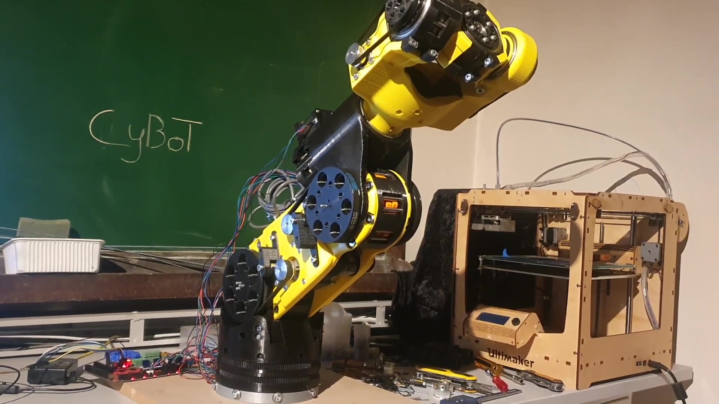
reference/video/frames/20220602-CyBoTBodybuildingexercic/001.jpg
