cbiele/CyBot/reference/video/frames/20220602-CyBoTBodybuildingexercic/002.jpg

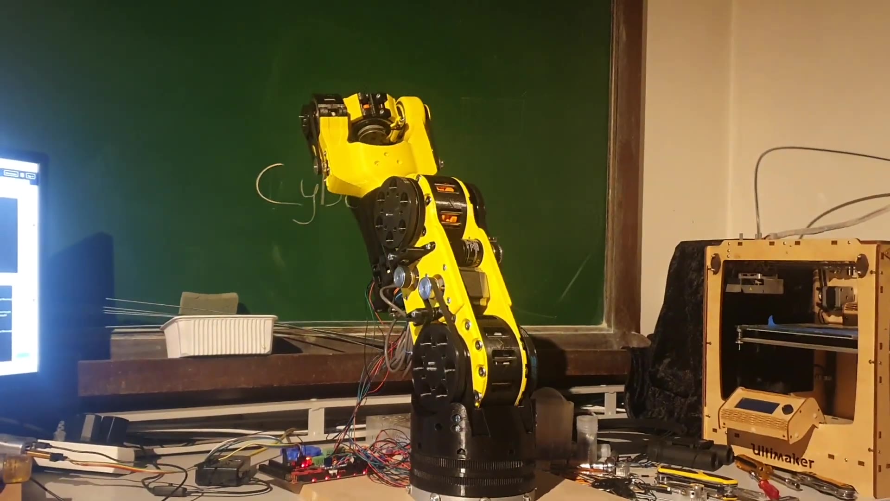
reference/video/frames/20220602-CyBoTBodybuildingexercic/002.jpg
