cbiele/CyBot/reference/video/frames/20220602-CyBoTBodybuildingexercic/003.jpg

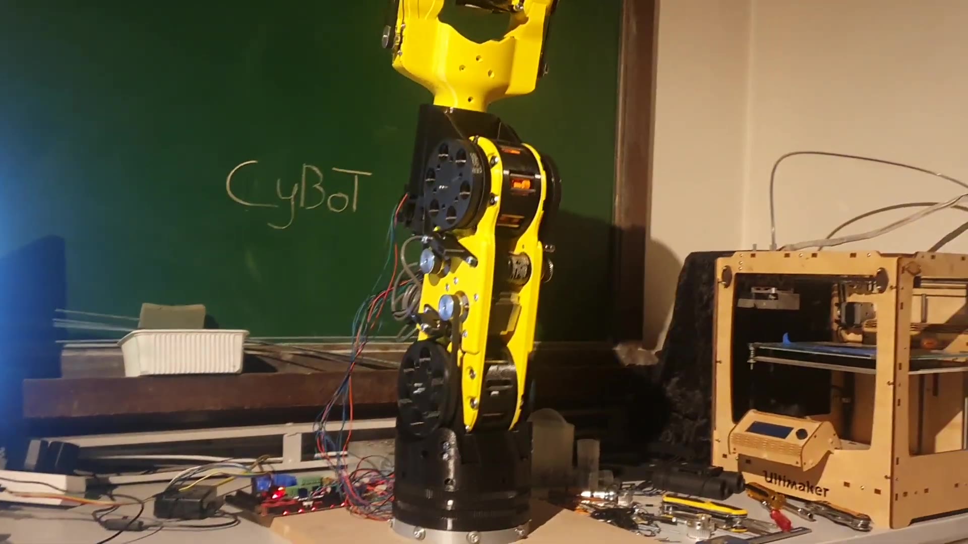
reference/video/frames/20220602-CyBoTBodybuildingexercic/003.jpg
