cbiele/CyBot/reference/video/frames/20220602-CyBoTBodybuildingexercic/004.jpg

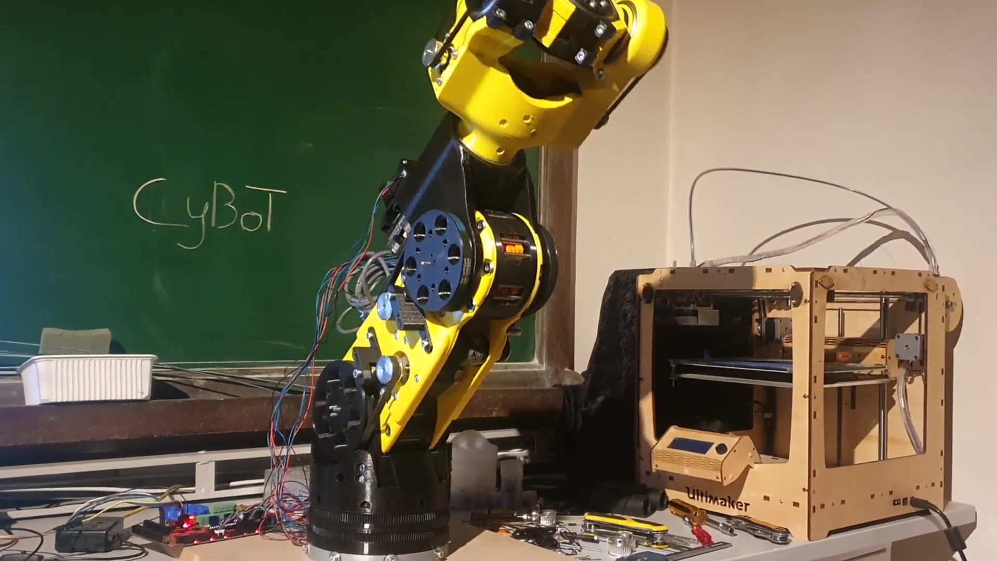
reference/video/frames/20220602-CyBoTBodybuildingexercic/004.jpg
