cbiele/CyBot/reference/video/frames/20220602-CyBoTBodybuildingexercic/005.jpg

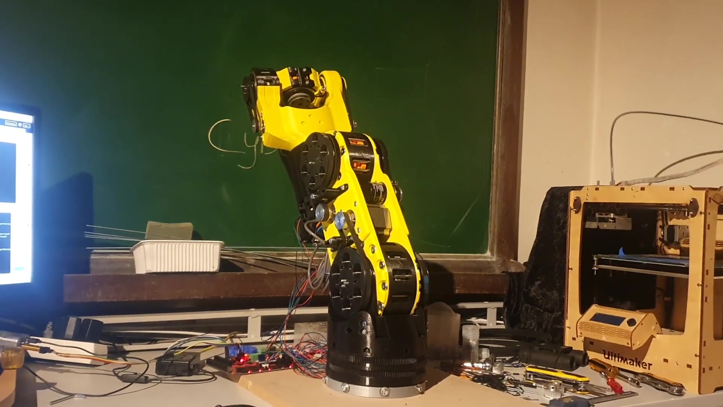
reference/video/frames/20220602-CyBoTBodybuildingexercic/005.jpg
