cbiele/CyBot/reference/video/frames/20220602-CyBoTBodybuildingexercic/006.jpg

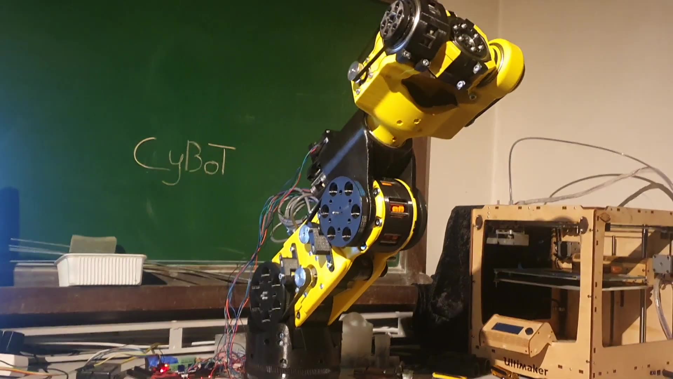
reference/video/frames/20220602-CyBoTBodybuildingexercic/006.jpg
