cbiele/CyBot/reference/video/frames/20220602-CyBoTBodybuildingexercic/007.jpg

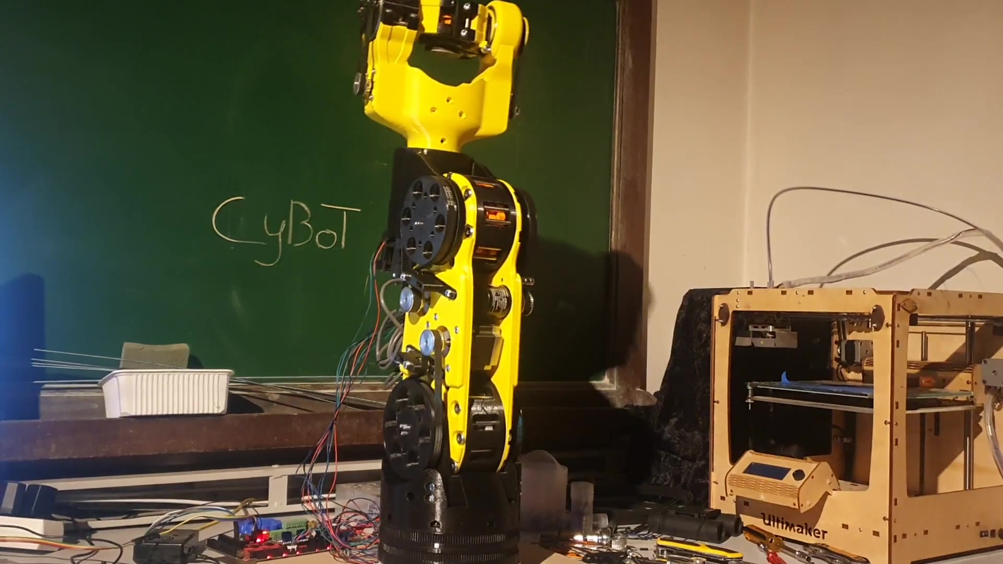
reference/video/frames/20220602-CyBoTBodybuildingexercic/007.jpg
