cbiele/CyBot/reference/video/frames/20220602-CyBoTBodybuildingexercic/008.jpg

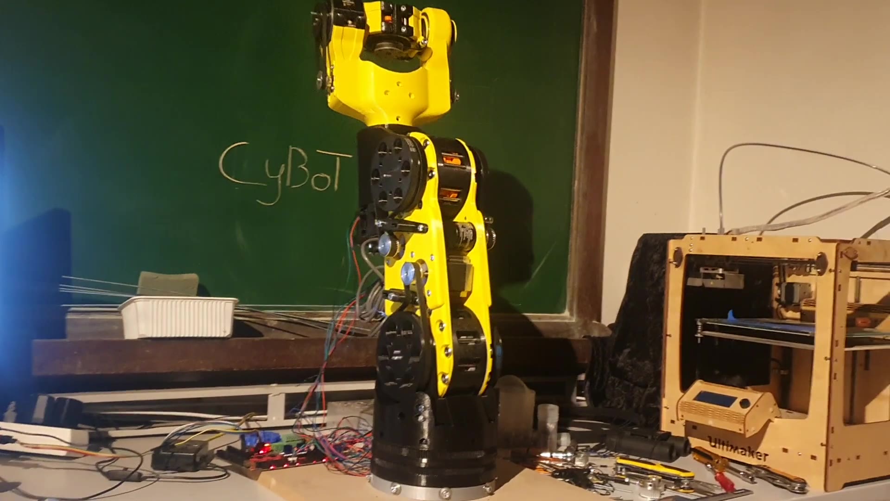
reference/video/frames/20220602-CyBoTBodybuildingexercic/008.jpg
