cbiele/CyBot/reference/video/frames/20220602-CyBoTBodybuildingexercic/009.jpg

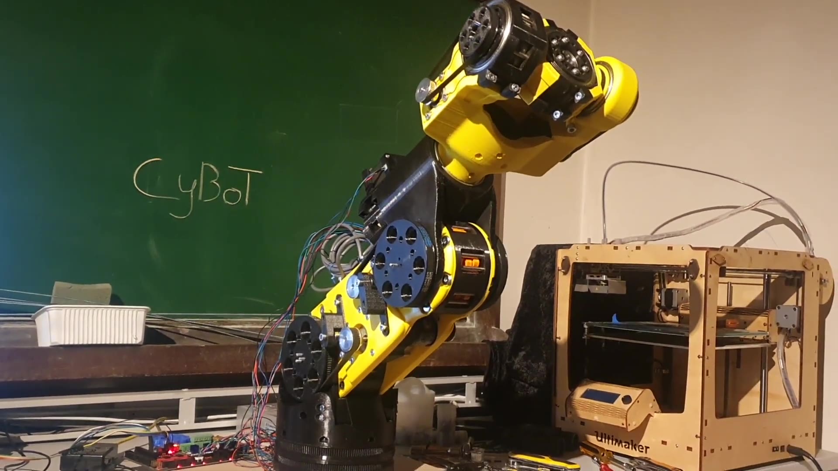
reference/video/frames/20220602-CyBoTBodybuildingexercic/009.jpg
