cbiele/CyBot/reference/cybot/GIT_HISTORY.txt

2022-06-08 b1c49fc Update cybot_demo.py
2022-06-08 d192ba7 Update cybot_demo.py
2022-06-08 7e09774 Update cybot_demo.py
2022-06-08 a09f39a Update cybot_demo.py
2022-06-08 779bd00 Update cybot_demo.py
2022-06-08 468cdbe Update cybot_demo.py
2022-06-08 4efd7d1 Update cybot_demo.py
2022-06-08 d16d87a Update cybot_demo.py
2022-06-08 d52945c Update cybot_demo.py
2022-06-08 b000a32 Update cybot_demo.py
2022-06-08 5a5b7f2 Update cybot_demo.py
2022-06-08 74d2126 Update cybot_demo.py
2022-06-08 bcbb124 Update cybot_demo.py
2022-06-08 cc8076a add demo
2022-06-08 4ab9f7c Update cybot_test.py
2022-06-08 e82e18f Update cybot_test.py
2022-06-08 8f4d712 Update cybot_test.py
2022-06-08 e231910 Update cybot_test.py
2022-06-08 5c6911f Update cybot_test.py
2022-06-08 37a01ec Update cybot_test.py
2022-06-08 01ca61c Update cybot_test.py
2022-06-08 4e23d38 Update cybot_test.py
2022-06-08 60c75b6 Update cybot_test.py
2022-06-08 f515052 Update cybot_test.py
2022-06-08 d459582 Update cybot_test.py
2022-06-08 d9c1a5e Update cybot_test.py
2022-06-08 39c635c Update cybot_test.py
2022-06-08 ad01f95 Update cybot_test.py
2022-06-08 b4d5ea7 Update cybot_test.py
2022-06-08 59b28fe Update cybot_test.py
2022-06-08 c9a5692 Update cybot_test.py
2022-06-08 236dfe0 Update cybot_test.py
2022-06-08 d4f2490 Update cybot_test.py
2022-02-06 07a308c Update testUART.py
2022-02-06 67737b3 Update testUART.py
2022-02-06 bde0f2d Update testUART.py
2022-02-06 7b7e156 Update testUART.py
2022-02-06 6e82423 Update testUART.py
2022-02-06 2bb0a2a Update testUART.py
2022-02-06 6d805e9 Update testUART.py
2022-02-06 13764a4 Update testUART.py
2022-02-06 5f13201 Update testUART.py
2022-02-06 aa5c5c6 Update testUART.py
2022-02-06 1732937 Update testUART.py
2022-02-06 19befda Update testUART.py
2022-02-06 201cec5 Update testUART.py
2022-02-06 8af0f00 Update testUART.py
2022-02-06 055e39a Update testUART.py
2022-02-06 ed1a78b Update testUART.py
2022-02-06 a8720f7 Update testUART.py
2022-02-06 c4f142c Update testUART.py
2022-02-06 30cad3c Update testUART.py
2022-02-06 91c4b37 Update testUART.py
2022-02-06 fc2f3a2 Update testUART.py
2022-02-06 361212e Update testUART.py
2022-02-05 566db41 Update testUART.py
2022-02-05 a199038 Update testUART.py
2022-02-05 e96014c Update cybot_test_grbl.py
2022-02-05 580dcf9 Create testUART.py
2022-01-15 712f0af Update cybot_test_grbl.py
2022-01-15 2364fee Update cybot_test_grbl.py
2022-01-14 c75b2d3 Update cybot_test_grbl.py
2022-01-14 5282325 Update cybot_test_grbl.py
2022-01-14 f7f83d7 Update cybot_test_grbl.py
2022-01-14 a636656 Update cybot_test_grbl.py
2022-01-14 423aa76 Update cybot_test_grbl.py
2022-01-14 fa1ba1a Update cybot_test_grbl.py
2022-01-14 e6c5bc5 Update cybot_test_grbl.py
2022-01-14 dc920ee Update cybot_test_grbl.py
2022-01-14 6e72604 Update cybot_test_grbl.py
2022-01-14 1c0cd96 Update cybot_test_grbl.py
2022-01-14 0246c42 Update cybot_test_grbl.py
2022-01-14 12f5a88 Update cybot_test_grbl.py
2022-01-14 bf53aa8 Update cybot_test_grbl.py
2022-01-14 f2fee40 Update cybot_test_grbl.py
2022-01-14 08c5c68 Update cybot_test_grbl.py
2022-01-14 870c23e Update cybot_test_grbl.py
2022-01-14 1cfbb27 Update cybot_test_grbl.py
2022-01-14 7fabaea Update cybot_test_grbl.py
2022-01-14 10eff12 Create cybot_test_grbl.py
2022-01-14 b6757fa Create cybot_test.py
2022-01-14 201f6b7 Initial commit
