cbiele/CyBot/reference/cybot_arduino/GIT_HISTORY.txt

2023-11-13 a8b8ca1 Add files via upload
2023-11-13 8c29c98 Update README.md
2023-11-13 f66092c Update README.md
2023-11-13 0e4fabb Update README.md
2023-11-13 fca4c37 Update README.md
2023-11-13 dfe3be0 Update README.md
2023-11-13 93f8b99 Update README.md
2023-11-13 48cf891 Update README.md
2023-11-13 a002124 Update testCybotWithSpeedyStepper.ino
2023-11-13 7846263 Update README.md
2023-11-13 713caf9 Update README.md
2023-11-13 58418e3 Add files via upload
2023-11-13 0857466 Initial commit
