cbiele/CyBot/(commit log)

2026-09-06 Adopt MKS CAN smart-stepper architecture for the Cybot arm
    Bus-controlled SERVO42D/57D drivers fit the eight fast GPIOs the Heltec V4
    plus PakaNode carrier can spare, remove step timing from the ESP32-S3, and
    give every joint a closed loop. Records the D-086 carrier header handoff
    that made the pin budget possible.
    Claude-Session: https://claude.ai/code/session_018fYTXoXxwZhKFhTbj8K9t7
2026-09-06 Reconstruct the assembly from the STLs to settle motor fit and print quantities
    The Cults3D dump carried no assembly instructions worth the name, but the
    STLs still held their assembly coordinates. Registering them onto the
    author's URDF links gives a complete Blender model, a print list with
    quantities, and measured motor pockets: 61 mm for the NEMA23s, 55 mm at
    the gripper, everything else in open air. The bolt patterns also show the
    base motor is a NEMA17, not the NEMA23 the guide claims, so the driver
    order becomes two SERVO57D and five SERVO42D.
    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
2026-09-06 Record by-rule seating of the joints and the print-quantity exceptions
    The rigid group fit could not undo parts the author exported exploded or
    from their own part files, so the cycloid stacks, pulleys, axis-4 gearbox
    and axis-5 gearbox were seated against known anchors in the plates and
    the URDF. The gripper fingers and base feet are one file each but four
    parts, which the file-count rule missed.
    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
2026-09-06 Make the hand-seated assembly reproducible from a placement dump
    The cleaned model lives in an untracked blend, so every joint, pulley and
    gearbox seating done in the live session would be lost with it. The JSON
    holds each part's world matrix and apply_placements.py rebuilds the
    assembly from the raw STLs; verified to reproduce all 68 placed parts.
    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
2026-09-06 Complete the displayed assembly and keep the author's sample joint for reference
    Every printable STL is now placed, including the tensioner arms and the
    foot and finger instances the file-count rule missed, and the rebuild
    script reproduces all 80 objects. The quartit folder is the free sample
    joint the founder test-printed; it is the axis-2 gearbox under other
    names, kept with its print projects as orientation reference.
    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
2026-09-06 Split the body plates with a half-lap so they fit the P2S bed
    No straight cut between z 256 and 388 misses a pocket, so a 40 mm lap
    from z 258 to 298 crosses them instead and lets the existing bolt pockets
    clamp the seam. The four pieces are watertight; the cleanup also closes
    the nine bad edges the original plate 1 STL shipped with.
    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
2026-09-08 Break the assembly into exploded per-folder models with inferred bearings
    The founder is finishing prints and assembling with real bearings, so one
    master file plus a blown-out model per print folder shows assembly order
    better than the single assembly did. Bearing seats are not in the STLs;
    they are inferred from bore diameters against the PDF hardware lists and
    recorded in bearings.json with located/not-located notes. Fixing the axis-2
    disk caps exposed that the Fusion export left the disks off their shaft
    eccentrics, so they are re-seated onto the eccentrics with the pocket
    pattern on the rod angles, and the cap prints once per disk.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
2026-09-08 Record the frozen J_GPIO1 placement and default the daughterboard to beside-the-carrier
    The Chopaka session froze the header vertical along the carrier's top edge;
    the carrier's enclosure pod has a tight ceiling, so stacking on the header
    now waits on a measured ceiling instead of being an open design choice.
    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
2026-09-09 Keep the author's cybot_support URDF package for reference
    The file called cybot.urdf turned out to be an ABB IRB1600 placeholder with
    cylinder links, so the README records what carries over (axis order, joint
    limits as placeholders) and the real joint offsets measured from the
    assembled model for the Cybot URDF that the firmware kinematics will need.
    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
2026-09-09 Snapshot the author's three public repositories for reference
    The arm's real firmware was never published, so these are all the upstream
    code there is; keeping them locally records that fact and the six-axis
    X/Y/Z/E0/E1/E2 command convention before the project designs its own.
    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
2026-09-09 Keep frames and drawings from the author's videos and Hackaday page
    The published repositories hold no assembly knowledge, so the only build
    references are visual: the Hackaday section drawings and frames from all 23
    CyBoT videos. Frames at 5 s spacing with contact sheets are small enough to
    track; the 1080p videos are gitignored and re-downloadable.
    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
2026-09-09 Set the print and assembly order: 1:20, then both 1:11 units and wrist, then 1:23, then base
    One standing document for what to print next and what hardware to order per
    phase, so the printer downtime is used to queue the 1:11 and 1:23 orders.
    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
2026-09-09 Add the granular 1:20 finishing checklist to the build plan
    Inventory, hardware and a seven-step assembly order so the joint can be
    finished from the checklist while the printer is down.
    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
2026-09-11 Correct the joint ratios and record what the axis-2 assembly taught
    Axis 2 is the 1:23 (12 ring pins) and axis 3 the 1:20 (14), the reverse of
    the earlier labels. The cam pieces lock with three M4 rods that double as
    pulley studs, the six output rods float in the disk bearings, and the M6x70
    bolts are clamps; the joint is mostly built and the cycloidal drive proven.
    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
2026-09-12 Record the motor purchase and set the axis-4 exploded order from the bench
    Four 17HS8401B NEMA17s and one SERVO42C kit are bought; the 42C is UART only,
    so it serves as the rear-stub/magnet template and the CAN bench still waits on
    SERVO42D CAN MB boards. The axis-4 exploded model now follows the order the
    user laid out by hand, with a second diskCap and housingNema turned round;
    explode_group.py takes an explicit order and flip list per group so later
    folders can be corrected the same way once printed.
    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
2026-09-12 Drop the MKS smart-steppers for a PakaNode driver daughterboard
    At about $70 per axis the MKS CAN units cost more than a custom board with
    seven TMC5160-class drivers and MT6701 output encoders, so the drivers move
    to a daughterboard designed in the Chopaka session. Without a board behind
    the motor the 61 mm shoulder and elbow pockets take 56 mm NEMA23s, so two
    23HS22-2804S are bought. The electronics spec keeps the CAN design until the
    board's interface contract is published.
    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
2026-09-12 Note Chopaka's D-087 decisions on the driver daughterboard
    Chopaka owns the board as their PakaNode V2 valve-control base; the settled
    points (MT6701, external-MOSFET drivers for the 2.8 A axes, our pin plan,
    24 V entry with a local buck to J2) are recorded so the build plan matches
    what the Cybot spec will be rewritten against.
    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
2026-09-12 Add the Octopus Pro interim bench path
    The Chopaka daughterboard is a spec cycle away, so the arm gets moving on an
    Octopus Pro under Marlin with the Heltec as host over its GNSS port and the
    carrier's QWIIC jack, which needs no Rev E header and leaves the Heltec-side
    planner, kinematics and encoder loop unchanged when the daughterboard lands.
    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
2026-09-13 Record the axis-4 bearing seats found on the bench
    Fitting the parts settled what the export left open: the two 6812s ride the
    OPH bosses in the housing pockets, the fourth 6705 sits inside the short
    OPH, and the elbow holder's side pockets take a 6804 pair on the elbow
    axis. The exploded axis4 model now shows all eight.
    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
2026-09-13 List the bench-verified 1:11 gearbox hardware in the parts list
    The print list had no hardware counts for the axis-4 folder; now that the
    first unit is fitted, the per-gearbox bearing and bushing counts are
    recorded next to the prints so the second unit and the wrist order can be
    checked against them.
    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
2026-09-14 Snapshot the Yale OpenHand Model O and Model T files
    The gripper direction is a 2+1 underactuated hand closed by one tendon, so
    the Model O palm and finger layout, the Model T pulley-tree differential
    and the finger moulds are kept locally with their CC BY-NC licence and the
    papers that explain them, before any Cybot adaptation starts.
    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
2026-09-14 Specify shore and battery power for the Octopus bench
    The bench starts on a 24 V Mean Well supply with the e-stop breaking only
    the driver rail, so a stop keeps the MCU and node alive. A single DeWalt
    20 V pack is recorded as the mobile option, with the disconnect and fusing
    it needs and why 36 V and 60 V are ruled out by the driver limits.
    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
2026-09-14 Start the bench on a 19.5 V laptop brick
    It runs the Octopus at the same operating point as the planned DeWalt 20 V
    pack, so the low-voltage case is proven on shore power first; the 24 V
    Mean Well becomes the upgrade rather than the default.
    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
2026-09-14 Configure Marlin as a six-axis arm controller for the Octopus Pro
    The bench runs the arm from an Octopus Pro V1.1 under Marlin until the
    Chopaka daughterboard exists. Marlin is pinned and cloned at build time,
    never committed; every change from stock is one exact line edit in
    configure.py so an upstream update fails loudly instead of building a
    printer. Axes are in degrees with the joint ratios as steps per degree.
    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
2026-09-14 Add repaired meshes for the wrist holders and split body plates
    The exports of axis5-holder, axis5-holder2 and the two split plates failed
    slicing on non-manifold edges and inverted normals, so the repaired copies
    are kept beside the originals and named as the files to print. Three
    repairs are within 0.03 mm of the originals; axis5-holder2 lost an
    overlapping internal shell, so its bearing seats get checked on the print.
    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
2026-09-15 Add a 28BYJ-48 coil-sequence test for the ESP32 DevKit
    A four-GPIO half-step driver for the ULN2003 board that came with the
    motor, to prove a board and its toolchain while the TMC drivers ship. Pins
    and speed are Kconfig so the same project rebuilds for the Heltec's GNSS
    port pins on esp32s3. Not part of the arm's motion path.
    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
2026-09-16 Record the received motors, their coil pairs and the 10 mm rear stub
    All six drive motors are in hand and ohmed, so the build plan carries the
    phase pairings for wiring and drops the stale SERVO42D purchase line. The
    rear-stub gate no longer says to cut the stubs: whether a magnet goes
    there is the daughterboard's decision.
    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
2026-09-16 Model the axis-5 gearbox inside the wrist and keep split shells mated
    The wrist folder holds the axis-5 1:11's housing halves, output plate and
    pulley, but its internals are axis-4 files placed only once, so the axis56
    exploded view showed an empty gearbox and the print plan over-counted the
    second 5-axis4 set. Instances of the seven internals now sit on the axis-5
    axis with their 6705s, and the docs list the second set as internals only.
    A "together" key lets the explode script lay out split shells as one unit
    so the yoke halves stop being pushed apart.
    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
2026-09-21 Add a printed tray for the Octopus Pro bench driver
    The board needs somewhere to live while it drives the arm in Marlin.
    Footprint, hole grid and right-edge connector positions come from BTT's
    SIZE.pdf and STEP model, so the lip cutouts match the real board.
2026-09-21 Keep TMC_DEBUG off so M122 survives empty driver sockets
    The debug table reads every register of every driver without refreshing
    the watchdog. With four TMC2209 sockets still empty, the UART timeouts
    push it past 4 s and the board resets mid-report, which looked like a
    hardware fault on the bench. The connection test is enough for now.
2026-09-22 Record the pulley ratios and the first Octopus bench run
    The belt ratios were inferred from tooth counts in the printed pulley
    meshes so the steps-per-degree have a source, and the 15 Sep parts
    arrivals and orders are logged against the phase lists. The bench log
    captures what it took to get every driver socket talking (UART jumper
    per TMC2209 socket) so the next session starts from six proven motors.
2026-09-22 Spec the gripper tactile sensing on the wrist I2C chain
    The rigid linkage gripper has no compliance, so a close needs a force
    signal to stop on, and the carrier gives Cybot no ADC pin, so the pads
    read through an ADS1115 at the wrist on the QWIIC chain the encoders
    already use. Keeps the Octopus and the PakaNode daughterboard untouched.
2026-09-22 Spec a three-finger hand to replace the Cults gripper
    The rigid four-finger gripper cannot conform to an object, so it gets
    replaced by an underactuated pair on a self-locking worm plus a
    direct-driven thumb, both on Octopus sockets that are already free. The
    wrist adapter's 55 mm motor tube takes the NEMA11, so the wrist joints
    stay as built, and hollow spring pins carry the sensor wires through the
    knuckles on the axis of rotation so they twist instead of flex.
2026-09-22 Plan phase 1 of the hand: pin coupon and one finger
    The knuckle is the part of the hand most likely to fail in print, so
    phase 1 proves it alone: a coupon finds the bore that grips a spring pin
    in PLA, then one finger on a bench fixture must curl, return and carry a
    wire through its pins for 100 cycles. The geometry scripts double as
    tests: they measure the bores they cut and sweep the joints for
    interference so the printed stops are verified before filament is spent.
    The spec is amended to the one-piece TPU skin (return spring, tip wrap and
    sensor pad in one part) and the snap-on proximal grip pad agreed today.
2026-09-23 Add the knuckle geometry library and pin-fit coupons for the hand
    A spring pin's grip in PLA depends on the printer, and one bore size
    sets every knuckle in the hand, so a coupon settles it first. The
    generator measures the bores it cuts so the file can never drift from
    its own numbers.
2026-09-23 Generate the phase 1 finger, fixture and one-piece skin
    The two printed stops are the only thing keeping the pinch load off the
    pin bores and the thumb's gears, so the check script sweeps the joints
    and fails the build if the stops engage early or not at all.
2026-09-23 Switch the pair drive to a worm-gear NEMA11 unit
    The 28H51-WG20 puts the 20:1 worm in a sealed metal gearbox, which removes
    the printed-worm wear and mesh-alignment risks, and its 51 mm motor doubles
    the tendon margin over the bare NEMA11. Palm layout, parts list and BOM
    follow.
2026-09-23 Spec a standalone spider base for axis 1 with the motor flipped
    The Cults stepper holder cannot be used with the 48 mm 17HS8401B: measured
    from the STLs, its pulley sits 11 mm above the rotating base's belt band on
    a common plane and the motor hangs 24 mm below it. Mounting the motor above
    a bracket plate puts the pulley on the band with nothing below the base
    plane, so the ring and arms are sized for stiffness alone.
2026-09-24 Record the spring pin bores that fit in PLA
    The coupons showed a 4 mm ISO 8752 pin needs a 3.90 cheek bore to press
    and hold 5 kg on the P2S, and the first printed knuckles had to be drilled
    to 11/64 in (4.37 mm) in the tongue to move freely, so both bores come
    from the params file and the finger is generated with them.
2026-09-24 Route the sensor wires through enclosed channels with a tip entry
    An open groove on the proximal could not be fed and left the wire exposed,
    and the box cavity at each knuckle would have pinched the wire against the
    pin at full flexion. One straight tunnel per part, entered at a solder
    pocket in the fingertip, lets the pair be pushed through before the pins
    go in, and a quarter-ring cavity keeps the slot in free space through the
    whole travel.
2026-09-24 Generate the axis-1 spider base
    Ring, tapered truss arms, the motor arm with its flipped NEMA17 bracket and
    the TPU pad plug, each with assertion self-tests. The mortise became blind
    during implementation because radial bolts need a back wall to bear on.
2026-09-24 Run the tendon and sensor wire straight through the fingers on two-pin knuckles
    The tendon was being threaded along the sensor wire's zig-zag to the cheek
    face and back, and that path adds friction the tendon cannot afford. Each
    knuckle is now two 4 x 10 spring pins pressed flush from either cheek with a
    3 mm gap between their ends, so the sensor pair can cross on the axis line and
    the finger carries two straight enclosed channels: the pair on the axis line
    and the tendon 4 mm below it. With the finger straight both are one line from
    the fixture to the tip, so line and pair are pushed in after the pins.
    The tendon is not enclosed at the knuckle: a hole through the tongue would
    swing its mou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
2026-09-24 Tie the spider arm tenon to the arm with a root plate
    The first printed arm came off the bed with its tenon loose: the tenon was
    unioned to the arm's root face, where the section is only the 2 mm skin and
    the two rails at the edges, so the union touched nothing and the STL held two
    clean shells. The manifold check cannot see that, so every base part now
    asserts one connected shell, and the arm starts with a 6 mm end plate that
    the tenon grows out of, with the rails, skin and web starting 1 mm inside it
    so no face coincides with the plate's.
2026-09-24 Turn each knuckle on a 2 mm dowel inside the spring pin
    The straight-channel finger pulls cleanly but its knuckles, PLA turning on
    the 4 mm spring pins, need finesse and are inconsistent from joint to joint.
    Each knuckle now has a stainless dowel pressed into the tongue's core with a
    4 x 8 spring pin sliding over it, so the joint turns steel on steel and the
    tongue bore becomes a clearance. The cheek pins have to be 4 x 8: a 4 x 10
    reaches the wire gap and leaves no plastic to hold the dowel.
    Also drops the fixture's tendon exit 1 mm and flares it, so the span to the
    proximal's mouth slopes less as the finger curls and drags less on the exit.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
2026-09-24 Spec and plan the palm front plate that carries both pair fingers
    The palm becomes three flat prints instead of two halves split on the spool
    axis, so every pin bore prints vertical: a front plate with both forks on
    45 mm centres, a rear shell for the drive, and a thumb cradle. The plate
    carries the shell's bolt pattern from the start so a bench foot can bolt to
    it and the pair test proves that interface before the shell exists.
2026-09-24 Let a fork be placed off the centre plane
    The palm plate needs two forks on 45 mm centres from the same call the
    fixture uses, so fork, bore_cheeks and the line-of-sight check take a z
    offset; the defaults leave the finger and fixture geometry unchanged.
2026-09-24 Generate the palm front plate with both pair forks
    The plate carries the rear shell's bolt pattern now, before the shell
    exists, so the bench foot bolts to it and the pair test proves that
    interface. Both forks come from the fixture's library call, so a finger that
    fits the fixture fits the plate.
2026-09-24 Log the dowel knuckle test
    One 18 mm dowel through a drilled tongue, spring pins over its ends from
    each cheek: smooth joints. Recorded so the model follows the bench.
2026-09-28 Record the axis 1 belt as a 621-3M
    The rotating base's band measures 175 teeth at 3 mm pitch in the Cults STL
    and the spider motor arm puts the motor axis at 139 mm, which computes to
    620 mm of belt. The PDF's 648 was never bought and the 477-3M in hand is a
    body belt that cannot reach round the ring, so a 621-3M 10 mm was ordered.
2026-10-23 Set the base to 58.93 steps per degree
    The printed band has 179 teeth, not the 175 read from the Cults STL: one
    commanded base turn at 175/27 landed 4 teeth short, and 179/27 held top
    dead centre over five turns and a three-minute run at 1200 mA. The extra
    teeth also explain why the 621 belt was tight with the motor at 139 mm.
    Claude-Session: https://claude.ai/code/session_01ATjyEtxiGxiuku12Y3YGJx
2026-10-23 Turn OPH2's spigot down so it fits the axis 4 tube
    The Cults OPH2 boss is O58 but the tube's socket is O56, so as exported
    the two parts cannot go together. The script trims only the boss, to
    O55.4, keeping the radial M5 holes, the keyed bore and the shoulder. The
    printed part slides into the tube and bolts up through the radial holes.
    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
2026-10-23 Log the axis 2 belt run
    The first belt-driven run of the shoulder found the belt too slack and ran
    clean once tensioned. It also showed the firmware's Y feedrate cap is too
    low for bench tests, which the config should fix once the joint's speed is
    settled.
    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
2026-10-24 Set the forearm roll to 782.22 steps per degree
    A 20T motor pulley went on in place of the planned 40T. At the computed
    44:1 a commanded full turn came out as a half, and 88:1 then held a mark
    over three full turns, so one of the belt and reducer stages is double
    what the table assumed.
    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
2026-10-24 Raise the shoulder driver to 2500 mA
    With the whole arm on it, 2000 mA could not turn the axis 2 cycloid;
    2500 mA turned it smoothly through 60 degrees and back.
    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
2026-10-25 Spec a compact cycloid POC to cut the head's weight
    The V1 head carries about 2 kg, and axis 5's 1:11 drive is Ø100 because it is
    built around two 6812s. A 1:20 cycloid on 6804s with a one-piece eccentric
    shaft is the first step toward a head sized for pancake motors.
    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
2026-10-25 Plan the compact cycloid POC build
    Working out the geometry showed three spec slips (bushing bore 6 not 8, two
    disk files with the half-lobe phase, 20 mm output pins); they are corrected
    here so the plan argues from a spec that adds up.
    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
2026-10-25 Add the compact cycloid's lobe and meshing math with tests
    Checking the lobe profile, disk phasing and belt geometry in plain Python lets
    pytest catch an undercut or a mis-phased disk before anything is printed. The
    belt test showed a ±6 mm belt needs ±3.01 mm of motor travel, so the bench
    slot widens to ±3.5.
    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
2026-10-25 Add a fit coupon to pick the compact cycloid's press fits
    The reducer has nine press fits in printed PLA; one coupon print settles all of
    them before the full parts are printed. The coupon measures its holes with its
    own offset-ray probe because hand_lib's lands on polygon vertices and misreads.
    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
2026-10-25 Generate the compact cycloid's disks and one-piece eccentric
    V1's four-piece input shaft is where tolerance slop builds up first, so both
    journals come off one print; the disks are phased half a lobe so either can
    go on the opposite journal with the same face forward.
    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
2026-10-25 Split the compact cycloid's housing so the carriers can go in
    The Ø44 carrier plates can't pass a Ø32 6804 seat, so a one-piece housing
    can't be assembled; each half now takes its 6804 from the inside.
    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
2026-10-25 Add the cycloid bench parts and check the assembly for collisions
    The POC has to be bench-tested on its own before it goes near a head, and
    a collision found in the model costs less than one found after a print.
    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
2026-10-25 Size the compact cycloid for uncompressed spring pins and free-running bearings
    The whole-branch review found the reducer would bind before it could be
    measured: spring pins run oversize in the bushings and past the slip bores,
    the input was clamped to the output through the 625 inner rings, the pins
    set the carrier spacing, the collar rode the 6800 seals and the test arm
    hit the bolt heads.
    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
2026-10-25 Spec the POC's input rod as filed stainless
    5 mm D-shaft is hard to find and hex won't enter the 625s; the input
    carries about 0.05 N·m, so a plain stainless rod with filed flats is enough.
    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
2026-10-25 Spec the POC's bushings as the 6 x 8 x 5 sintered bronze bought
    They were much cheaper than 6 x 8 x 6 brass; bore and OD match, so only the
    fitting changes: flush with the dot face, and a pin-push check because a
    pressed sintered bushing closes up at the bore.
    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
2026-10-26 Add an exploded view of the cycloid POC bench unit
    Shows how the printed parts and the bought hardware go together, in assembly
    order, before the parts are printed and fitted.
    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
2026-10-26 Record the printed 3M pulleys and axis 3's measured belt
    The bought GT2 30T skipped on axis 2's 3M belt, so the body joints now run
    printed 3M pulleys. Axis 3's 477 belt came up 56 mm long at the measured
    100 mm centre distance, more than a tensioner can take up, so a 420-3M-9
    is on order.
    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
2026-10-26 Add the printed HTD 3M pulley generator
    The bought GT2 30T skipped on axis 2's 3M belt, and the spider base needed a
    27T to fit the 621 belt, so the body joints' motor pulleys are printed to the
    3M profile instead.
    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
2026-10-26 Add the printed 3M pulleys as proven parts
    The printed 30T with its heat-set insert ran on axis 2, so it stays as the
    test part for the body joints: try it first, and swap in a machined
    aluminium pulley if it falls short.
    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
2026-10-26 Clock axis 2's holder2 rod holes and open the nut recesses
    As exported, the rod holes sat at 3 and 9 o'clock and an M4 nut only just
    entered its recess, with no room for a socket. Turning the pattern 30 deg puts
    one hole at 12 o'clock, and the wider recess lets a socket reach the nut.
    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
2026-10-26 Estimate V2 motor sizes for a lighter arm on the compact cycloid
    A lighter head cuts the load on every joint below it, so smaller motors may
    do: pancakes at the wrist, a 48 mm NEMA17 at the elbow and a NEMA23 kept at
    the shoulder. Recorded as theory until the POC bench run measures friction
    and stall.
    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
2026-10-26 Plan the V2 forearm roll on 6810s in place of the 6812s
    The 6812zz pair is the heaviest bearing set in the forearm. The 6810s already
    in hand are half the weight and still leave a hollow axis for the wrist and
    gripper cables.
    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
2026-10-26 Note the spare 6705s as V2 wrist main bearings
    They share the 6804's 32 mm OD, so they drop into the proven seat at less
    than half the weight and a shorter housing.
    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
2026-10-26 Confirm the 1:11 wrist ratios and narrow axis 4's doubled count
    The 1:11s skip every other ring position, and both 80T pulleys count true,
    so the 88:1 axis 4 measured is a motor or driver factor of 2, not gearing.
    That factor would also throw off the POC's steps per degree if it is a
    microstep setting.
    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
2026-10-26 Plan V2 axis 6 as a hollow cycloid with the gripper driven through it
    A rod through the roll axis keeps the gripper motor in the head, so no wires
    cross the roll and its mass sits back towards the wrist pitch axis. The cost
    is a roll-to-grip coupling, which the host can cancel.
    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
2026-10-27 Record which Octopus slot drives which joint
    The driver mix (2 x TMC5160, 5 x TMC2209) and the empty MOTOR3 were only
    in conversation; the map keeps the slot wiring and the deferred M122
    UART check findable when the remaining motors go on.
    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
2026-10-27 Note extrusion rails as a V2 body frame option
    Aluminium rails were floated to lighten the body, but the numbers show
    they don't save weight and the body loads only axis 1. Recording them
    for what they do offer: stiffness, belt adjustment and cheaper
    iteration when the cycloids shrink.
    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
2026-10-27 Mount the motor on the cycloid housing for the head
    The bench is skipped now the POC runs, so the motor needs to ride on the
    cycloid itself: reversed beside the housing to stay compact, slotted for
    belt tension on the 232 already in hand, driving a printed 40T that
    grips the rod's flat through a heat-set insert as the axis 2 pulley does.
    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
2026-10-28 Add a hollow axis 6 cycloid with the gripper rod through it
    The claw motor sits behind axis 6 and drives through the roll, so no
    wires cross it. The same disks and housing take a printed sleeve on
    688s in the old 625 seats, leaving a bore for the Ø5 rod; posts on the
    motor mount carry the claw motor and its coupler on the axis.
    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
2026-10-28 Sort the cycloid models into one folder per variant
    With a hollow variant beside the working POC, and more to come, a flat
    folder mixed print sets with test parts. Each variant folder is now a
    complete print set, and the generators write straight into them.
    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
2026-10-28 Hold the motor between rails on the mount's motor face
    The printed mount's ribs sat on the belt side, 39 mm apart, and the
    pancake wanted to sit between them. Rails 42.7 apart on the motor face
    locate the 42.3 square and guide it along the tension slots. On the
    hollow mount the posts move onto the MOTOR7 bracket so each part still
    has a flat face to print on.
    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
2026-10-29 Add a flatless eccentric for a plain press-fit rod
    The printed bore grips the Ø5 dowel tightly enough in the vise that the
    flat isn't needed, which saves grinding one into each rod.
    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
2026-10-29 Shorten the eccentric ends clear of the 625 shields
    The full-length ends rode on the 625s' shield lips and made the POC
    drag; trimming them by hand freed it. The press fit on the rod now
    locates the eccentric, so the ends no longer need to bear on the 625s.
    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
2026-11-04 Run the front ring-pin holes 2 mm past the pin ends
    The slip holes in the front half ended exactly at the pin ends, so the
    pins bottomed before the halves closed.
    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
2026-11-04 Give the disks a lip for the 6800 to seat against
    The 6800s kept walking off their seats as the disks went into the tight
    housing; a lip on the outer ring sets their depth and keeps them square.
    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
2026-11-04 Keep full-length eccentrics alongside the short ones
    The short eccentric with a washer is the working setup, but a full-length
    print trimmed by hand is still worth having while the fit is being
    settled build to build.
    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
2026-11-05 Flip print-side-up parts exactly so the mating face stays flat
    The front housing's mating face sliced with a wedge a layer off the rest.
    Flipping through an object rotation left float32 sin(pi) noise that tilted
    the face by nanometres, and it sits where a slicing plane can fall. Negating
    y and z on the mesh keeps it flat, and the wedge is gone in Bambu Studio.
    The hollow front housing also picks up its overdue deeper slip holes here.
2026-11-05 Carry the compact cycloid's fixes over to the hollow set
    The hollow was about to be printed with the disks and eccentric that the
    compact builds had already outgrown. It now has the 6800 seat lip, and a
    short eccentric whose journals stay clear of the 688 seals beside the
    full-length one, so the fit can be settled as it was on the compact.
